tar7operator/Pinaka/10.FEA/Rocket/Thrust Plate/Final Test/fosAngle.png

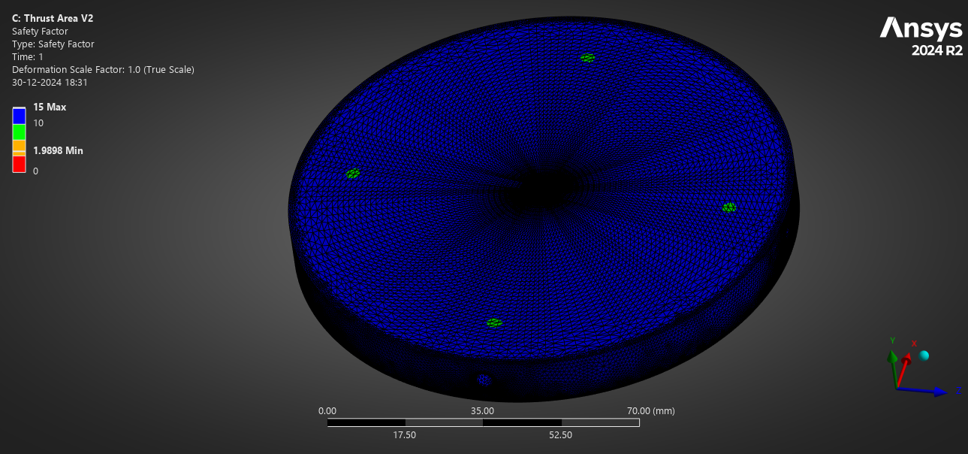
10.FEA/Rocket/Thrust Plate/Final Test/fosAngle.png
