tar7operator/Pinaka/10.FEA/Rocket/Thrust Plate/Final Test/strainHole.png

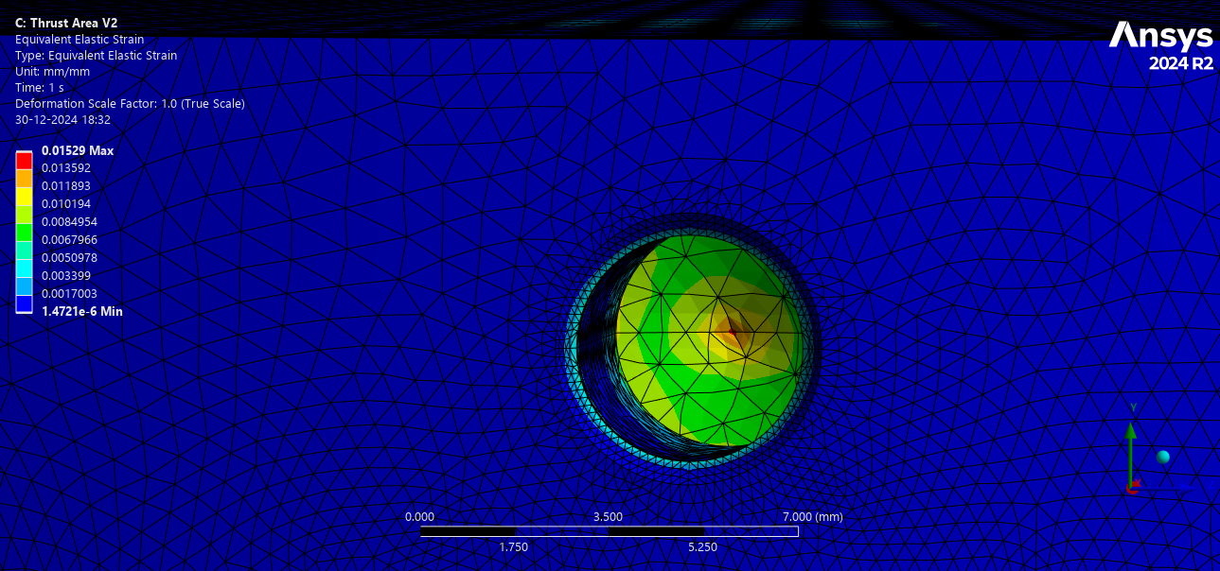
10.FEA/Rocket/Thrust Plate/Final Test/strainHole.png
