tar7operator/Pinaka/9. Records/8. PDR Report/Pinaka PPT.pdf

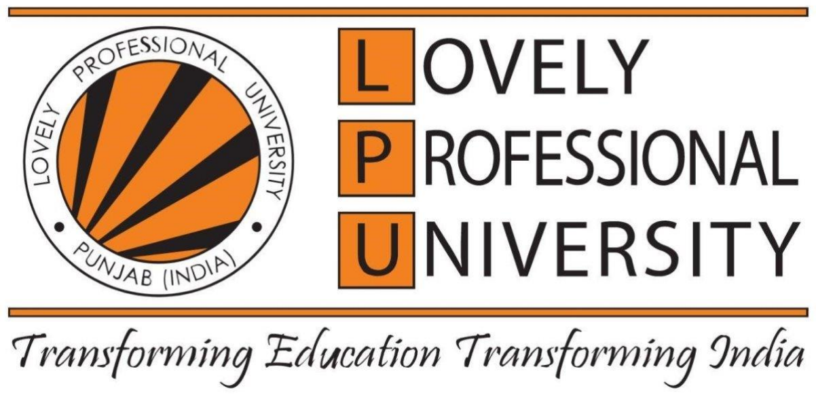
[picture p46: figure]

CANSAT India Students Competition by ASI: {Team Id}

# MODEL ROCKETRY 2024-25

# Team - Pinaka

# 1. Presentation Outline

Sr. No. | Content | Slide Number
1 | Mission summary
2 | Team Structure
3 | Design Overview
5 | Mechanical Subsystems
| Avionics Systems • Sensors Trade Off • Onboard avionics overview • Ground Station Electronics • Power subsystem design
6 | Descent Control
8 | Flight Software Overview
9 | Base Station and GUI

# 1. Mission Summary

# Mission Objectives

- To design a rocket that can deploy the payload at 1000m +/- 100m altitude.
- To design a rocket that is less than 180cm in height.
- To design a rocket with a payload that can carry a CAN-Sized satellite of Diameter 0.15m and length 0.40m, with a weight of 1Kg +/-0.05Kg.
- To design a rocket that can descent and land safely after the payload deployment.

# 2. Team Structure

Name | Discipline | Role | Academic Year
- Mandeep Singh | Assistant Professor and Assistant Dean | Faculty Advisor | -
- Ruhul Amin Choudhury | Innovation Officer | Mentor | -
- Pranav MP | Aerospace Engineering | Aerodynamics | 3 rd Year
- Vijay Mishra | Aerospace Engineering | Design | rd Year 3
- Shalu Yadav | Aerospace Engineering | Aerodynamics | 3 rd Year
- Prajwal Kale | Aerospace Engineering | Motor and Propellant | 3 rd Year
- Ishu Saini | Aerospace Engineering | Motor and Propellant | 3 rd Year
- Bhanu Mahesh | Robotics Engineering | Avionics and Electronics | 4 rd Year
- V Manish | Robotics Engineering | Avionics and Electronics | 4 rd Year
- Nandish Panchal | Mechanical Engineering | Manufacturing | rd Year 3

# 3. Design Overview

# Design specifications :

## - Power Series Nosecone

## - Hinge system payload compartment

## - Transition tube

## - 3 Bulkheads

## - 3 Centering Rings

## - Free form 4 fin design

# 4.(a) Payload Bay

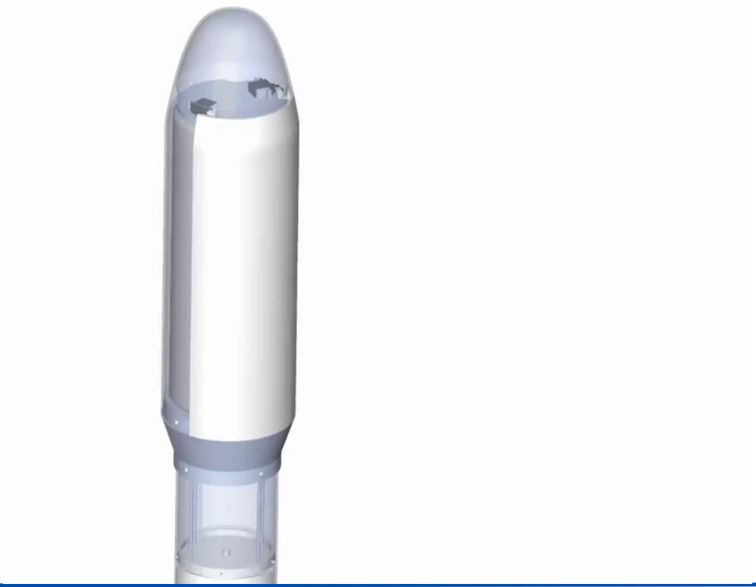
[picture p47: figure]

# Design specifications :

## - Power Series Nosecone

## - Hinge system payload compartment

## - Transition tube

## - 3 Bulkheads

## - 3 Centering Rings

## - Free form 4 fin design

# 4.(a) Parachute Bay

# Design specifications:

## - Power Series Nosecone

## - Hinge system payload compartment

## - Transition tube

## - 3 Bulkheads

## - 3 Centering Rings

## - Free form 4 fin design
