tar7operator/Pinaka/9. Records/8. PDR Report/InSpace Rocketry Equipments List.pdf

Sr No. | Name | Specification | Capacity/ Amount/Services
1 | Test Stand | | 1 nos
2 | Hot Plate | | 1 nos
3 | Propellants Mixer | | 2 nos
4 | Container | Beaker (Glass) | 2 x 1000 ml
5 | | Conical Flask | Max Size available
6 | Safety Equipments | Impervious Gloves | 4 pairs
7 | | Apron | 4 nos
8 | | Safety Goggles | 4 nos
9 | | Masks (filter) | 6 nos
10 | Machining | Lathe Machine
11 | Machining | Milling Machine
12 | 3d Printing

### Equipments List
