tar7operator/Pinaka/7. Standards and Handbooks/Rocketry Standards/ECSS/ECSS-Handbooks_(zip-file_October2023)/Astrium-Example-Joint Design.xls

Sheet: Test Sample
Verification steps in the analysis of bonded joints:
1. Recalculate stress distribution of the test sample (see example below); normally same adhesive tested at RT
2. Determine peak stress at the edge of the sample
3. Calculate stress distribution in the new joint
4. Demonstrate positive margin of safety |  |  | MoS=(Smaxsample/(Smaxjoint*Jult))-1 |  |  |  | Safety factor Jult=1.5 to 2.0
5. Note: test sample needs to be similar or stiffer than the new joint (Kt,mech less-equal than in new joint)
6. Verification of bonded joints under extreme temperatures (outside qualification temperatures of adhesive) needs testing at these temperatures
7. Warning: in case of CFRP the out-of-plane skin strength (similar to 90° strength of UD) can be very and thus failure of the bonding occurs in the first layer due to out-of-plane stresses in the order of the max. shear stresses in the bonding !!!!
Liner-elastic Analysis of Standard Joint under Test Loads; EA9321 acc.to ASTM D 1002
 | E-modulus | thickness | CTE | G-modulus |  | E*T | Ce | R | lambda | Fth | Fth0
Adherend 1 | 70000 | 1.6 | 0 |  |  | 112000 | 56000 | 0.1901785714 | 0.4360946817 | 0 | 8.004301941
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
