tar7operator/Pinaka/9. Records/CDR-Payment-2024-ASI-MODEL-ROCKETRY-047.pdf

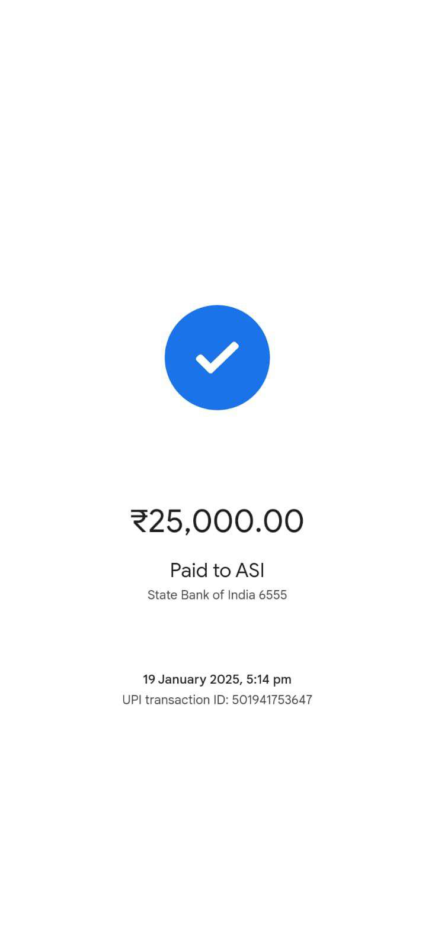
[picture p48: page 1]
