tar7operator/Pinaka/1. CAD PDR -- Do not Edit!/Accesories/mg90s-servo-motor-2.snapshot.6/MG90S Servo Motor.bmp

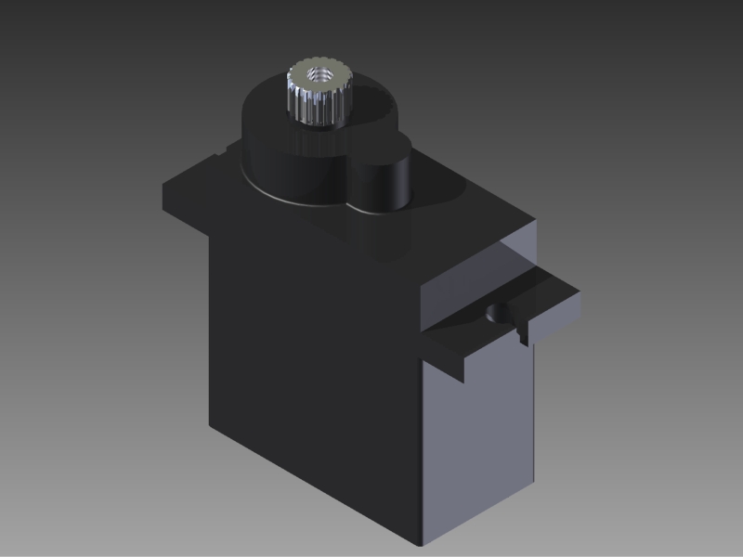
1. CAD PDR -- Do not Edit!/Accesories/mg90s-servo-motor-2.snapshot.6/MG90S Servo Motor.bmp
