tar7operator/Pinaka/1. CAD PDR -- Do not Edit!/Accesories/mg90s-servo-motor-2.snapshot.6/Quadcopter Servo3.jpg

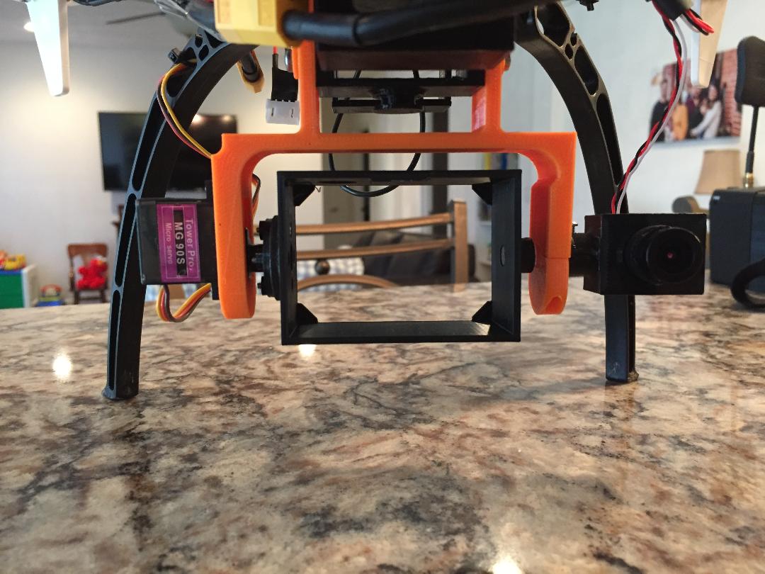
1. CAD PDR -- Do not Edit!/Accesories/mg90s-servo-motor-2.snapshot.6/Quadcopter Servo3.jpg
