tar7operator/Pinaka/1. CAD PDR -- Do not Edit!/Accesories/mg90s-servo-motor-2.snapshot.6/Spline Shaft1.JPG

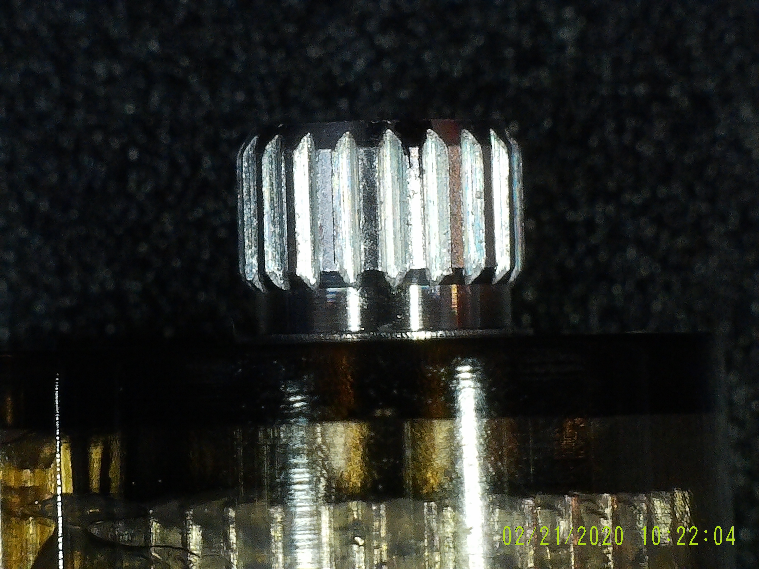
1. CAD PDR -- Do not Edit!/Accesories/mg90s-servo-motor-2.snapshot.6/Spline Shaft1.JPG
