tar7operator/Pinaka/1. CAD PDR -- Do not Edit!/Images/Cansat.png

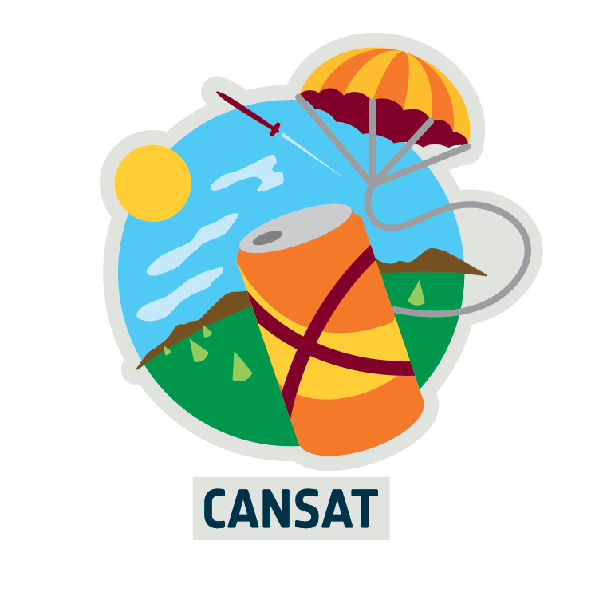
1. CAD PDR -- Do not Edit!/Images/Cansat.png
