tar7operator/Pinaka/3. Motor/Aerotech/Aerotech H148 motor.JPG

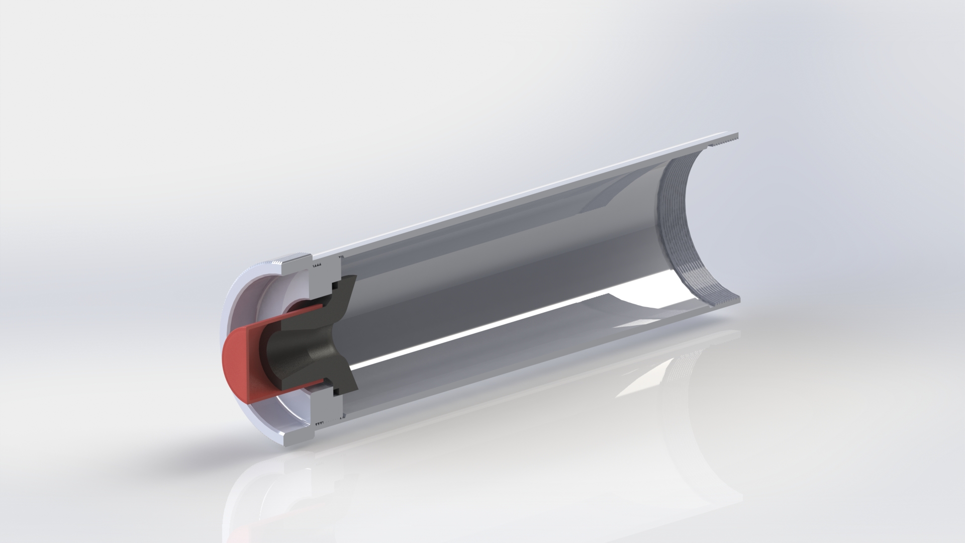
3. Motor/Aerotech/Aerotech H148 motor.JPG
