tar7operator/Pinaka/5. Launch Stand/launch stand.PNG

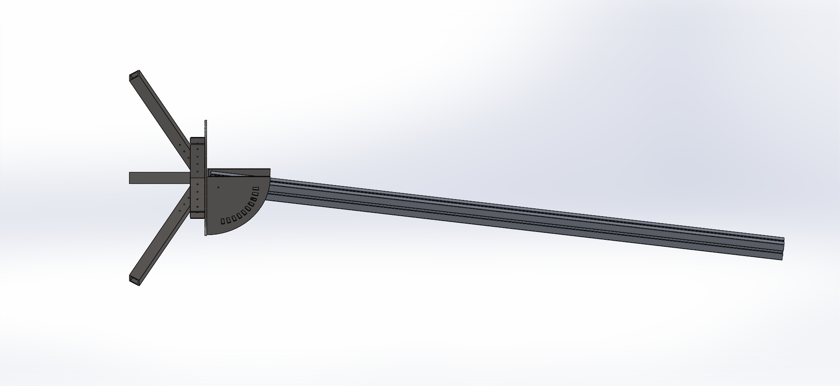
5. Launch Stand/launch stand.PNG
