tar7operator/Pinaka/7. Standards and Handbooks/Rocketry Standards/ECSS/Disciplines of ECSS standards.png

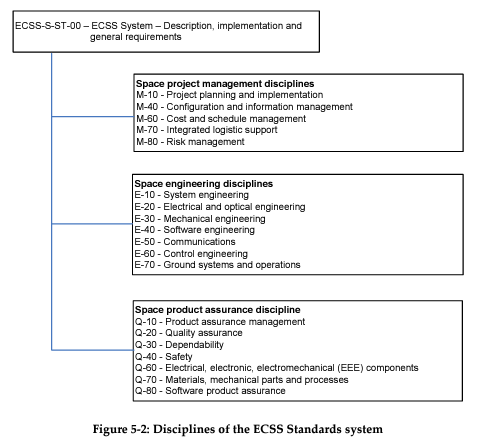
7. Standards and Handbooks/Rocketry Standards/ECSS/Disciplines of ECSS standards.png
