tar7operator/Pinaka/9. Records/8. PDR Report/Pinaka.png

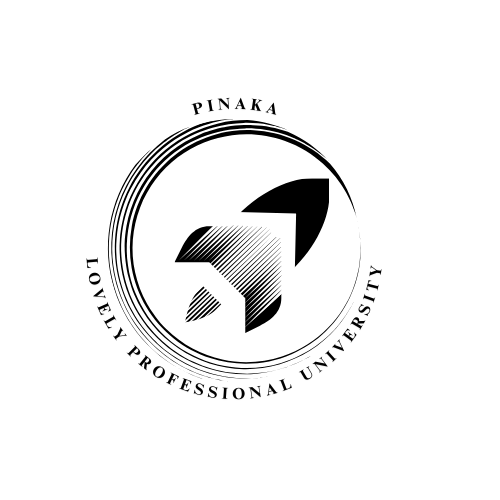
9. Records/8. PDR Report/Pinaka.png
