tar7operator/Pinaka/9. Records/20. CDR/Images/Cross Section.PNG

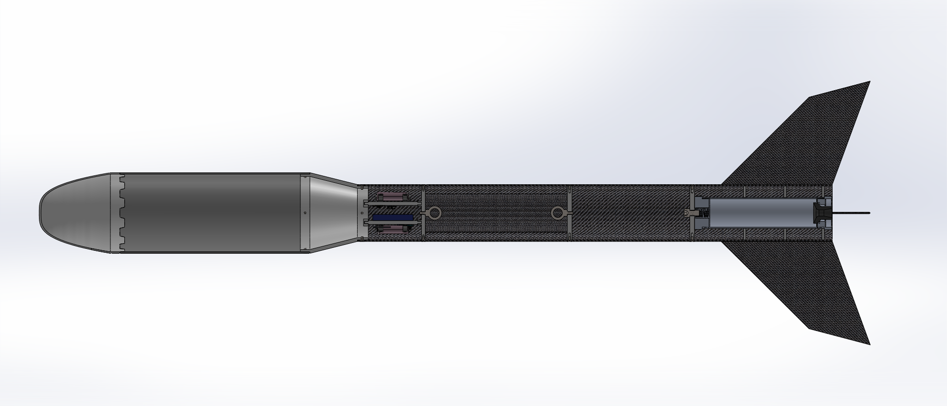
9. Records/20. CDR/Images/Cross Section.PNG
