tar7operator/Pinaka/9. Records/20. CDR/Images/GA_trans.PNG

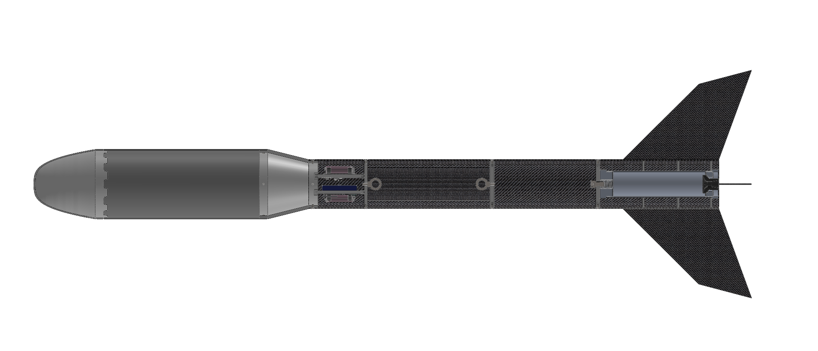
9. Records/20. CDR/Images/GA_trans.PNG
