tar7operator/Pinaka/10.FEA/Cansat/16g acceleration static/CansatMesh.JPG

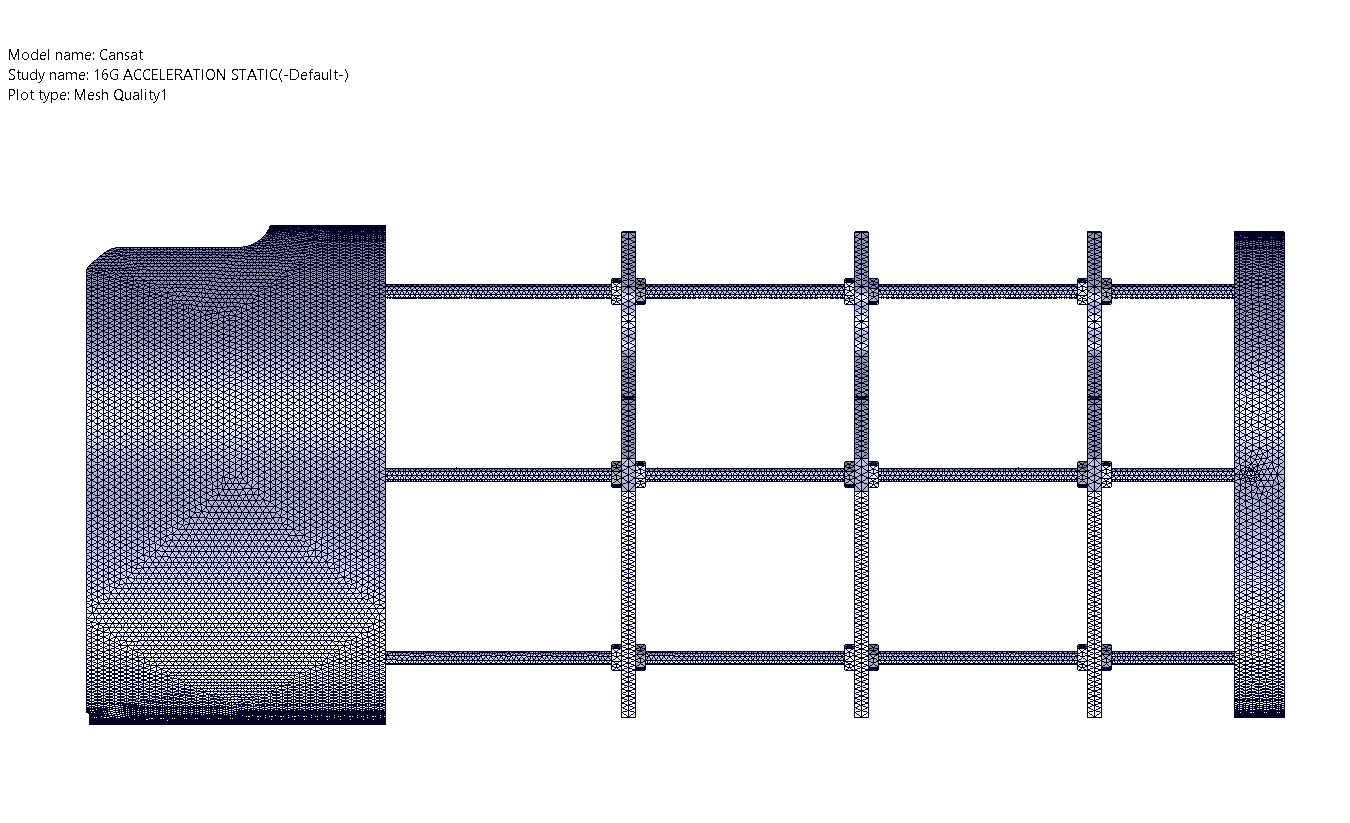
10.FEA/Cansat/16g acceleration static/CansatMesh.JPG
