tar7operator/Pinaka/10.FEA/Cansat/16g acceleration static/front view/Cansat-16G ACCELERATION STATIC-Displacement-Displacement1.jpg

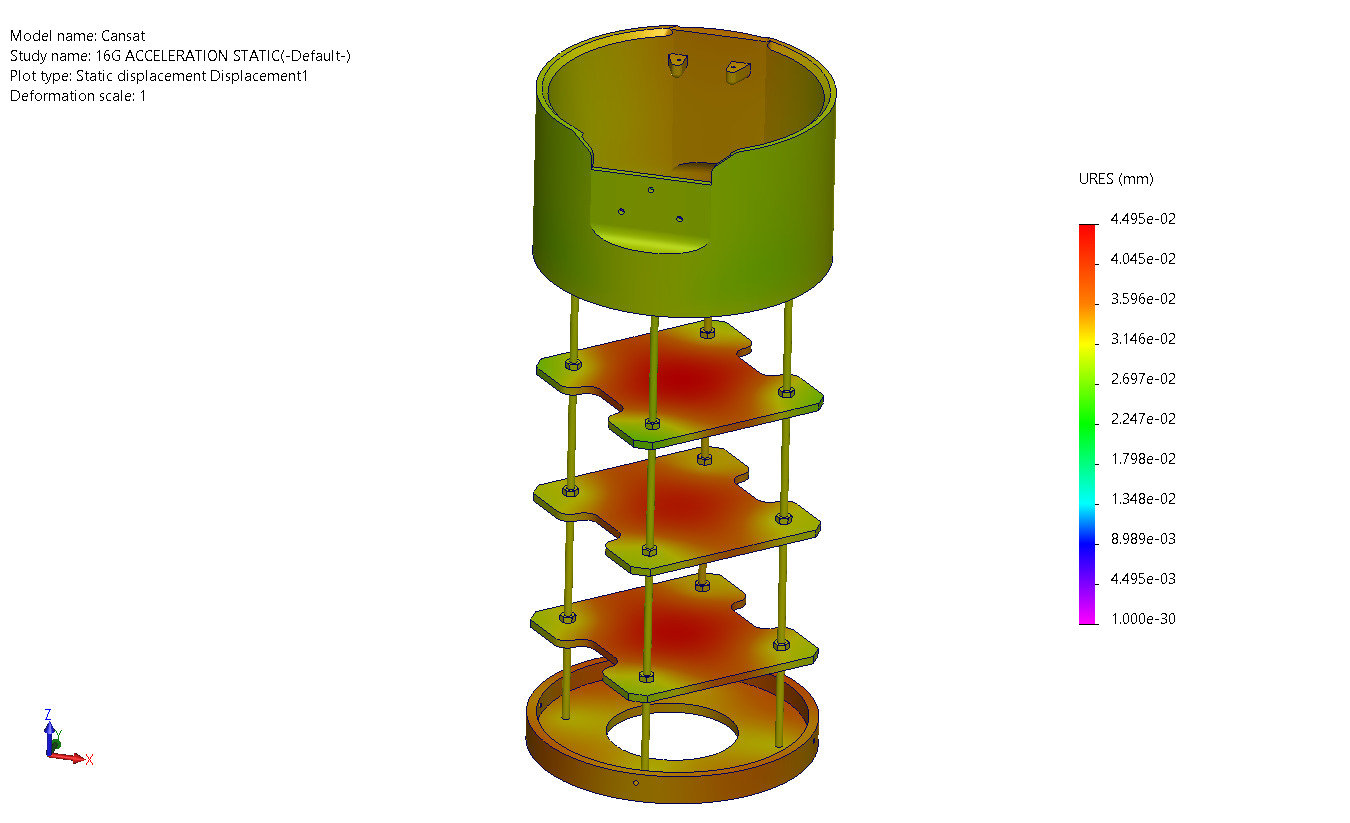
10.FEA/Cansat/16g acceleration static/front view/Cansat-16G ACCELERATION STATIC-Displacement-Displacement1.jpg
