tar7operator/Pinaka/10.FEA/Cansat/16g acceleration static/top/Cansat-16G ACCELERATION STATIC-Stress-Stress1.jpg

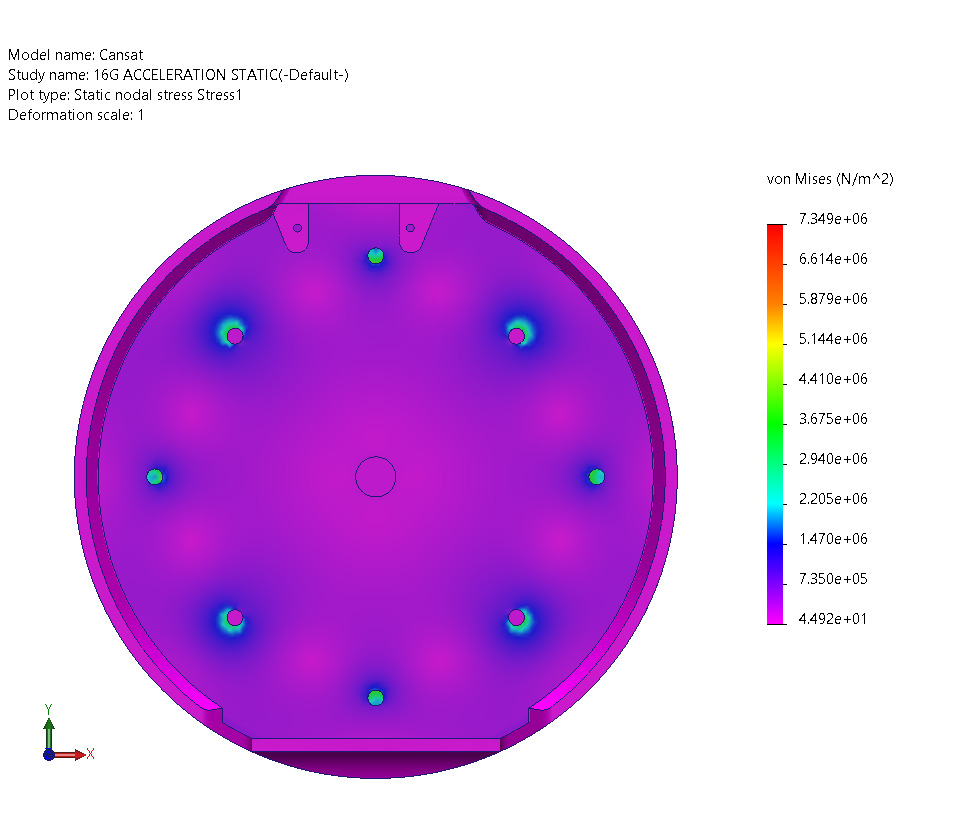
10.FEA/Cansat/16g acceleration static/top/Cansat-16G ACCELERATION STATIC-Stress-Stress1.jpg
