tar7operator/Pinaka/10.FEA/Cansat/Flap 12.5 N force by Drag/ParachuteCap-Flap Stress by Drogue-Displacement-Displacement1.jpg

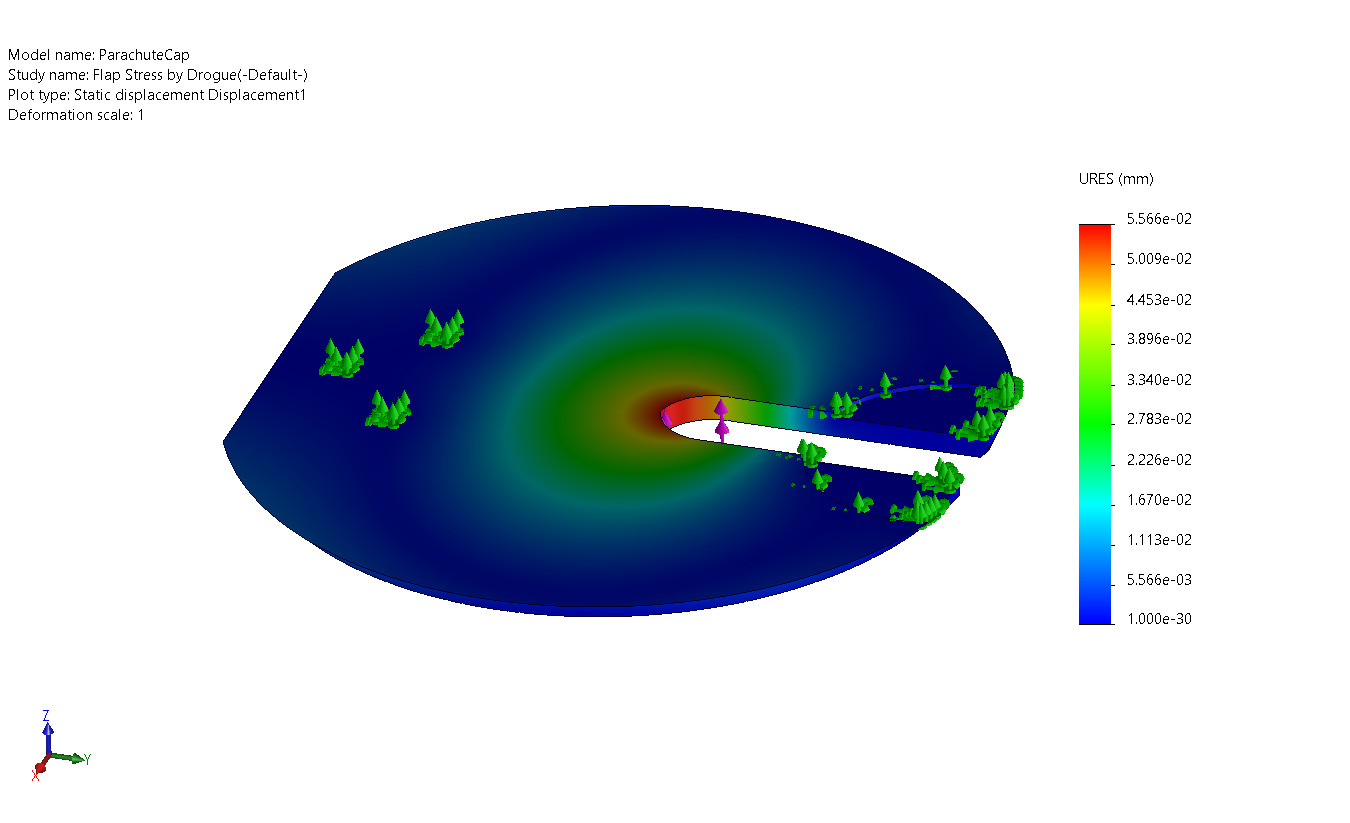
10.FEA/Cansat/Flap 12.5 N force by Drag/ParachuteCap-Flap Stress by Drogue-Displacement-Displacement1.jpg
