tar7operator/Pinaka/10.FEA/Cansat/Flap 12.5 N force by Drag/ParachuteCap-Flap Stress by Drogue-Factor of Safety-Factor of Safety1.jpg

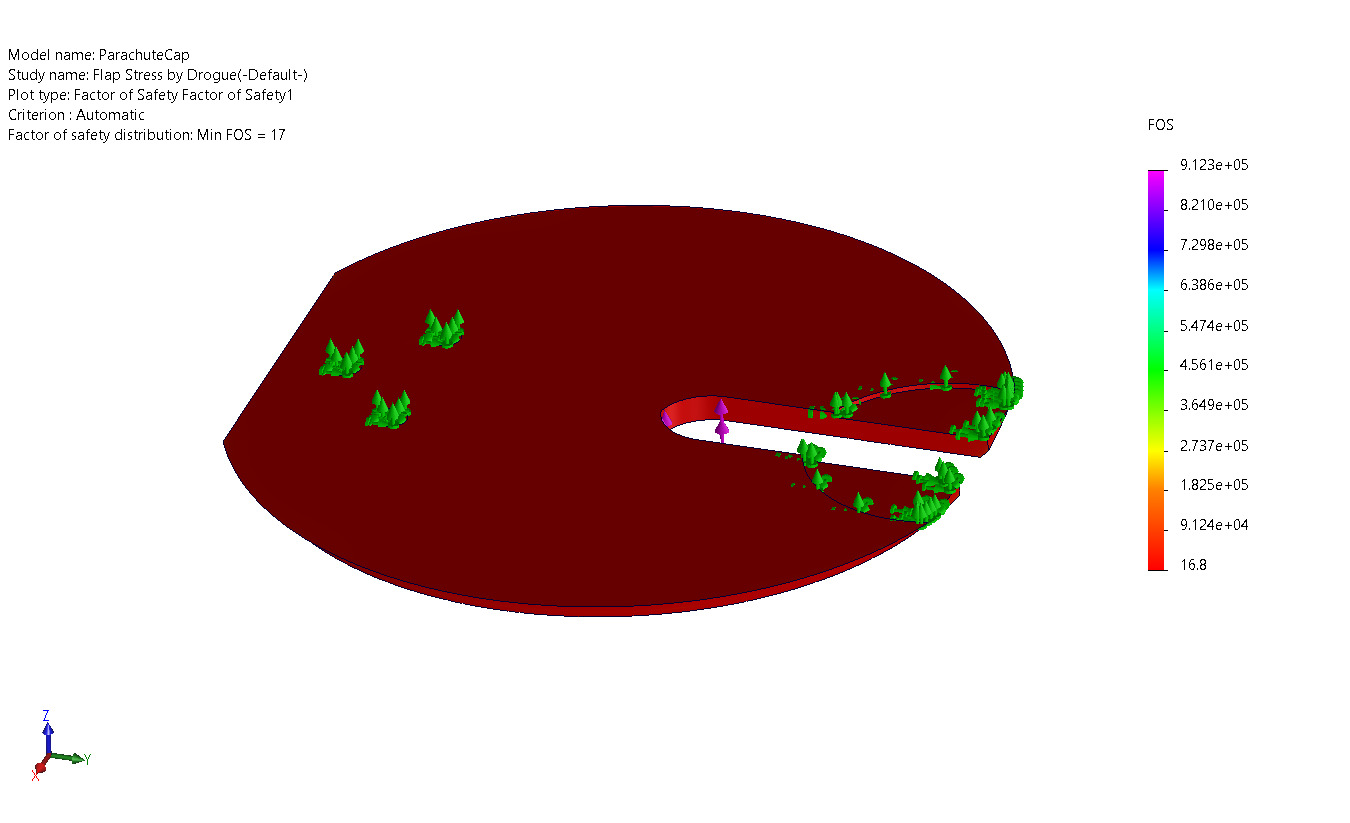
10.FEA/Cansat/Flap 12.5 N force by Drag/ParachuteCap-Flap Stress by Drogue-Factor of Safety-Factor of Safety1.jpg
