tar7operator/Pinaka/10.FEA/Cansat/Flap 12.5 N force by Drag/ParachuteCap-Flap Stress by Drogue-Image-1.png

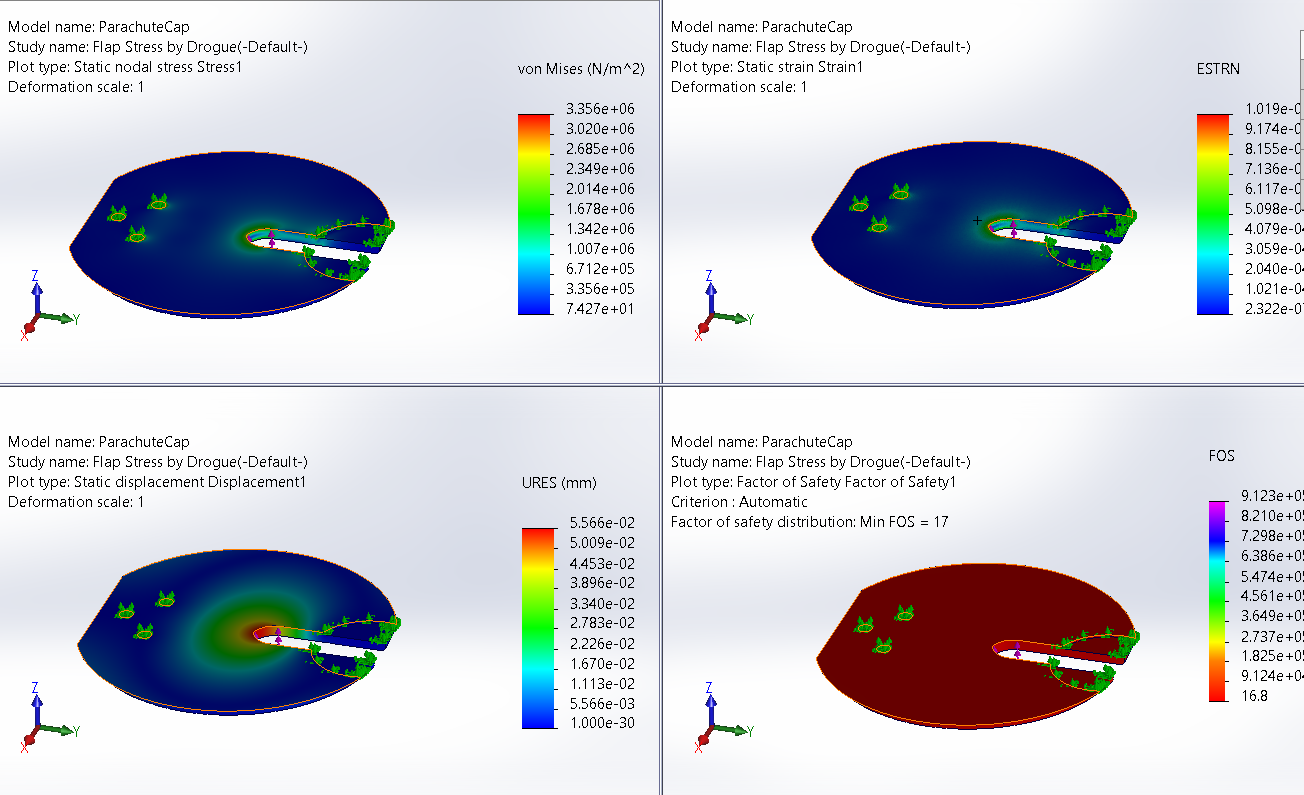
10.FEA/Cansat/Flap 12.5 N force by Drag/ParachuteCap-Flap Stress by Drogue-Image-1.png
