tar7operator/Pinaka/10.FEA/Rocket/BodyCover/Full Force/force.png

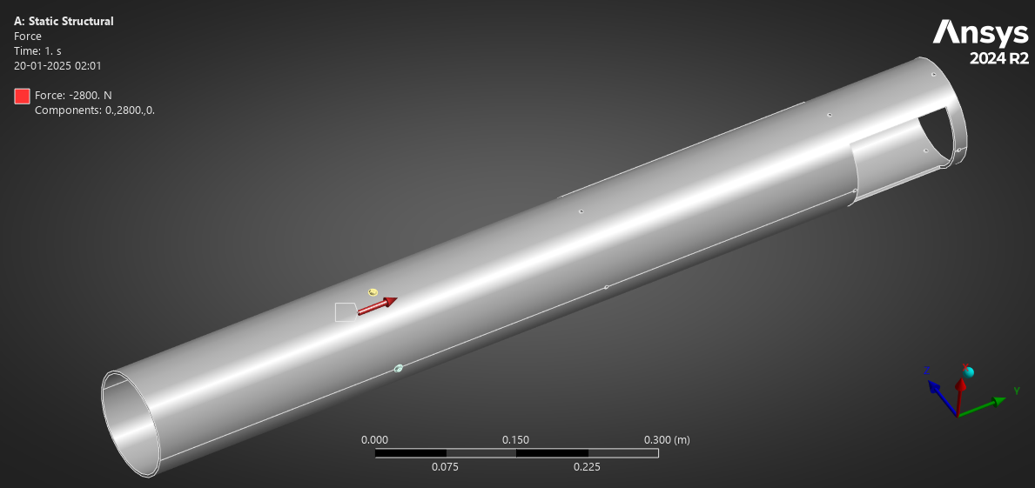
10.FEA/Rocket/BodyCover/Full Force/force.png
