tar7operator/Pinaka/10.FEA/Rocket/BodyCover/Full Force/fs.png

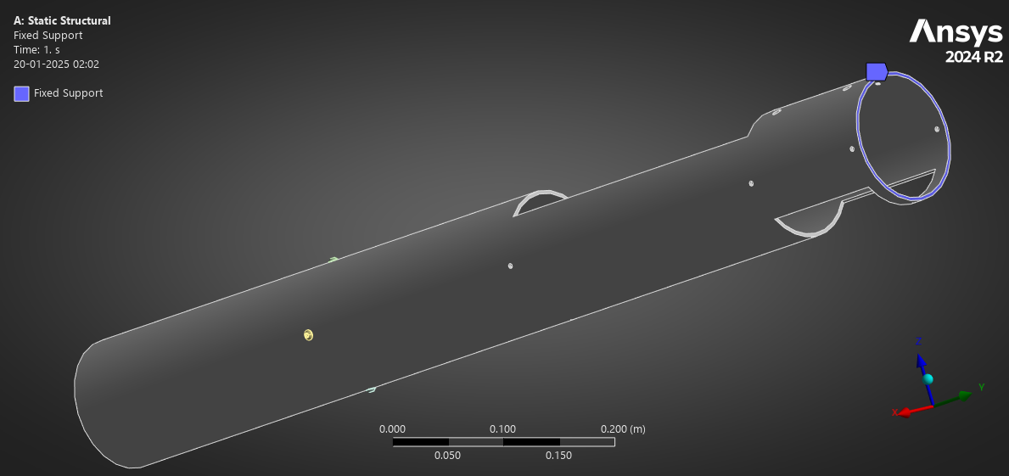
10.FEA/Rocket/BodyCover/Full Force/fs.png
