tar7operator/Pinaka/10.FEA/Rocket/BodyCover/Full Force/mesh.png

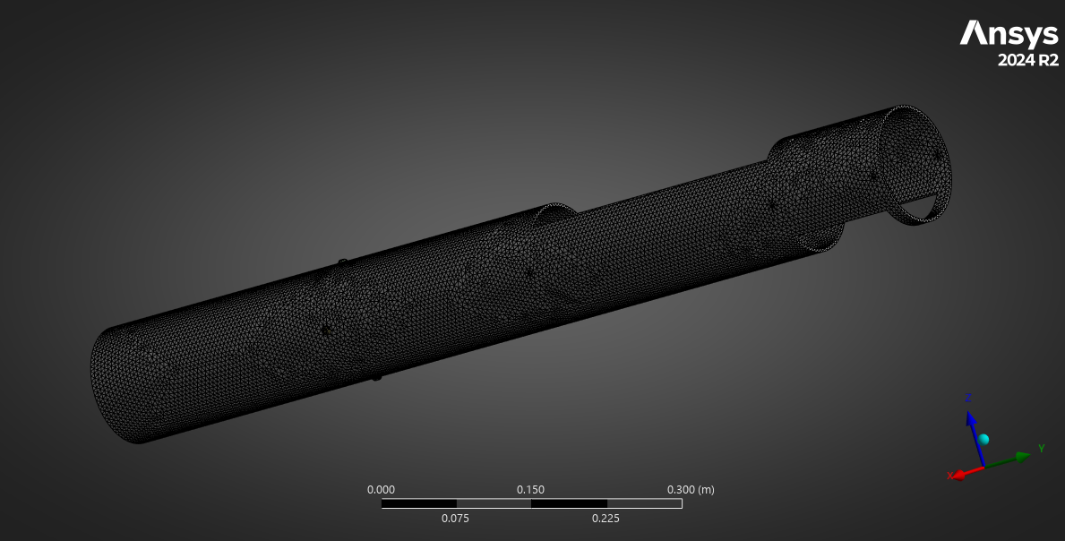
10.FEA/Rocket/BodyCover/Full Force/mesh.png
