tar7operator/Pinaka/10.FEA/Rocket/BodyCover/Full Force/strain.png

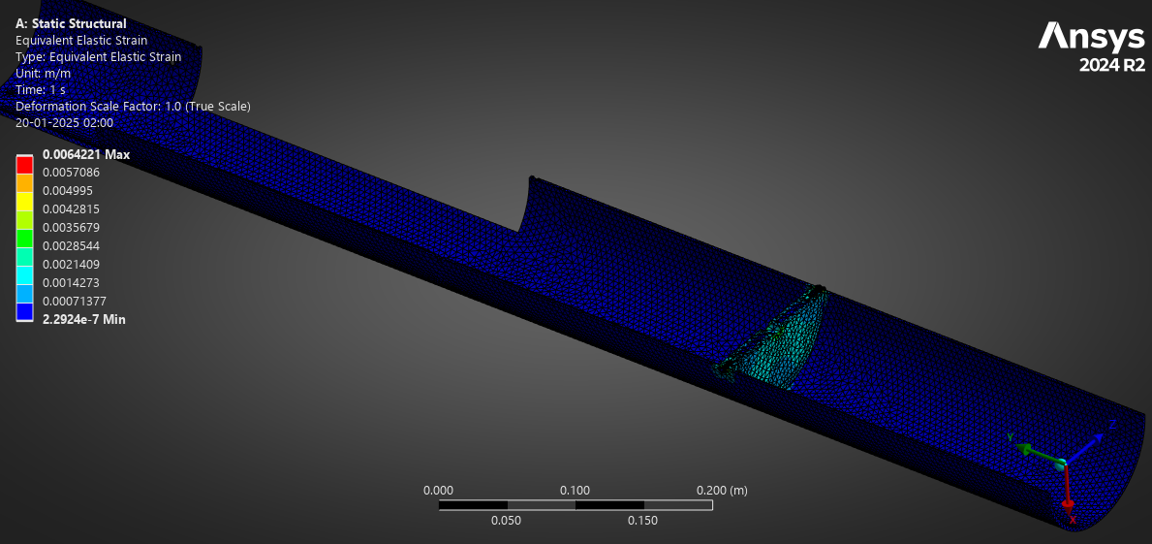
10.FEA/Rocket/BodyCover/Full Force/strain.png
