tar7operator/Pinaka/10.FEA/Rocket/BodyCover/Full Force/stress.png

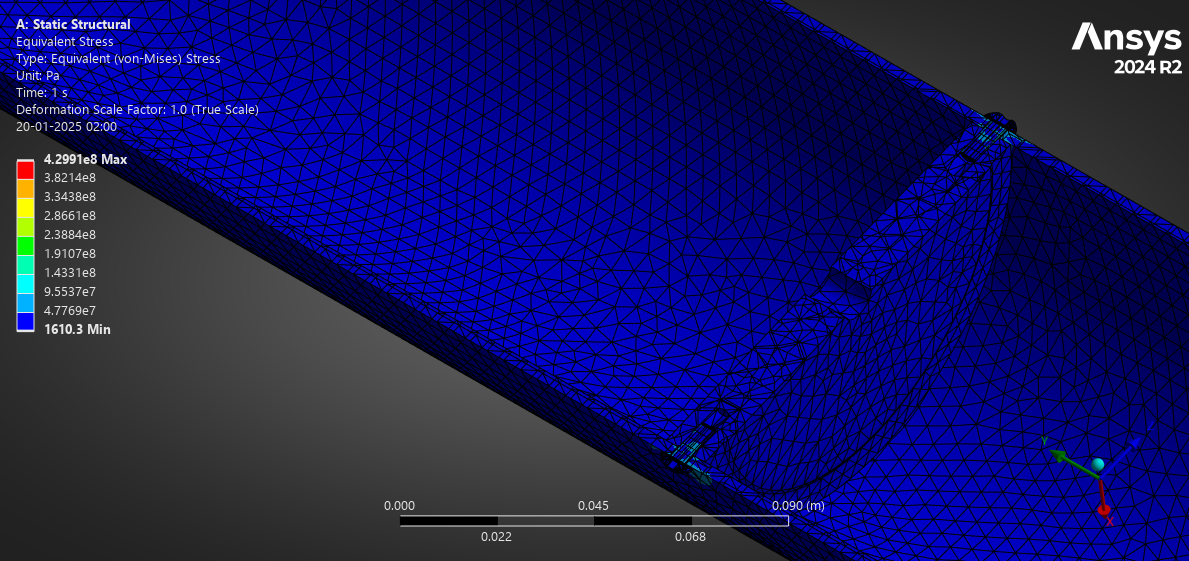
10.FEA/Rocket/BodyCover/Full Force/stress.png
