tar7operator/Pinaka/10.FEA/Rocket/BodyCover/Full Force/td.png

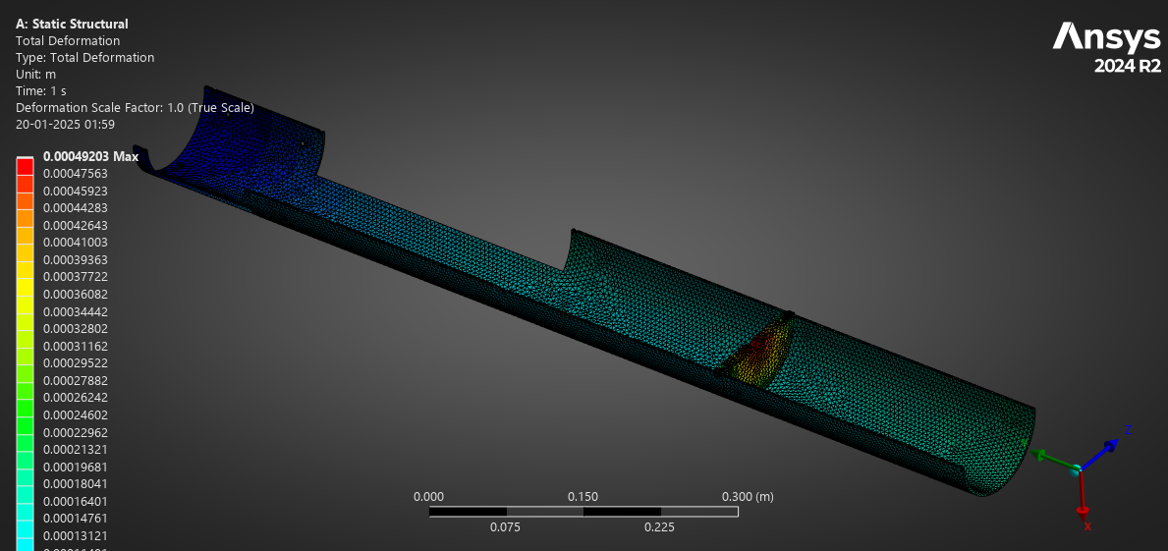
10.FEA/Rocket/BodyCover/Full Force/td.png
