tar7operator/Pinaka/10.FEA/Rocket/Nose Cone/16g/1.png

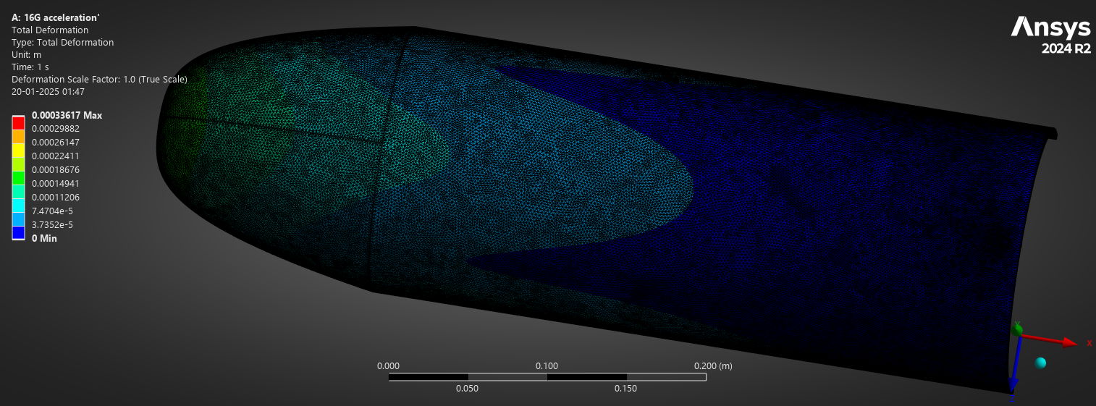
10.FEA/Rocket/Nose Cone/16g/1.png
