tar7operator/Pinaka/10.FEA/Rocket/Nose Cone/Final/1.png

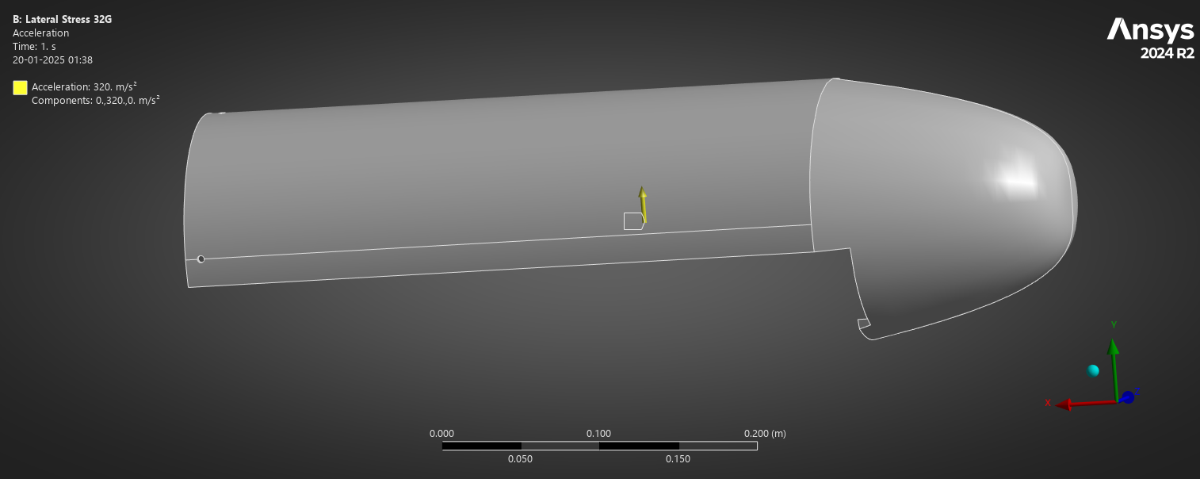
10.FEA/Rocket/Nose Cone/Final/1.png
