tar7operator/Pinaka/10.FEA/Rocket/Nose Cone/Final/5.png

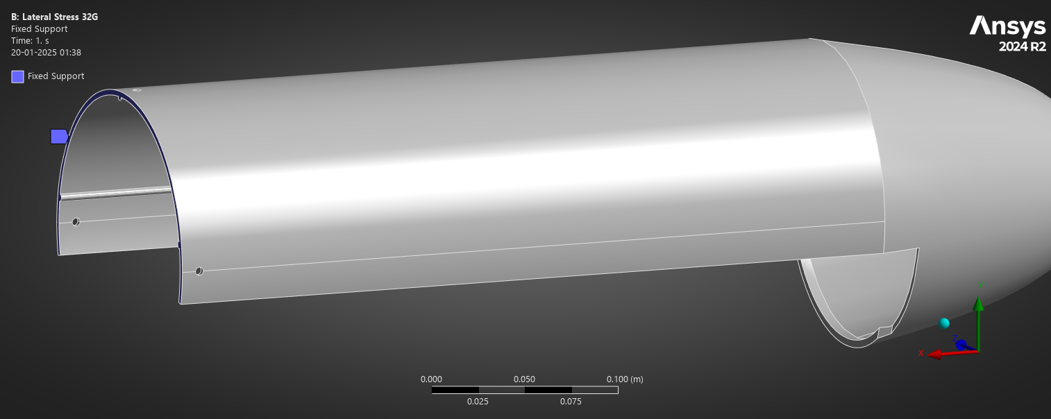
10.FEA/Rocket/Nose Cone/Final/5.png
