tar7operator/Pinaka/10.FEA/Rocket/Nose Cone/Final/6.png

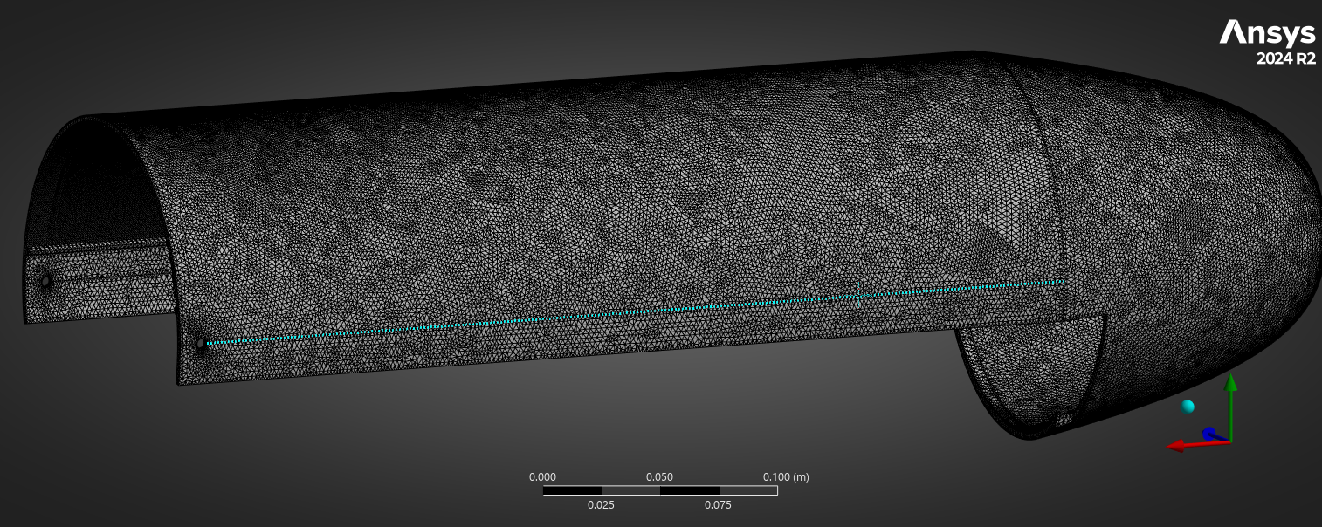
10.FEA/Rocket/Nose Cone/Final/6.png
