tar7operator/Pinaka/10.FEA/Rocket/Nose Cone/Final/tdSide.png

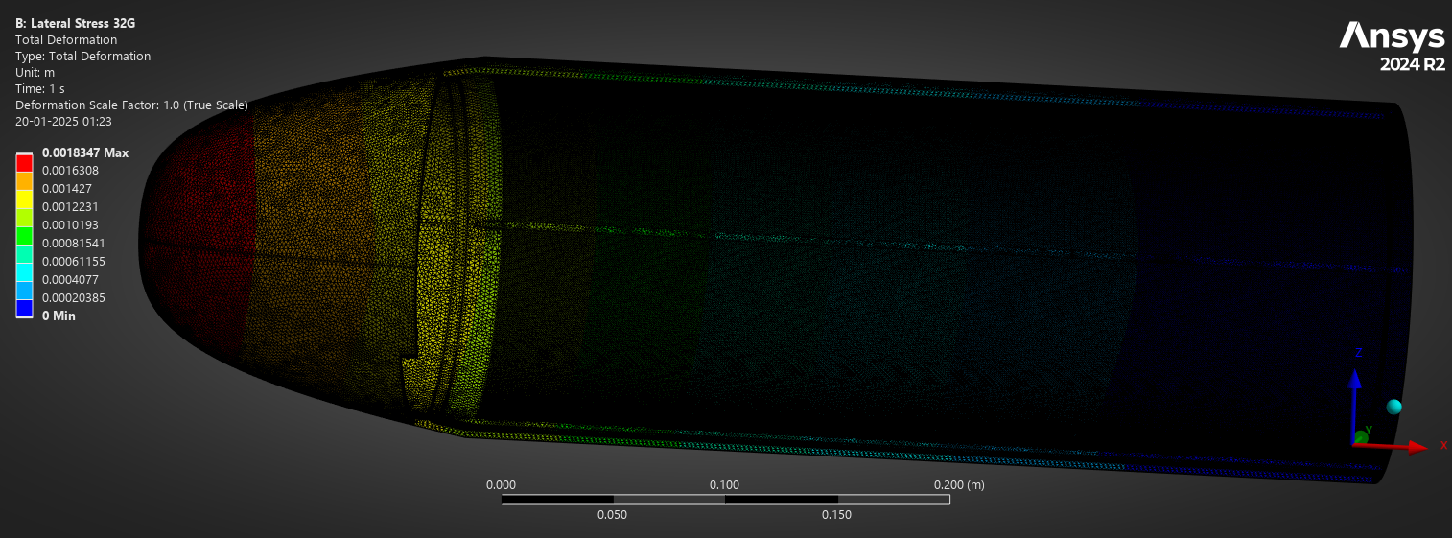
10.FEA/Rocket/Nose Cone/Final/tdSide.png
