tar7operator/Pinaka/10.FEA/Rocket/Parachute Plate/M6 2mm Groove 16G/td.png

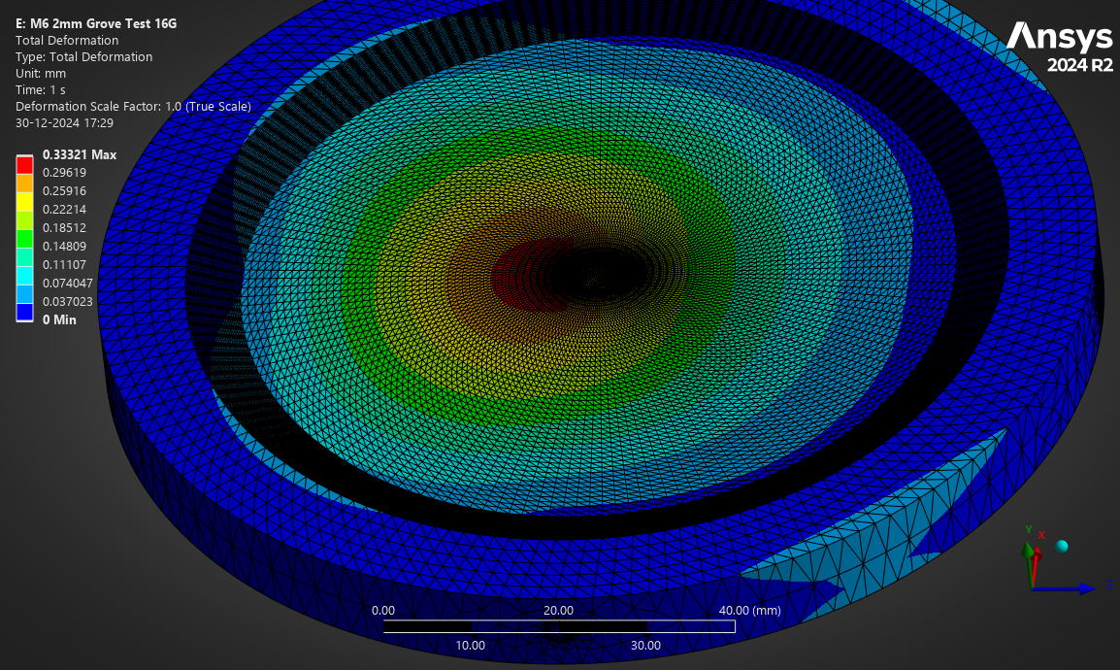
10.FEA/Rocket/Parachute Plate/M6 2mm Groove 16G/td.png
