tar7operator/Pinaka/10.FEA/Rocket/Thrust Plate/Added ThrustPad/fosbottom.png

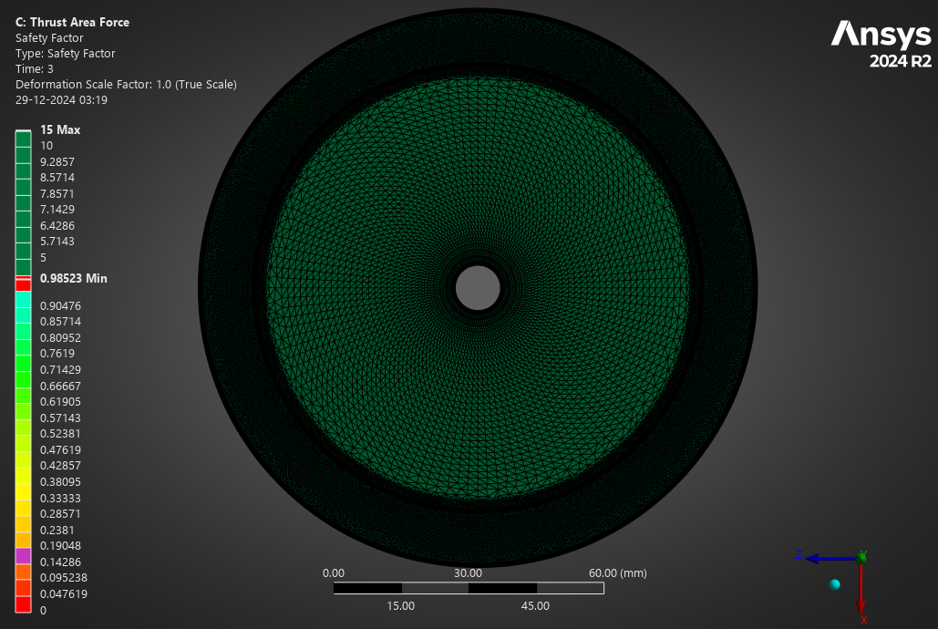
10.FEA/Rocket/Thrust Plate/Added ThrustPad/fosbottom.png
