tar7operator/Pinaka/10.FEA/Rocket/Thrust Plate/Added ThrustPad/fosCrossSectionNut2.png

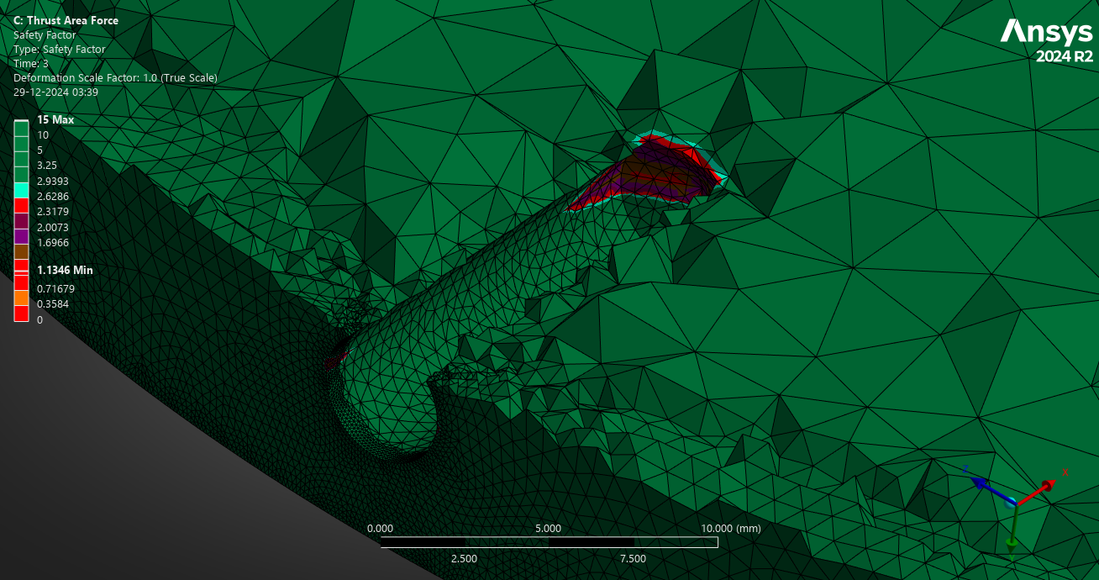
10.FEA/Rocket/Thrust Plate/Added ThrustPad/fosCrossSectionNut2.png
