tar7operator/Pinaka/10.FEA/Rocket/Thrust Plate/Added ThrustPad/fosTop.png

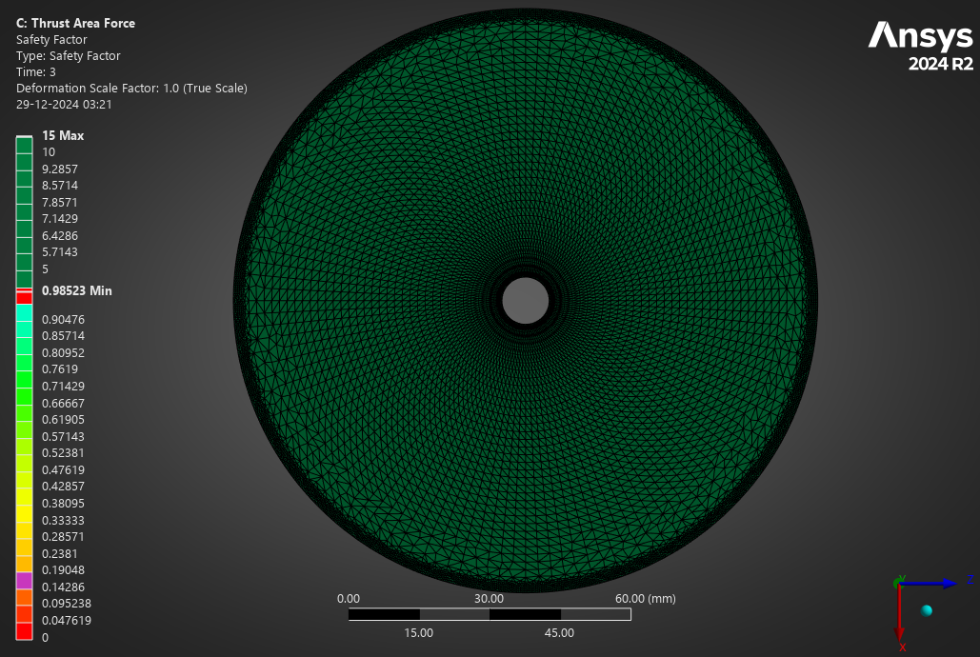
10.FEA/Rocket/Thrust Plate/Added ThrustPad/fosTop.png
