tar7operator/Pinaka/10.FEA/Rocket/Thrust Plate/Added ThrustPad/strainbottom.png

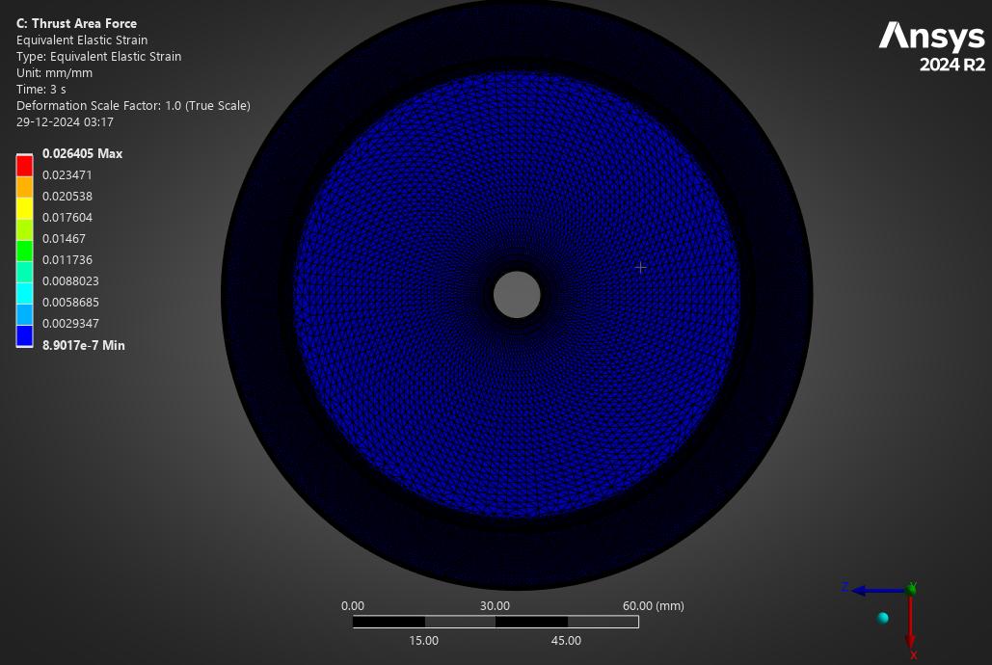
10.FEA/Rocket/Thrust Plate/Added ThrustPad/strainbottom.png
