tar7operator/Pinaka/10.FEA/Rocket/Thrust Plate/Added ThrustPad/strainSide.png

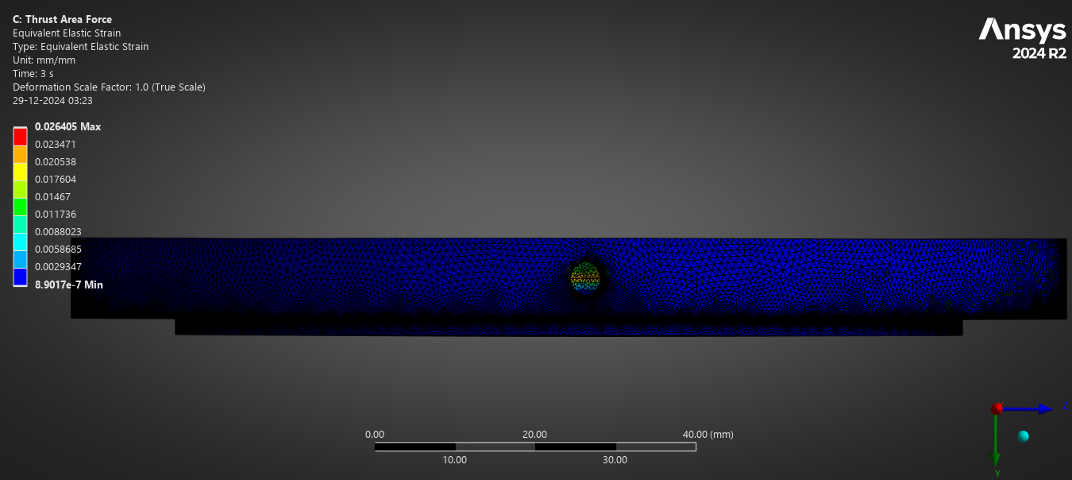
10.FEA/Rocket/Thrust Plate/Added ThrustPad/strainSide.png
