tar7operator/Pinaka/10.FEA/Rocket/Thrust Plate/Added ThrustPad/strainTop.png

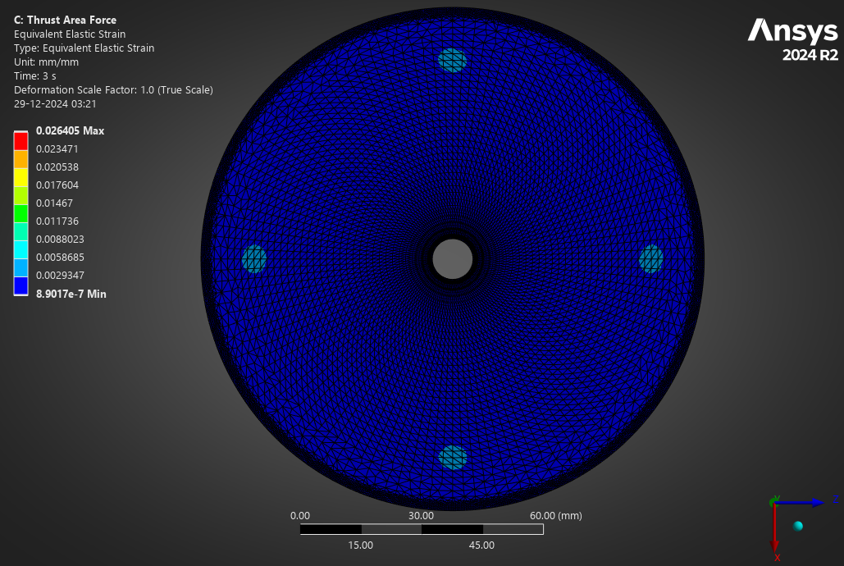
10.FEA/Rocket/Thrust Plate/Added ThrustPad/strainTop.png
