tar7operator/Pinaka/10.FEA/Rocket/Thrust Plate/Added ThrustPad/stressbottom.png

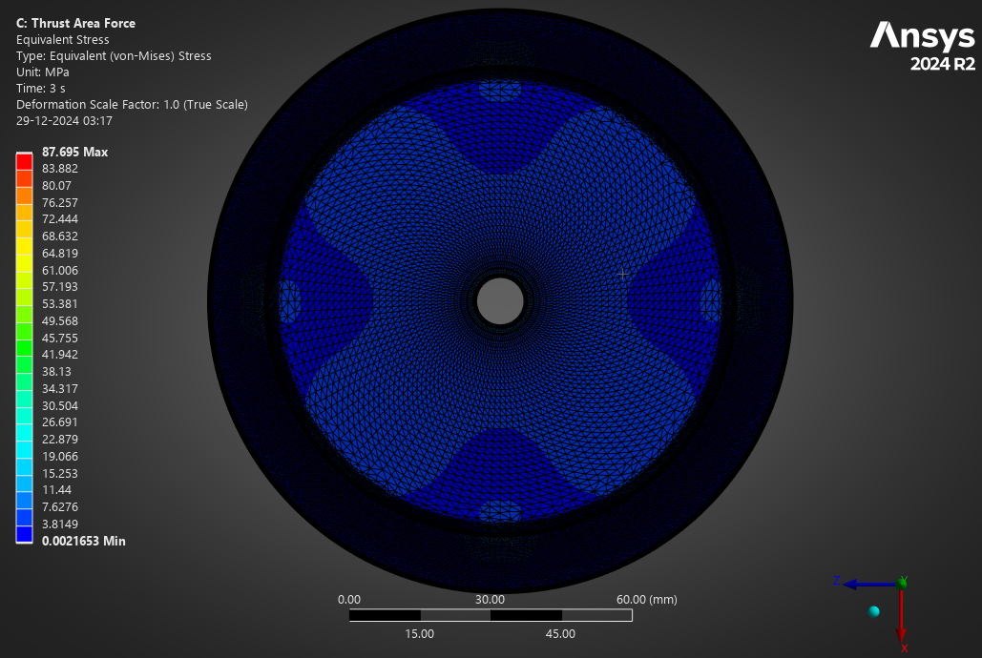
10.FEA/Rocket/Thrust Plate/Added ThrustPad/stressbottom.png
