tar7operator/Pinaka/10.FEA/Rocket/Thrust Plate/Added ThrustPad/stressSide.png

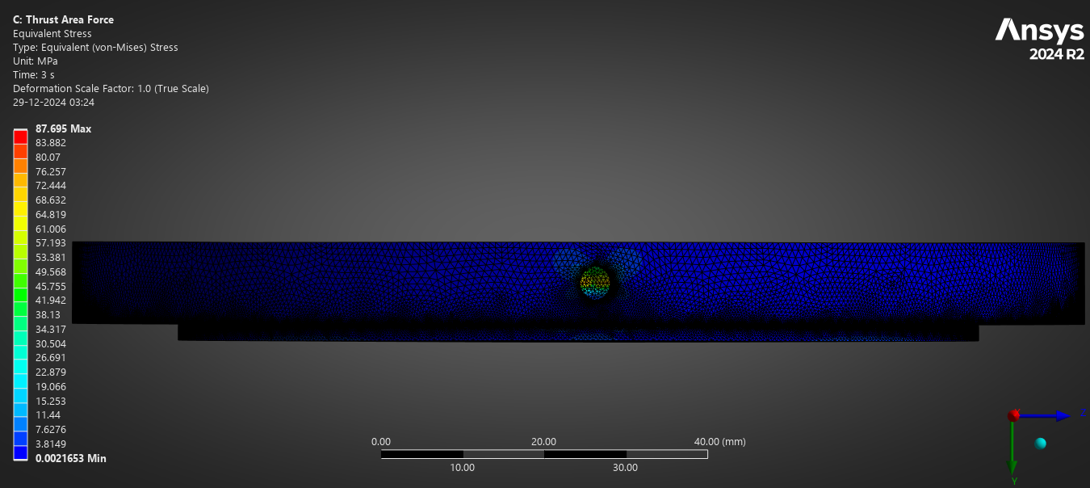
10.FEA/Rocket/Thrust Plate/Added ThrustPad/stressSide.png
