tar7operator/Pinaka/10.FEA/Rocket/Thrust Plate/Added ThrustPad/stressTop.png

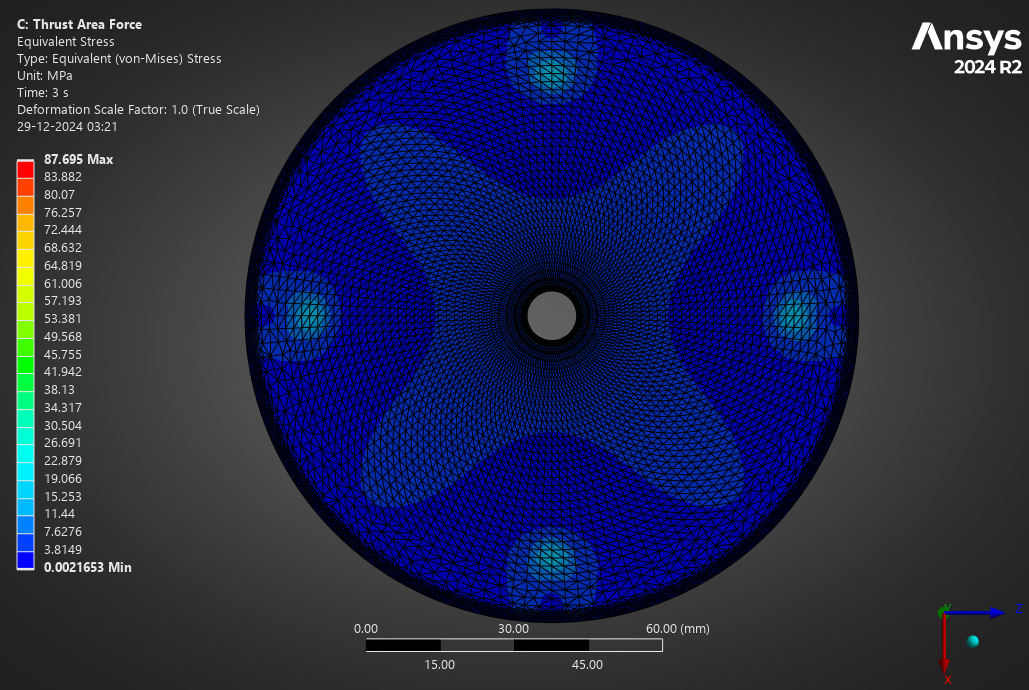
10.FEA/Rocket/Thrust Plate/Added ThrustPad/stressTop.png
