tar7operator/Pinaka/10.FEA/Rocket/Thrust Plate/Added ThrustPad/tdAngle.png

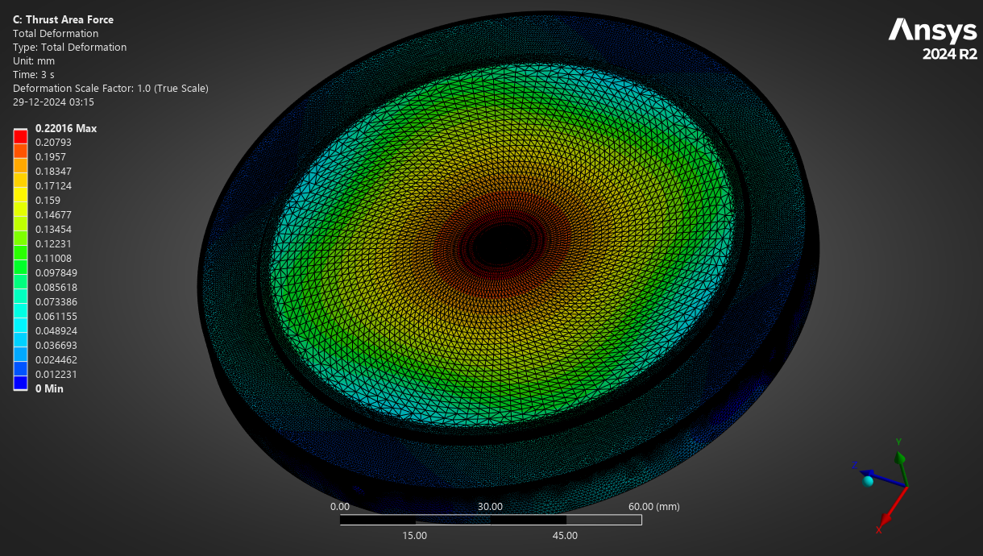
10.FEA/Rocket/Thrust Plate/Added ThrustPad/tdAngle.png
