tar7operator/Pinaka/10.FEA/Rocket/Thrust Plate/Added ThrustPad/tdbottom.png

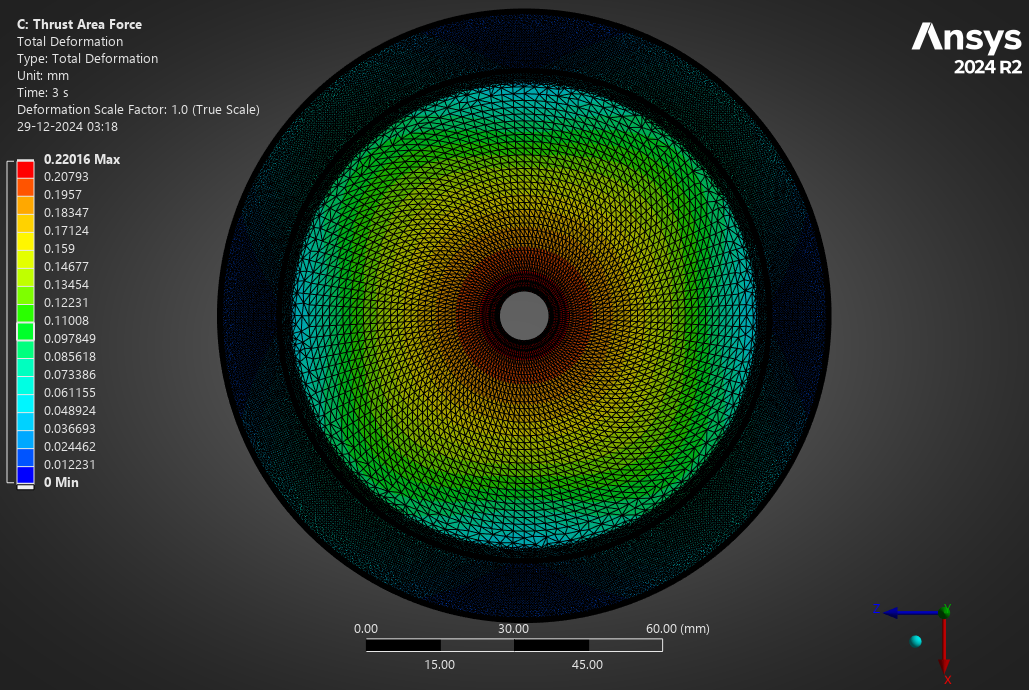
10.FEA/Rocket/Thrust Plate/Added ThrustPad/tdbottom.png
