tar7operator/Pinaka/10.FEA/Rocket/Thrust Plate/Added ThrustPad/tdSide.png

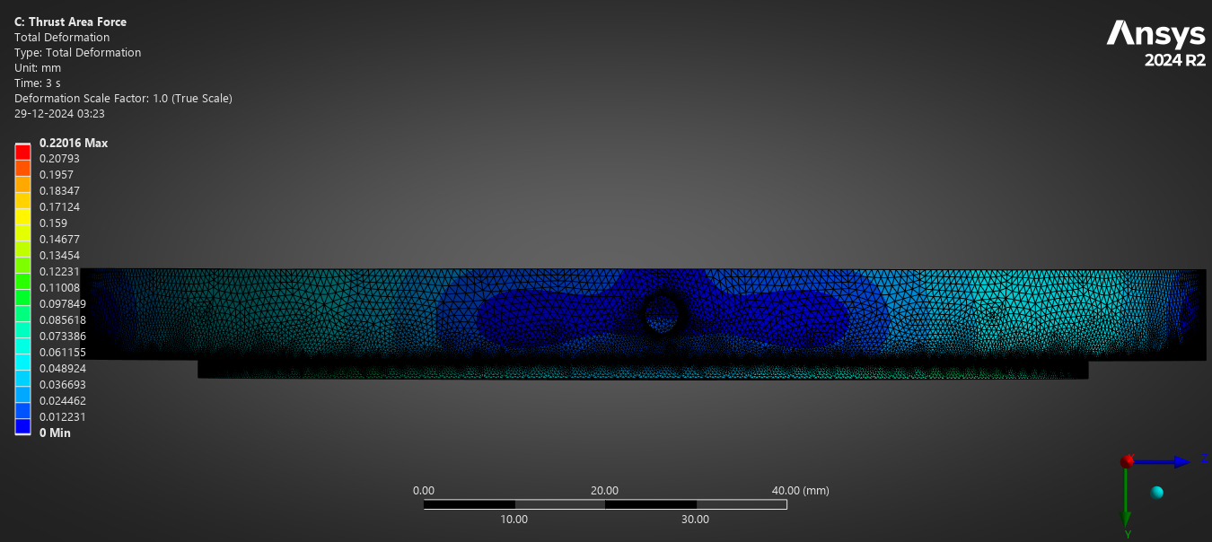
10.FEA/Rocket/Thrust Plate/Added ThrustPad/tdSide.png
