tar7operator/Pinaka/10.FEA/Rocket/Thrust Plate/Added ThrustPad/tdTop.png

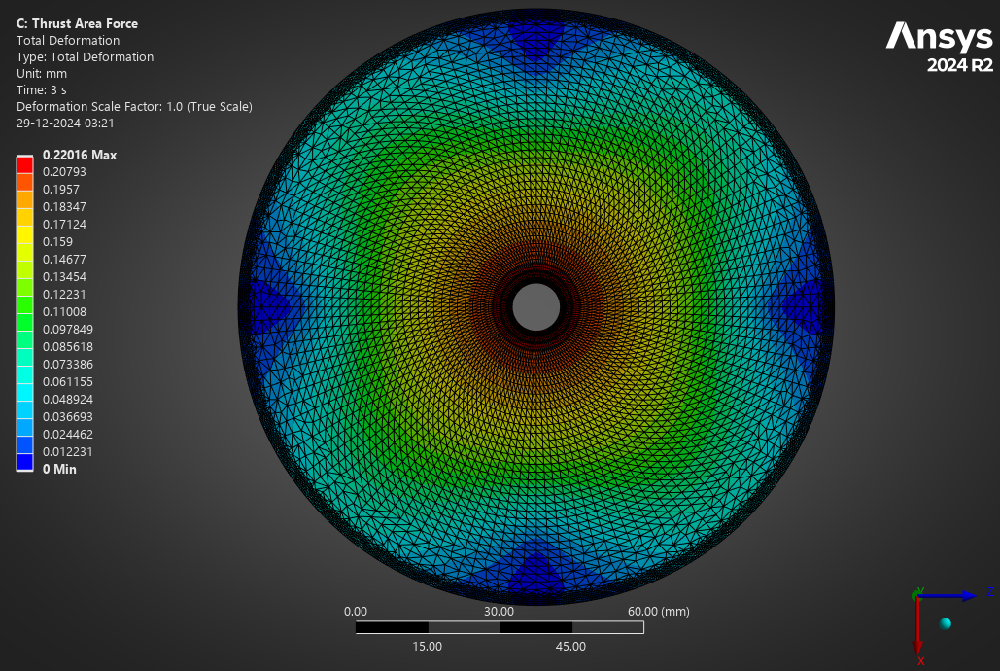
10.FEA/Rocket/Thrust Plate/Added ThrustPad/tdTop.png
