tar7operator/Pinaka/10.FEA/Rocket/Thrust Plate/Center Hole/fos.png

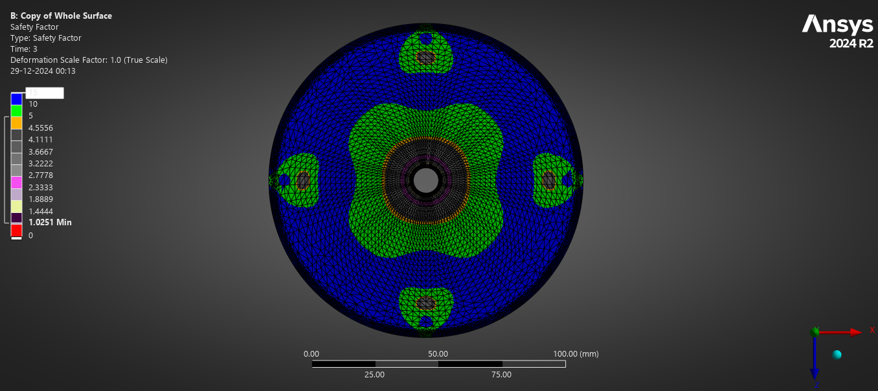
10.FEA/Rocket/Thrust Plate/Center Hole/fos.png
