tar7operator/Pinaka/10.FEA/Rocket/Thrust Plate/Center Hole/fosTop.png

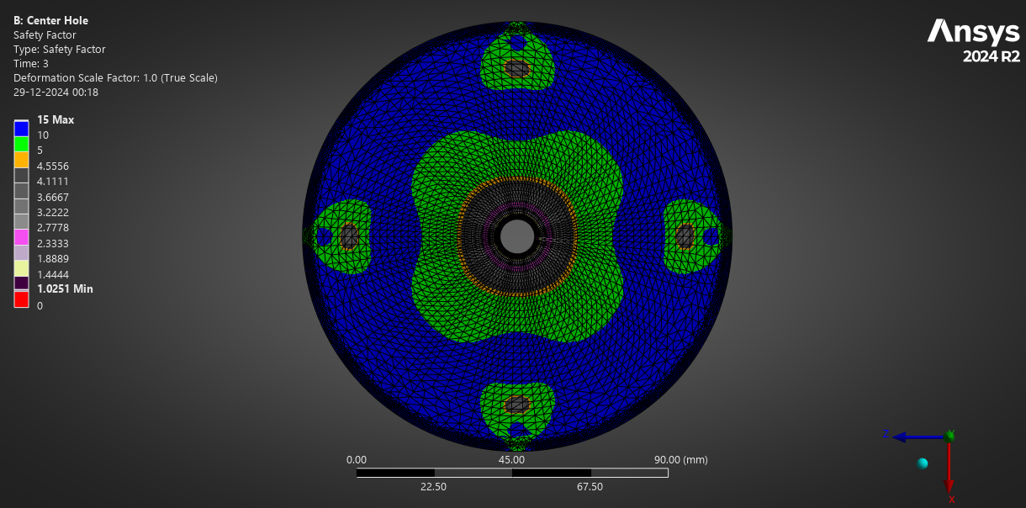
10.FEA/Rocket/Thrust Plate/Center Hole/fosTop.png
