tar7operator/Pinaka/10.FEA/Rocket/Thrust Plate/Center Hole/strainBottom.png

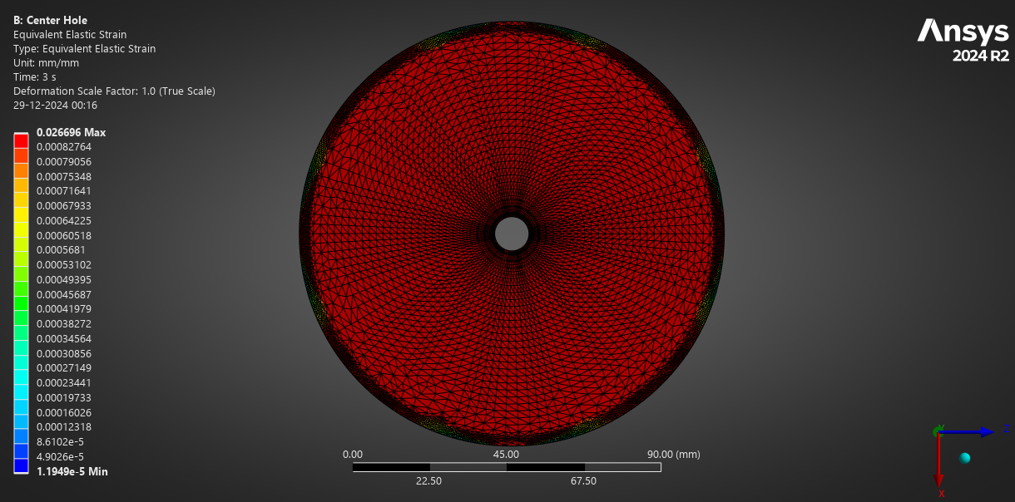
10.FEA/Rocket/Thrust Plate/Center Hole/strainBottom.png
