tar7operator/Pinaka/10.FEA/Rocket/Thrust Plate/Center Hole/strainSIDE.png

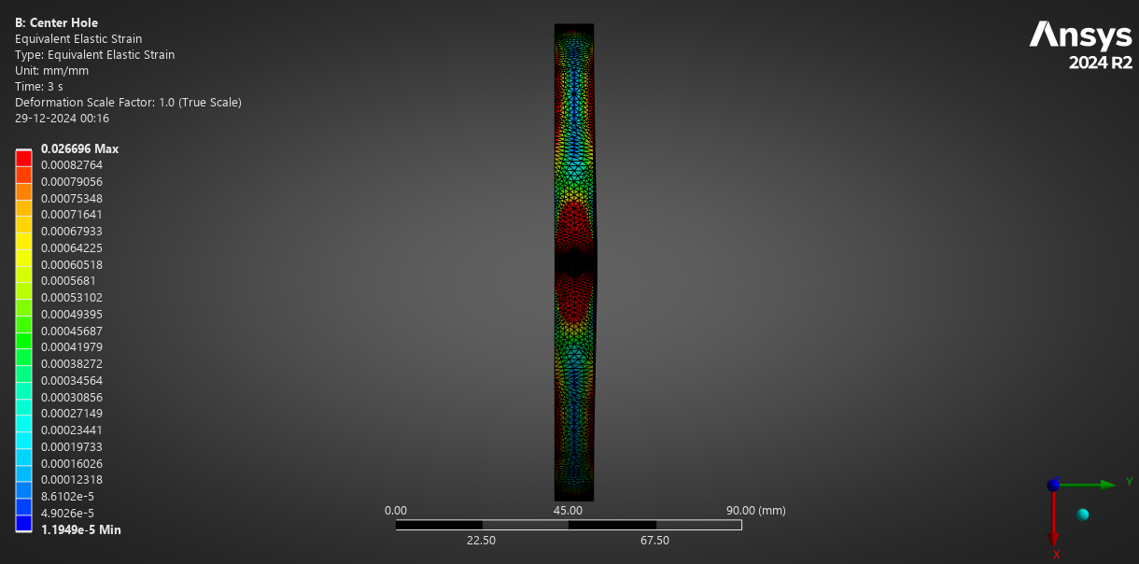
10.FEA/Rocket/Thrust Plate/Center Hole/strainSIDE.png
