tar7operator/Pinaka/10.FEA/Rocket/Thrust Plate/Center Hole/stress.png

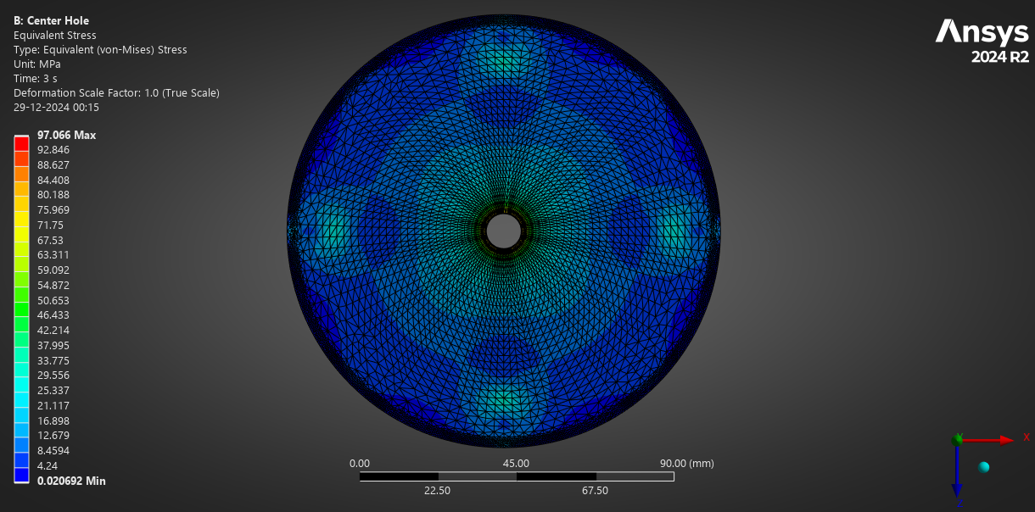
10.FEA/Rocket/Thrust Plate/Center Hole/stress.png
