tar7operator/Pinaka/10.FEA/Rocket/Thrust Plate/Center Hole/tbBottom.png

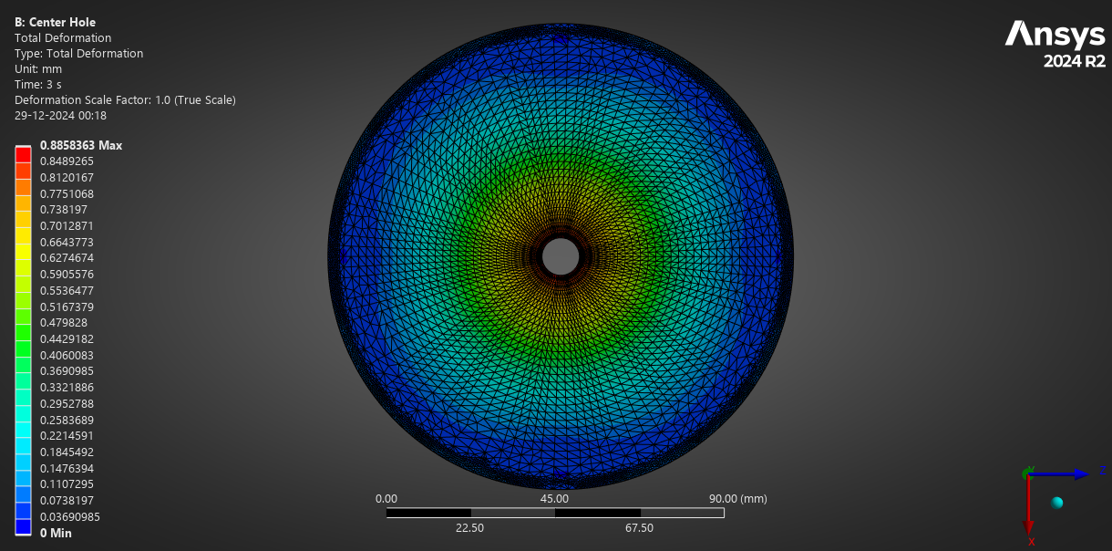
10.FEA/Rocket/Thrust Plate/Center Hole/tbBottom.png
