tar7operator/Pinaka/10.FEA/Rocket/Thrust Plate/Solid works static 1 V3/TD.PNG

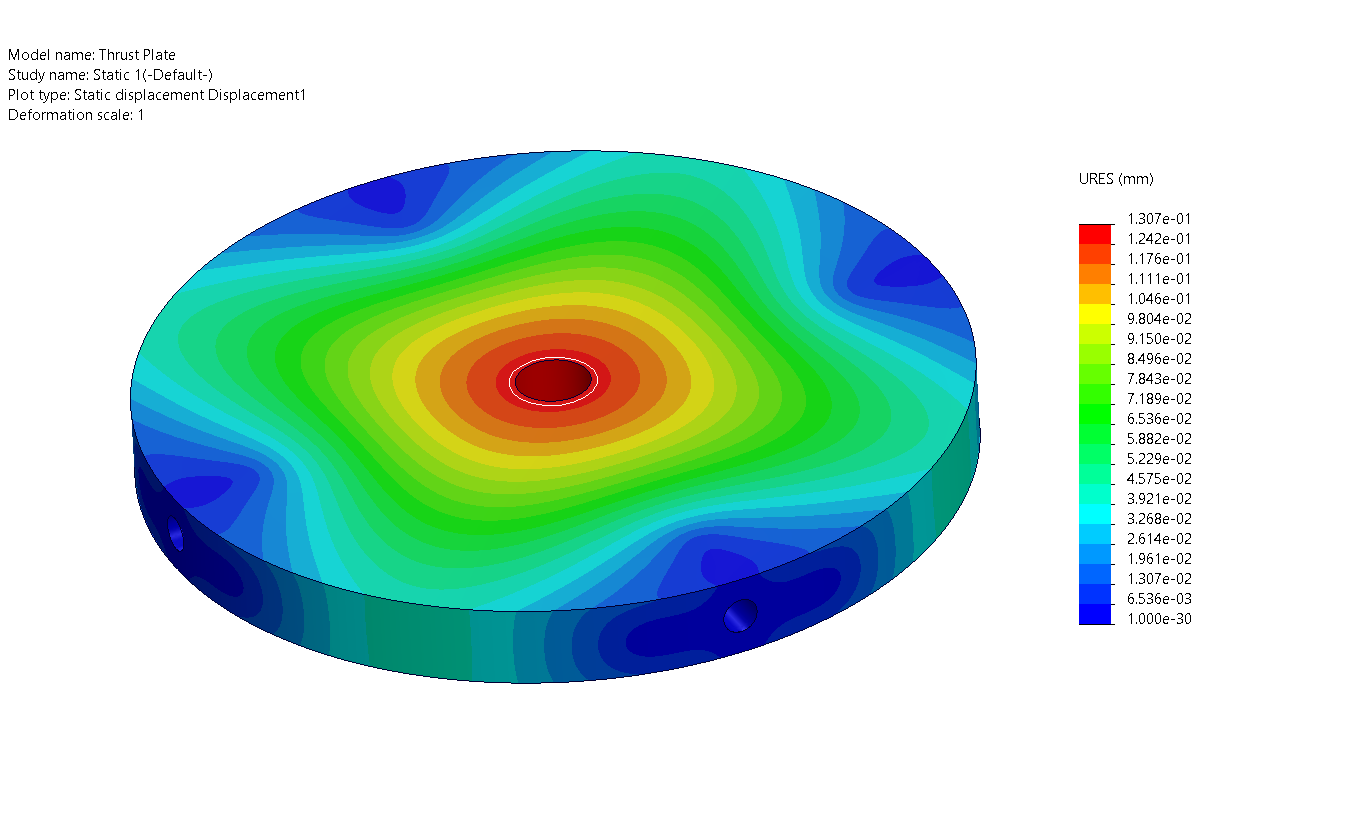
10.FEA/Rocket/Thrust Plate/Solid works static 1 V3/TD.PNG
