tar7operator/Pinaka/10.FEA/Rocket/Thrust Plate/Solid works static 1 V3/Thrust Plate-Static 1-Stress-Stress1.jpg

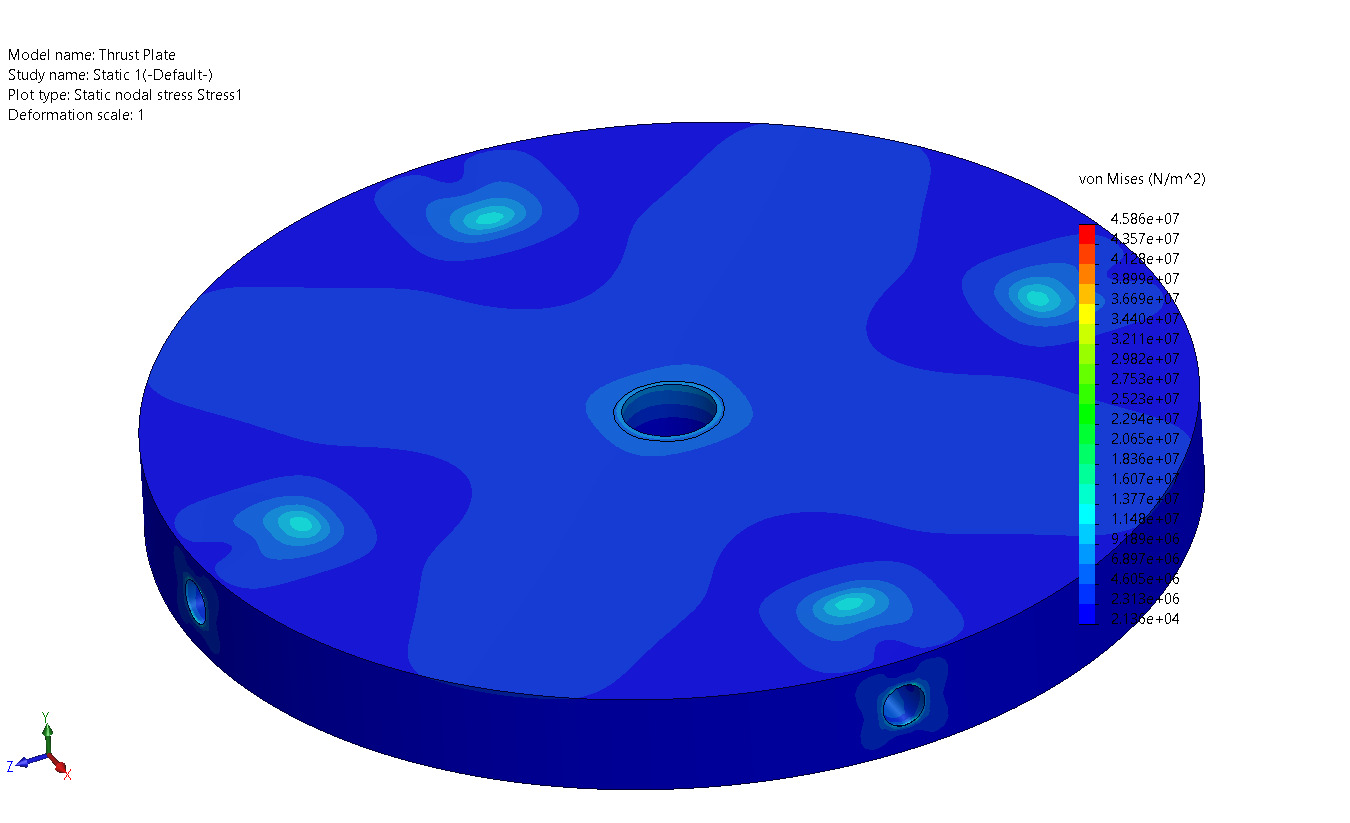
10.FEA/Rocket/Thrust Plate/Solid works static 1 V3/Thrust Plate-Static 1-Stress-Stress1.jpg
