tar7operator/Pinaka/10.FEA/Rocket/Thrust Plate/Whole Body/strainb.png

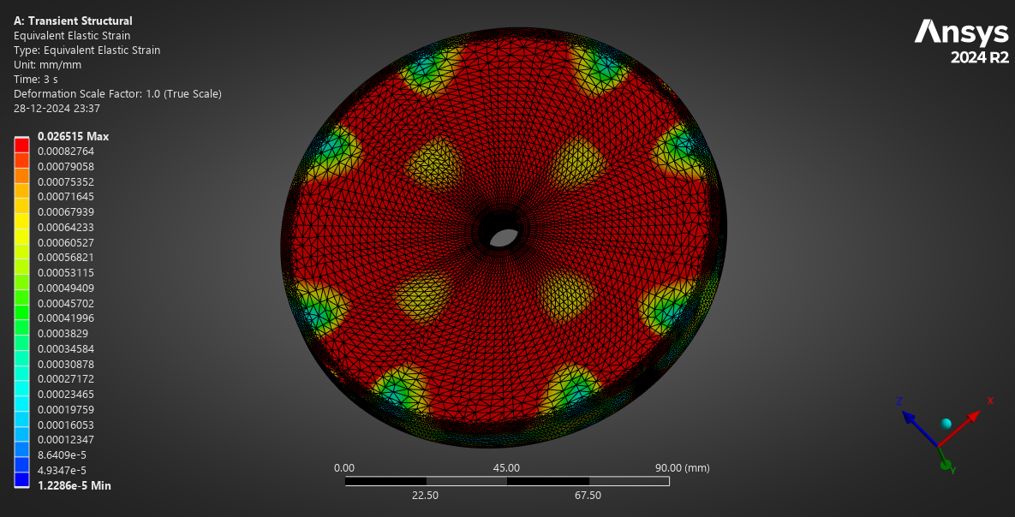
10.FEA/Rocket/Thrust Plate/Whole Body/strainb.png
