tar7operator/Pinaka/10.FEA/Rocket/Transition Zone/16G Acceleration/acc.png

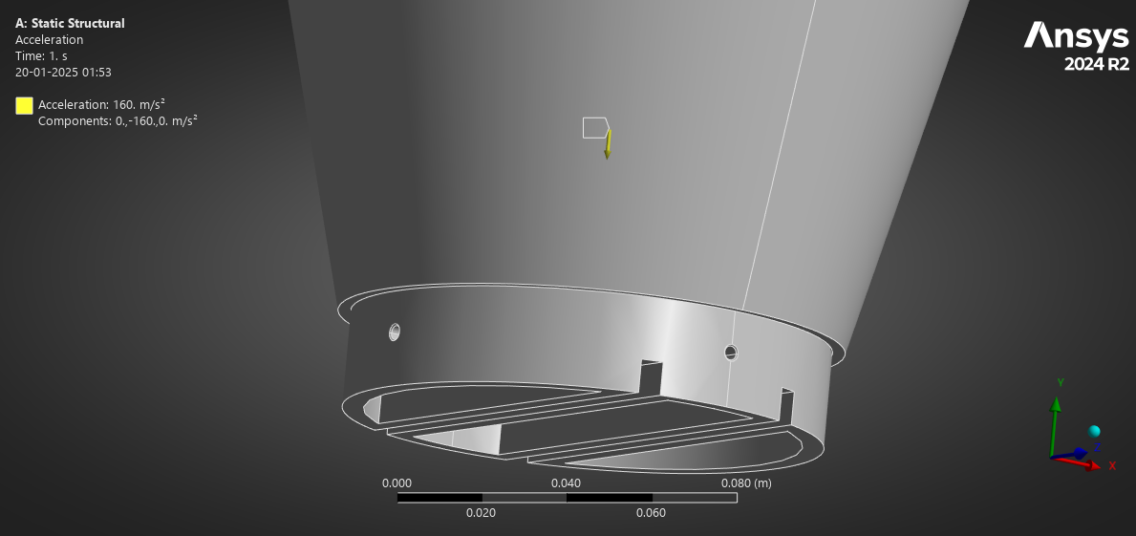
10.FEA/Rocket/Transition Zone/16G Acceleration/acc.png
