tar7operator/Pinaka/10.FEA/Rocket/Transition Zone/16G Acceleration/td Close.png

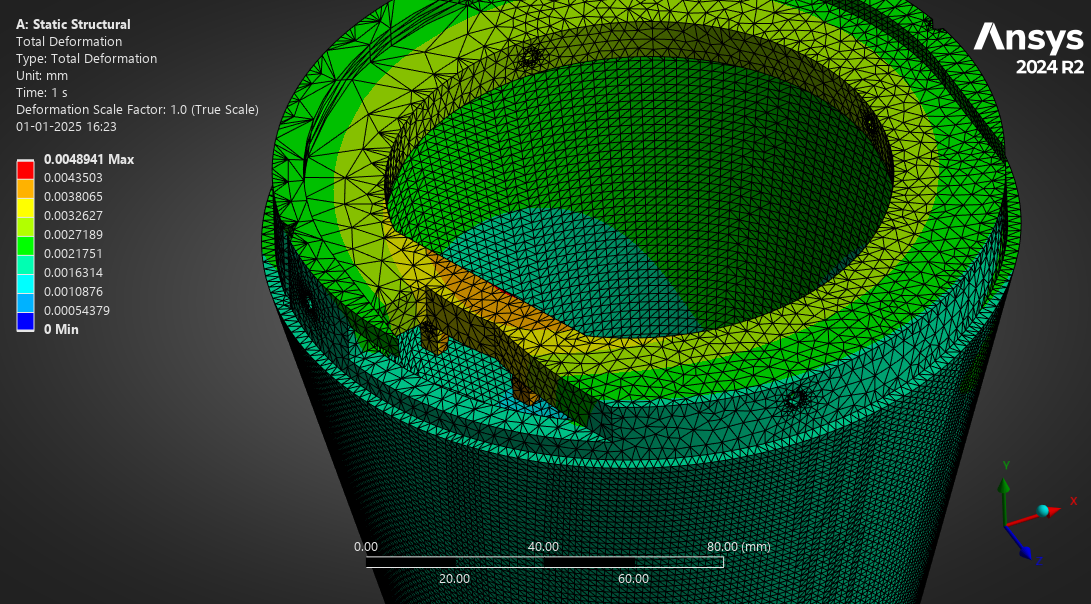
10.FEA/Rocket/Transition Zone/16G Acceleration/td Close.png
