tar7operator/Pinaka/11. CFD/Parachute/Drogue/simscale/force.png

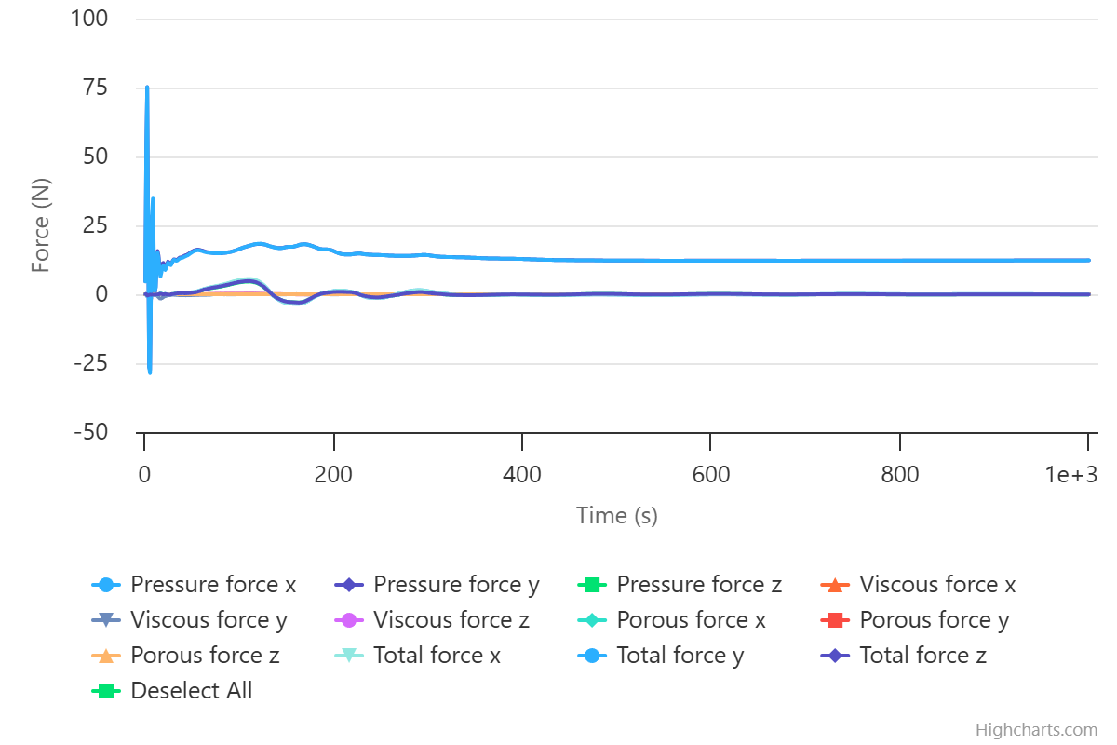
11. CFD/Parachute/Drogue/simscale/force.png
