tar7operator/Pinaka/11. CFD/Parachute/Drogue/simscale/moment.png

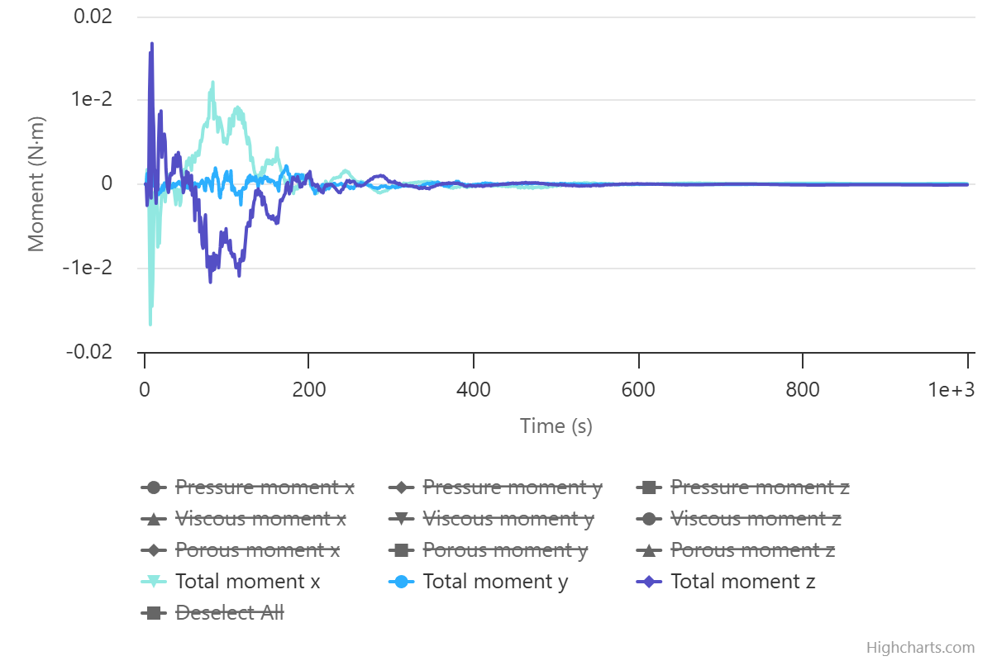
11. CFD/Parachute/Drogue/simscale/moment.png
