tar7operator/Pinaka/11. CFD/Parachute/Drogue/simscale/Pressure.png

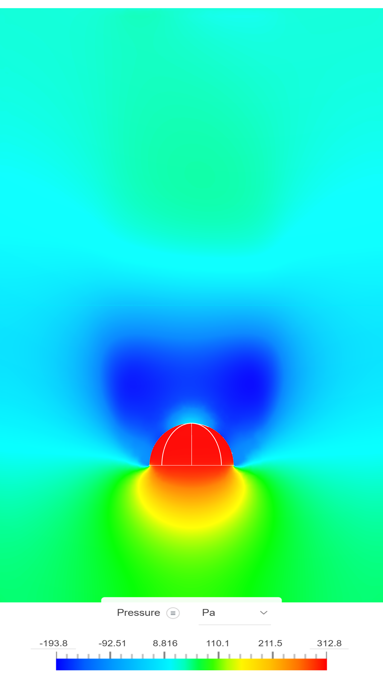
11. CFD/Parachute/Drogue/simscale/Pressure.png
