tar7operator/Pinaka/11. CFD/Parachute/Drogue/simscale/Velocity.png

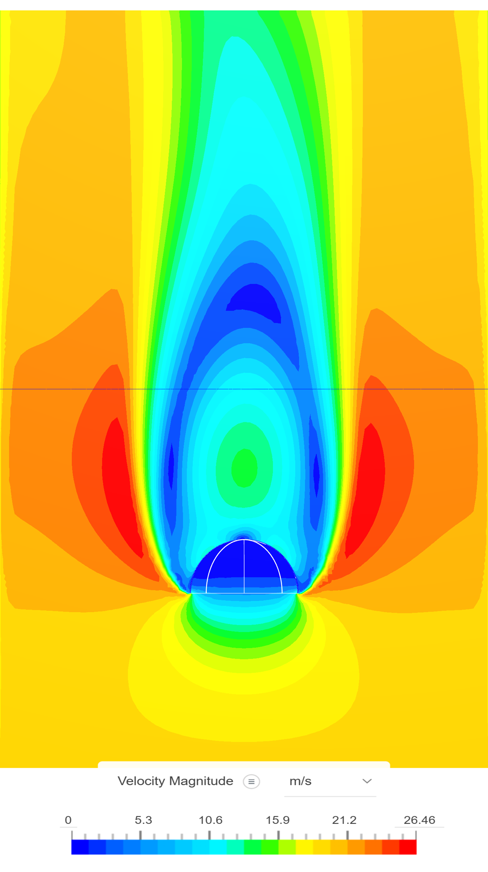
11. CFD/Parachute/Drogue/simscale/Velocity.png
