tar7operator/Pinaka/11. CFD/Parachute/Rocketmain/simscale/force.png

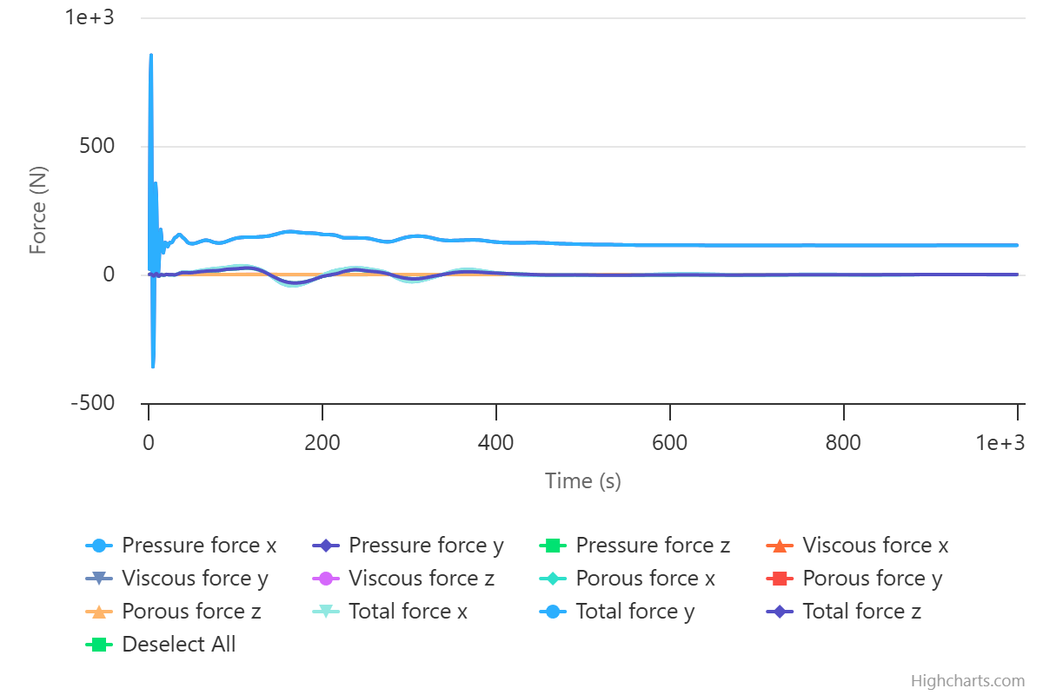
11. CFD/Parachute/Rocketmain/simscale/force.png
