tar7operator/Pinaka/11. CFD/Parachute/Rocketmain/simscale/moment.png

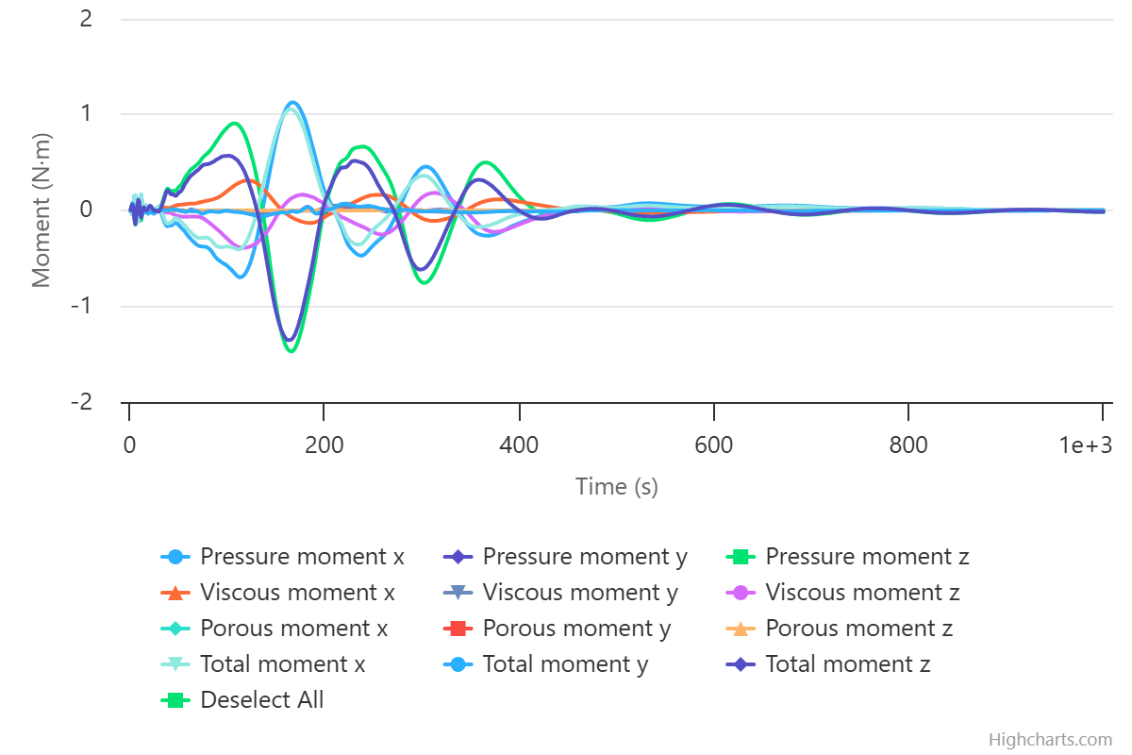
11. CFD/Parachute/Rocketmain/simscale/moment.png
