tar7operator/Pinaka/11. CFD/Parachute/Rocketmain/simscale/Pressure.png

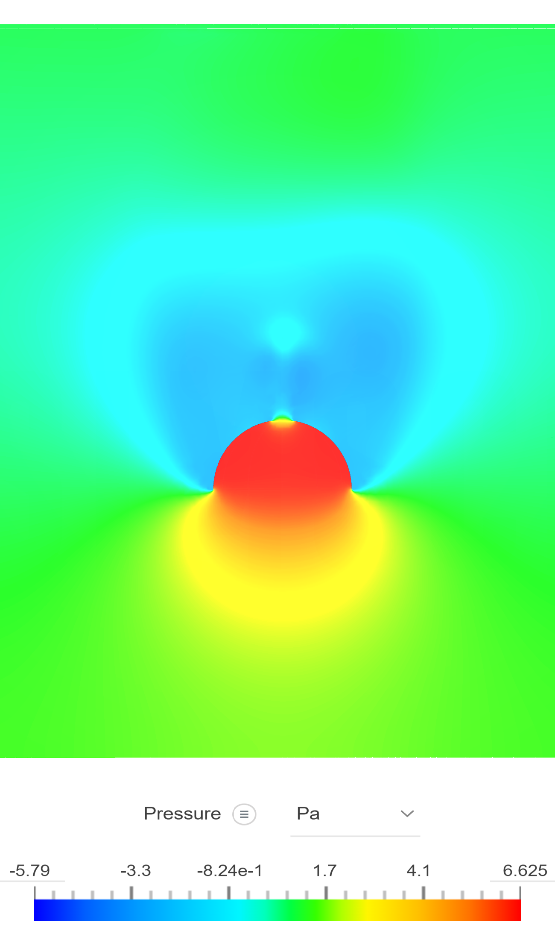
11. CFD/Parachute/Rocketmain/simscale/Pressure.png
