tar7operator/Pinaka/11. CFD/Parachute/Rocketmain/simscale/Velocity.png

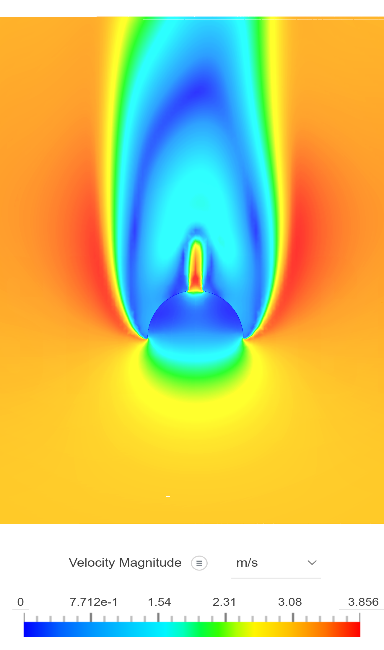
11. CFD/Parachute/Rocketmain/simscale/Velocity.png
