tar7operator/Pinaka/11. CFD/Whole Body/Transition 100mm/force.png

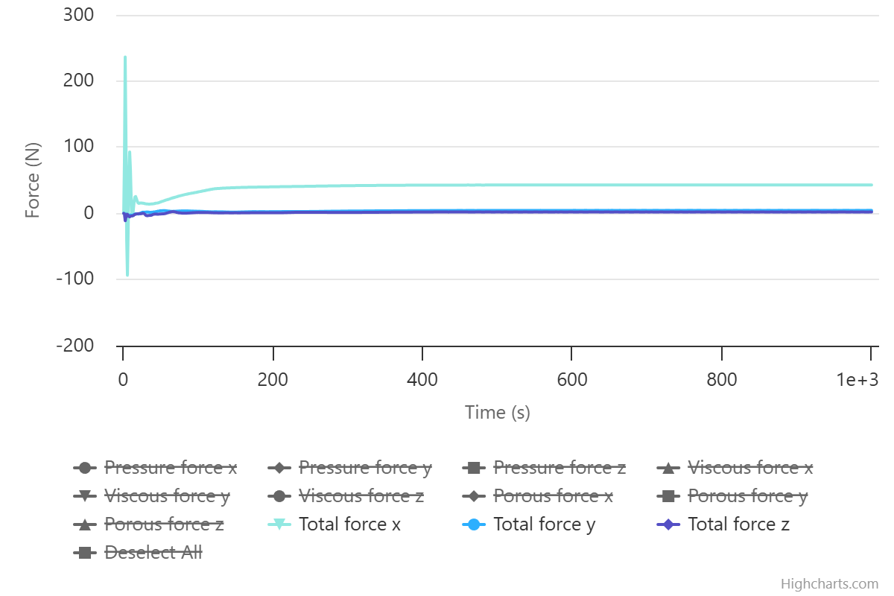
11. CFD/Whole Body/Transition 100mm/force.png
