tar7operator/Pinaka/11. CFD/Whole Body/Transition 100mm/moment.png

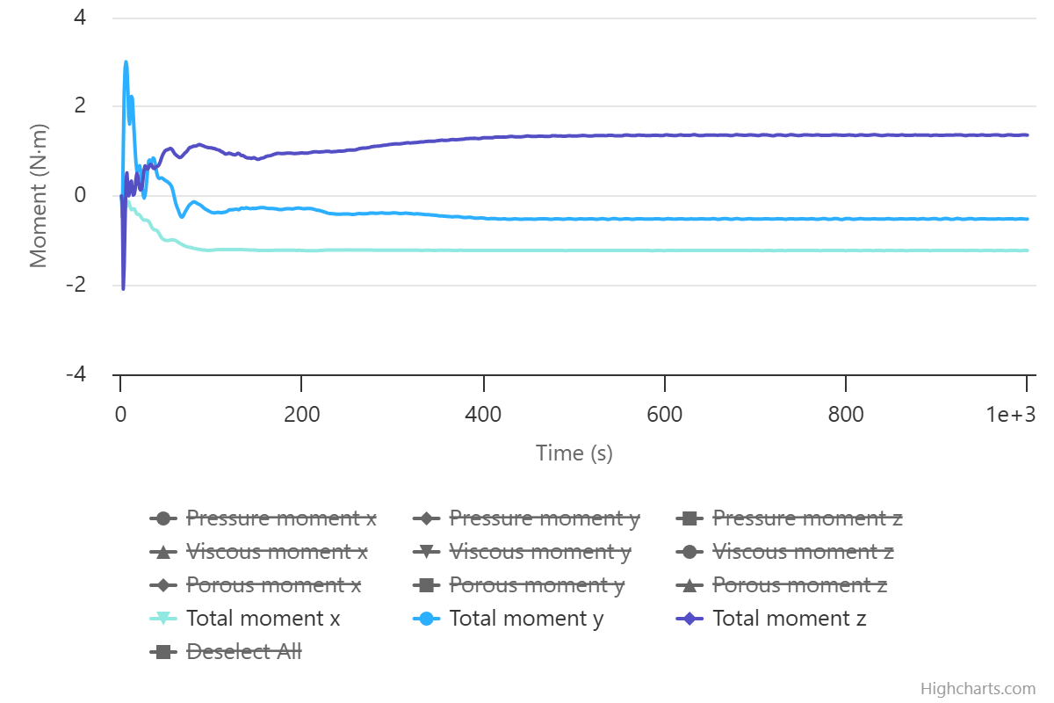
11. CFD/Whole Body/Transition 100mm/moment.png
