tar7operator/Pinaka/11. CFD/Whole Body/Transition 100mm/Screenshot 2.png

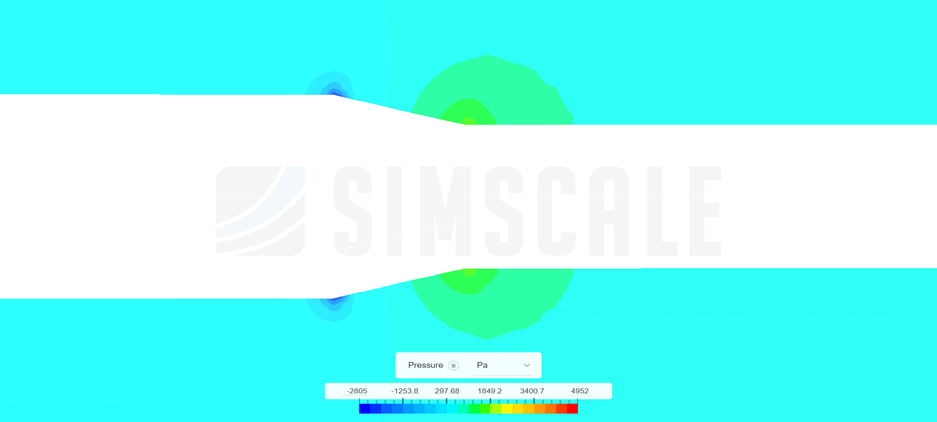
11. CFD/Whole Body/Transition 100mm/Screenshot 2.png
