tar7operator/Pinaka/11. CFD/Whole Body/Transition 100mm/Screenshot 4.png

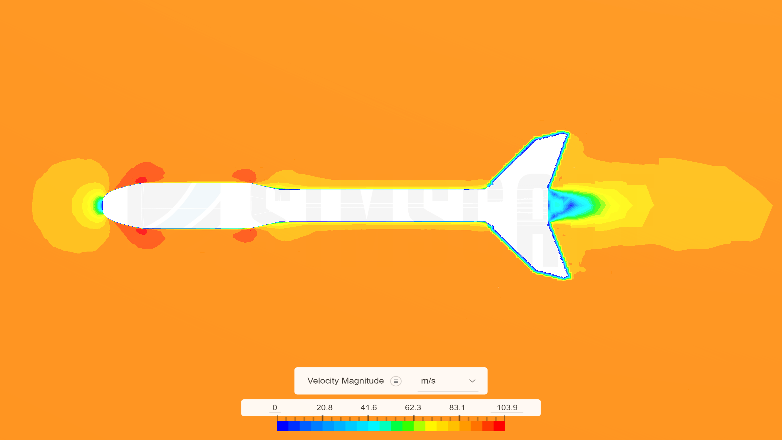
11. CFD/Whole Body/Transition 100mm/Screenshot 4.png
