tar7operator/Pinaka/16. CAD V5/Drawings/CanSat/BasePlaseDrw.PNG

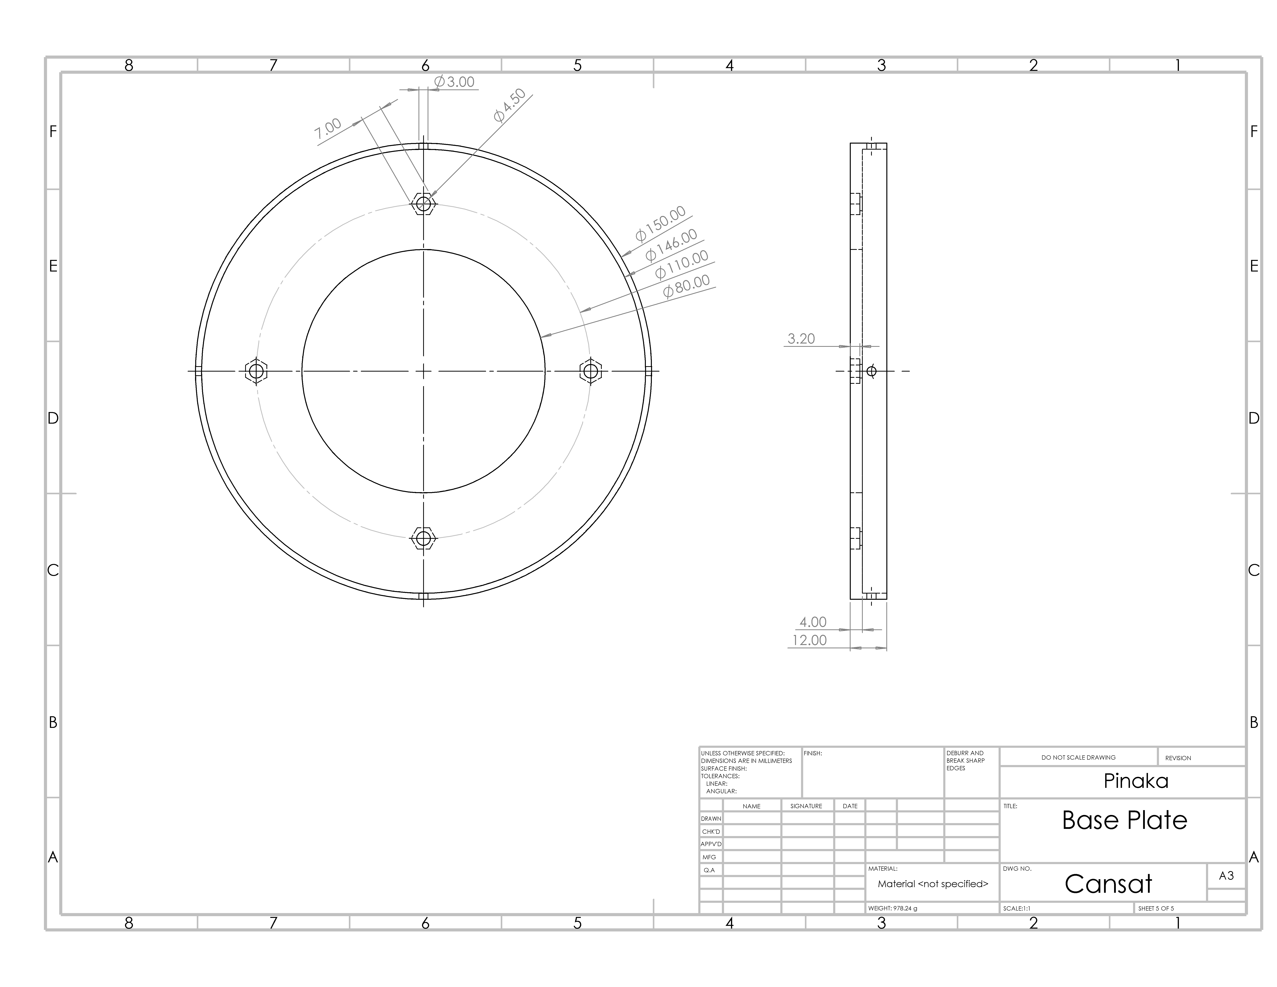
16. CAD V5/Drawings/CanSat/BasePlaseDrw.PNG
