tar7operator/Pinaka/16. CAD V5/Drawings/CanSat/Camera Plate.PNG

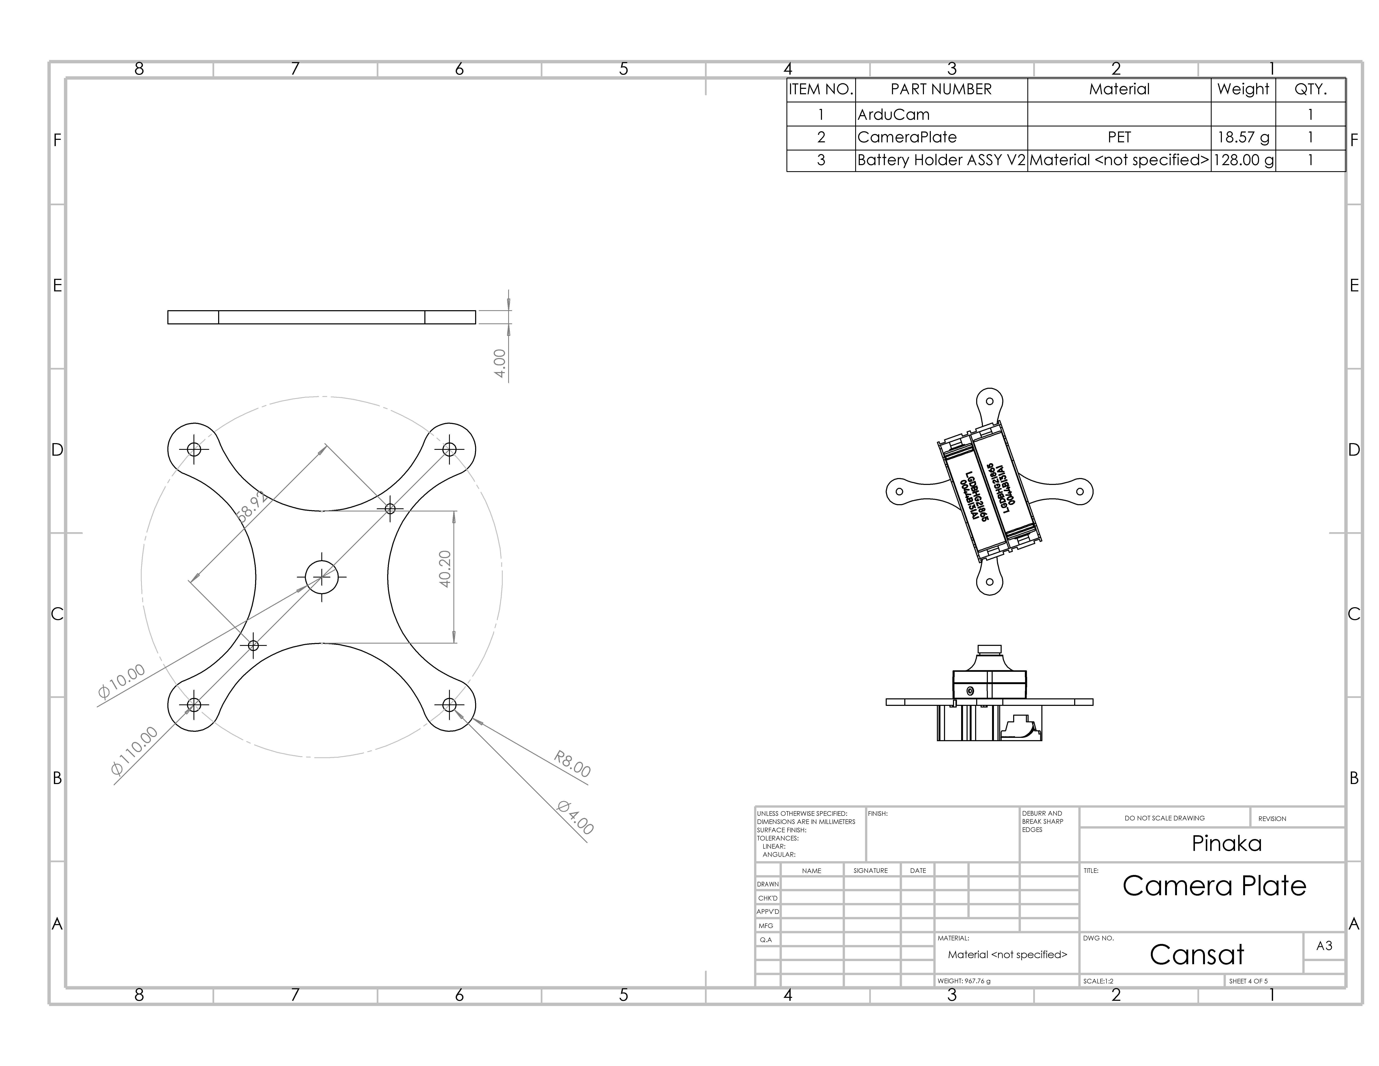
16. CAD V5/Drawings/CanSat/Camera Plate.PNG
