tar7operator/Pinaka/16. CAD V5/Drawings/CanSat/GA.PNG

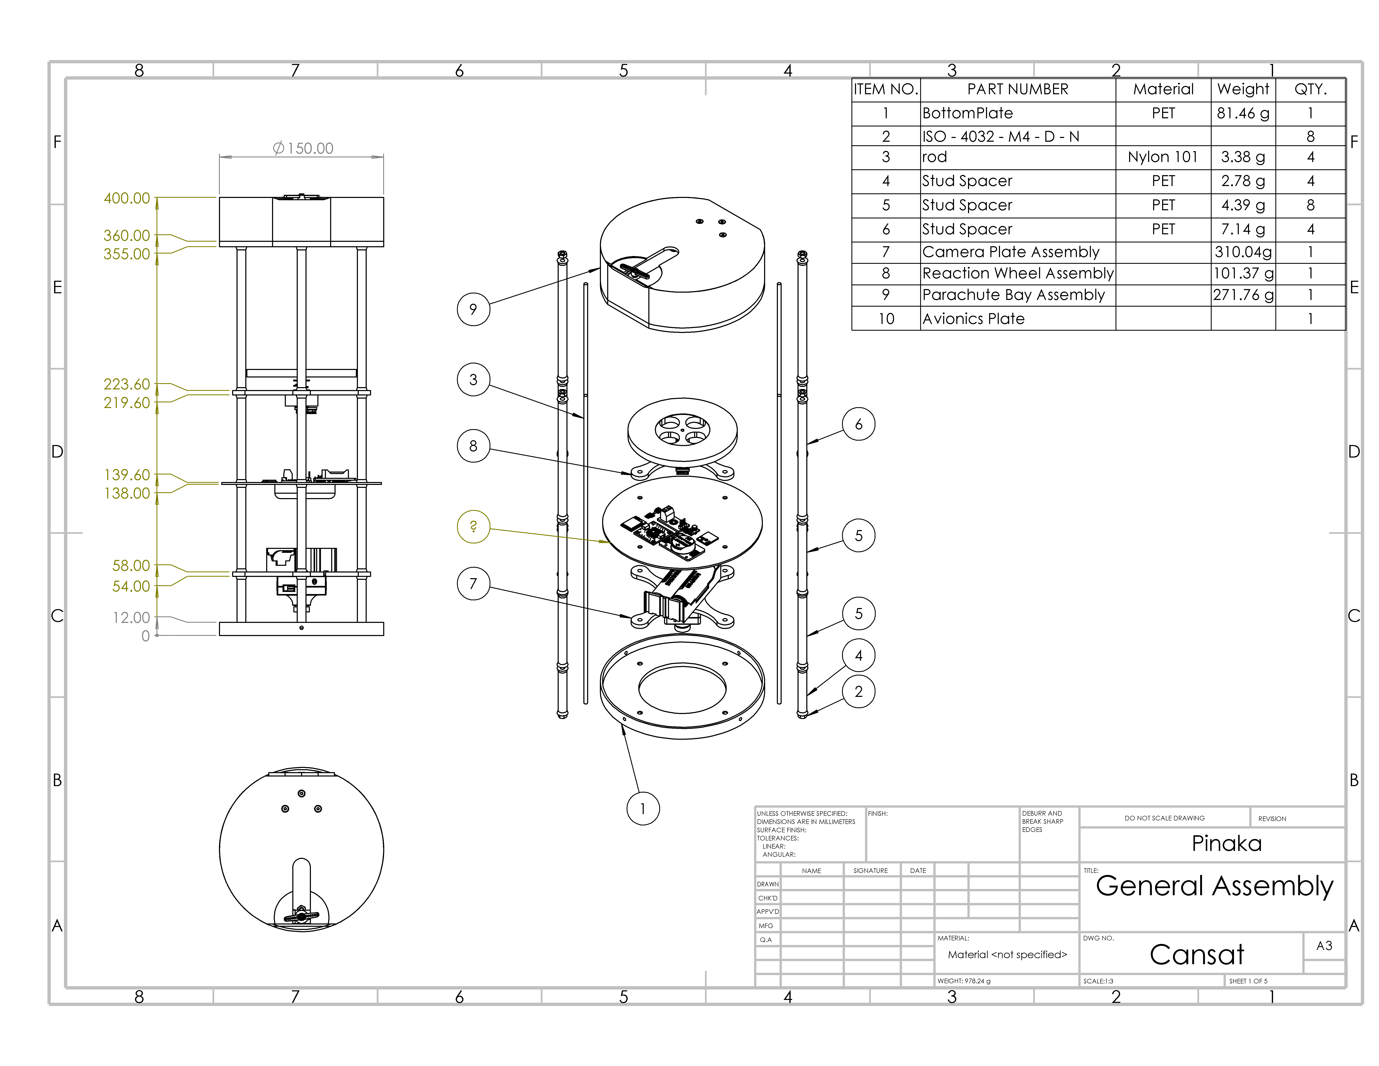
16. CAD V5/Drawings/CanSat/GA.PNG
