tar7operator/Pinaka/16. CAD V5/Drawings/CanSat/Parachute bay.PNG

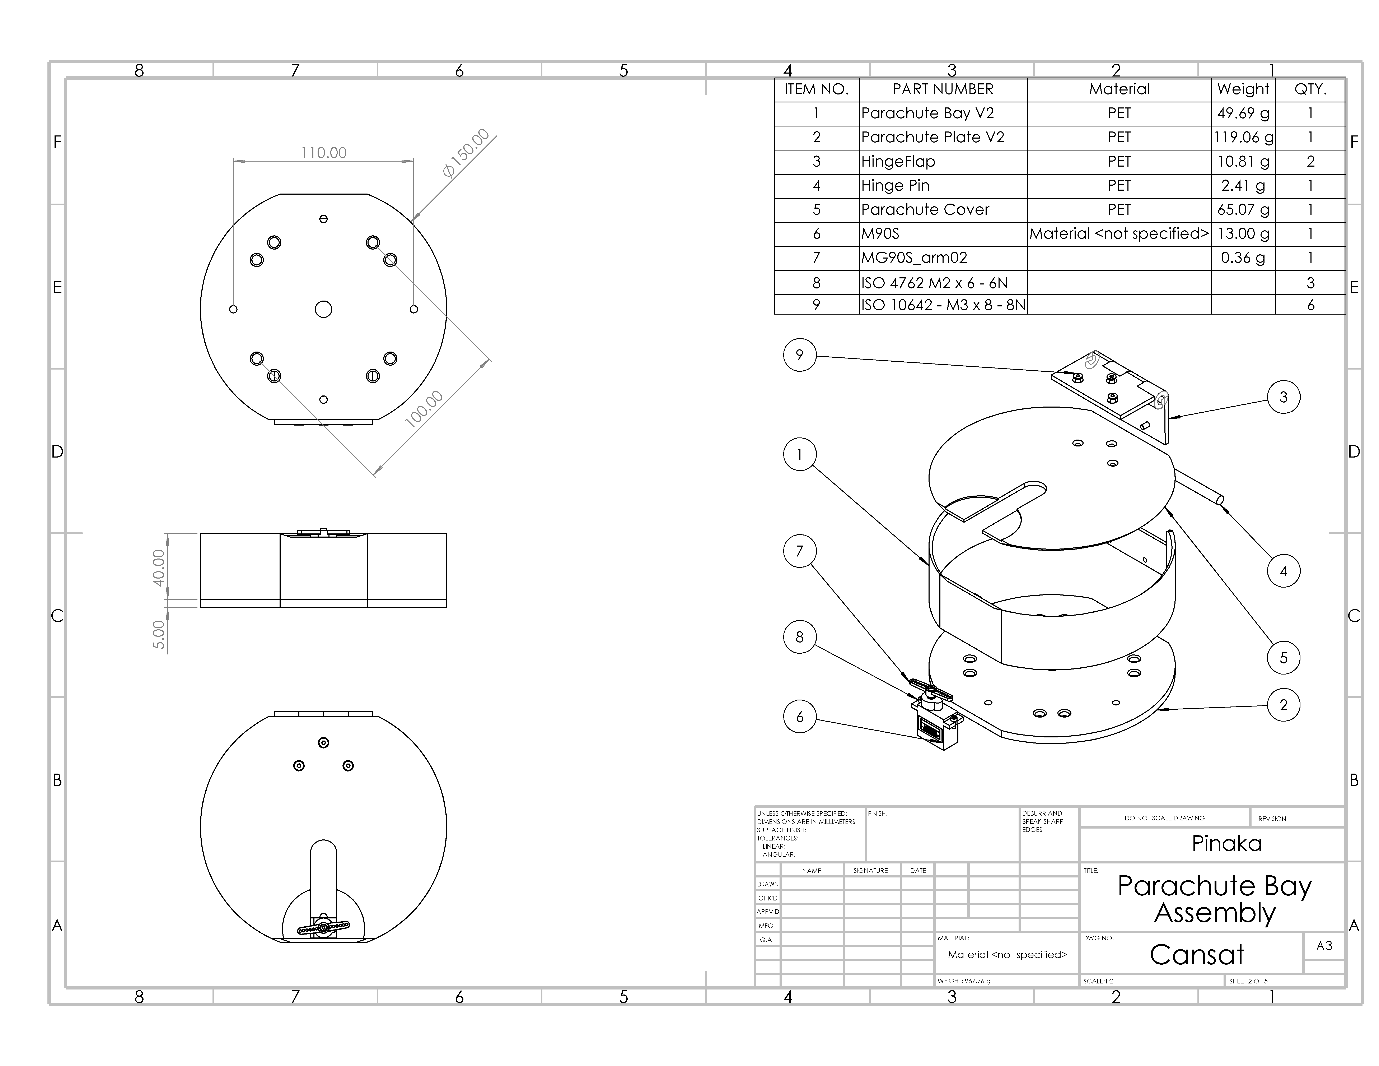
16. CAD V5/Drawings/CanSat/Parachute bay.PNG
