tar7operator/Pinaka/16. CAD V5/Drawings/Doc/Body tube connections.PNG

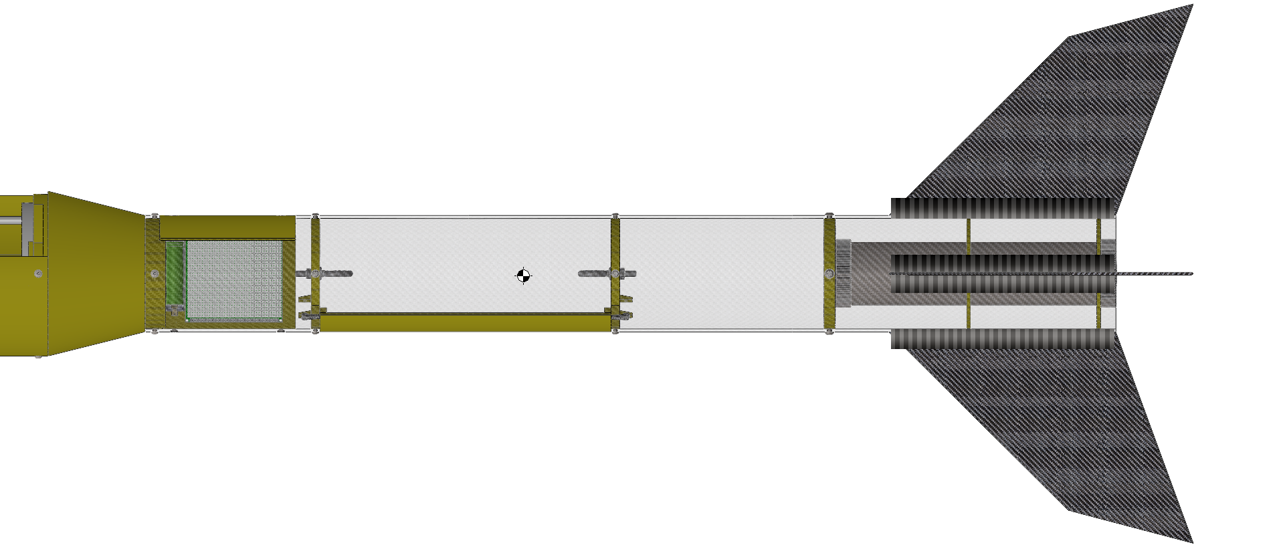
16. CAD V5/Drawings/Doc/Body tube connections.PNG
