tar7operator/Pinaka/16. CAD V5/Drawings/Doc/droguewithCansat.JPG

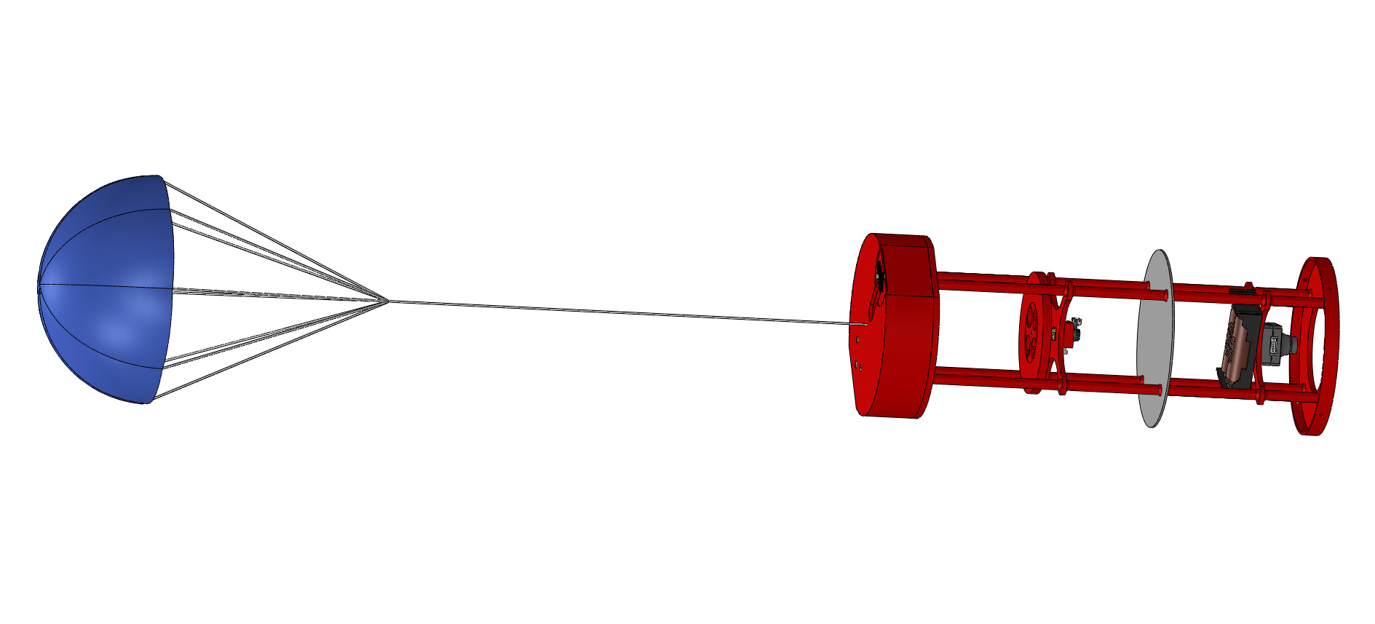
16. CAD V5/Drawings/Doc/droguewithCansat.JPG
