tar7operator/Pinaka/16. CAD V5/Drawings/Doc/exploded 2.PNG

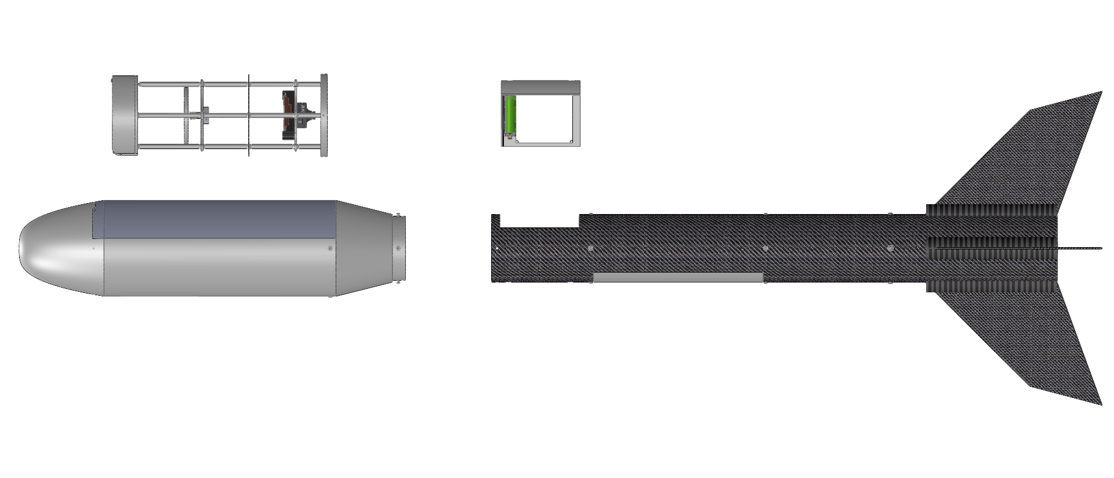
16. CAD V5/Drawings/Doc/exploded 2.PNG
