tar7operator/Pinaka/16. CAD V5/Drawings/Doc/exploded view.PNG

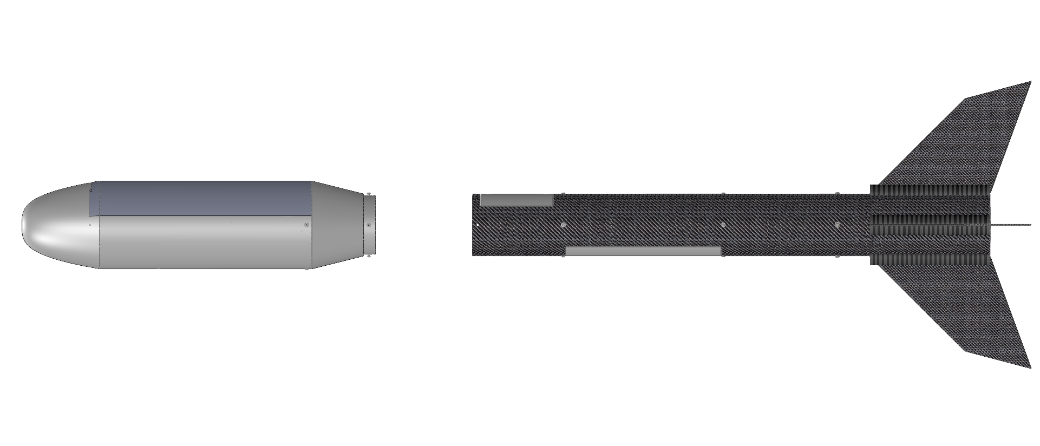
16. CAD V5/Drawings/Doc/exploded view.PNG
