tar7operator/Pinaka/16. CAD V5/Drawings/Doc/mainwithCansat.JPG

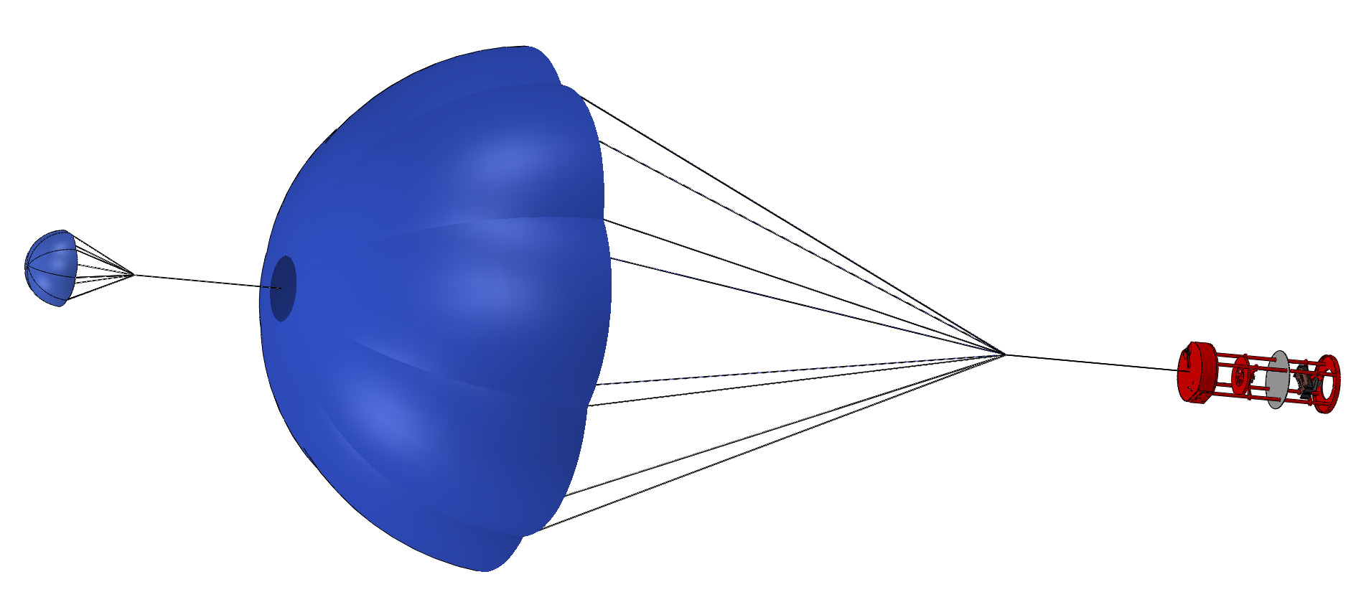
16. CAD V5/Drawings/Doc/mainwithCansat.JPG
