tar7operator/Pinaka/16. CAD V5/Drawings/Doc/mainwithrocket.JPG

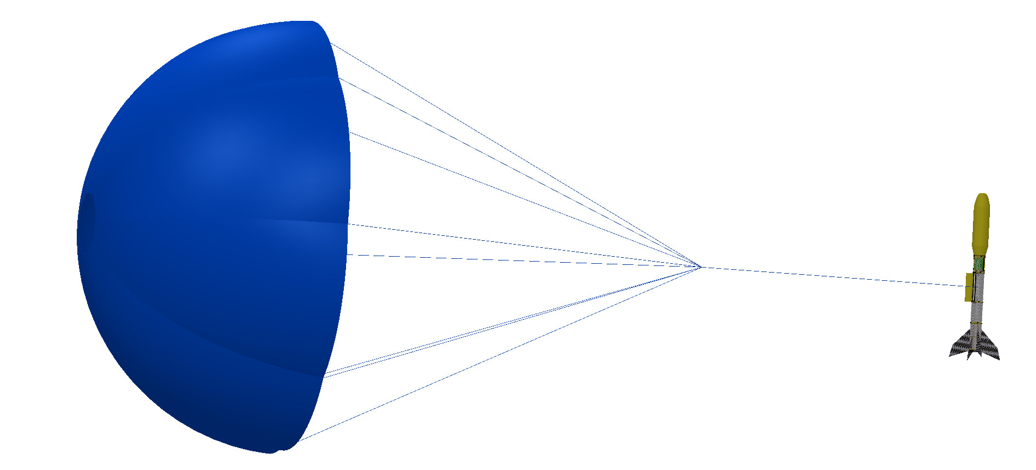
16. CAD V5/Drawings/Doc/mainwithrocket.JPG
