tar7operator/Pinaka/16. CAD V5/Drawings/Doc/motorbay.PNG

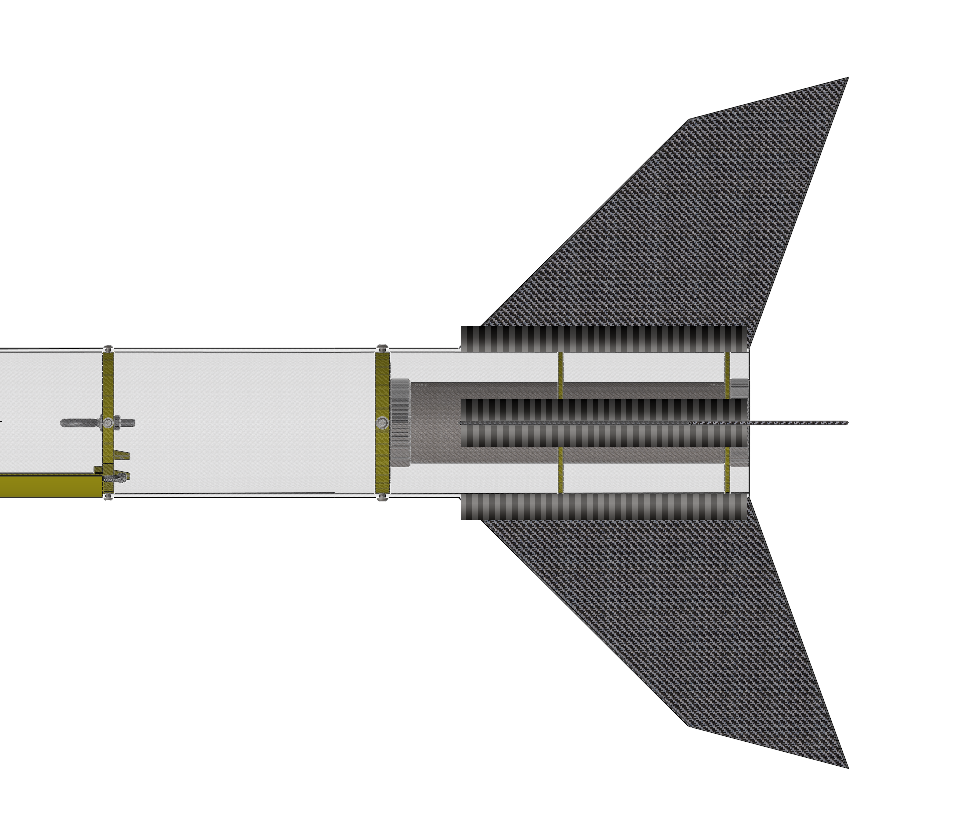
16. CAD V5/Drawings/Doc/motorbay.PNG
