tar7operator/Pinaka/16. CAD V5/Drawings/Doc/motorbayv.PNG

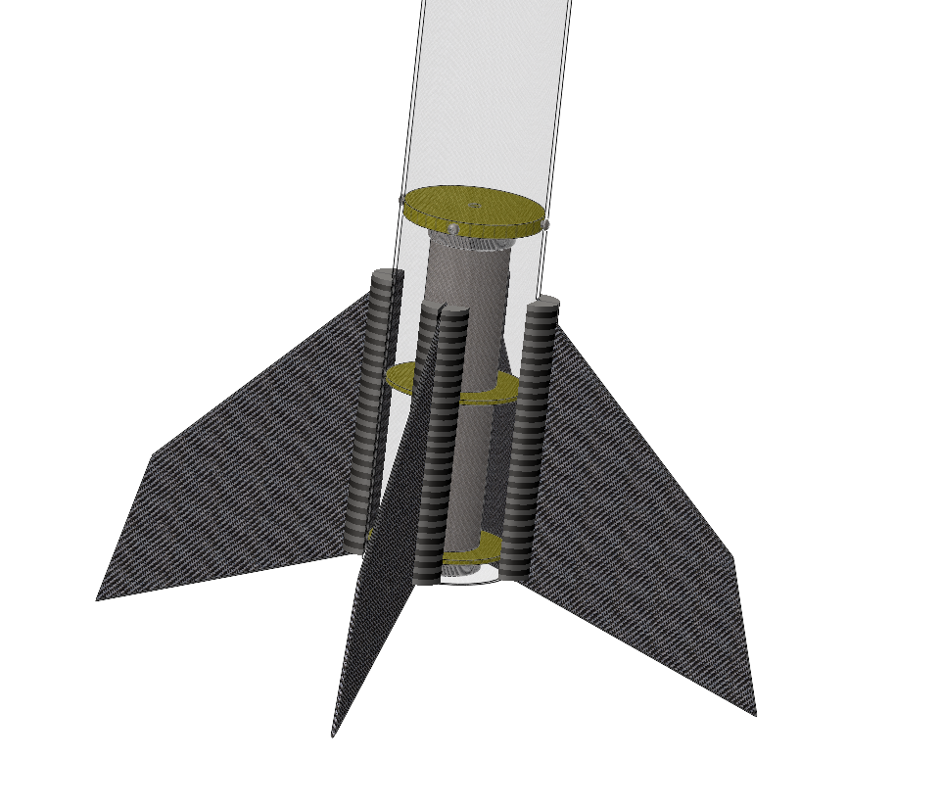
16. CAD V5/Drawings/Doc/motorbayv.PNG
