tar7operator/Pinaka/16. CAD V5/Drawings/Doc/nose cone joint.PNG

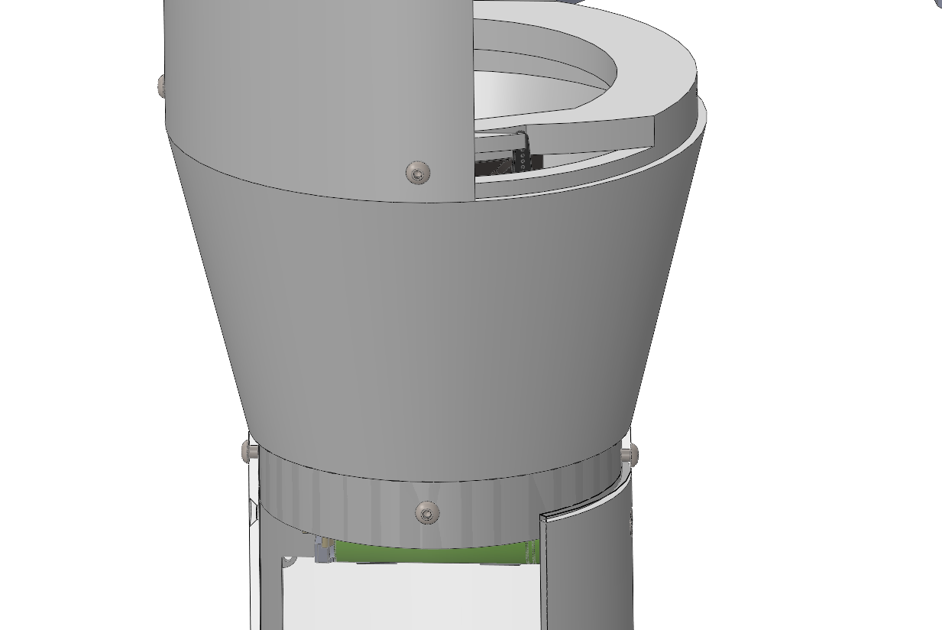
16. CAD V5/Drawings/Doc/nose cone joint.PNG
