tar7operator/Pinaka/16. CAD V5/Drawings/Doc/overall Dimensions.PNG

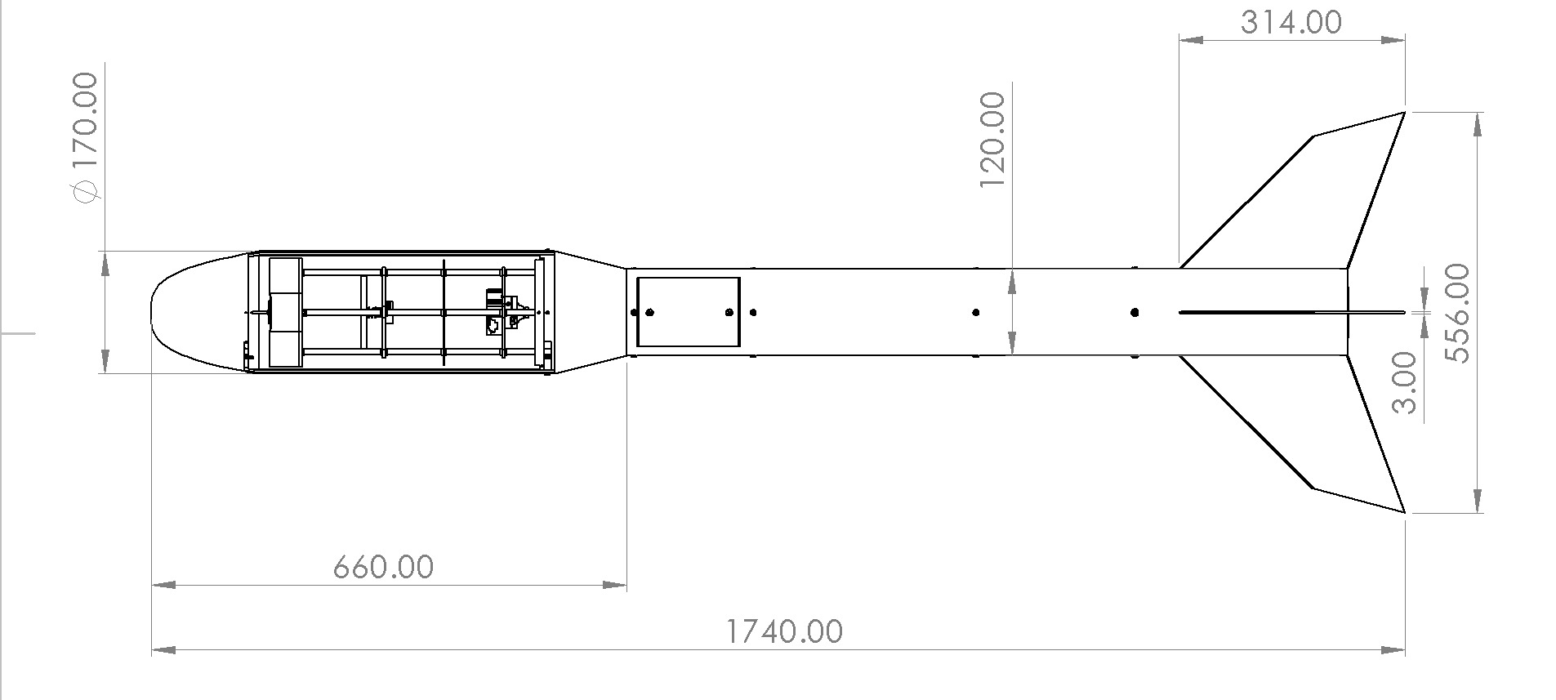
16. CAD V5/Drawings/Doc/overall Dimensions.PNG
