tar7operator/Pinaka/16. CAD V5/Drawings/Doc/TransitionConeBottom.PNG

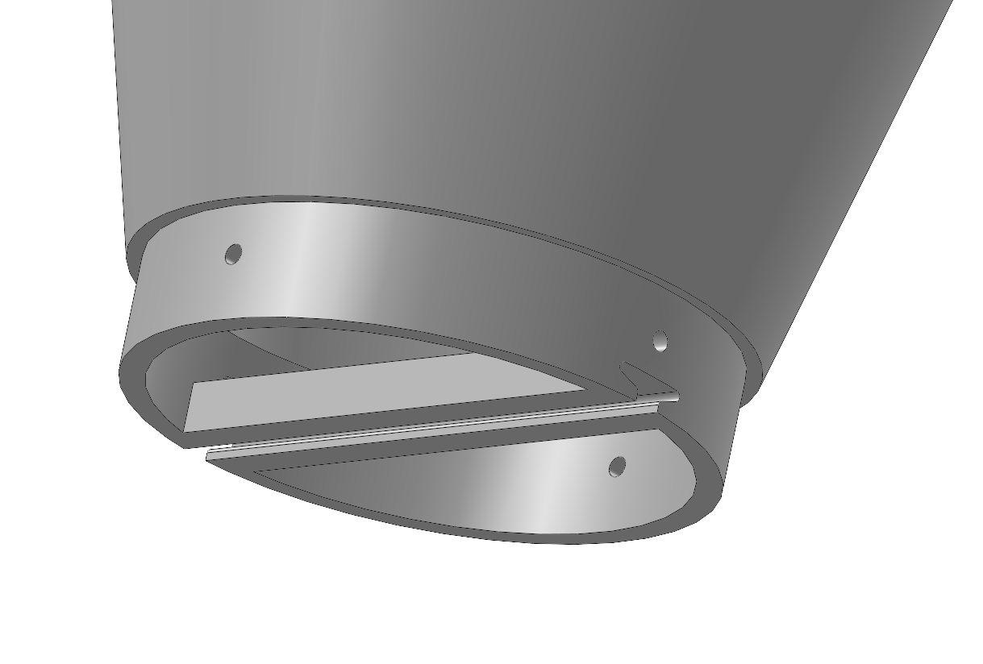
16. CAD V5/Drawings/Doc/TransitionConeBottom.PNG
