tar7operator/Pinaka/16. CAD V5/Drawings/General Arrangement V5.JPG

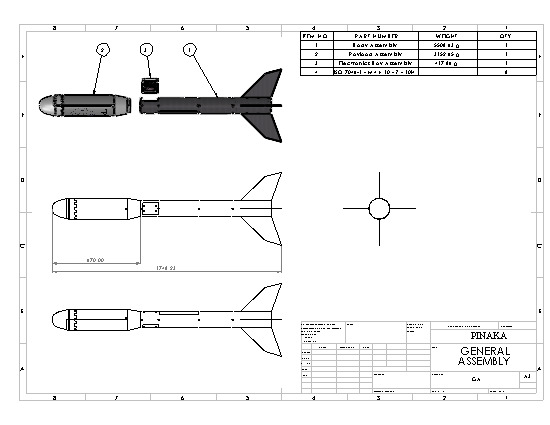
16. CAD V5/Drawings/General Arrangement V5.JPG
