tar7operator/Pinaka/16. CAD V5/Drawings/General Arrangement V5.PNG

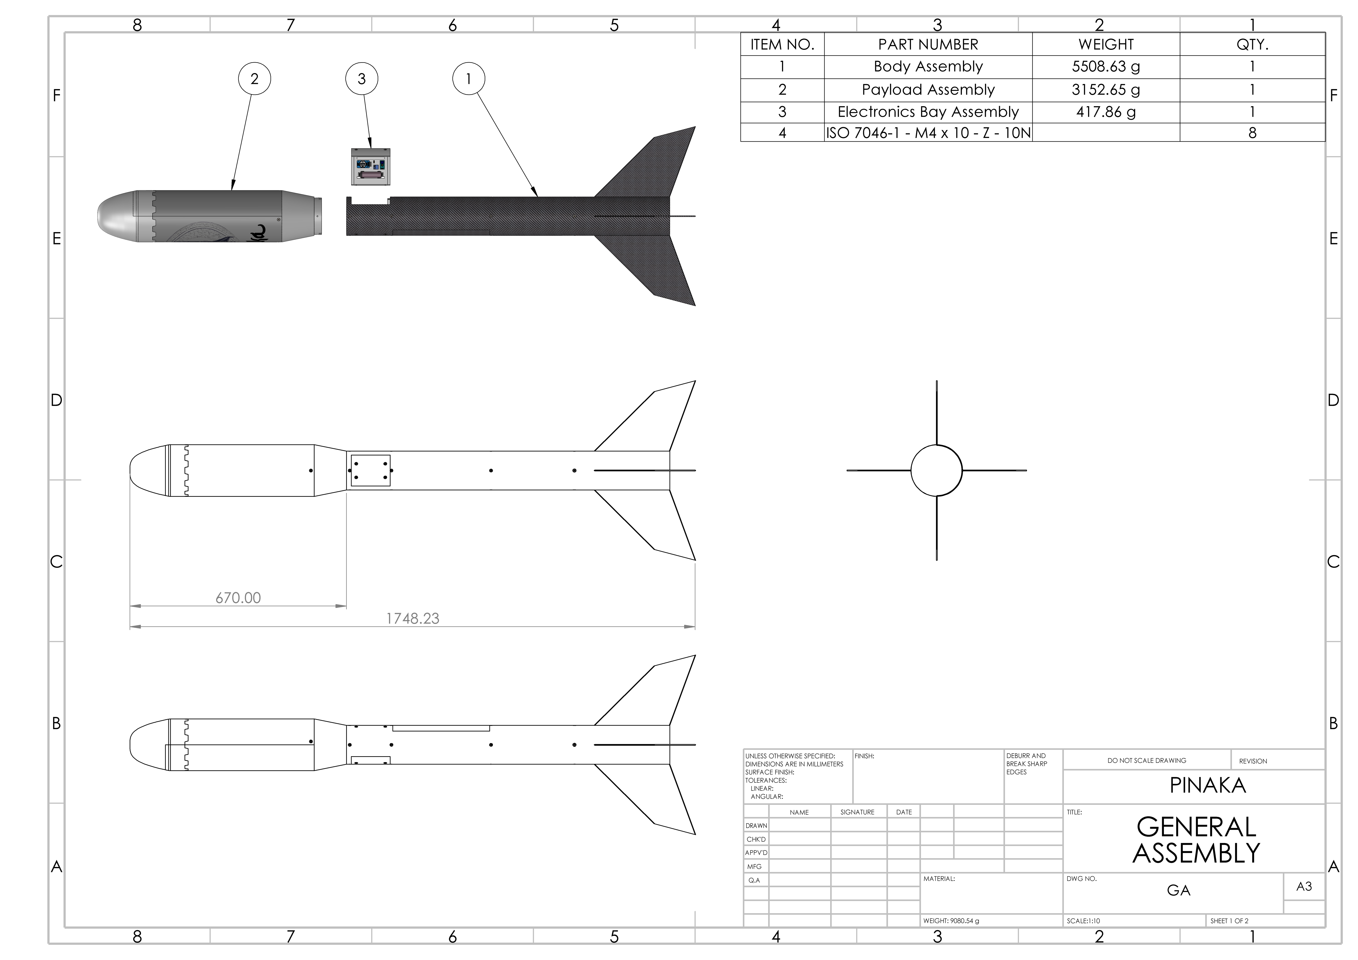
16. CAD V5/Drawings/General Arrangement V5.PNG
