tar7operator/Pinaka/16. CAD V5/Drawings/Schematics/CanSat Avionics.png

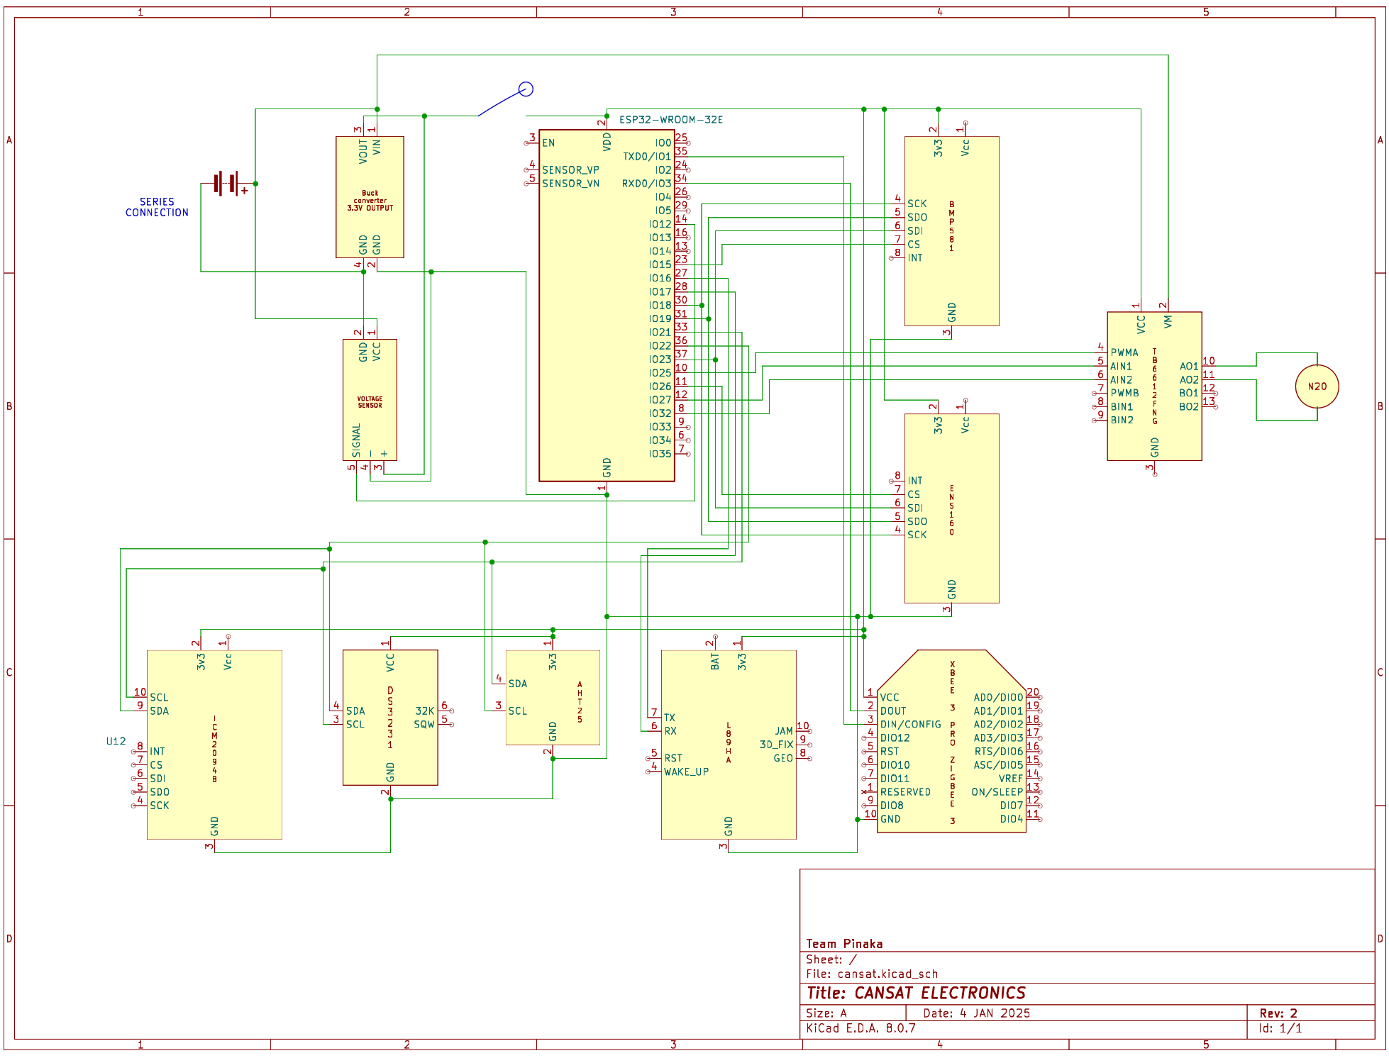
16. CAD V5/Drawings/Schematics/CanSat Avionics.png
