tar7operator/Pinaka/16. CAD V5/Drawings/Schematics/Ground Station.png

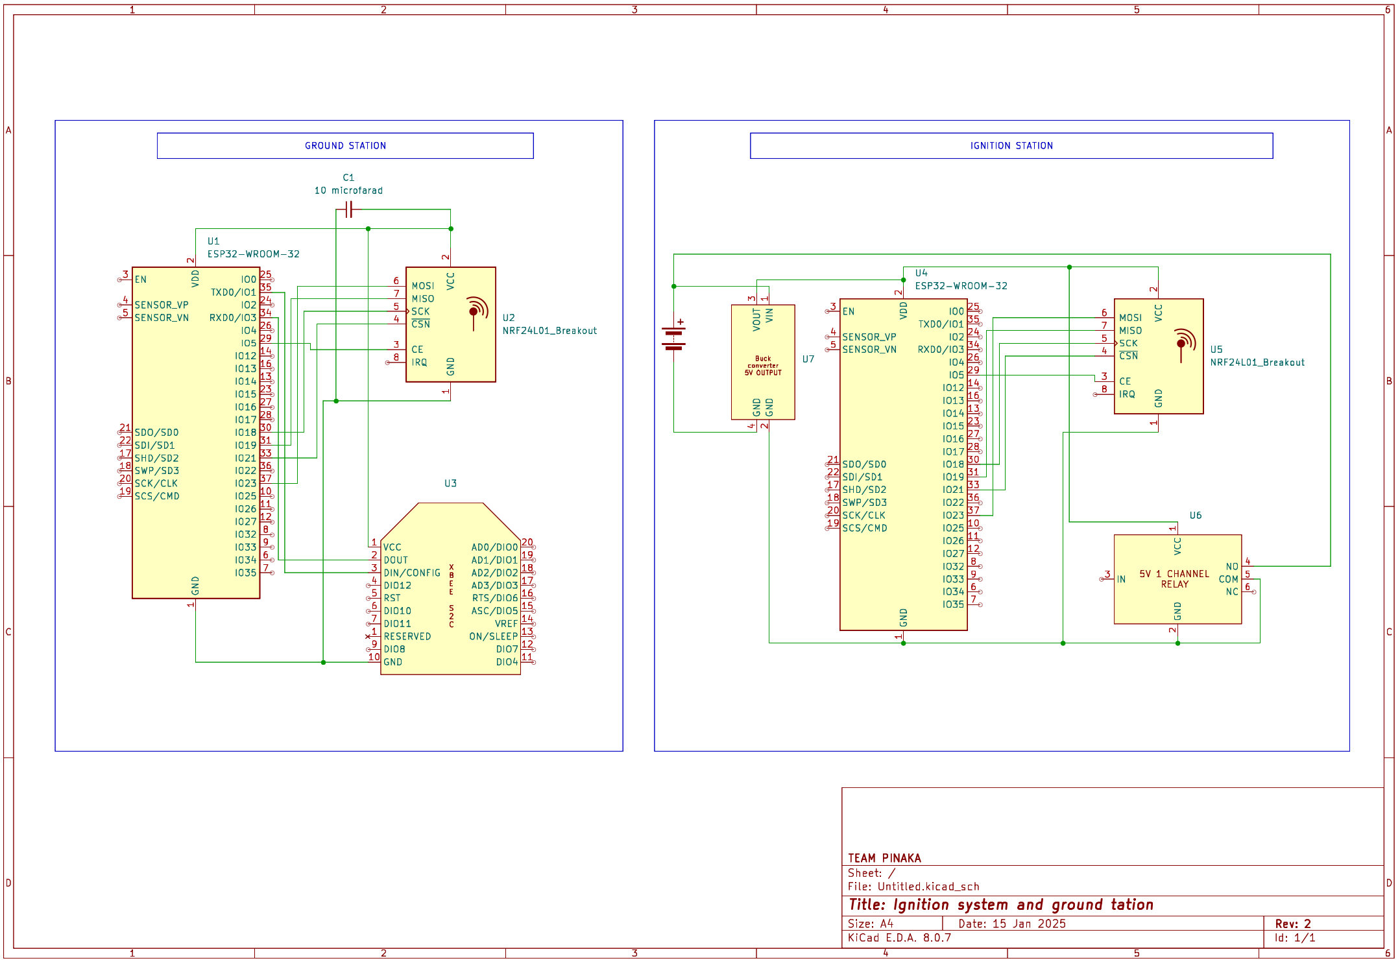
16. CAD V5/Drawings/Schematics/Ground Station.png
