tar7operator/Pinaka/16. CAD V5/Drawings/Schematics/Rocket Avionics.png

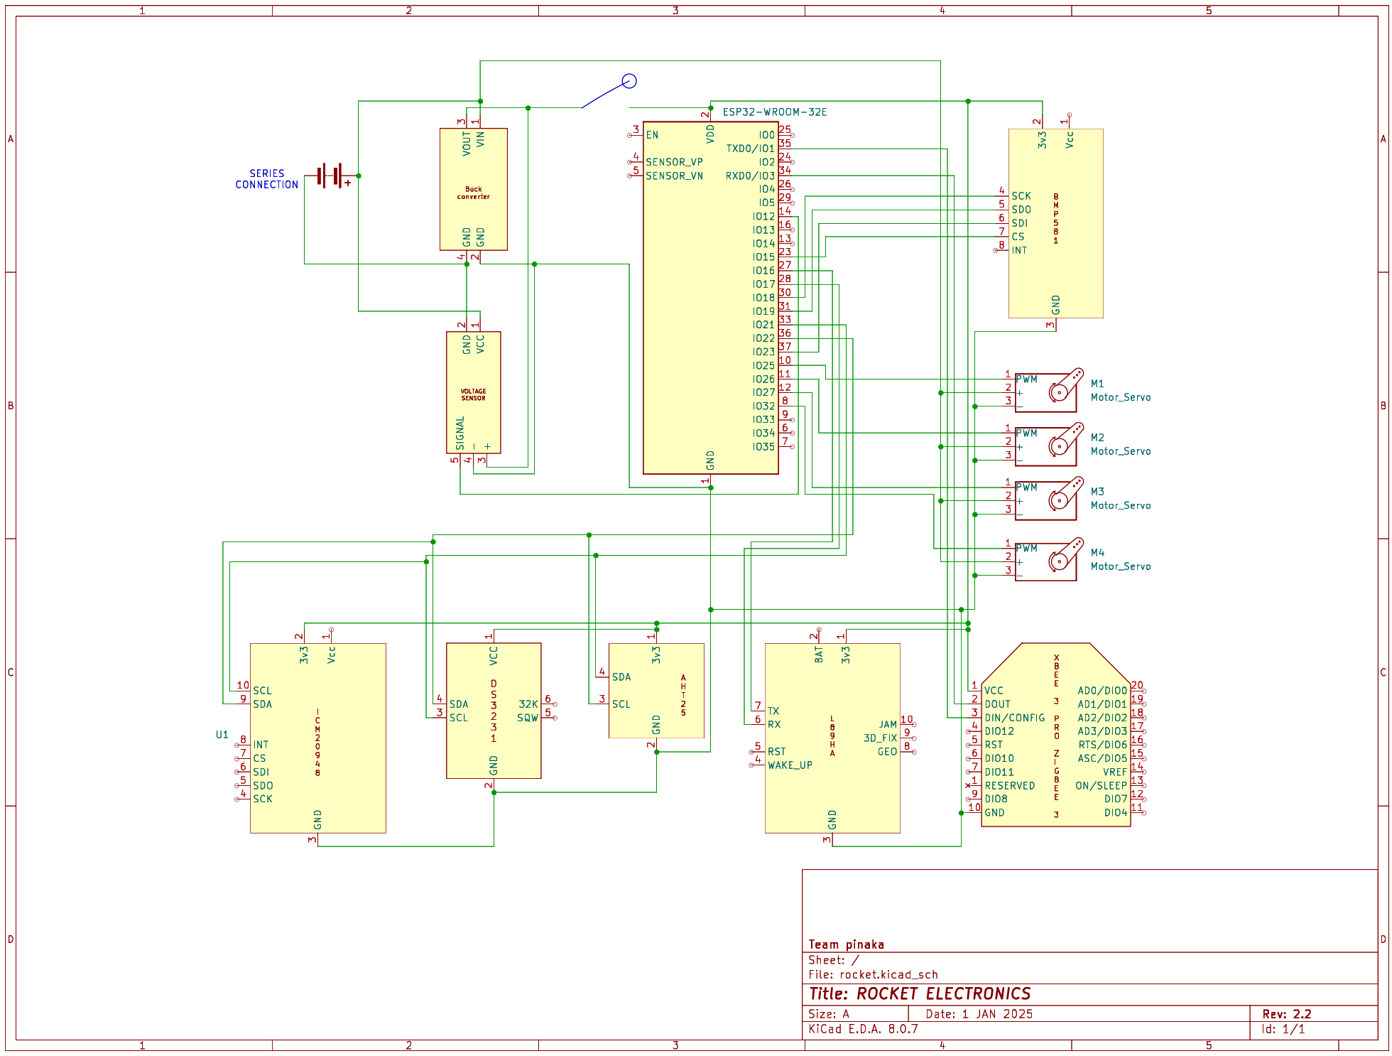
16. CAD V5/Drawings/Schematics/Rocket Avionics.png
