tar7operator/Pinaka/21.Cansat/images/Cansat.JPG

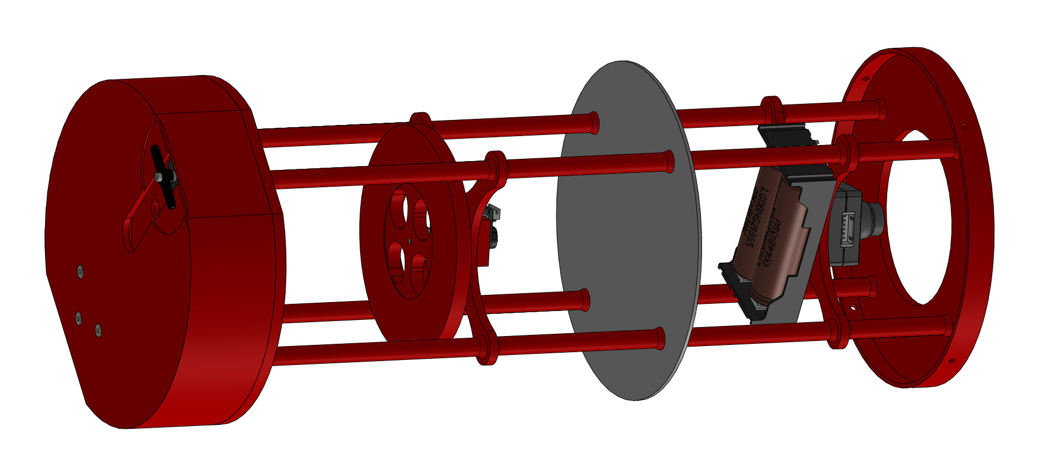
21.Cansat/images/Cansat.JPG
