tar7operator/Pinaka/1. CAD PDR -- Do not Edit!/bom v4.xlsx

ITEM NO. | PART NUMBER | DESCRIPTION | QTY.
1 | DummyCansat |  | 1
2 | TransitionZone |  | 1
3 | servoMotor |  | 4
4 | shoulder |  | 4
5 | CansatCover |  | 1
6 | Flaps |  | 1
7 | NosePlate |  | 1
8 | ISO 4762 M2.5 x 8 - 8N |  | 4
9 | bodyCover |  | 1
10 | ThrustPlate |  | 1
11 | Aerotech H148 Motor Case |  | 1
12 | Aerotech H148 Nozzle |  | 1
13 | Aerotech H148 Nozzle Nut |  | 1
14 | Aerotech H148 Top Nut |  | 1
15 | parachutePlate |  | 2
16 | Eye bolt 6mm |  | 2
17 | Rod |  | 4
18 | CenteringPlate |  | 3
19 | ISO 4762 M12 x 40 - 40N |  | 1
20 | Fin |  | 4
21 | ISO 7380 - M4 x 16 - 16N |  | 4
22 | ISO 7380 - M4 x 8 - 8N |  | 3
23 | socket button head screw_iso |  | 10
24 | ISO 7380 - M5 x 10 - 10N |  | 5
