tar7operator/Pinaka/21.Cansat/CAD V2/bom.xls

ITEM NO. | PART NUMBER | Material | Weight | QTY.
1 | BottomPlate | PET | 71 | 1 | 71
2 | ISO - 4032 - M4 - D - N |  |  | 8 | 0
3 | rod | Nylon 101 | 5 | 4 | 20
4 | Stud Spacer | PET | 3 | 4 | 12
5 | Stud Spacer | PET | 4 | 8 | 32
6 | Stud Spacer | PET | 5 | 4 | 20
7 | CameraPlate | PET | 17 | 1 | 17
8 | PCBPlate | E-Glass Fiber | 90 | 1 | 90
9 | Mechanical Plate | PET | 21 | 1 | 21
10 | HingeFlap | PET | 10 | 2 | 20
11 | Hinge Pin | Cast Carbon Steel | 2.5 | 1 | 2.5
12 | Parachute Cover | PET | 60 | 1 | 60
13 | Battery Holder ASSY V2.stp |  | 0 | 1 | 0
14 | ArduCam |  | 10 | 1 | 10
15 | M90S_ali.step |  | 14 | 1 | 14
16 | bidirectional shoulder.step |  |  | 1 | 0
17 | N20 MOTOR |  | 12 | 1 | 12
18 | Reaction wheel | PET | 60 | 1 | 60
19 | ISO 4762 M2 x 6 - 6N |  |  | 3 | 0
20 | ISO 7046-1 - M3 x 8 - Z - 8N |  |  | 3 | 0
22 | countersunk flat head cross recess screw_iso |  |  | 3 | 0
23 | Parachute Bay V2 | PET | 44 | 1 | 44
24 | Parachute pate v2 | PET | 108 | 1 | 108
 | Body Cover | PET | 115 | 1 | 115
 |  |  |  |  | 728.5
 |  |  |  |  | 160
 |  |  |  |  | 120
 |  |  |  |  | 20
 |  |  |  |  | 90
 |  |  |  |  | 1118.5
