tar7operator/Pinaka/10.FEA/Rocket/Body Assembly/800N/Body Assembly.STEP

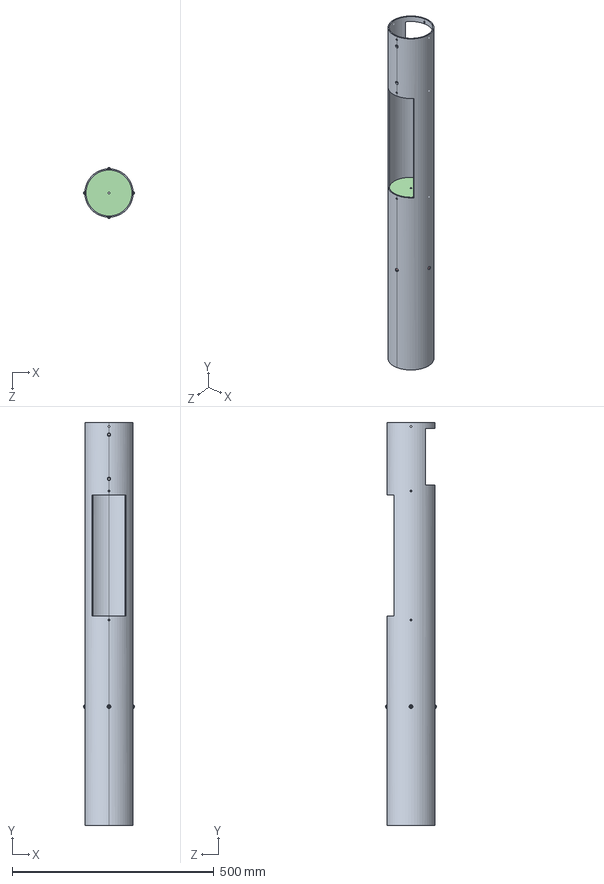
[picture p169: CAD file, 2025-01-08]
10.FEA/Rocket/Body Assembly/800N/Body Assembly.STEP
125.5 x 1000.0 x 125.5 mm
BodyTube
Thrust Plate
Centering Ring x 2
Bottom Parachute Plate x 2
M5 12MM HEX HEAD_97763A821 x 4
