tar7operator/Pinaka/10.FEA/Rocket/BodyCover/Body AssemblyFEA.STEP

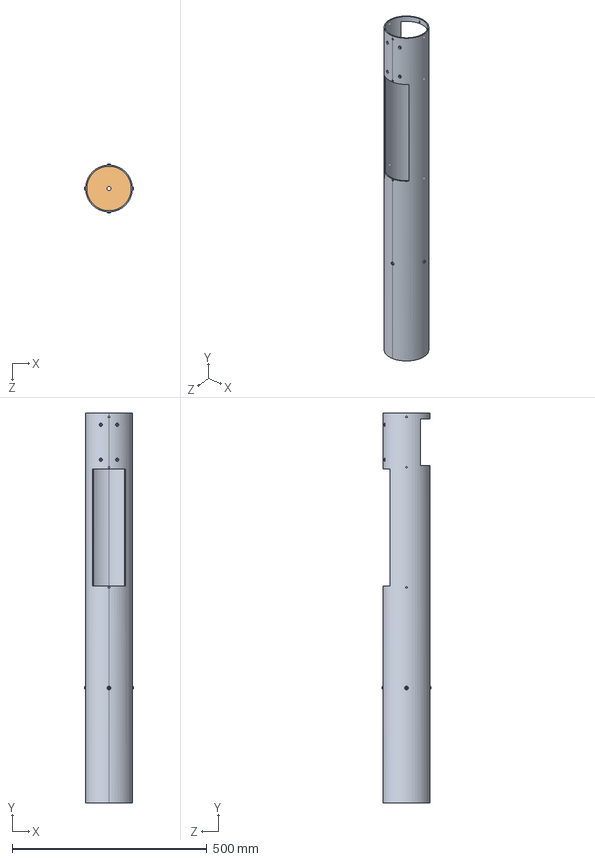
[picture p170: CAD file, 2025-01-04]
10.FEA/Rocket/BodyCover/Body AssemblyFEA.STEP
125.5 x 1000.0 x 125.5 mm
BodyTube
Thrust Plate
M5 12mm_91239A228 x 4
