tar7operator/Pinaka/10.FEA/Rocket/PayloadBay/NoseConeAssemblyV2.STEP

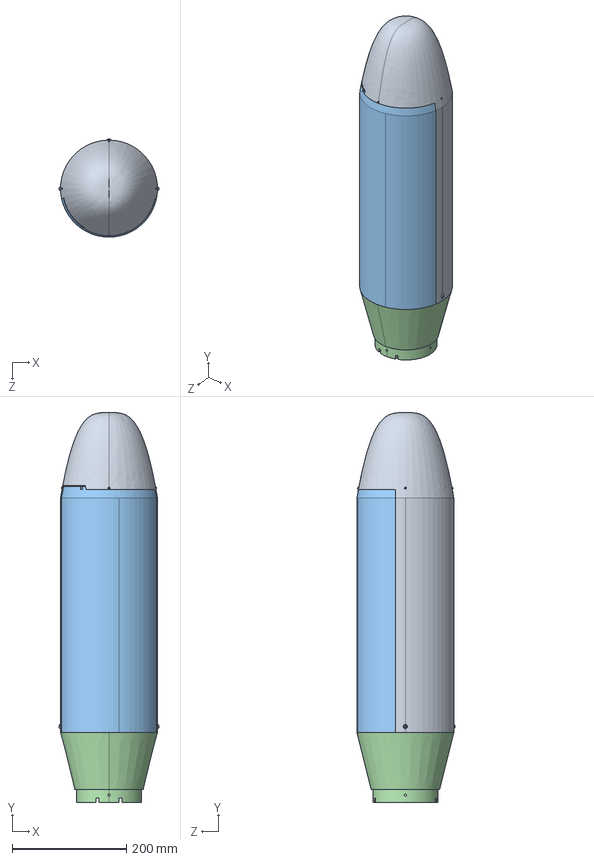
[picture p171: CAD file, 2025-01-02]
10.FEA/Rocket/PayloadBay/NoseConeAssemblyV2.STEP
174.4 x 683.0 x 172.2 mm
NoseCone
NosePlate
NoseConeCover
Transition Cone
M2 Head Hex_91239A706 x 4
M4 10MM_91239A144 x 3
