tar7operator/Pinaka/11. CFD/Parachute/CansatMain/simscale/Test 1/Main2.4m2.IGS

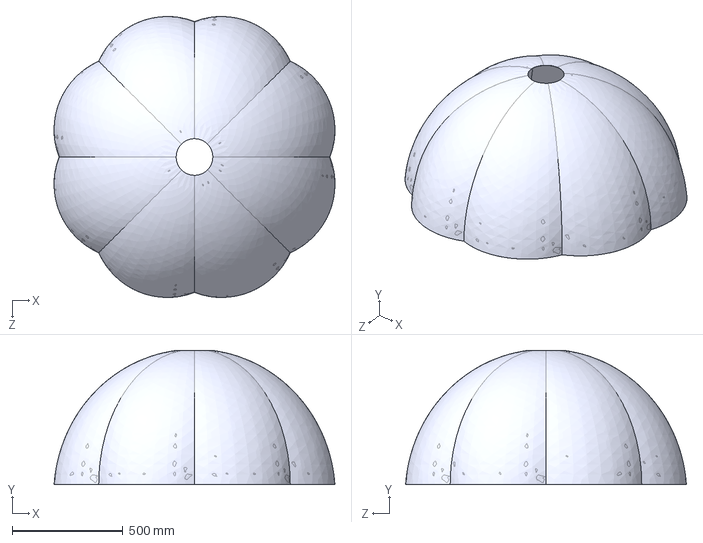
[picture p172: CAD file, 2024-12-22]
11. CFD/Parachute/CansatMain/simscale/Test 1/Main2.4m2.IGS
1270.5 x 607.1 x 1270.5 mm
