tar7operator/Pinaka/11. CFD/Parachute/CansatMain/v1/Main.STEP

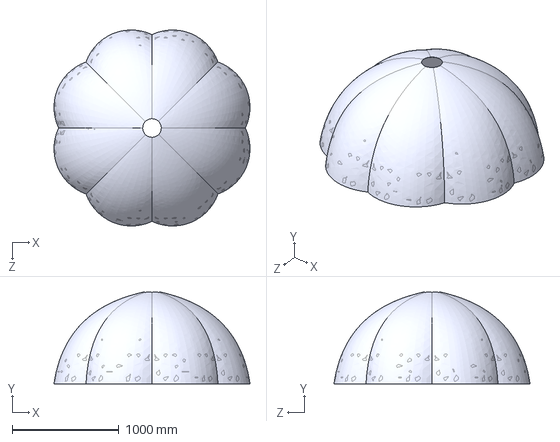
[picture p173: CAD file, 2024-12-22]
11. CFD/Parachute/CansatMain/v1/Main.STEP
1833.3 x 856.3 x 1833.3 mm
