tar7operator/Pinaka/11. CFD/Parachute/Rocketmain/RockMain.SLDPRT

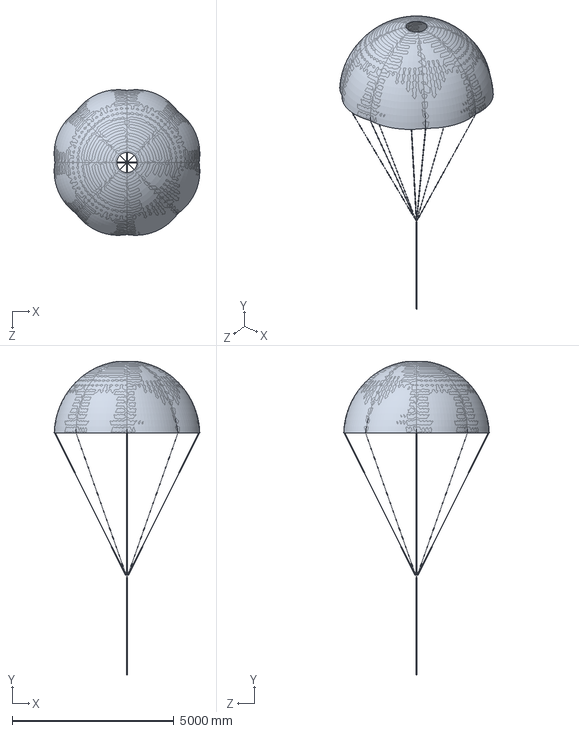
[picture p174: CAD file, 2025-01-15]
11. CFD/Parachute/Rocketmain/RockMain.SLDPRT
4505.8 x 9684.2 x 4505.8 mm
