tar7operator/Pinaka/11. CFD/Whole Body/Transition 100mm/cfdbody_10cm_Transition.SLDASM

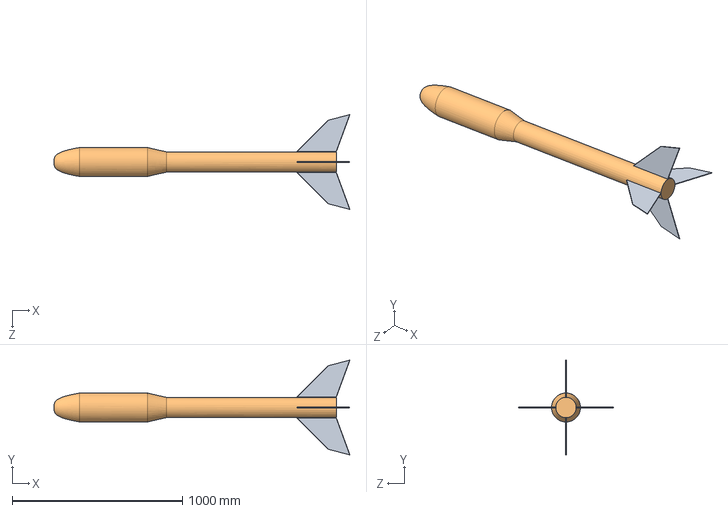
[picture p175: CAD file, 2024-12-22]
11. CFD/Whole Body/Transition 100mm/cfdbody_10cm_Transition.SLDASM
1740.0 x 558.0 x 558.0 mm
Fin x 4
