tar7operator/Pinaka/11. CFD/Whole Body/Transition 120cm/cfdbody_12cm_Transition.SLDASM

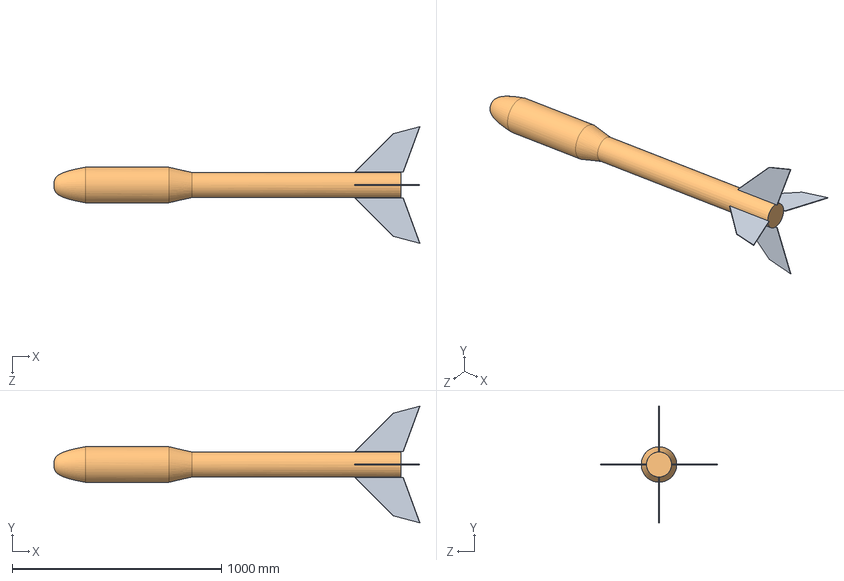
[picture p176: CAD file, 2024-12-22]
11. CFD/Whole Body/Transition 120cm/cfdbody_12cm_Transition.SLDASM
1750.0 x 558.0 x 558.0 mm
Fin x 4
