tar7operator/Pinaka/11. CFD/Parachute/CansatMain/sheetMain.SLDPRT

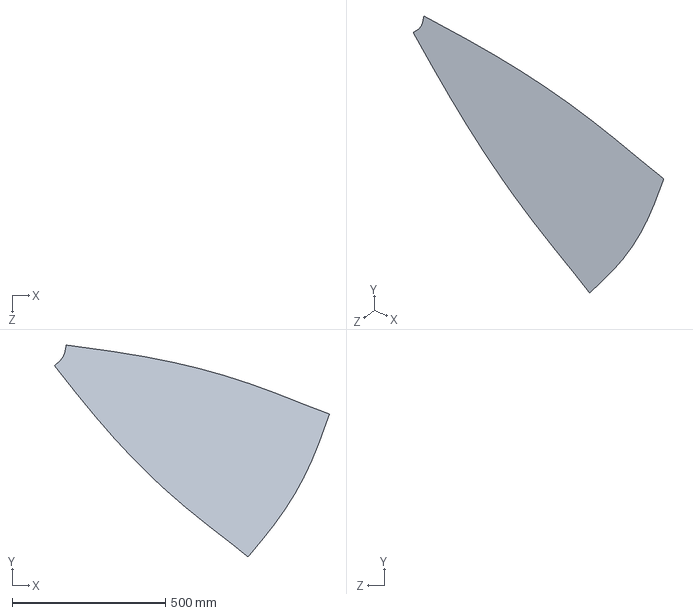
[picture p177: CAD file, 2024-12-22]
11. CFD/Parachute/CansatMain/sheetMain.SLDPRT
896.4 x 690.5 x 0 mm
