tar7operator/Pinaka/10.FEA/Rocket/Parachute Plate/Bottom Parachute Plate Assembly V2.IGS

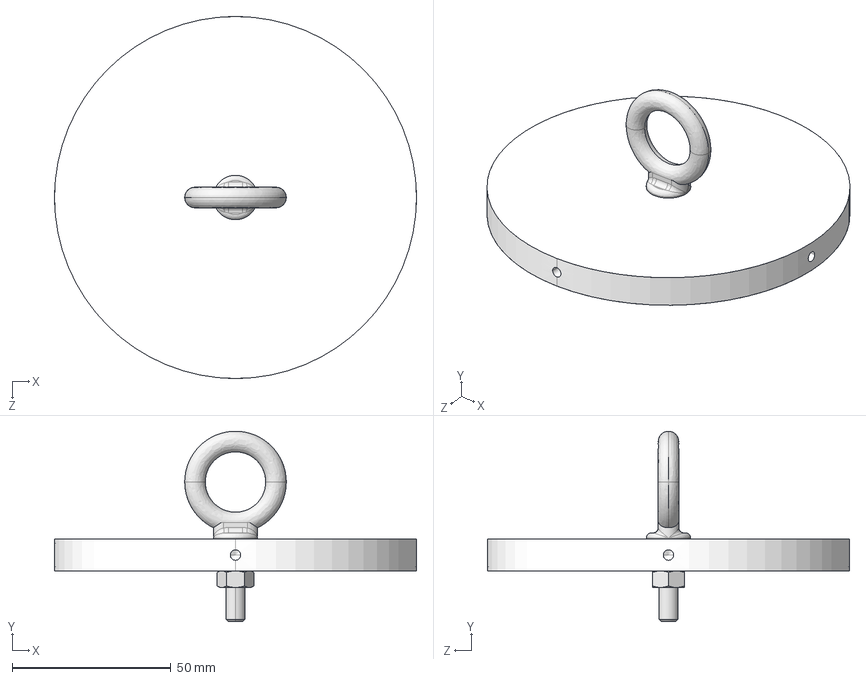
[picture p178: CAD file, 2024-12-30]
10.FEA/Rocket/Parachute Plate/Bottom Parachute Plate Assembly V2.IGS
114.0 x 60.0 x 114.0 mm
