tar7operator/Pinaka/10.FEA/Rocket/Parachute Plate/Bottom Parachute Plate Assembly V2 - M8.IGS

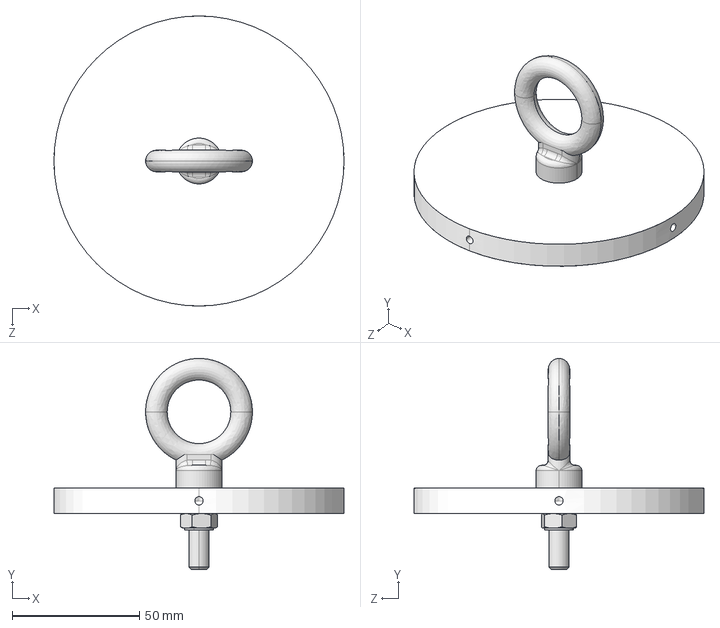
[picture p179: CAD file, 2024-12-30]
10.FEA/Rocket/Parachute Plate/Bottom Parachute Plate Assembly V2 - M8.IGS
114.0 x 83.0 x 114.0 mm
