tar7operator/Pinaka/21.Cansat/CAD V2/Battery Holder ASSY V2.stp

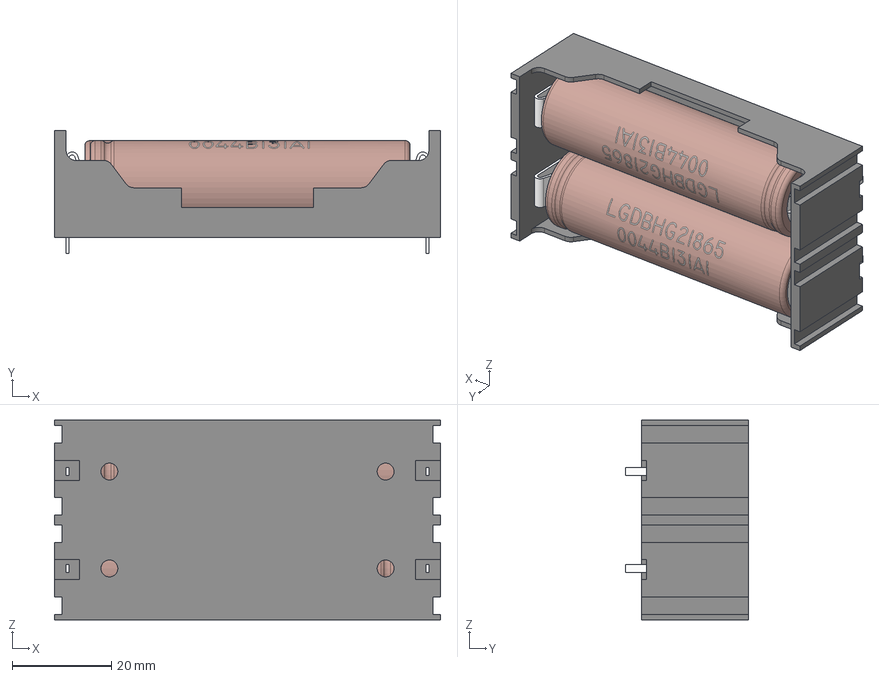
[picture p180: CAD file, 2024-12-27]
21.Cansat/CAD V2/Battery Holder ASSY V2.stp
77.7 x 24.7 x 40.2 mm
Battery Holder
18650 Battery x 2
