tar7operator/Pinaka/0. 3D Printing/Fin.SLDPRT

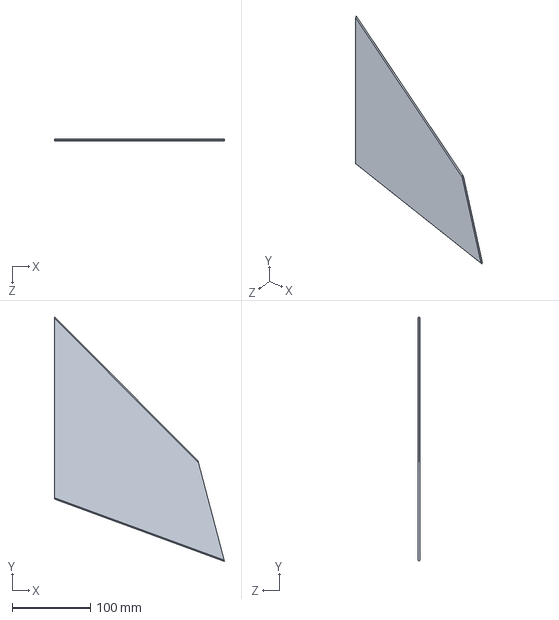
[picture p181: CAD file, 2025-02-16]
0. 3D Printing/Fin.SLDPRT
218.0 x 314.0 x 3.00 mm
