tar7operator/Pinaka/1. CAD PDR -- Do not Edit!/Accesories/m5 x 12 hex button hd.STEP

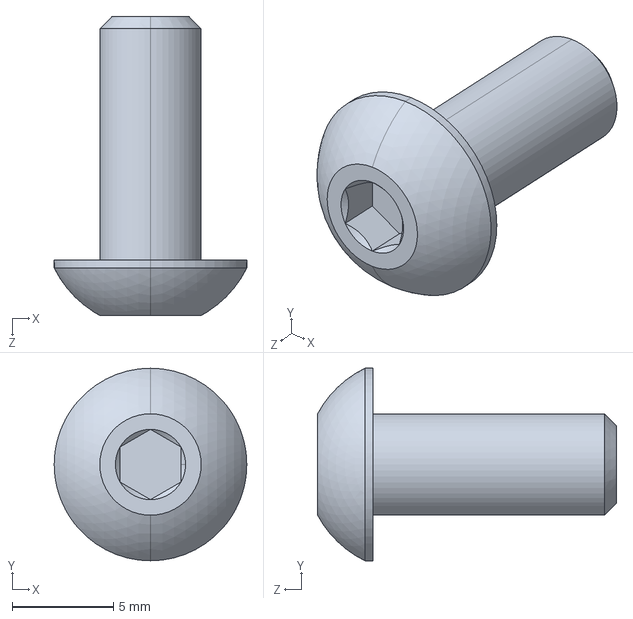
[picture p182: CAD file, 2024-09-30]
1. CAD PDR -- Do not Edit!/Accesories/m5 x 12 hex button hd.STEP
9.50 x 9.50 x 14.8 mm
