tar7operator/Pinaka/1. CAD PDR -- Do not Edit!/CenteringPlate.SLDPRT

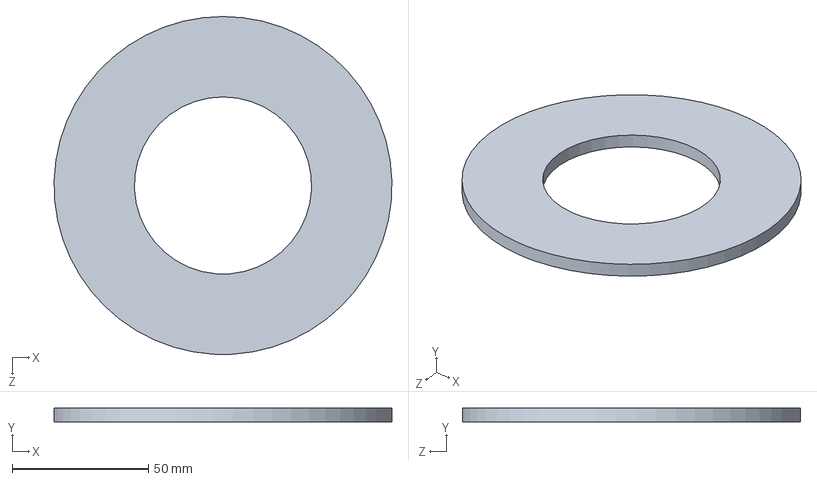
[picture p183: CAD file, 2024-11-28]
1. CAD PDR -- Do not Edit!/CenteringPlate.SLDPRT
123.9 x 5.00 x 124.0 mm
