tar7operator/Pinaka/1. CAD PDR -- Do not Edit!/Electronics/Electronics Tray.SLDPRT

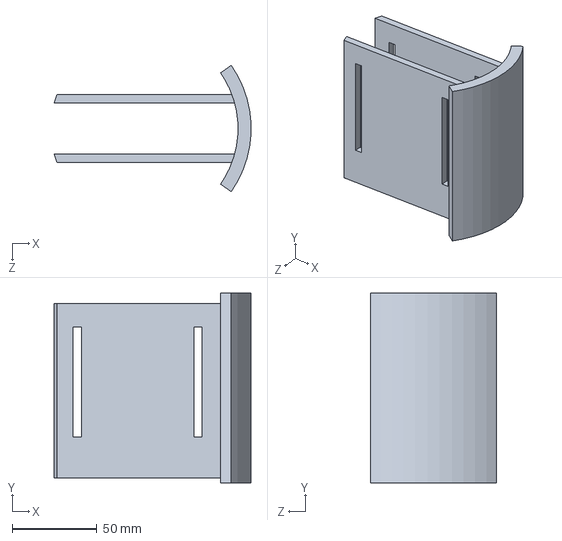
[picture p184: CAD file, 2024-11-02]
1. CAD PDR -- Do not Edit!/Electronics/Electronics Tray.SLDPRT
116.3 x 112.0 x 74.6 mm
