tar7operator/Pinaka/1. CAD PDR -- Do not Edit!/Hinge/HingeRelay.SLDPRT

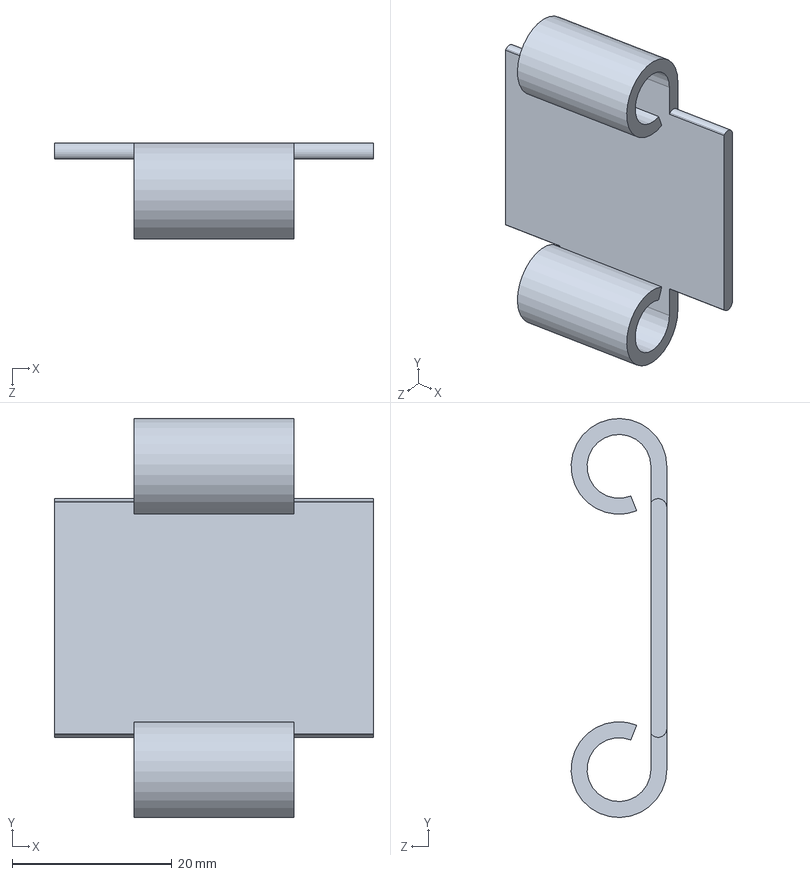
[picture p185: CAD file, 2024-09-27]
1. CAD PDR -- Do not Edit!/Hinge/HingeRelay.SLDPRT
40.0 x 50.0 x 12.0 mm
