tar7operator/Pinaka/1. CAD PDR -- Do not Edit!/NoseCone/NoseCone.SLDPRT

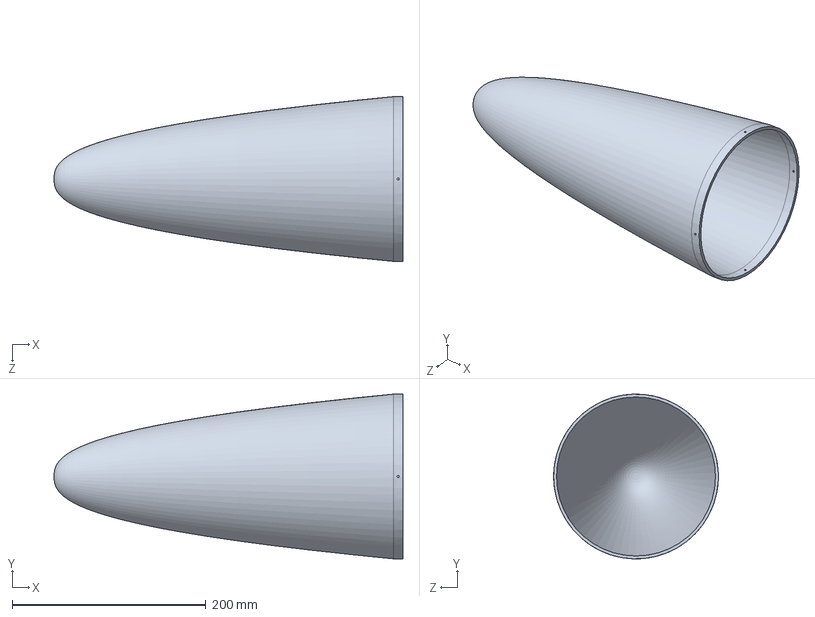
[picture p186: CAD file, 2024-09-27]
1. CAD PDR -- Do not Edit!/NoseCone/NoseCone.SLDPRT
360.0 x 170.0 x 170.0 mm
