tar7operator/Pinaka/1. CAD PDR -- Do not Edit!/STL/Payload Bay bulk head.STL

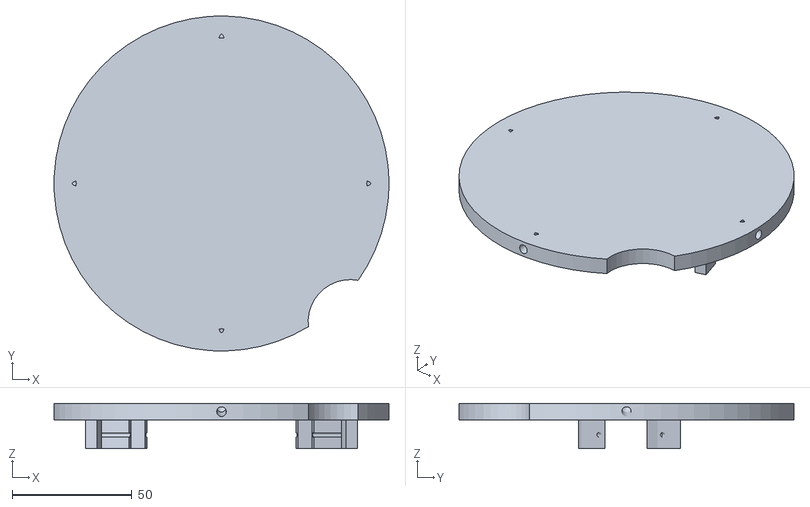
[picture p187: CAD file, 2024-11-05]
1. CAD PDR -- Do not Edit!/STL/Payload Bay bulk head.STL
140.0 x 140.0 x 19.0
