tar7operator/Pinaka/10.FEA/Rocket/Nose Cone/Nose Cone V2.IGS

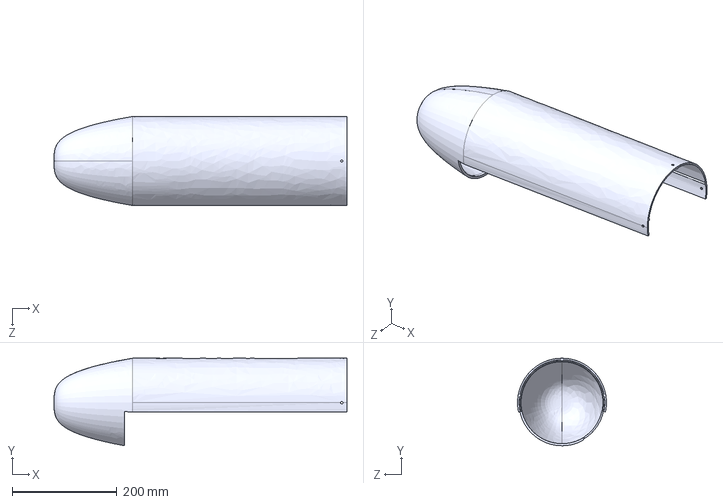
[picture p188: CAD file, 2025-01-01]
10.FEA/Rocket/Nose Cone/Nose Cone V2.IGS
560.0 x 167.4 x 170.0 mm
