tar7operator/Pinaka/10.FEA/Rocket/Thrust Plate/Thrust Plate V2 12mm 1mm extension.IGS

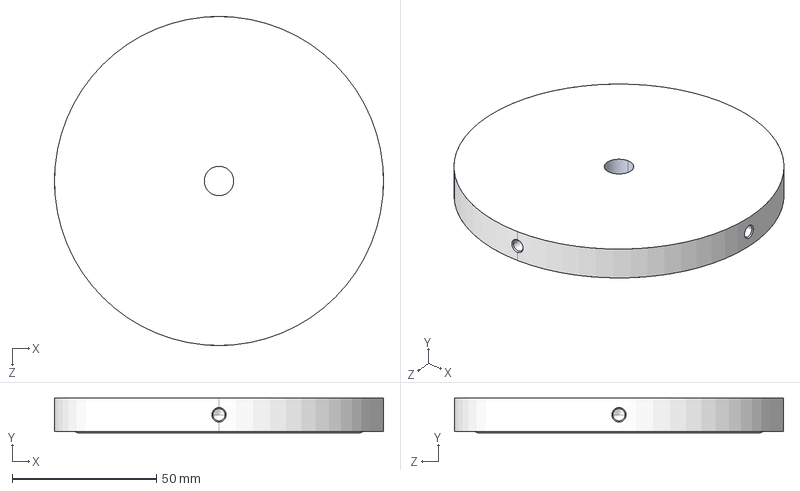
[picture p189: CAD file, 2024-12-30]
10.FEA/Rocket/Thrust Plate/Thrust Plate V2 12mm 1mm extension.IGS
114.0 x 12.0 x 114.0 mm
