tar7operator/Pinaka/10.FEA/Rocket/Transition Zone/Transition Cone.IGS

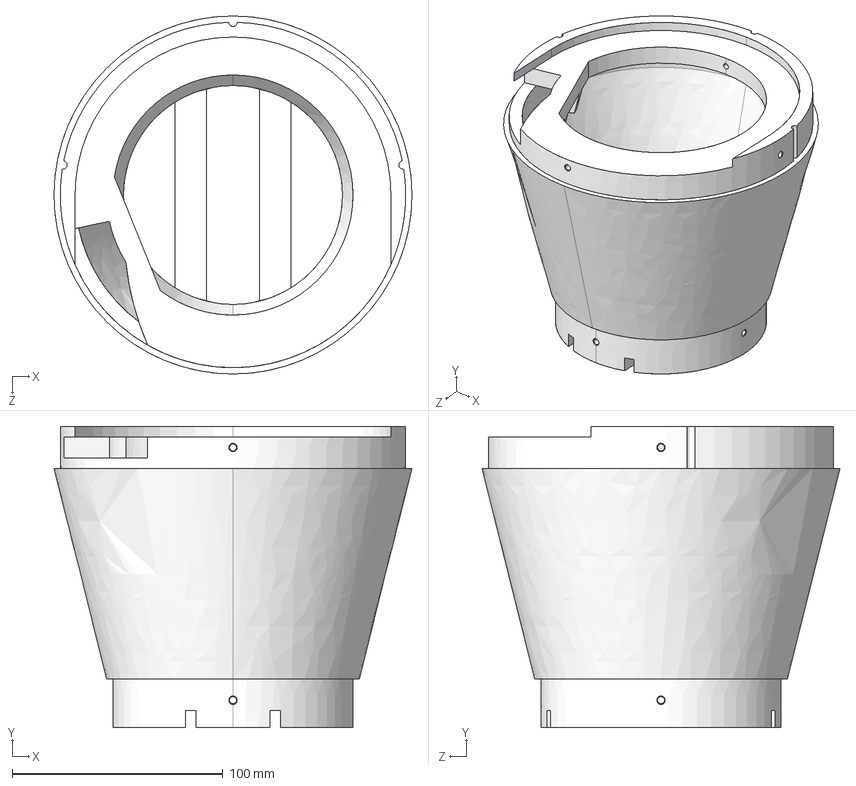
[picture p190: CAD file, 2025-01-01]
10.FEA/Rocket/Transition Zone/Transition Cone.IGS
170.0 x 143.0 x 170.0 mm
