tar7operator/Pinaka/11. CFD/Parachute/CansatMain/shouds.SLDPRT

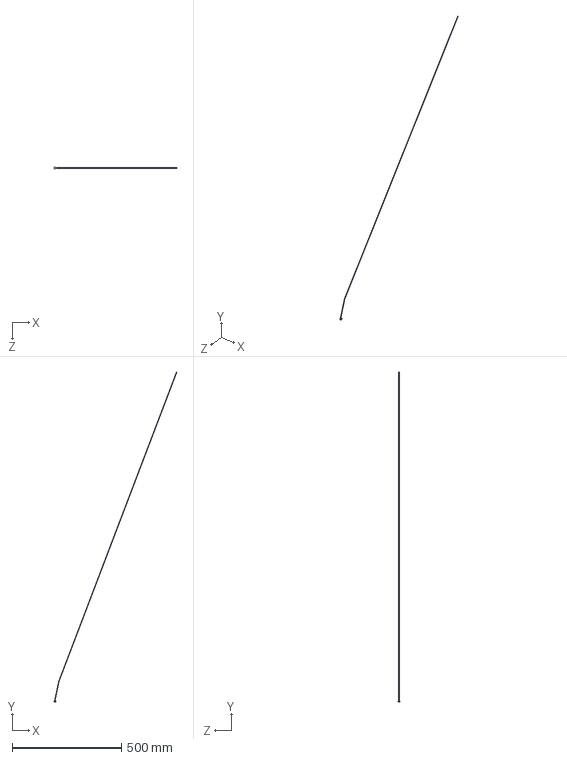
[picture p191: CAD file, 2025-01-08]
11. CFD/Parachute/CansatMain/shouds.SLDPRT
561.9 x 1510.4 x 8.00 mm
