tar7operator/Pinaka/11. CFD/Parachute/Drogue/Flat Drogue.SLDPRT

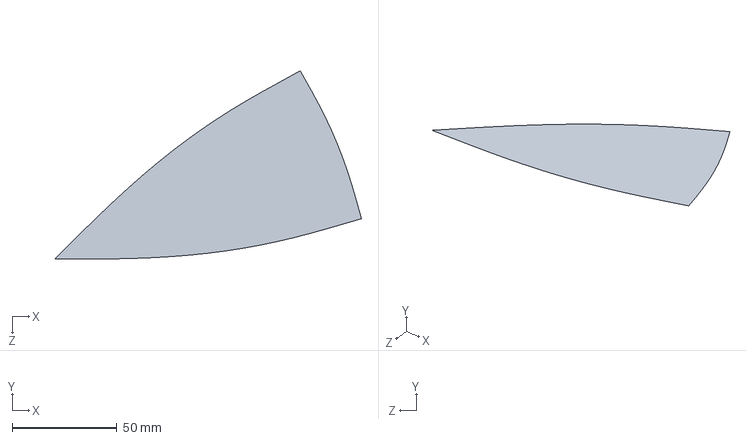
[picture p192: CAD file, 2024-12-22]
11. CFD/Parachute/Drogue/Flat Drogue.SLDPRT
146.2 x 0 x 89.8 mm
