tar7operator/Pinaka/11. CFD/Whole Body/Fin.SLDPRT

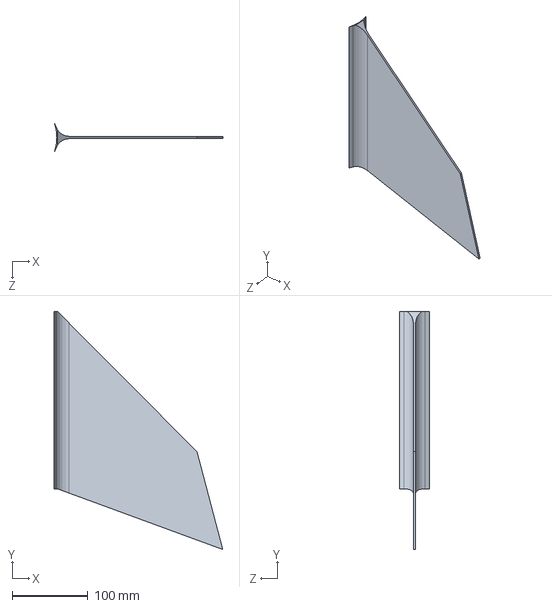
[picture p193: CAD file, 2024-12-22]
11. CFD/Whole Body/Fin.SLDPRT
222.4 x 314.0 x 40.0 mm
