tar7operator/Pinaka/11. CFD/Whole Body/Transition 5 cm 130mm/cfdbody5deg.IGS

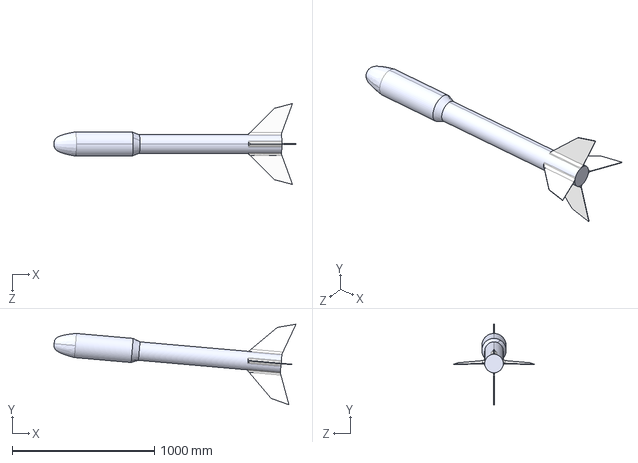
[picture p194: CAD file, 2024-12-22]
11. CFD/Whole Body/Transition 5 cm 130mm/cfdbody5deg.IGS
1699.2 x 565.8 x 568.0 mm
