tar7operator/Pinaka/16. CAD V5/Body Assembly/BodyTube.SLDPRT

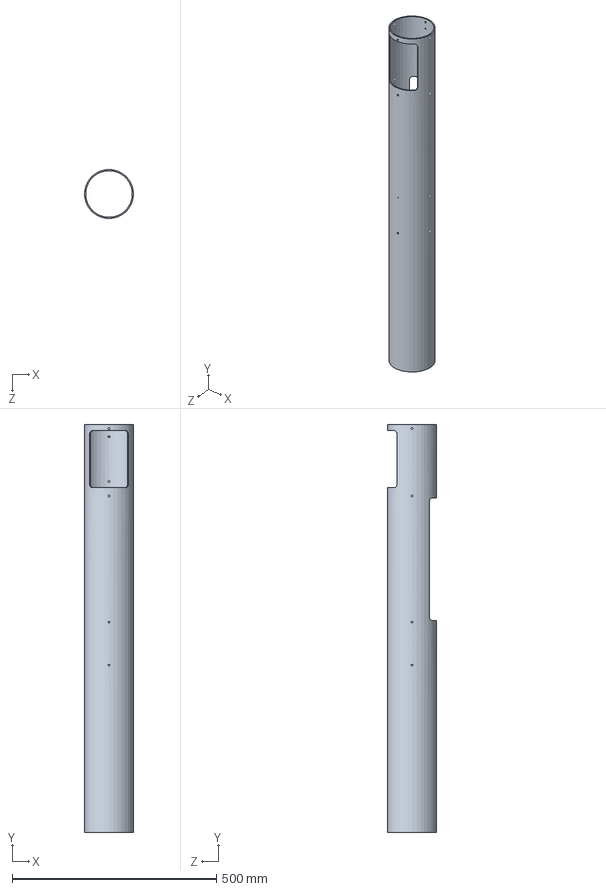
[picture p195: CAD file, 2025-05-20]
16. CAD V5/Body Assembly/BodyTube.SLDPRT
120.0 x 1000.0 x 120.0 mm
