tar7operator/Pinaka/16. CAD V5/CanSat/CanSat.SLDPRT

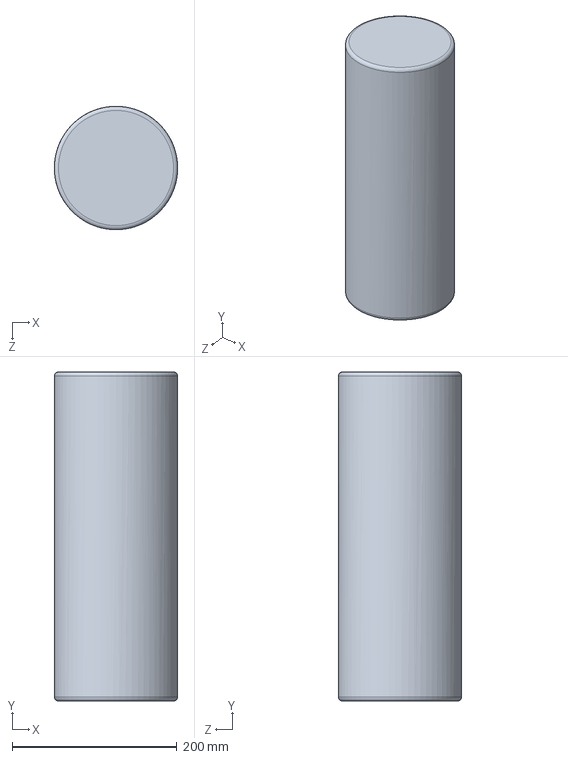
[picture p196: CAD file, 2024-12-22]
16. CAD V5/CanSat/CanSat.SLDPRT
150.0 x 400.0 x 150.0 mm
