tar7operator/Pinaka/16. CAD V5/Common/M90/MG90S_arm01.SLDPRT

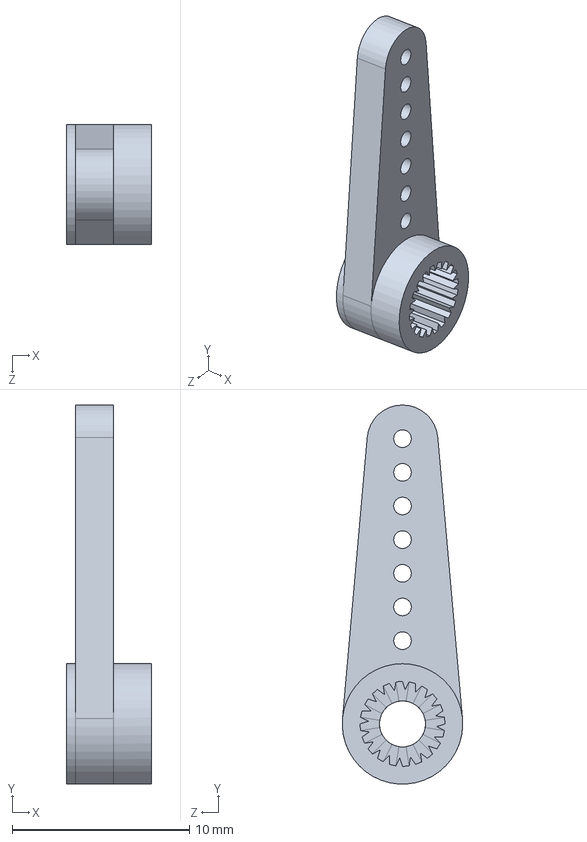
[picture p197: CAD file, 2025-01-15]
16. CAD V5/Common/M90/MG90S_arm01.SLDPRT
4.80 x 21.4 x 6.80 mm
