tar7operator/Pinaka/16. CAD V5/Electronics Bay Assembly/Electronics Mount.SLDPRT

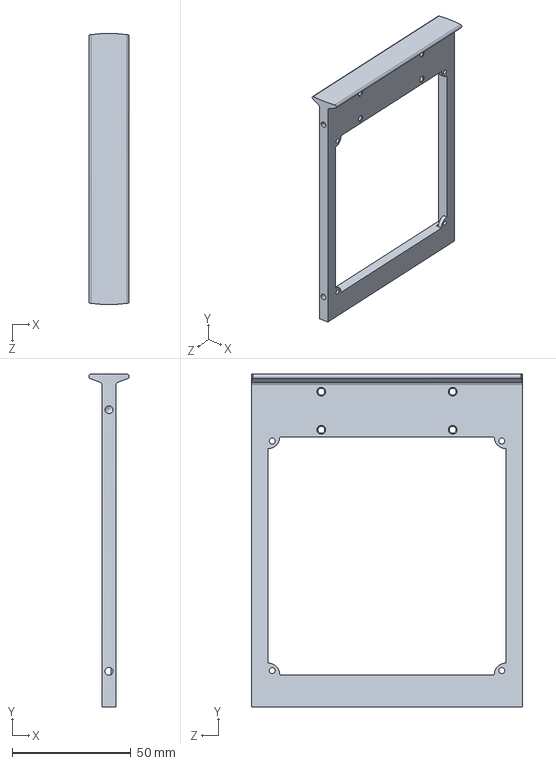
[picture p198: CAD file, 2025-05-20]
16. CAD V5/Electronics Bay Assembly/Electronics Mount.SLDPRT
17.0 x 140.0 x 114.0 mm
