tar7operator/Pinaka/16. CAD V5/Electronics Bay Assembly/Electronics/3.3V mini buck converter/DD0503MA Ultra Mini DC 3.7v 4.5v 5v to 3.3v DC DC Step Down Converter Buck Module.STEP

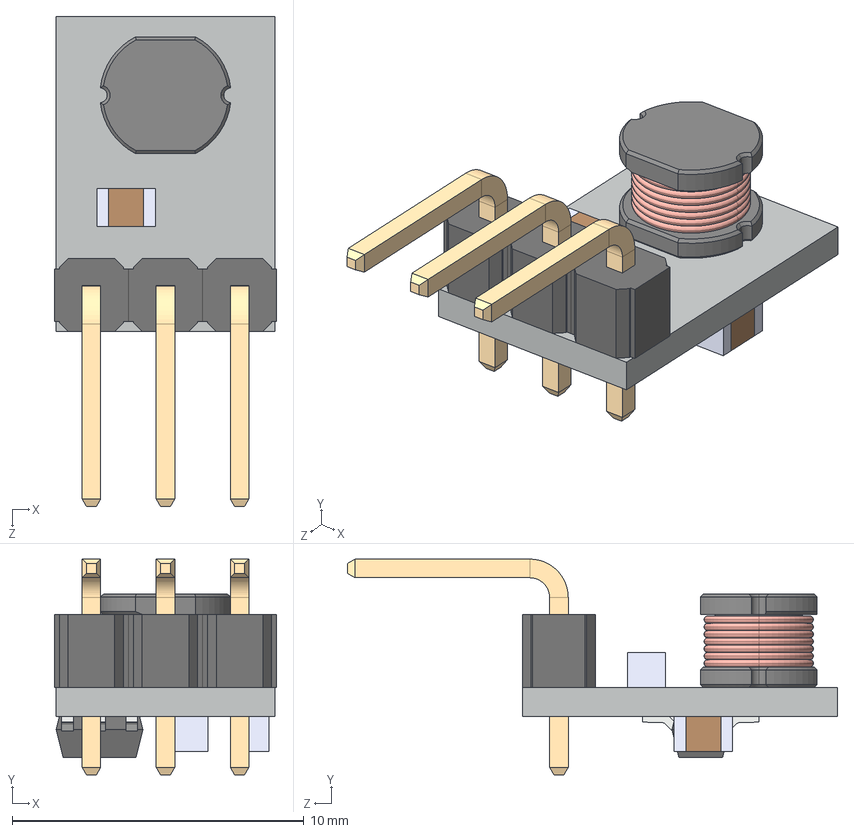
[picture p199: CAD file, 2024-12-22]
16. CAD V5/Electronics Bay Assembly/Electronics/3.3V mini buck converter/DD0503MA Ultra Mini DC 3.7v 4.5v 5v to 3.3v DC DC Step Down Converter Buck Module.STEP
7.62 x 7.40 x 16.8 mm
PCB, DD0503MA ULTRA MINI DC 3.7V 4.5V 5V TO 3.3V DC DC STEP DOWN CONVERTER BUCK MODULE
SMD RESISTOR, DD0503MA ULTRA MINI DC 3.7V 4.5V 5V TO 3.3V DC DC STEP DOWN CONVERTER BUCK MODULE x 3
PIN HEADER, 1X3, 2.54 mm, DD0503MA ULTRA MINI DC 3.7V 4.5V 5V TO 3.3V DC DC STEP DOWN CONVERTER BUCK MODULE
6R8 SMD INDUCTOR, DD0503MA ULTRA MINI DC 3.7V 4.5V 5V TO 3.3V DC DC STEP DOWN CONVERTER BUCK MODULE
MICRO REG, DD0503MA ULTRA MINI DC 3.7V 4.5V 5V TO 3.3V DC DC STEP DOWN CONVERTER BUCK MODULE
