tar7operator/Pinaka/16. CAD V5/Electronics Bay Assembly/Electronics/JST-XH-2-54mm connectors/SMD Horizontal/JST - XH - SMD (R) - 8Pin - 2.54mm.stp

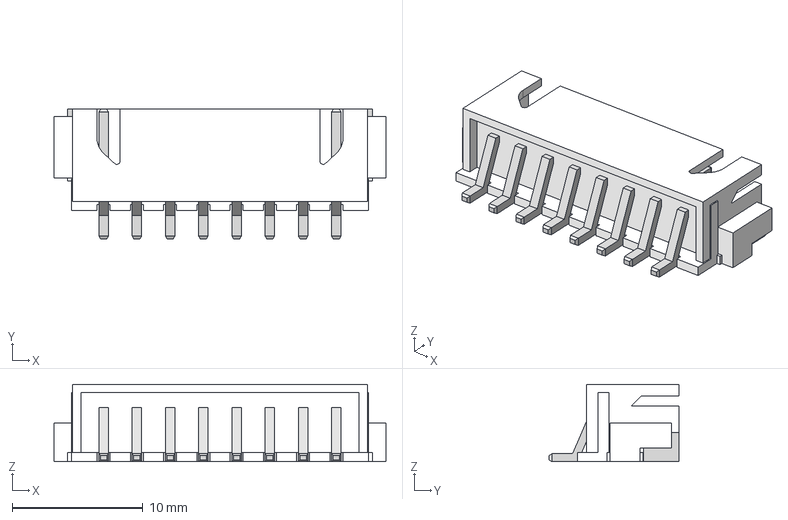
[picture p200: CAD file, 2025-01-05]
16. CAD V5/Electronics Bay Assembly/Electronics/JST-XH-2-54mm connectors/SMD Horizontal/JST - XH - SMD (R) - 8Pin - 2.54mm.stp
25.4 x 9.91 x 5.92 mm
