tar7operator/Pinaka/16. CAD V5/Electronics Bay Assembly/Electronics/JST-XH-2-54mm connectors/Thru Vertical/JST - XH - Thru (V) - 16Pin - 2.54mm.stp

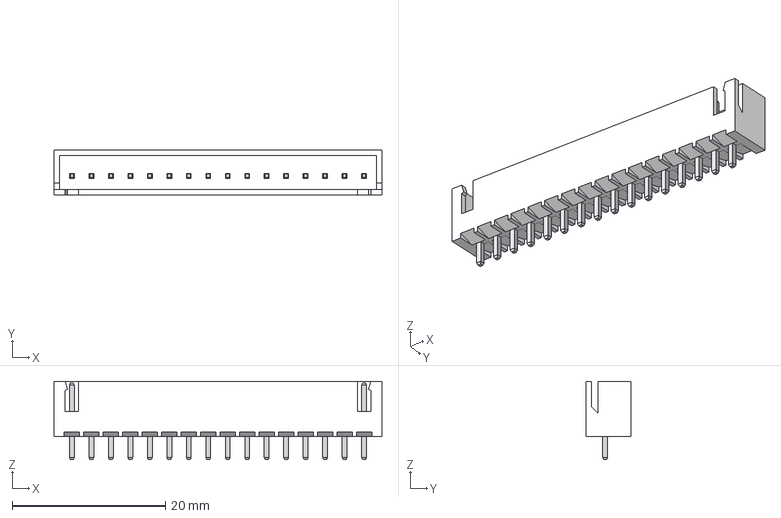
[picture p202: CAD file, 2025-01-05]
16. CAD V5/Electronics Bay Assembly/Electronics/JST-XH-2-54mm connectors/Thru Vertical/JST - XH - Thru (V) - 16Pin - 2.54mm.stp
42.8 x 5.84 x 10.2 mm
