tar7operator/Pinaka/16. CAD V5/Electronics Bay Assembly/Electronics/Pin Header Female 2-54/11-Pin Header - Female - 2.54mm.step

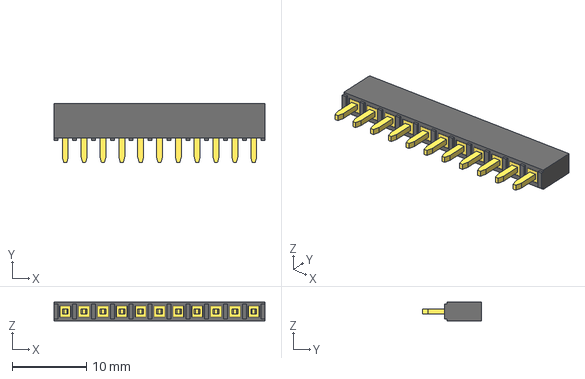
[picture p203: CAD file, 2025-01-05]
16. CAD V5/Electronics Bay Assembly/Electronics/Pin Header Female 2-54/11-Pin Header - Female - 2.54mm.step
28.4 x 8.00 x 2.50 mm
