tar7operator/Pinaka/16. CAD V5/Parachute Assembly/Bottom Parachute Plate.SLDPRT

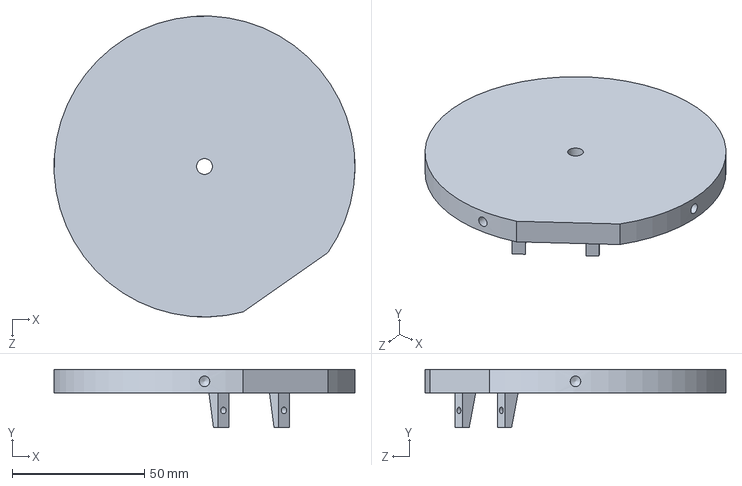
[picture p204: CAD file, 2025-05-20]
16. CAD V5/Parachute Assembly/Bottom Parachute Plate.SLDPRT
114.0 x 22.0 x 114.0 mm
