tar7operator/Pinaka/16. CAD V5/Payload Assembly/Transition Cone.SLDPRT

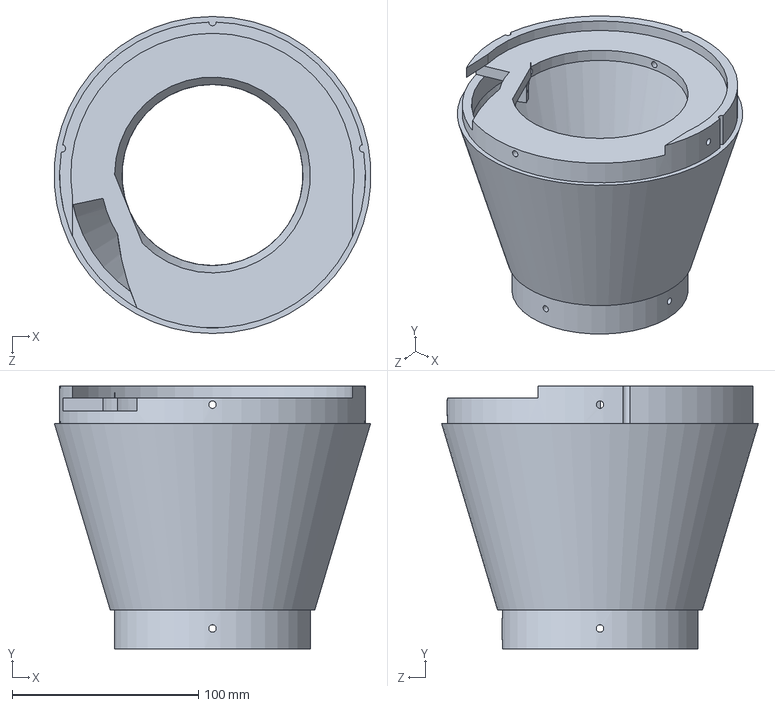
[picture p205: CAD file, 2025-02-16]
16. CAD V5/Payload Assembly/Transition Cone.SLDPRT
169.7 x 141.0 x 170.0 mm
