tar7operator/Pinaka/16. CAD V5/Payload Assembly/V2/NoseCone.SLDPRT

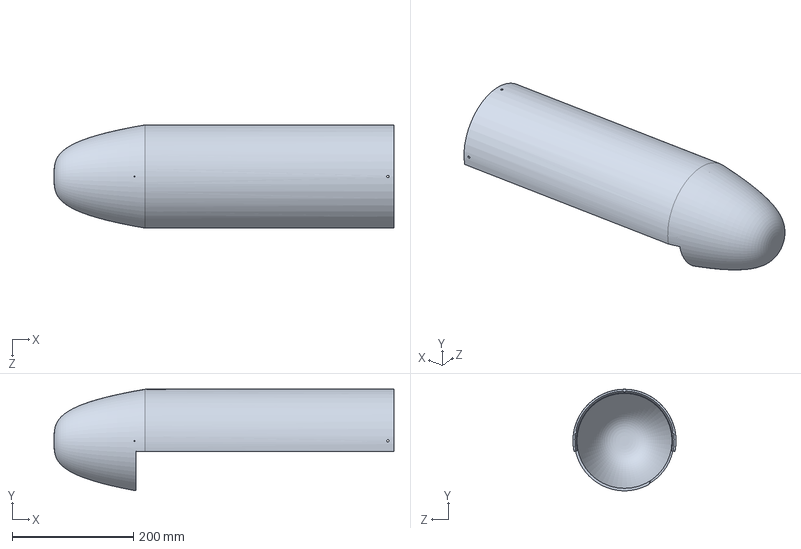
[picture p206: CAD file, 2025-05-20]
16. CAD V5/Payload Assembly/V2/NoseCone.SLDPRT
560.0 x 167.2 x 170.0 mm
