tar7operator/Pinaka/16. CAD V5/Profile.SLDPRT

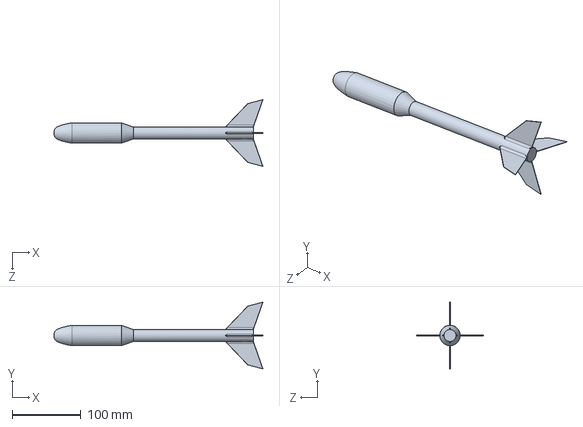
[picture p207: CAD file, 2025-01-30]
16. CAD V5/Profile.SLDPRT
304.8 x 97.4 x 97.4 mm
