tar7operator/Pinaka/16. CAD V5/Rocket Motor Assembly/ThrustTech/Nozzle.SLDPRT

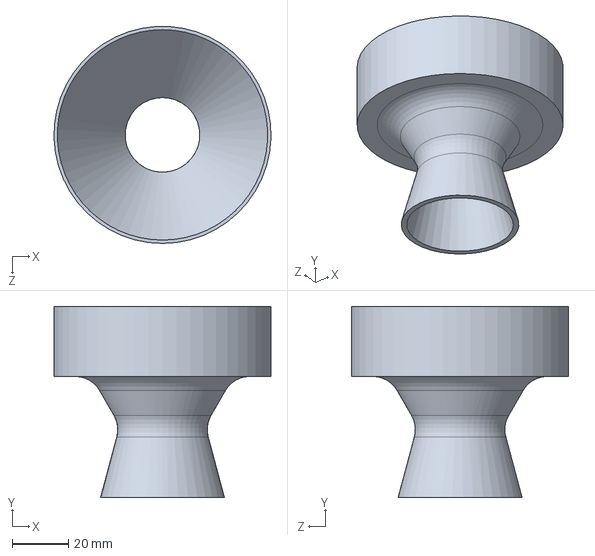
[picture p208: CAD file, 2025-05-20]
16. CAD V5/Rocket Motor Assembly/ThrustTech/Nozzle.SLDPRT
77.4 x 68.2 x 77.3 mm
