tar7operator/Pinaka/16. CAD V5/Simulation/Simulation.STEP

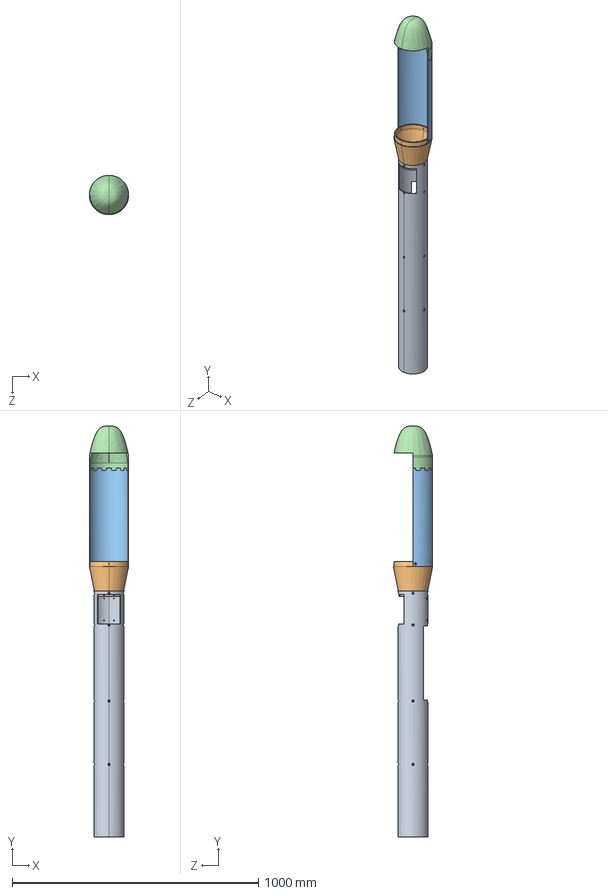
[picture p209: CAD file, 2024-12-27]
16. CAD V5/Simulation/Simulation.STEP
160.0 x 1670.0 x 160.0 mm
BodyTube
Tansition Cone
Payload Body
Nose Cone
Thrust Plate
CSK_ISO 7046-1 - M4 x 10 - Z - 10N x 7
CSK_ISO 7046-1 - M5 x 10 - Z - 10N x 4
