tar7operator/Pinaka/16. CAD V5/STL/Transition Cone.STL

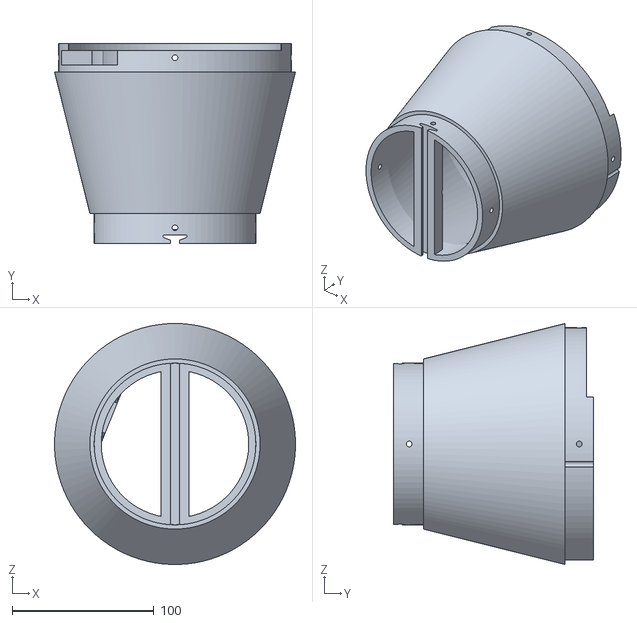
[picture p210: CAD file, 2025-05-20]
16. CAD V5/STL/Transition Cone.STL
170.0 x 141.0 x 170.0
