tar7operator/Pinaka/16. CAD V5/Tools, Jigs, Fixtures, Templates/R-18 Fillet Tool.STL

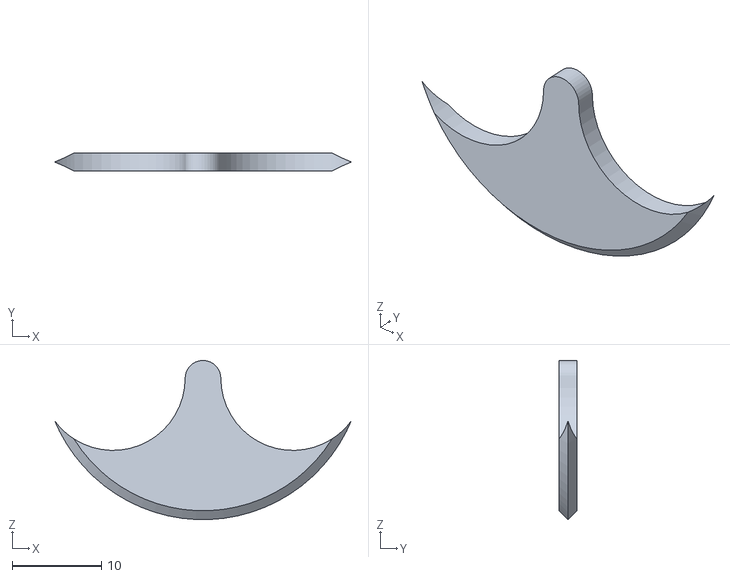
[picture p211: CAD file, 2024-12-24]
16. CAD V5/Tools, Jigs, Fixtures, Templates/R-18 Fillet Tool.STL
33.3 x 2.00 x 17.8
