tar7operator/Pinaka/16. ST-CAD V4/ST-Electronics bay.SLDPRT

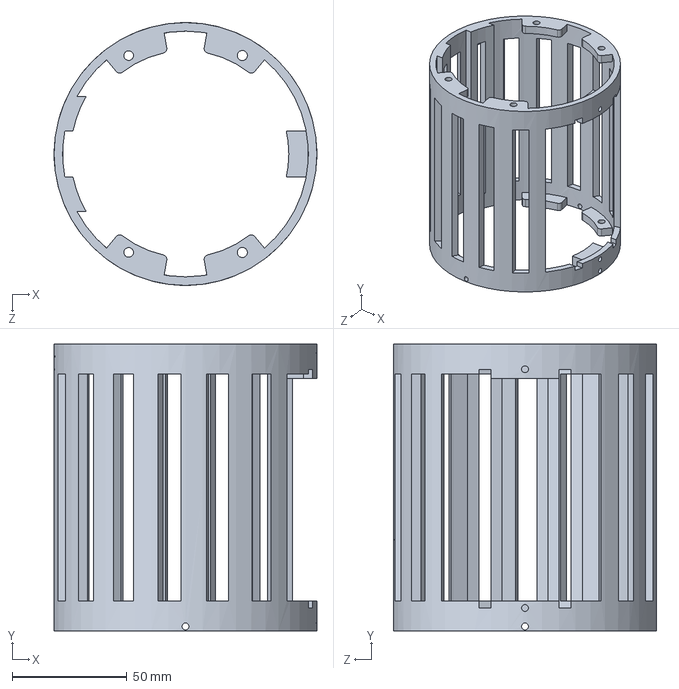
[picture p212: CAD file, 2024-11-29]
16. ST-CAD V4/ST-Electronics bay.SLDPRT
114.5 x 125.0 x 114.5 mm
