tar7operator/Pinaka/21.Cansat/CAD V2/Hinge/Hinge Pin.SLDPRT

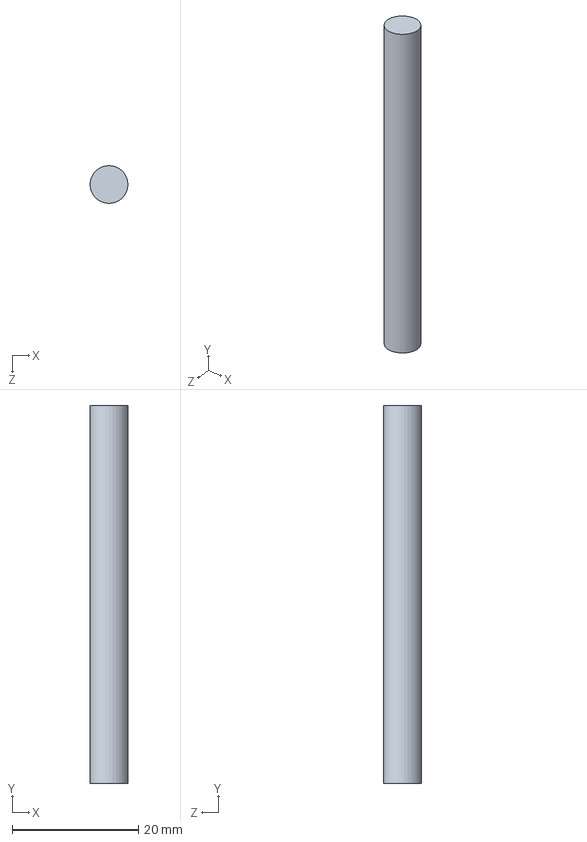
[picture p213: CAD file, 2025-01-11]
21.Cansat/CAD V2/Hinge/Hinge Pin.SLDPRT
5.97 x 60.0 x 6.00 mm
