tar7operator/Pinaka/21.Cansat/CAD V2/React/Reaction wheel.SLDPRT

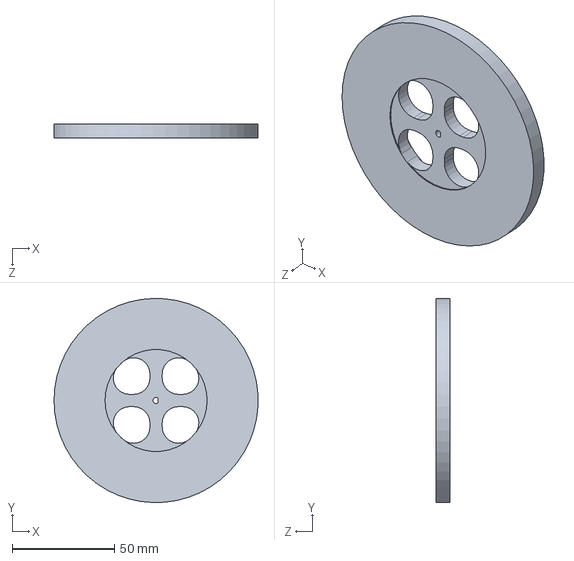
[picture p214: CAD file, 2025-01-30]
21.Cansat/CAD V2/React/Reaction wheel.SLDPRT
99.9 x 100.0 x 7.00 mm
