tar7operator/Pinaka/21.Cansat/CAD V2/STEP/BottomPlate.STEP

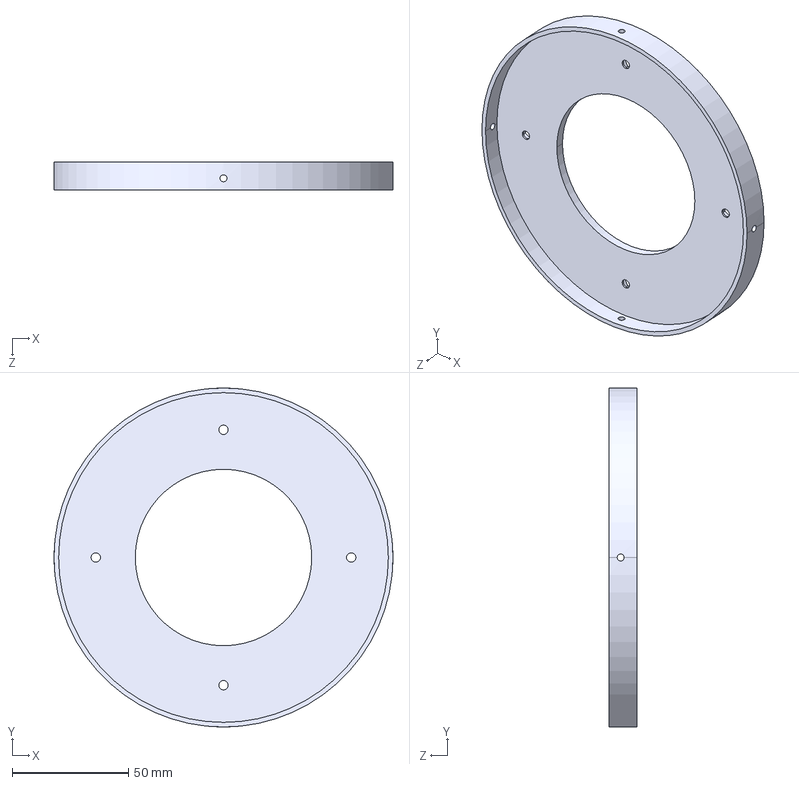
[picture p215: CAD file, 2025-01-10]
21.Cansat/CAD V2/STEP/BottomPlate.STEP
146.0 x 146.0 x 12.0 mm
