tar7operator/Pinaka/21.Cansat/CAD V2/STL/Stud Spacer M4x131_4L.STL

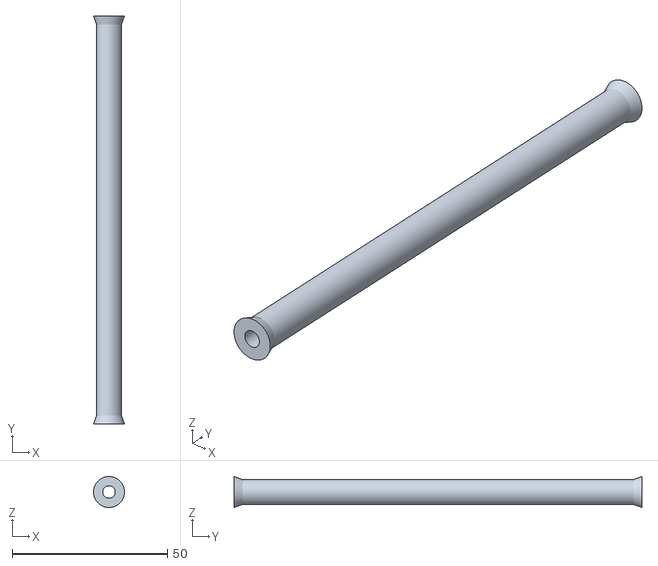
[picture p216: CAD file, 2025-05-20]
21.Cansat/CAD V2/STL/Stud Spacer M4x131_4L.STL
10.0 x 131.4 x 10.0
