tar7operator/Pinaka/6. Test Stand/80frontRod Bottom.SLDPRT

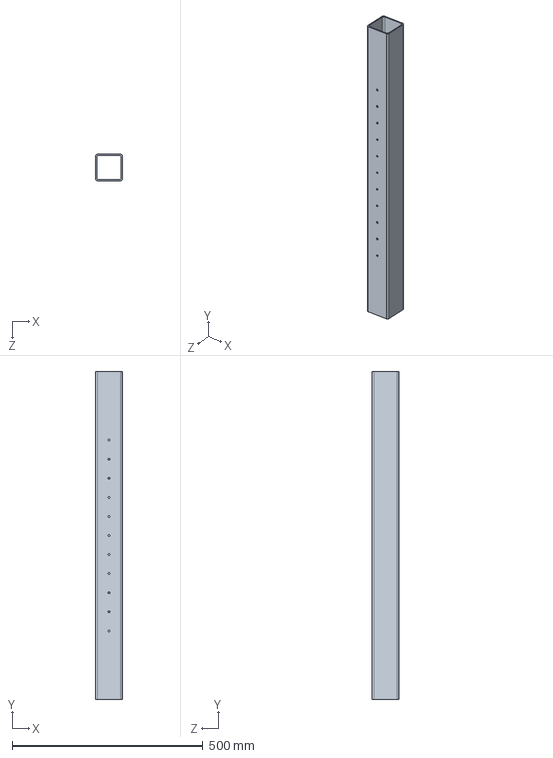
[picture p217: CAD file, 2025-02-16]
6. Test Stand/80frontRod Bottom.SLDPRT
70.0 x 860.0 x 70.0 mm
