tar7operator/Pinaka/laser Cutting/PCBPlate.DXF

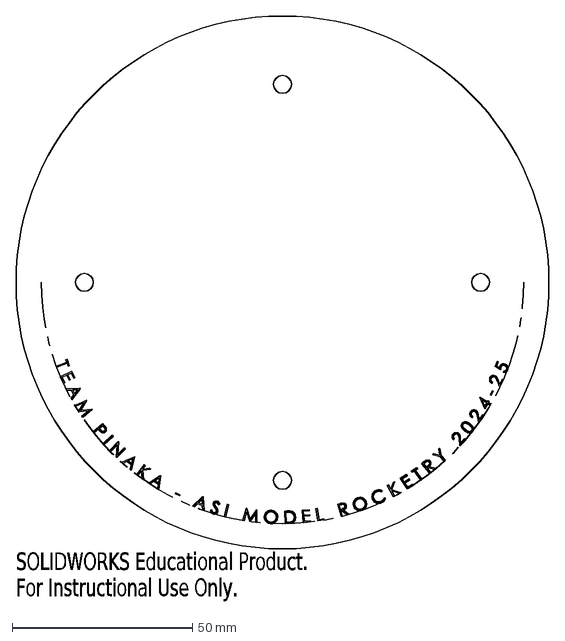
[picture p218: CAD file, 2025-02-16]
laser Cutting/PCBPlate.DXF
SOLIDWORKS Educational Product.
For Instructional Use Only.
