tar7operator/Pinaka/0. 3D Printing/NoseConeCylinder.STL

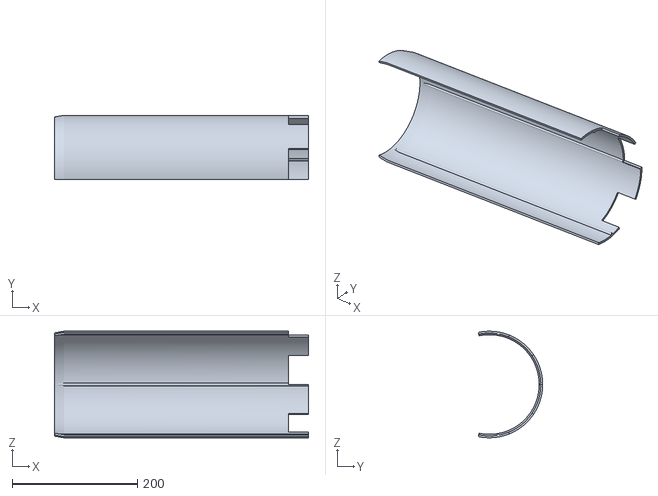
[picture p219: CAD file, 2025-02-16]
0. 3D Printing/NoseConeCylinder.STL
405.0 x 102.7 x 170.0
