tar7operator/Pinaka/1. CAD PDR -- Do not Edit!/Accesories/MG90S Servo Motor.stp

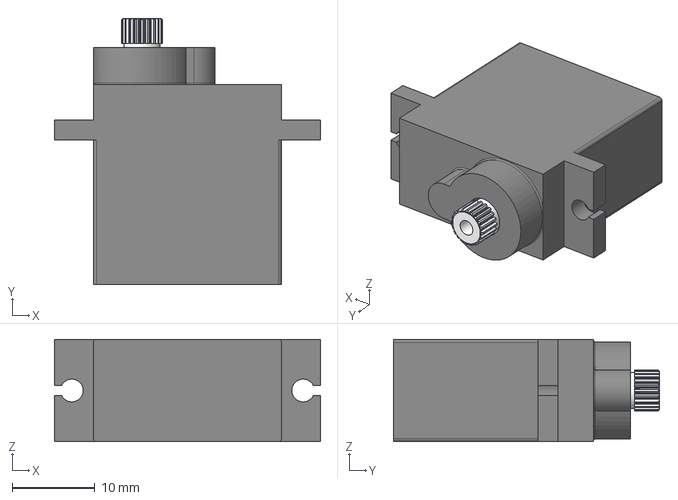
[picture p220: CAD file, 2024-09-28]
1. CAD PDR -- Do not Edit!/Accesories/MG90S Servo Motor.stp
32.2 x 32.2 x 12.4 mm
