tar7operator/Pinaka/1. CAD PDR -- Do not Edit!/Hinge/HingeBody.SLDPRT

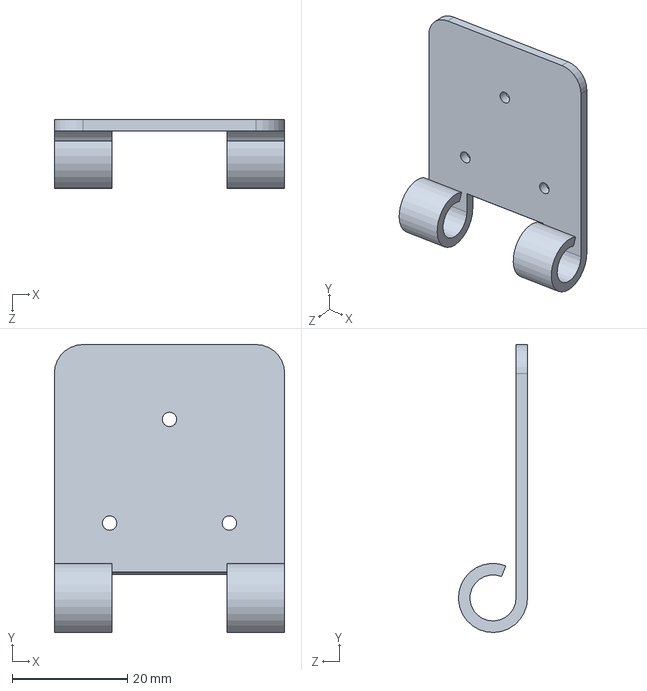
[picture p221: CAD file, 2024-09-27]
1. CAD PDR -- Do not Edit!/Hinge/HingeBody.SLDPRT
40.0 x 50.0 x 12.0 mm
