tar7operator/Pinaka/1. CAD PDR -- Do not Edit!/NoseCone/NoseConePlate.SLDPRT

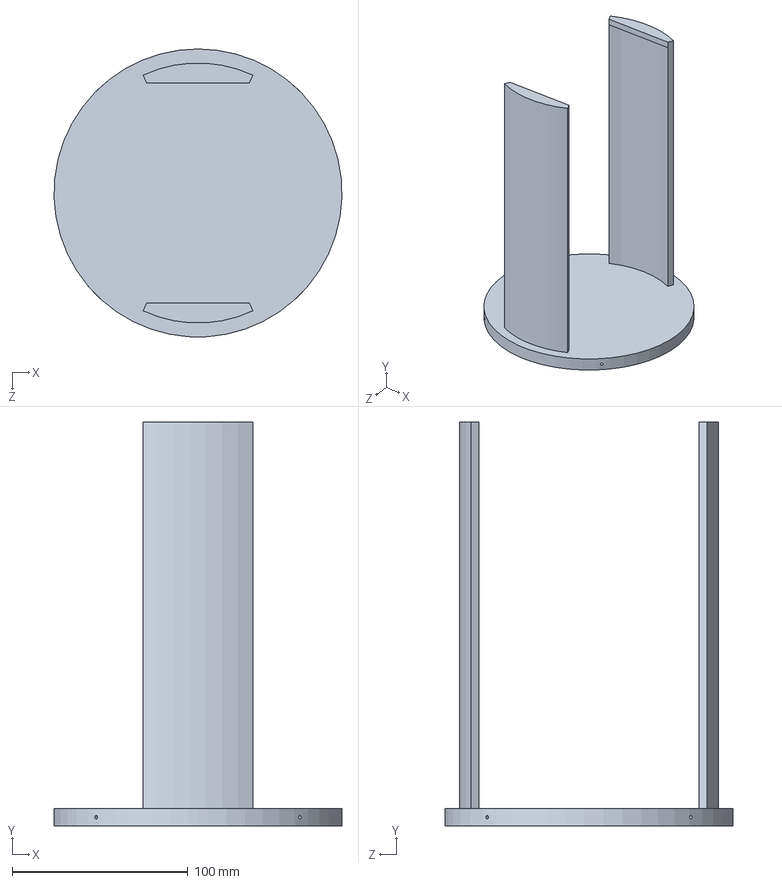
[picture p222: CAD file, 2024-09-27]
1. CAD PDR -- Do not Edit!/NoseCone/NoseConePlate.SLDPRT
163.9 x 230.0 x 164.0 mm
