tar7operator/Pinaka/1. CAD PDR -- Do not Edit!/STL/Paylaod bay door.SLDPRT

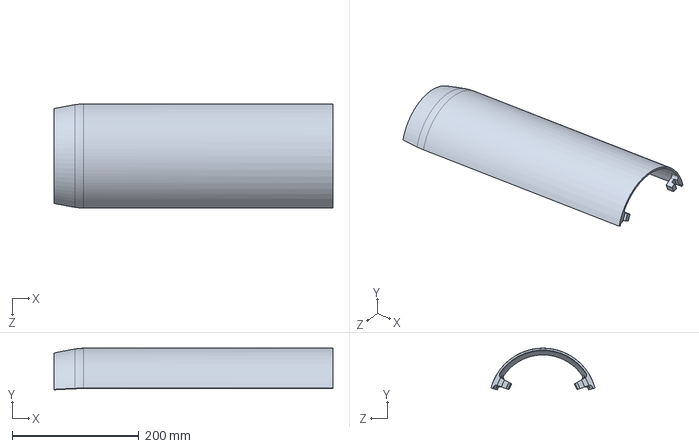
[picture p223: CAD file, 2024-11-05]
1. CAD PDR -- Do not Edit!/STL/Paylaod bay door.SLDPRT
440.0 x 65.7 x 164.2 mm
