tar7operator/Pinaka/1. CAD PDR -- Do not Edit!/TransitionZone.SLDPRT

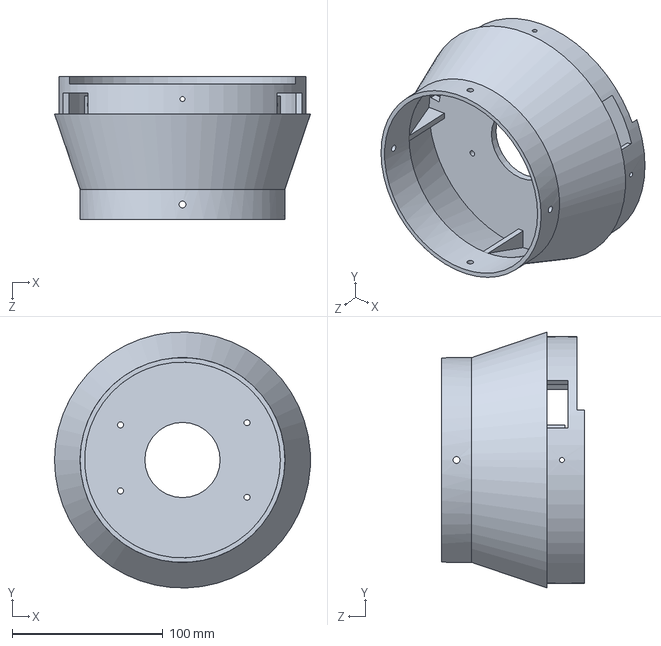
[picture p224: CAD file, 2024-11-28]
1. CAD PDR -- Do not Edit!/TransitionZone.SLDPRT
170.0 x 169.9 x 95.0 mm
