tar7operator/Pinaka/10.FEA/Rocket/Thrust Plate/Thrust Plate.IGS

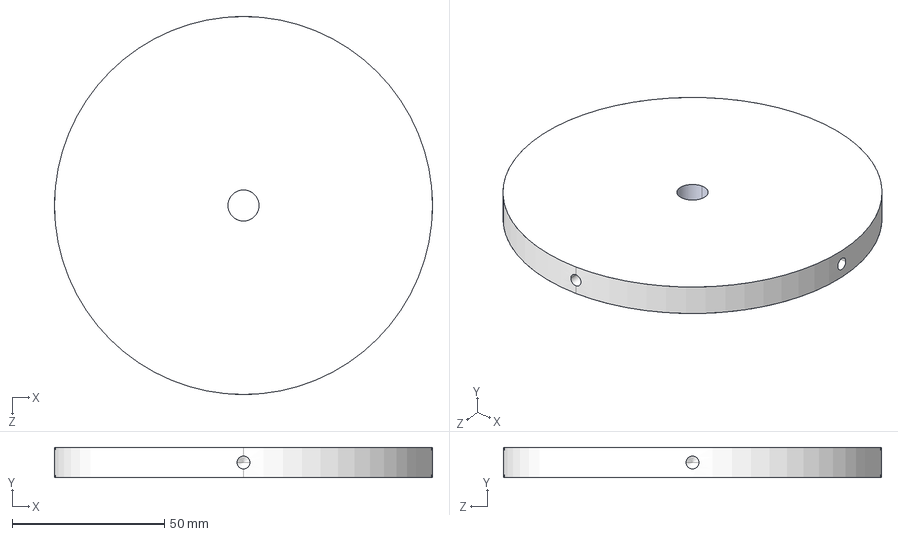
[picture p225: CAD file, 2024-12-29]
10.FEA/Rocket/Thrust Plate/Thrust Plate.IGS
124.0 x 10.0 x 124.0 mm
