tar7operator/Pinaka/11. CFD/Parachute/Drogue/Drogue.SLDPRT

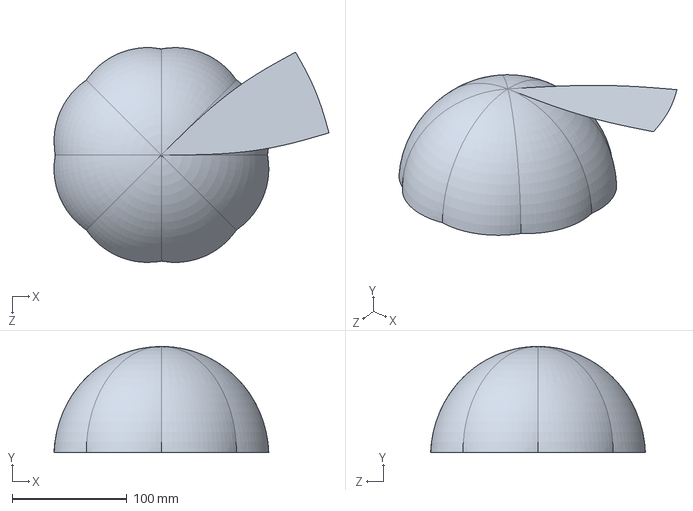
[picture p226: CAD file, 2024-12-22]
11. CFD/Parachute/Drogue/Drogue.SLDPRT
239.9 x 92.6 x 187.4 mm
