tar7operator/Pinaka/11. CFD/Whole Body/body.SLDPRT

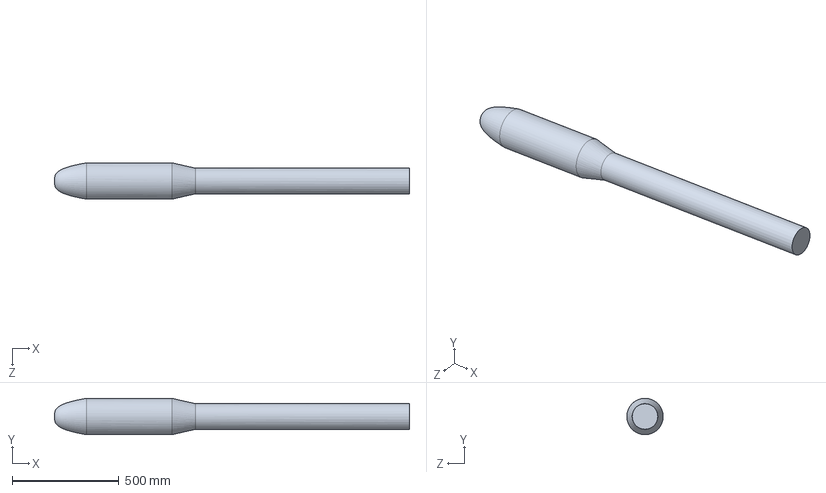
[picture p227: CAD file, 2024-12-22]
11. CFD/Whole Body/body.SLDPRT
1660.0 x 170.0 x 170.0 mm
