tar7operator/Pinaka/16. CAD V5/Body Assembly/Thrust Plate.SLDPRT

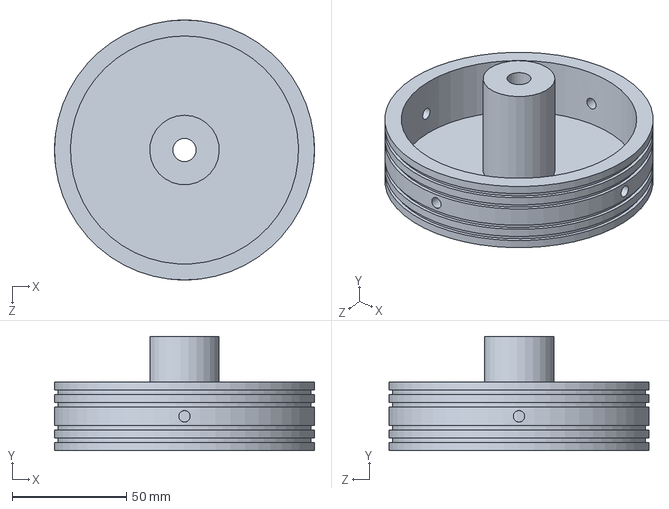
[picture p228: CAD file, 2025-05-20]
16. CAD V5/Body Assembly/Thrust Plate.SLDPRT
114.0 x 50.0 x 114.0 mm
