tar7operator/Pinaka/16. CAD V5/Electronics Bay Assembly/Electronics Bay Cover.SLDPRT

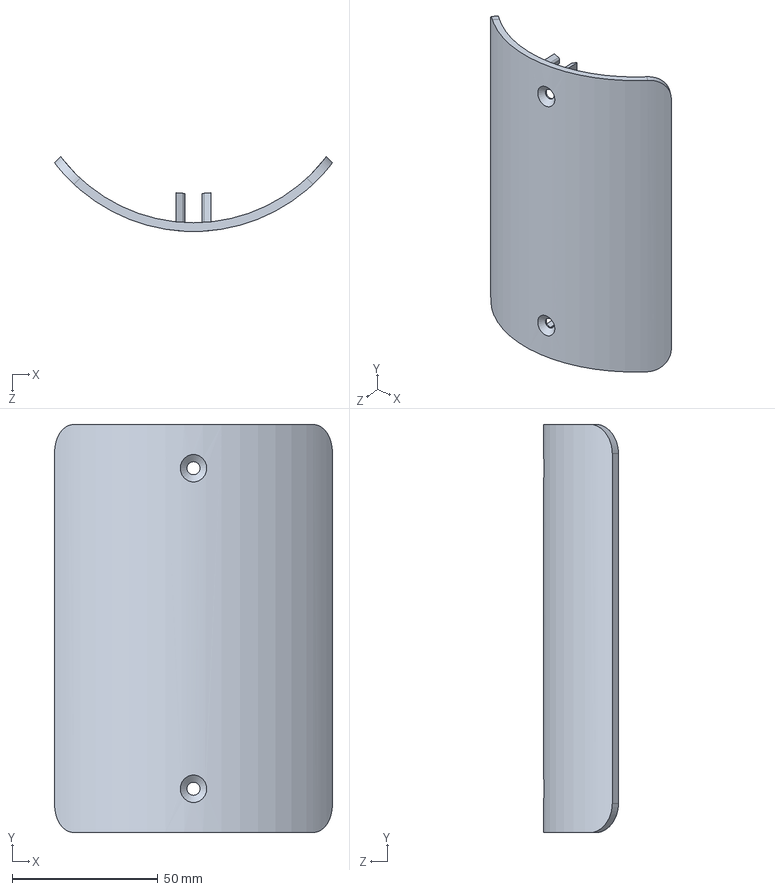
[picture p229: CAD file, 2025-05-20]
16. CAD V5/Electronics Bay Assembly/Electronics Bay Cover.SLDPRT
95.4 x 140.0 x 25.8 mm
