tar7operator/Pinaka/16. CAD V5/Electronics Bay Assembly/Electronics/AHT15.SLDPRT

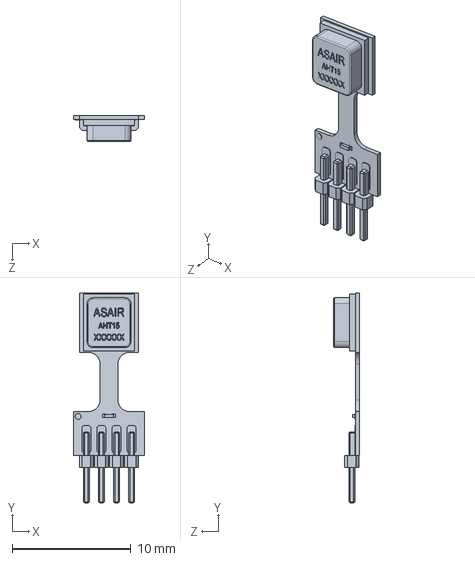
[picture p230: CAD file, 2025-01-15]
16. CAD V5/Electronics Bay Assembly/Electronics/AHT15.SLDPRT
6.00 x 17.7 x 2.20 mm
