tar7operator/Pinaka/16. CAD V5/Electronics Bay Assembly/Electronics/JST-XH-2-54mm connectors/Thru Horizontal/JST - XH - Thru (R) - 14Pin - 2.54mm.stp

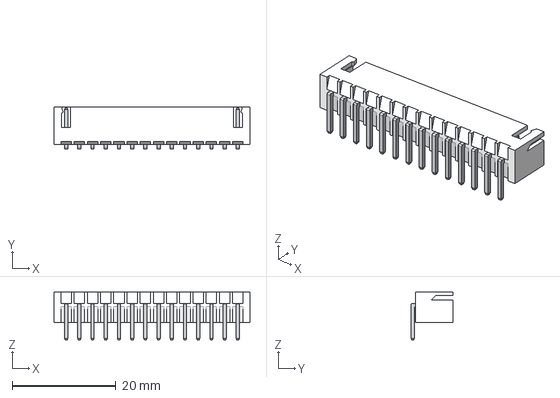
[picture p232: CAD file, 2025-01-05]
16. CAD V5/Electronics Bay Assembly/Electronics/JST-XH-2-54mm connectors/Thru Horizontal/JST - XH - Thru (R) - 14Pin - 2.54mm.stp
37.7 x 8.04 x 9.22 mm
