tar7operator/Pinaka/16. CAD V5/Electronics Bay Assembly/Electronics/Pin Header Female 2-54/4-Pin Header - Female - 2.54mm.step

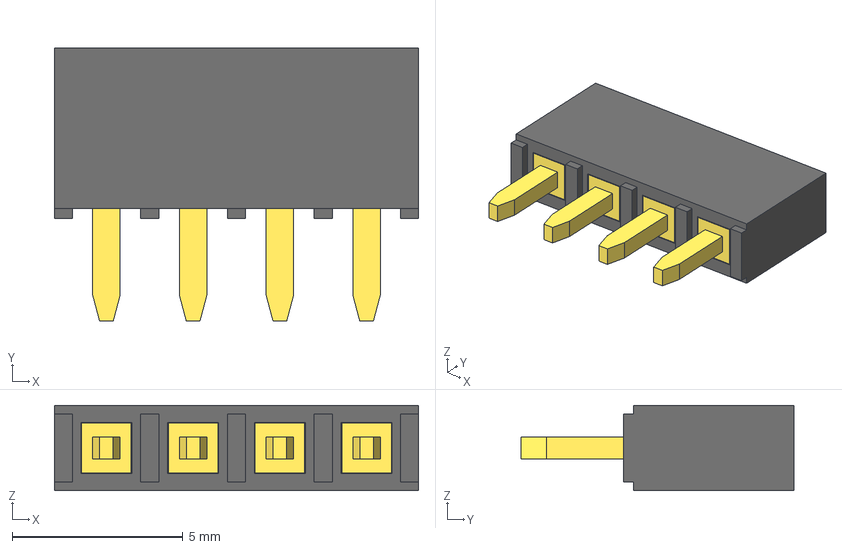
[picture p234: CAD file, 2025-01-05]
16. CAD V5/Electronics Bay Assembly/Electronics/Pin Header Female 2-54/4-Pin Header - Female - 2.54mm.step
10.7 x 8.00 x 2.50 mm
