tar7operator/Pinaka/16. CAD V5/Payload Assembly/NoseCone.SLDPRT

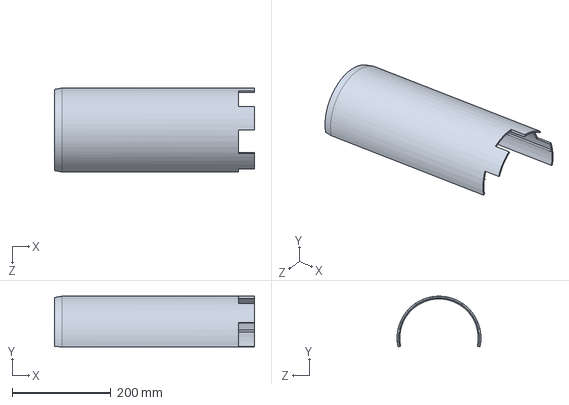
[picture p235: CAD file, 2025-02-16]
16. CAD V5/Payload Assembly/NoseCone.SLDPRT
405.0 x 102.7 x 170.0 mm
