tar7operator/Pinaka/16. CAD V5/Payload Assembly/V2/NosePlate.SLDPRT

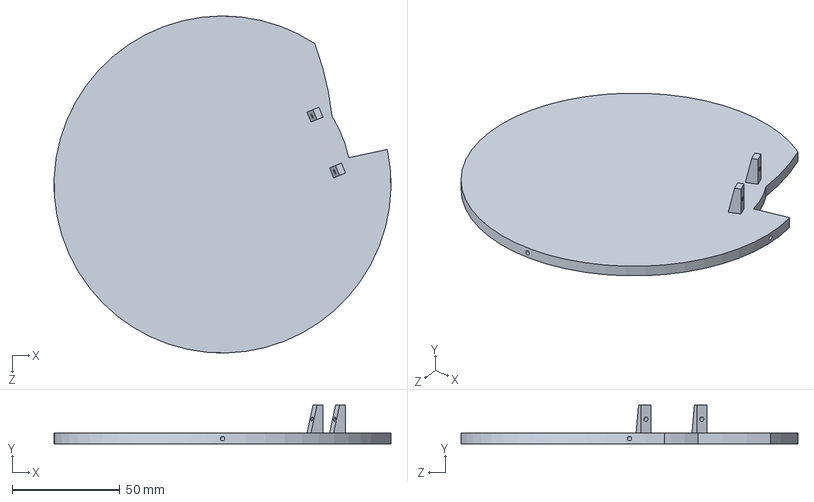
[picture p236: CAD file, 2025-05-20]
16. CAD V5/Payload Assembly/V2/NosePlate.SLDPRT
156.6 x 18.0 x 156.6 mm
