tar7operator/Pinaka/16. CAD V5/Rocket Motor Assembly/Aerotech H148 Motor Case.SLDPRT

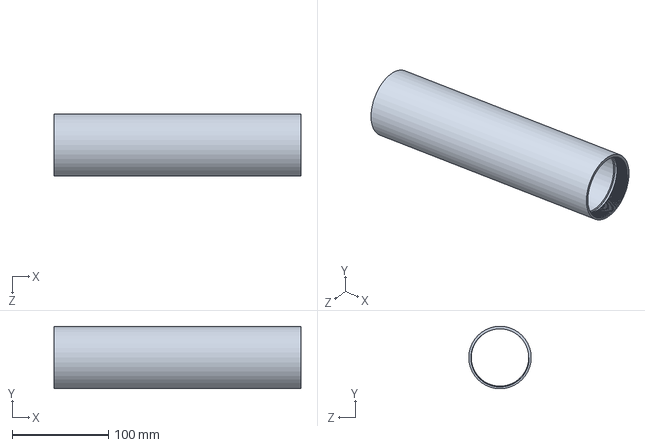
[picture p237: CAD file, 2024-09-28]
16. CAD V5/Rocket Motor Assembly/Aerotech H148 Motor Case.SLDPRT
257.1 x 65.0 x 65.0 mm
