tar7operator/Pinaka/16. CAD V5/Rocket Motor Assembly/ThrustTech/End Cap.SLDPRT

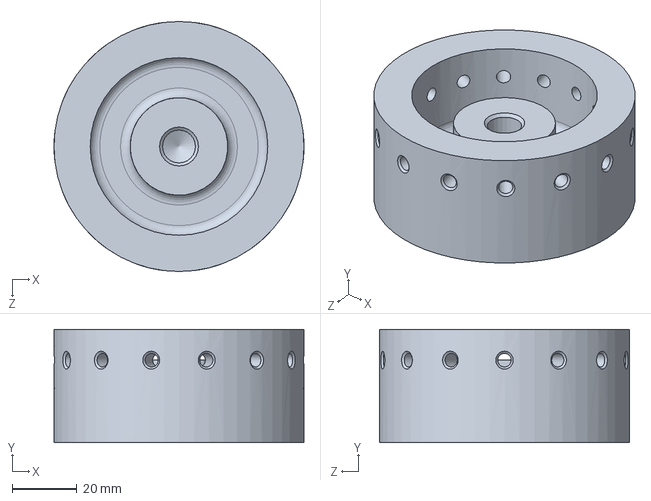
[picture p238: CAD file, 2025-05-20]
16. CAD V5/Rocket Motor Assembly/ThrustTech/End Cap.SLDPRT
77.4 x 35.0 x 77.4 mm
