tar7operator/Pinaka/16. CAD V5/STL/NoseCone truncated body.STL

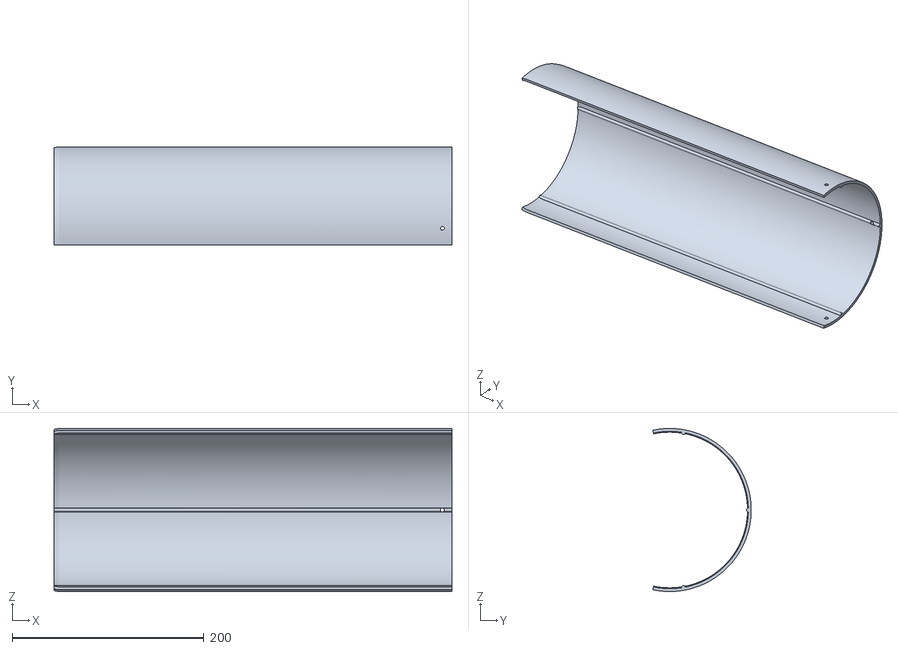
[picture p239: CAD file, 2025-05-20]
16. CAD V5/STL/NoseCone truncated body.STL
415.0 x 102.7 x 170.0
