tar7operator/Pinaka/16. CAD V5/Tools, Jigs, Fixtures, Templates/R-16 Fillet Tool.STL

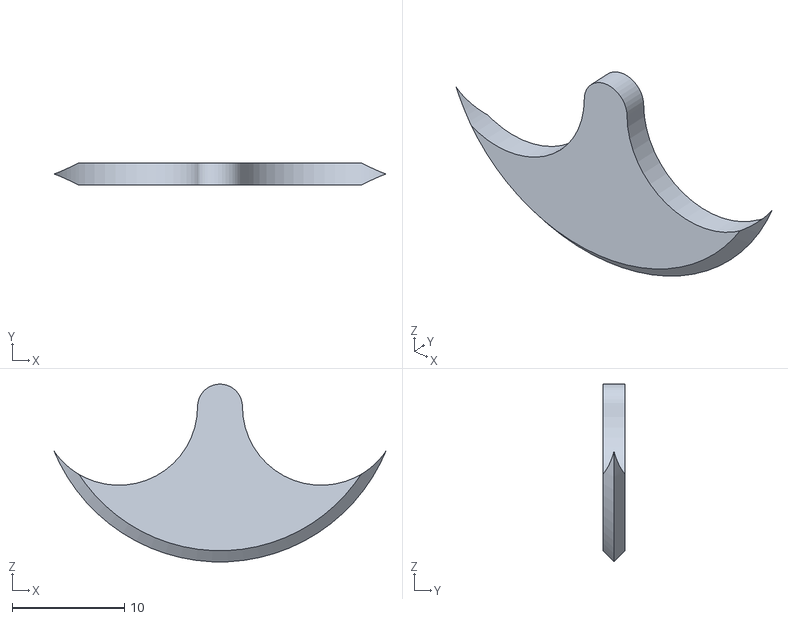
[picture p240: CAD file, 2024-12-24]
16. CAD V5/Tools, Jigs, Fixtures, Templates/R-16 Fillet Tool.STL
29.6 x 2.00 x 15.8
