tar7operator/Pinaka/21.Cansat/CAD V2/Hinge/HingeFlap.SLDPRT

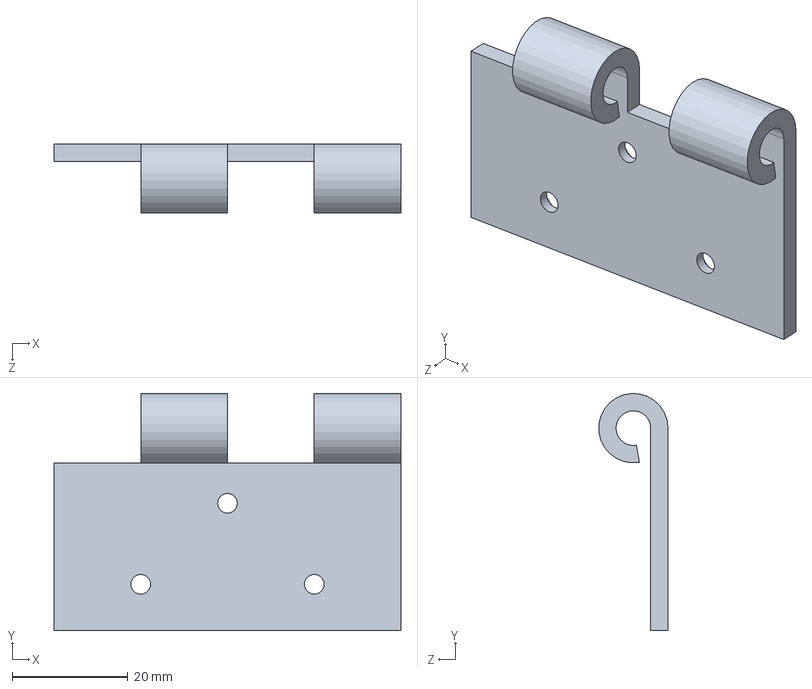
[picture p241: CAD file, 2025-01-11]
21.Cansat/CAD V2/Hinge/HingeFlap.SLDPRT
60.0 x 41.0 x 12.0 mm
