tar7operator/Pinaka/21.Cansat/CAD V2/STEP/CameraPlate.STEP

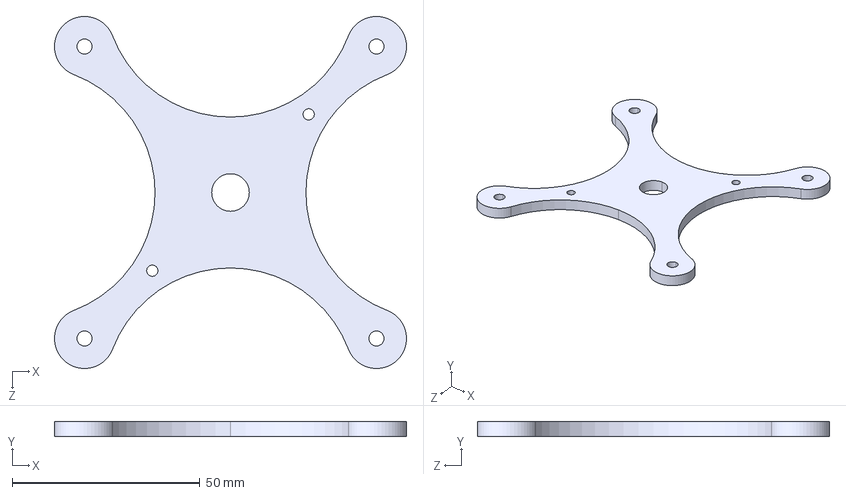
[picture p242: CAD file, 2025-01-10]
21.Cansat/CAD V2/STEP/CameraPlate.STEP
93.8 x 4.00 x 93.8 mm
