tar7operator/Pinaka/21.Cansat/Electronics Plate/ElectronicsPlate.DXF

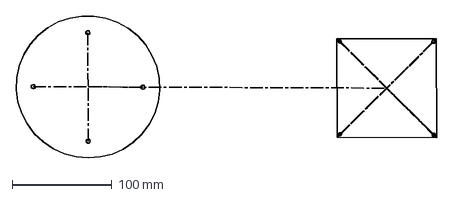
[picture p243: CAD file, 2025-01-09]
21.Cansat/Electronics Plate/ElectronicsPlate.DXF
421.6 x 142.4 mm
