tar7operator/Pinaka/5. Launch Stand/bottomRod.SLDPRT

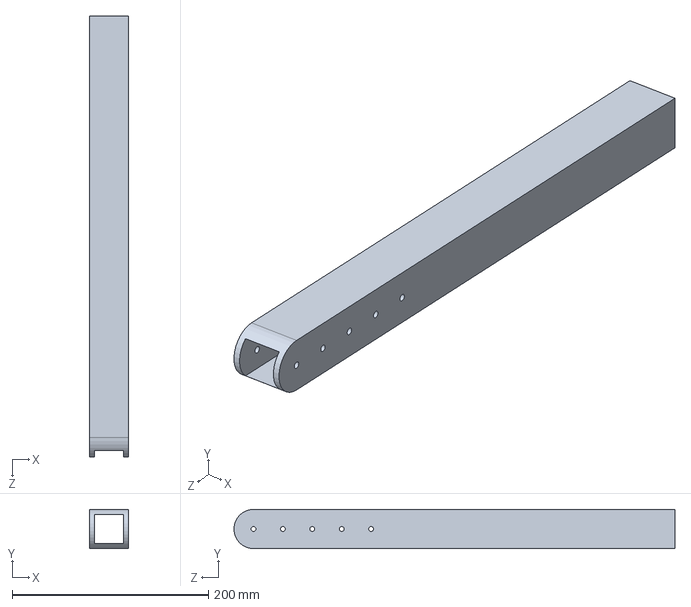
[picture p244: CAD file, 2024-09-30]
5. Launch Stand/bottomRod.SLDPRT
40.0 x 40.0 x 449.9 mm
