tar7operator/Pinaka/6. Test Stand/sideSupport.SLDPRT

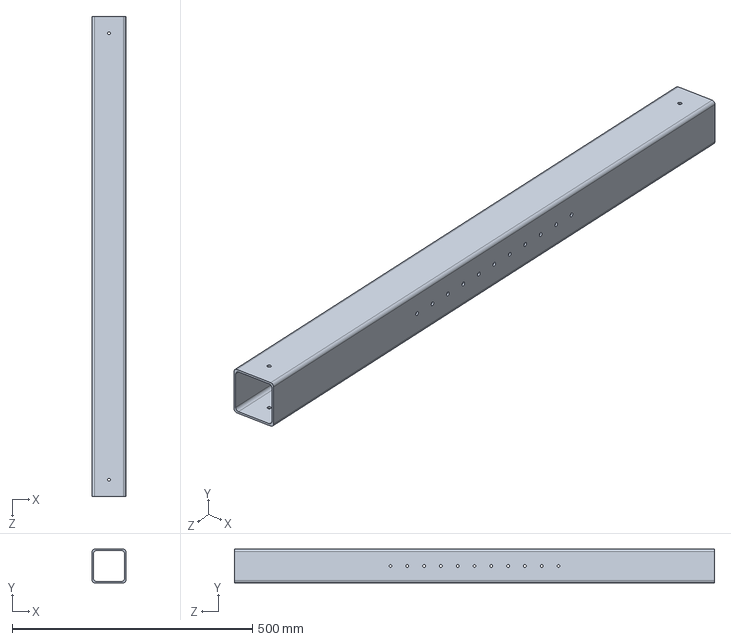
[picture p245: CAD file, 2024-09-27]
6. Test Stand/sideSupport.SLDPRT
70.0 x 70.0 x 1000.0 mm
