tar7operator/Pinaka/0. 3D Printing/MechanicalPlate.STL

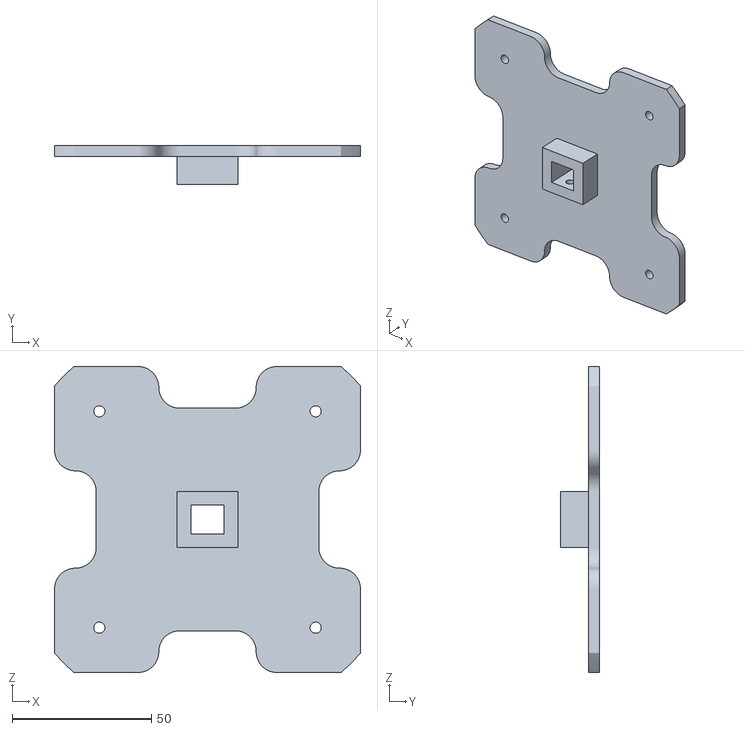
[picture p246: CAD file, 2025-01-09]
0. 3D Printing/MechanicalPlate.STL
110.0 x 14.0 x 110.0
