tar7operator/Pinaka/1. CAD PDR -- Do not Edit!/Accesories/m12 x 40 hex button hd.STEP

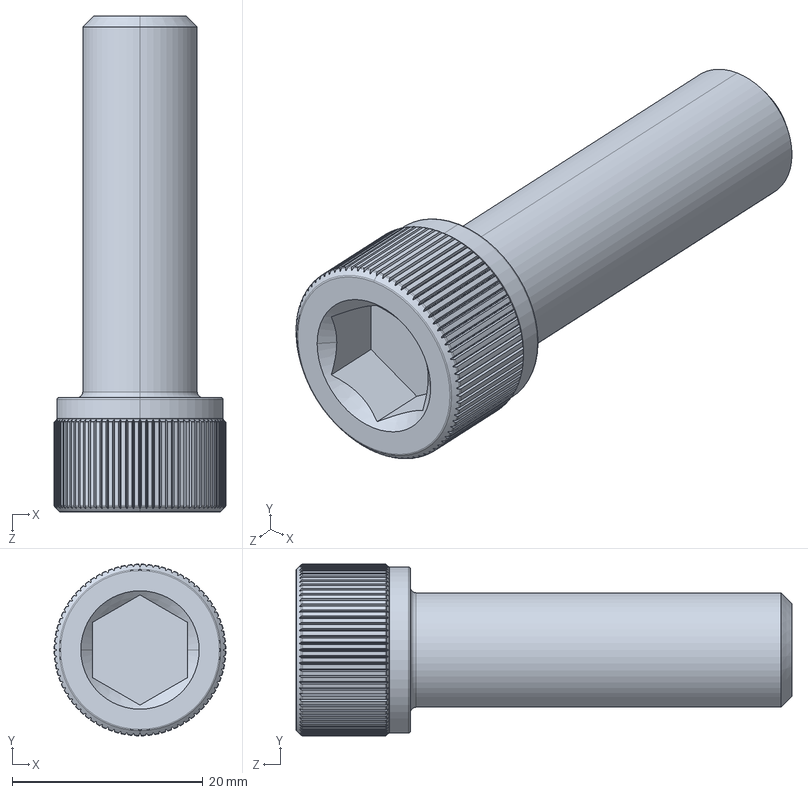
[picture p247: CAD file, 2024-09-28]
1. CAD PDR -- Do not Edit!/Accesories/m12 x 40 hex button hd.STEP
18.0 x 18.0 x 52.0 mm
