tar7operator/Pinaka/1. CAD PDR -- Do not Edit!/NoseCone/NoseCone_1_Nose Cone.obj

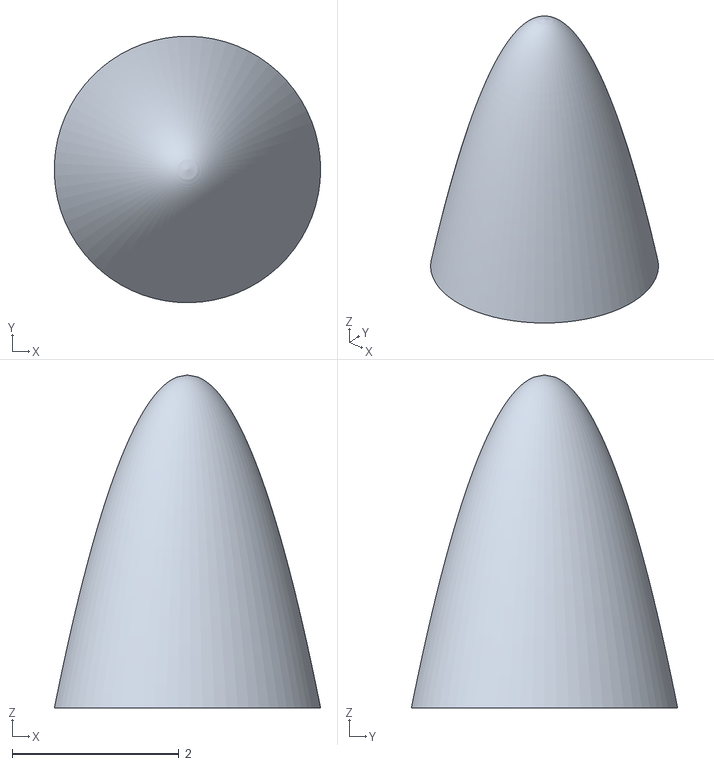
[picture p248: CAD file, 2024-09-27]
1. CAD PDR -- Do not Edit!/NoseCone/NoseCone_1_Nose Cone.obj
3.20 x 3.20 x 4.00
