tar7operator/Pinaka/1. CAD PDR -- Do not Edit!/parachutePlate.SLDPRT

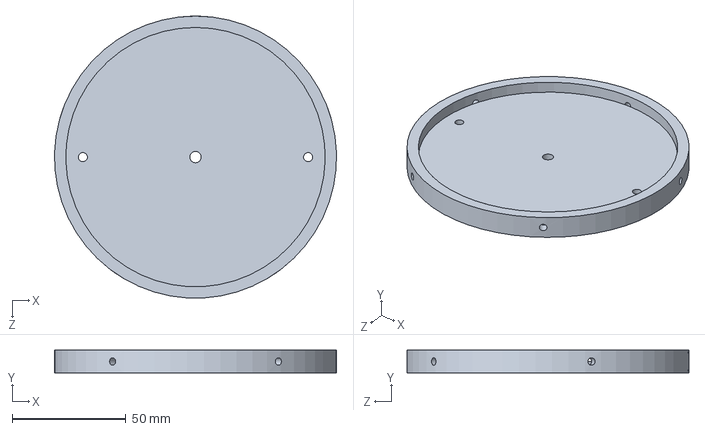
[picture p249: CAD file, 2024-11-28]
1. CAD PDR -- Do not Edit!/parachutePlate.SLDPRT
123.9 x 10.0 x 123.9 mm
