tar7operator/Pinaka/16. CAD V5/Electronics Bay Assembly/Electronics/DD0503MA Ultra Mini Buck Converter.SLDASM

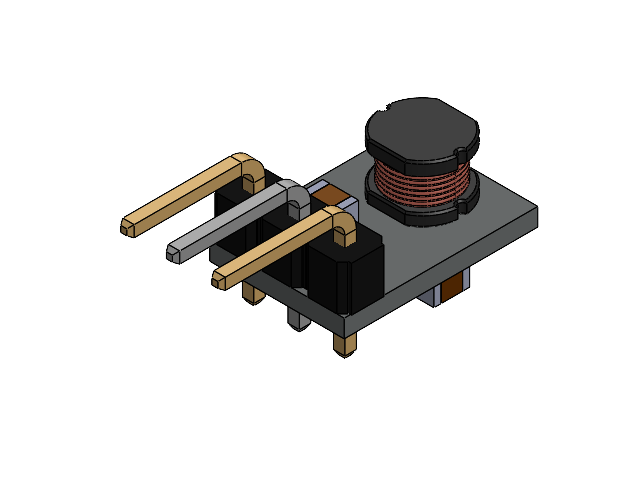
[picture p250: CAD file, 2025-01-15]
16. CAD V5/Electronics Bay Assembly/Electronics/DD0503MA Ultra Mini Buck Converter.SLDASM
PCB, DD0503MA ULTRA MINI DC 3.7V 4.5V 5V TO 3.3V DC DC STEP DOWN CONVERTER BUCK MODULE.STEP
SMD RESISTOR, DD0503MA ULTRA MINI DC 3.7V 4.5V 5V TO 3.3V DC DC STEP DOWN CONVERTER BUCK MODULE.STEP x 3
PIN HEADER, 1X3, 2.54 mm, DD0503MA ULTRA MINI DC 3.7V 4.5V 5V TO 3.3V DC DC STEP DOWN CONVERTER BUCK MODULE.STEP
6R8 SMD INDUCTOR, DD0503MA ULTRA MINI DC 3.7V 4.5V 5V TO 3.3V DC DC STEP DOWN CONVERTER BUCK MODULE.STEP
MICRO REG, DD0503MA ULTRA MINI DC 3.7V 4.5V 5V TO 3.3V DC DC STEP DOWN CONVERTER BUCK MODULE.STEP
