tar7operator/Pinaka/16. CAD V5/Electronics Bay Assembly/Electronics/NRF24L01L + Antenna 2.4 GHz/NRF24L01L+Antenna.SLDASM

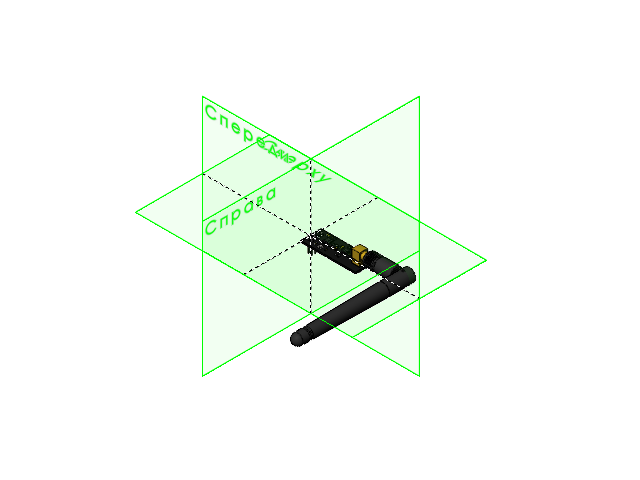
[picture p251: CAD file, 2024-12-04]
16. CAD V5/Electronics Bay Assembly/Electronics/NRF24L01L + Antenna 2.4 GHz/NRF24L01L+Antenna.SLDASM
NRF24L01L
Antenna base
Antenna top
