tar7operator/Pinaka/16. CAD V5/Electronics Bay Assembly/Electronics/XBPro-whip/XBPro-whip.SLDASM

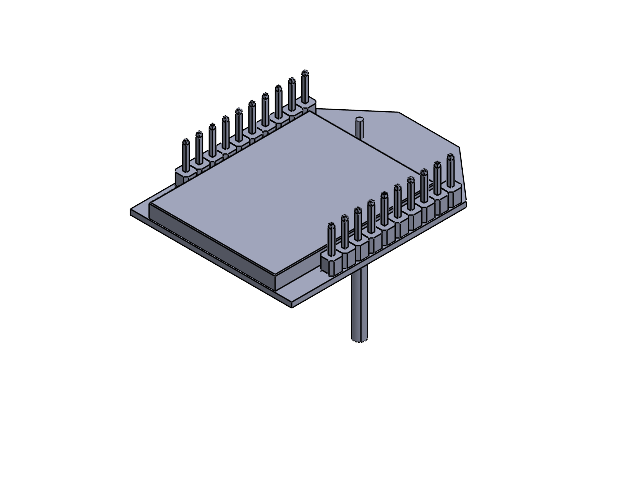
[picture p252: CAD file, 2024-09-30]
16. CAD V5/Electronics Bay Assembly/Electronics/XBPro-whip/XBPro-whip.SLDASM
2mmHeaderPin_straight.STEP x 20
XBP24_with_Pads.STEP
1001557A.STEP
XBPro_shield.STEP
