tar7operator/Pinaka/16. CAD V5/Rocket Motor Assembly/Assemblage Aerotech H148.SLDASM

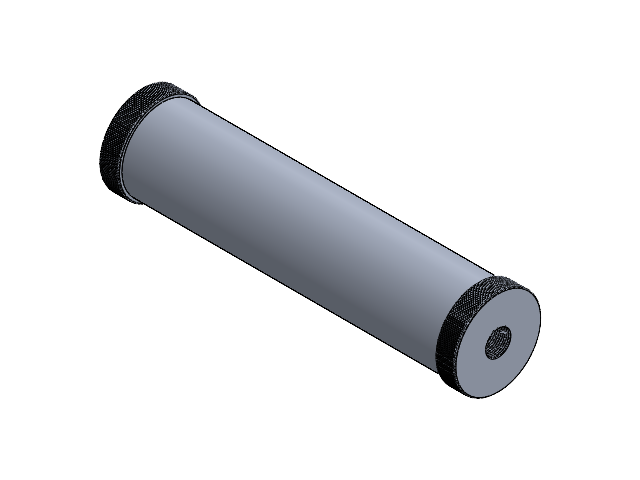
[picture p253: CAD file, 2025-01-11]
16. CAD V5/Rocket Motor Assembly/Assemblage Aerotech H148.SLDASM
Aerotech H148 Motor Case
Aerotech H148 Nozzle
Aerotech H148 Nozzle Nut
Aerotech H148 Top Nut
