tar7operator/Pinaka/21.Cansat/CAD V2/Parachute Bay Assembly.SLDASM

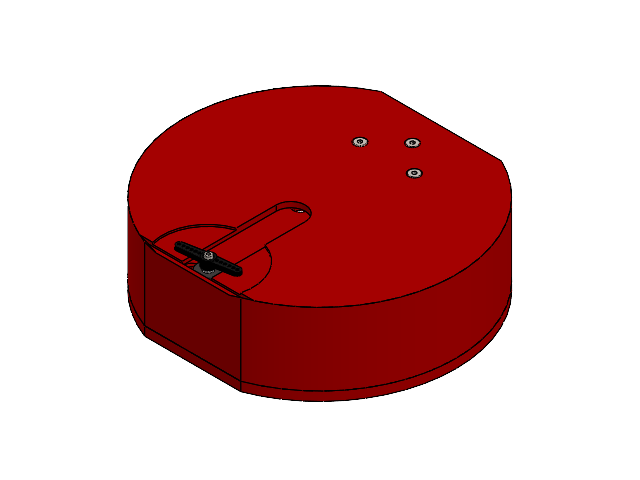
[picture p254: CAD file, 2025-05-20]
21.Cansat/CAD V2/Parachute Bay Assembly.SLDASM
Parachute Bay V2
Parachute Plate V2
HingeFlap x 2
Hinge Pin
Parachute Cover
axe
base001
etiquette
Tube
Cylindre
Tube001
Tube002
etiquette001
Cylindre001
Cylindre002
MG90S_arm02
socket head cap screw_iso x 3
socket countersunk head screw_iso x 6
