tar7operator/Pinaka/3. Motor/Aerotech/Assemblage Aerotech H148.SLDASM

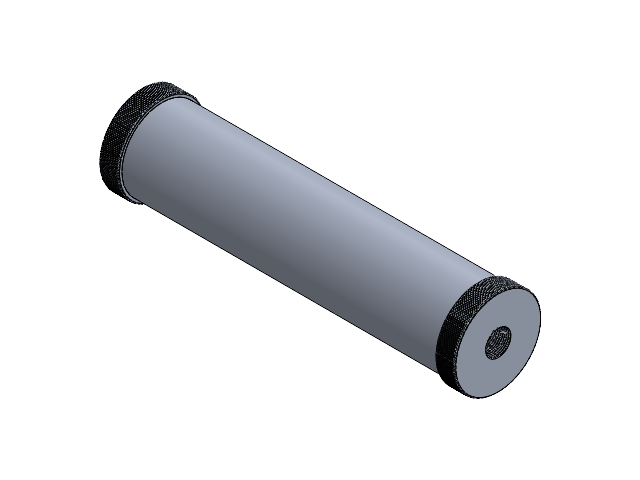
[picture p255: CAD file, 2024-09-28]
3. Motor/Aerotech/Assemblage Aerotech H148.SLDASM
Aerotech H148 Motor Case
Aerotech H148 Nozzle
Aerotech H148 Nozzle Nut
Aerotech H148 Top Nut
