tar7operator/Pinaka/4. Parachute/Parachute.SLDASM

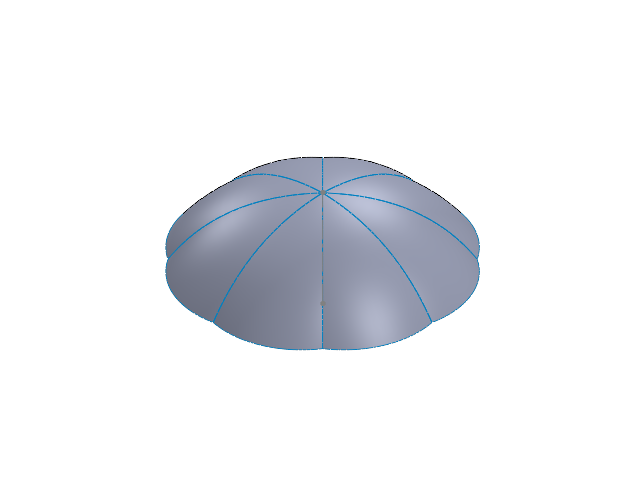
[picture p256: CAD file, 2024-09-27]
4. Parachute/Parachute.SLDASM
ParachuteCut x 8
