tar7operator/Pinaka/5. Launch Stand/launch stand.SLDASM

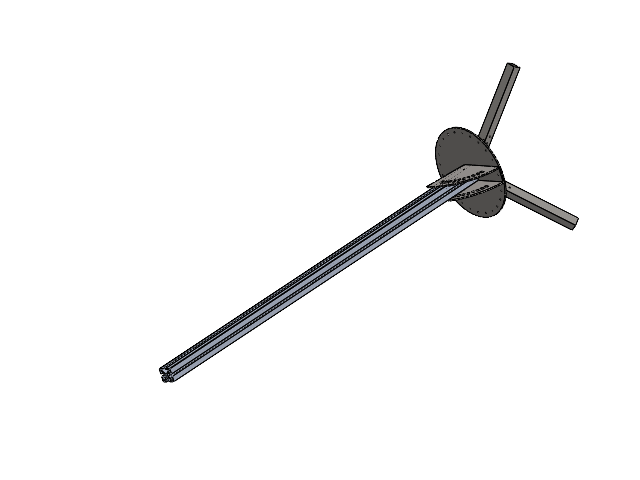
[picture p257: CAD file, 2025-01-30]
5. Launch Stand/launch stand.SLDASM
BottomPlate
bottomRod x 3
rotatingPlate
railnew1
