tar7operator/Pinaka/V3/PinakaV2.SLDASM

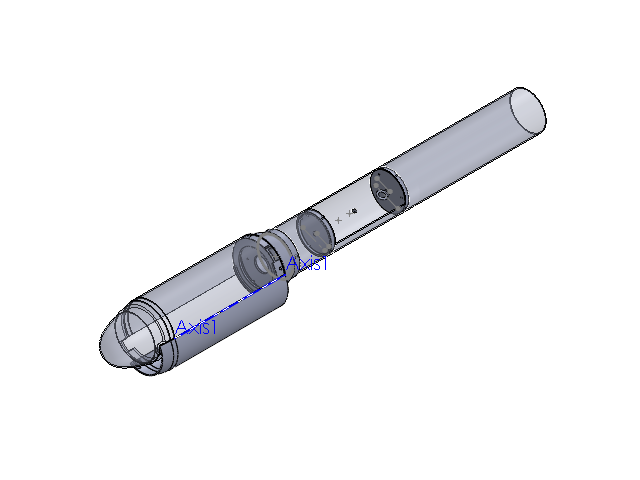
[picture p258: CAD file, 2024-09-28]
V3/PinakaV2.SLDASM
bodyCover
CansatCover
Flaps
parachutePlate x 2
Eye bolt 6mm x 2
TransitionZone
m4 x 12 hex button hd.step x 7
m3 x 12 hex button hd.step x 8
m6 hex nut.step x 2
