tar7operator/Pinaka/10.FEA/Rocket/Nose Cone/Nose Cone.SLDASM

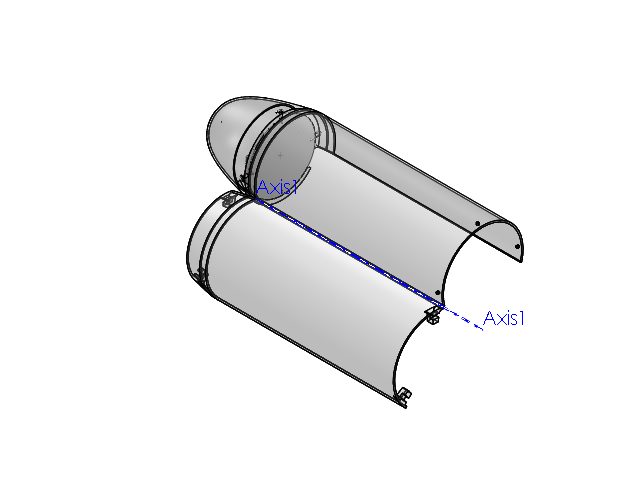
[picture p259: CAD file, 2024-11-22]
10.FEA/Rocket/Nose Cone/Nose Cone.SLDASM
CansatCover
Flaps
NosePlate
servoMotor x 2
shoulder x 2
socket head cap screw_iso x 4
countersunk flat head cross recess screw_iso x 3
