tar7operator/Pinaka/16. CAD V5/Common/M90/M90S.SLDASM

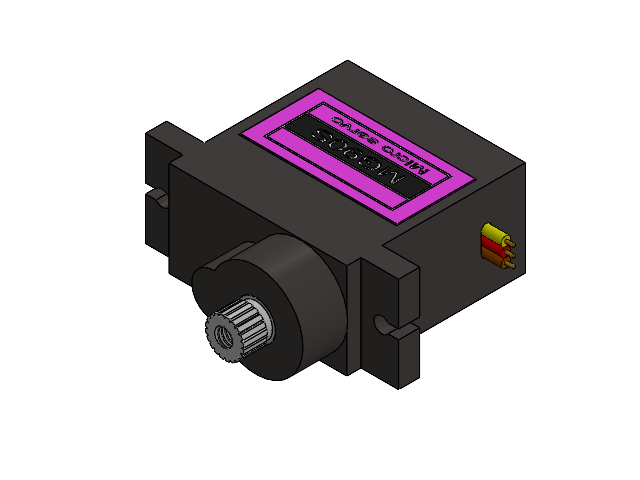
[picture p260: CAD file, 2025-01-15]
16. CAD V5/Common/M90/M90S.SLDASM
axe
base001
etiquette
Tube
Cylindre
Tube001
Tube002
etiquette001
Cylindre001
Cylindre002
