tar7operator/Pinaka/16. CAD V5/Electronics Bay Assembly/Electronics/NRF24L01L + Antenna 2.4 GHz/Antenna assy.SLDASM

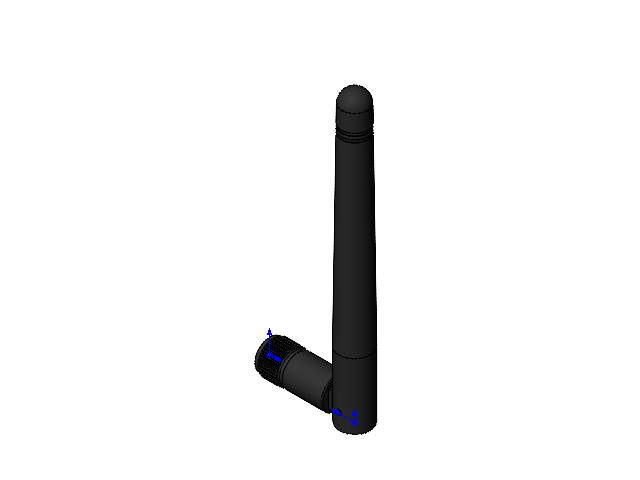
[picture p261: CAD file, 2024-11-01]
16. CAD V5/Electronics Bay Assembly/Electronics/NRF24L01L + Antenna 2.4 GHz/Antenna assy.SLDASM
Antenna base
Antenna top
