tar7operator/Pinaka/16. CAD V5/Parachute Assembly/Bottom Parachute Plate Assembly.SLDASM

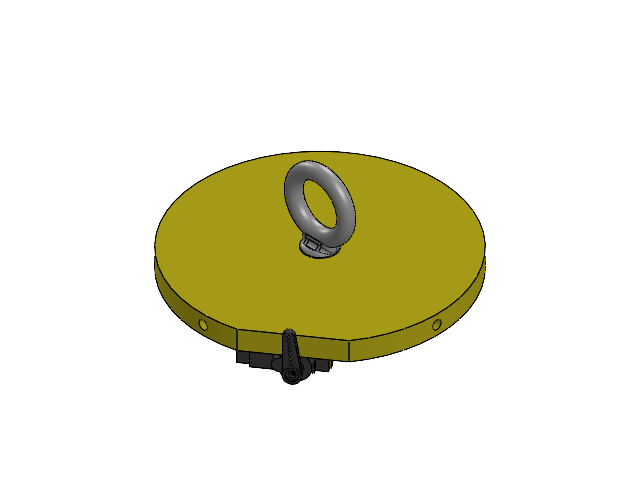
[picture p262: CAD file, 2025-05-20]
16. CAD V5/Parachute Assembly/Bottom Parachute Plate Assembly.SLDASM
Bottom Parachute Plate
M6 15mm Shank
Hex nut M6 H5.2
axe
base001
etiquette
Tube
Cylindre
Tube001
Tube002
etiquette001
Cylindre001
Cylindre002
MG90S_arm01
