tar7operator/Pinaka/16. ST-CAD V4/ST-Transition Tube.SLDASM

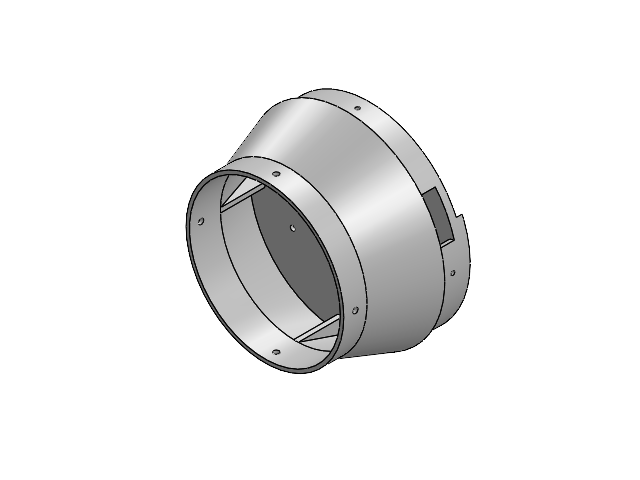
[picture p264: CAD file, 2024-11-29]
16. ST-CAD V4/ST-Transition Tube.SLDASM
ST-TransitionZone
ST-servoMotor x 2
ST-shoulder x 2
socket head cap screw_iso x 4
