tar7operator/Pinaka/16. CAD V5/Common/Battery and Holder/Battery Holder ASSY V2.SLDASM

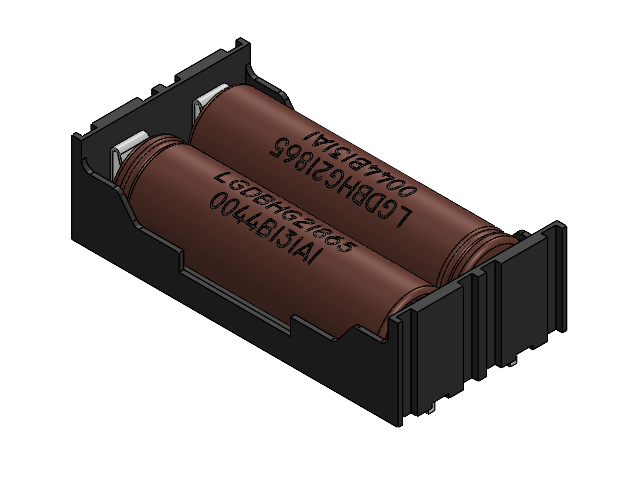
[picture p265: CAD file, 2025-01-11]
16. CAD V5/Common/Battery and Holder/Battery Holder ASSY V2.SLDASM
Battery Holder
18650 Battery_1 x 2
