tar7operator/Pinaka/16. CAD V5/Electronics Bay Assembly/Real Time Clock.SLDASM

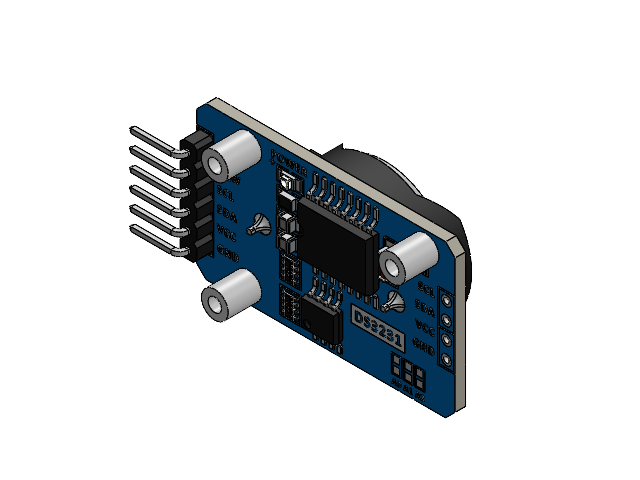
[picture p266: CAD file, 2025-01-15]
16. CAD V5/Electronics Bay Assembly/Real Time Clock.SLDASM
DS3231 RTC
M2x5 Spacer x 3
