tar7operator/Pinaka/16. ST-CAD V4/ST-MG90 Servo.SLDASM

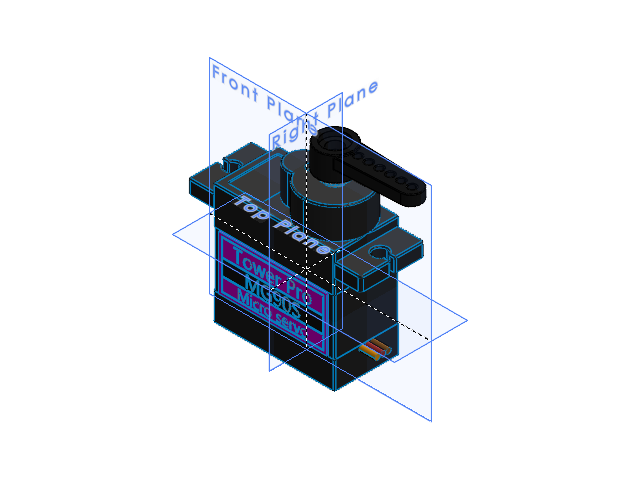
[picture p267: CAD file, 2024-11-29]
16. ST-CAD V4/ST-MG90 Servo.SLDASM
ST-servoMotor
ST-shoulder
