tar7operator/Pinaka/1. CAD PDR -- Do not Edit!/TransitionMechanism.SLDASM

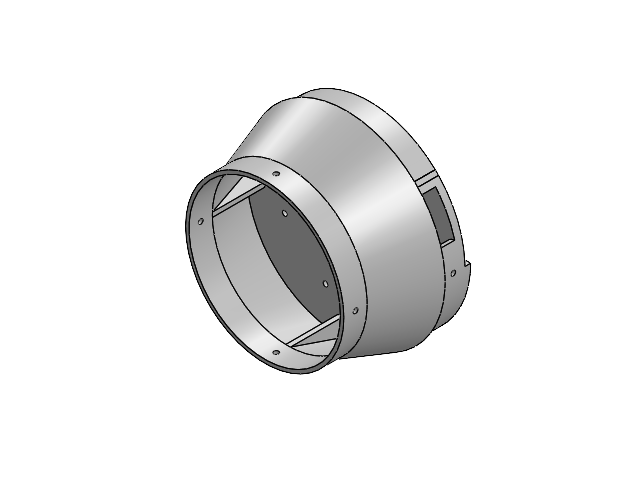
[picture p268: CAD file, 2024-11-28]
1. CAD PDR -- Do not Edit!/TransitionMechanism.SLDASM
TransitionZone
mg90s servo motor.stp x 2
shoulder x 2
