tar7operator/Pinaka/16. CAD V5/Electronics Bay Assembly/Electronics Bay Assembly.SLDASM

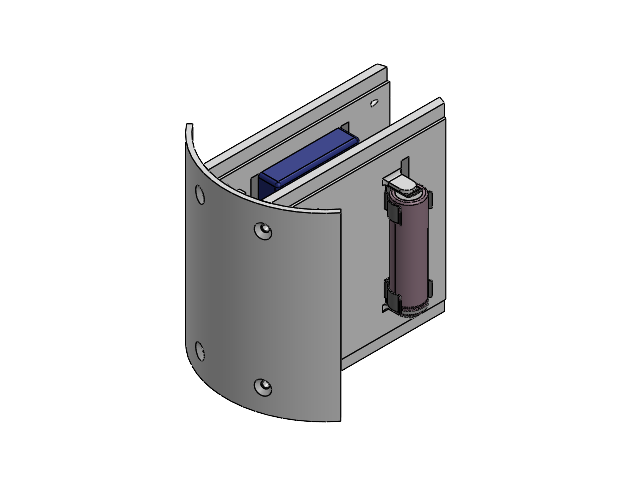
[picture p269: CAD file, 2024-12-19]
16. CAD V5/Electronics Bay Assembly/Electronics Bay Assembly.SLDASM
Electronics Bay Cover
Electronics Mount x 2
battery.stp x 2
Battery connector 18650.stp x 4
VoltageSensor
BharatPi
DS3231 RTC
M2x5 Spacer x 3
eBom-FreeParts.step
NavIC
AHT15- Temperature and humidity sensor
NRF24L01L
Antenna base
Antenna top
