tar7operator/Pinaka/16. CAD V5/Payload Assembly/V2/Payload Assembly.SLDASM

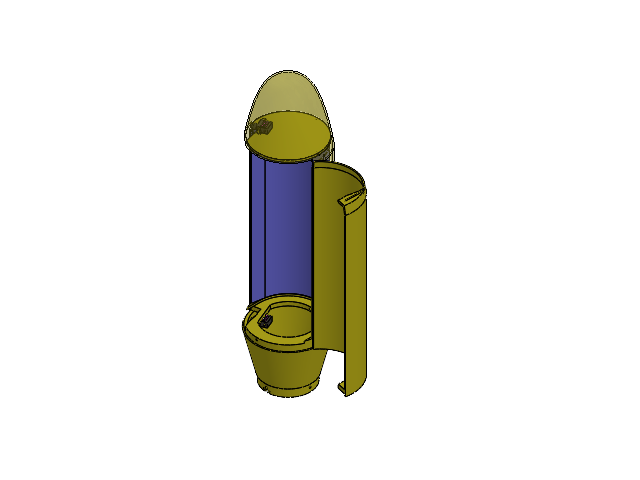
[picture p270: CAD file, 2025-05-20]
16. CAD V5/Payload Assembly/V2/Payload Assembly.SLDASM
Transition Cone
NoseCone
NoseConeCover
NosePlate
axe x 2
base001 x 2
etiquette x 2
Tube x 2
Cylindre x 2
Tube001 x 2
Tube002 x 2
etiquette001 x 2
Cylindre001 x 2
Cylindre002 x 2
MG90S_arm01 x 2
socket button head screw_iso x 3
Payload Ejection Elastic
