tar7operator/Pinaka/21.Cansat/CAD V2/Camera Plate Assembly.SLDASM

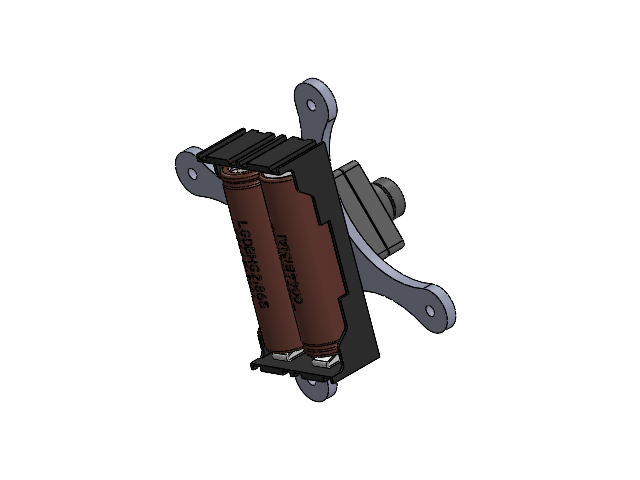
[picture p271: CAD file, 2025-01-12]
21.Cansat/CAD V2/Camera Plate Assembly.SLDASM
ArduCam
CameraPlate
Battery Holder
18650 Battery_1 x 2
