tar7operator/Pinaka/18. Test Models/TestModel-Body Tube.SLDASM

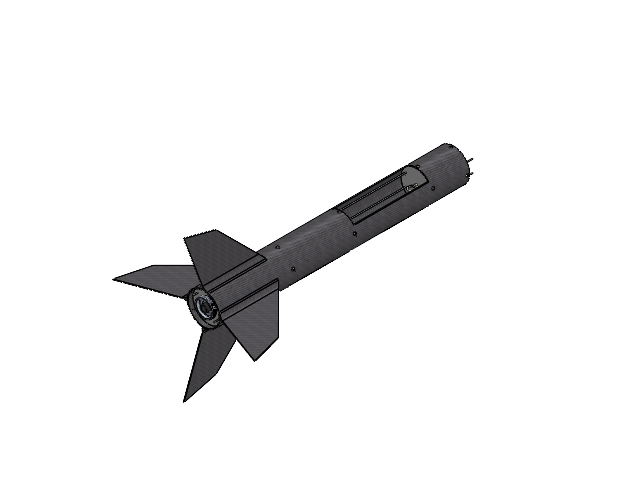
[picture p272: CAD file, 2024-11-22]
18. Test Models/TestModel-Body Tube.SLDASM
TestModel-bodyCover
TestModel-ThrustPlate
TestModel-Aerotech H148 Motor Case
TestModel-Aerotech H148 Nozzle
TestModel-Aerotech H148 Nozzle Nut
TestModel-Aerotech H148 Top Nut
TestModel-parachutePlate x 2
TestModel-Eye bolt 6mm x 2
TestModel-Rod x 4
TestModel-CenteringPlate x 3
TestModel-Fin x 4
socket head cap screw_iso
socket button head screw_iso x 15
