tar7operator/Pinaka/1. CAD PDR -- Do not Edit!/Transition Tube.SLDASM

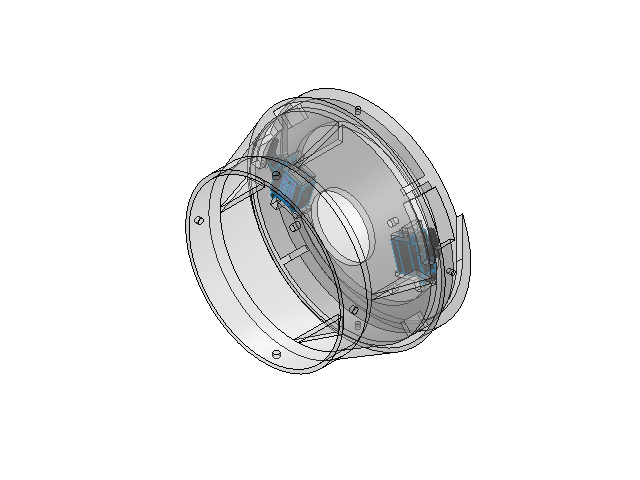
[picture p273: CAD file, 2024-11-05]
1. CAD PDR -- Do not Edit!/Transition Tube.SLDASM
TransitionZone
servoMotor x 2
shoulder x 2
socket head cap screw_iso x 4
