tar7operator/Pinaka/16. CAD V5/Rocket Motor Assembly/ThrustTech/Motor-ThrustTech.SLDASM

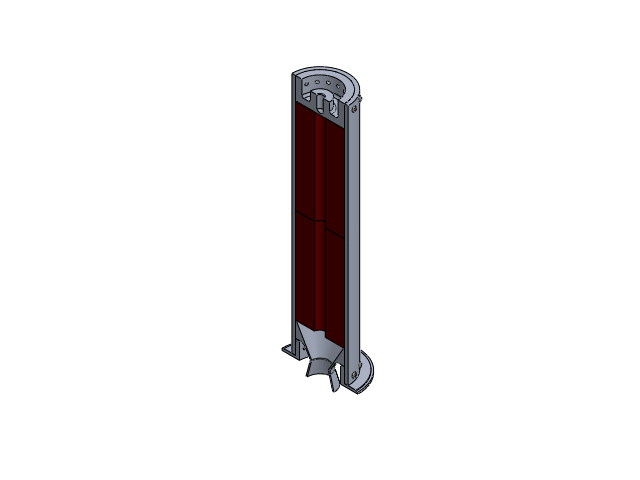
[picture p274: CAD file, 2025-05-20]
16. CAD V5/Rocket Motor Assembly/ThrustTech/Motor-ThrustTech.SLDASM
Casing
End Cap
Nozzle
Fuel Core x 2
Thrust Cap
socket button head screw_iso x 28
