tar7operator/Pinaka/16. CAD V5/Electronics Bay Assembly/Electronics/Battery 18650 +holder.SLDASM

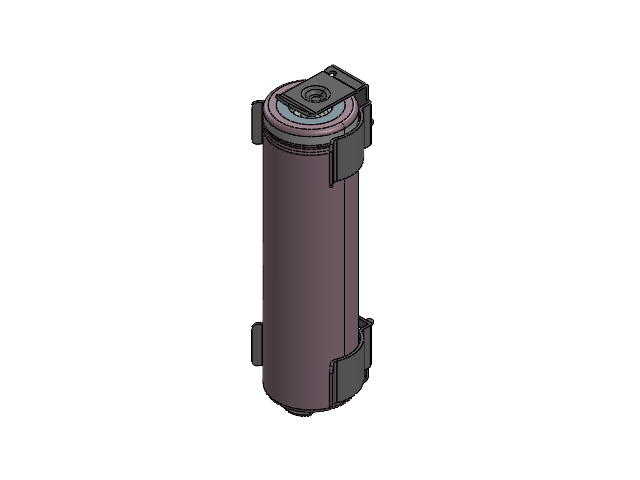
[picture p275: CAD file, 2024-12-22]
16. CAD V5/Electronics Bay Assembly/Electronics/Battery 18650 +holder.SLDASM
battery.stp
Battery connector 18650.stp x 2
