tar7operator/Pinaka/1. CAD PDR -- Do not Edit!/Nose Cone.SLDASM

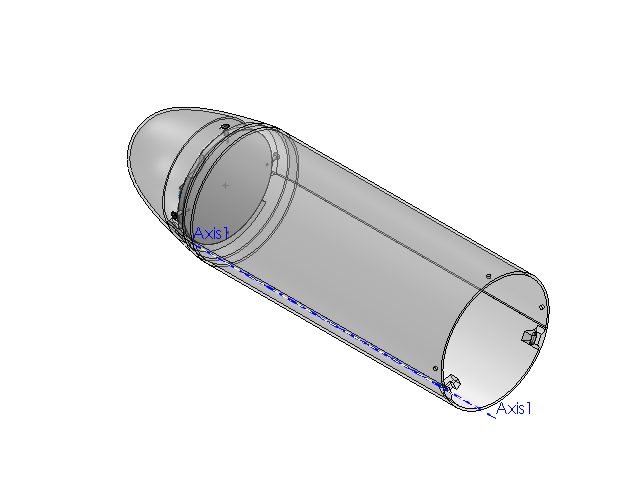
[picture p276: CAD file, 2024-11-05]
1. CAD PDR -- Do not Edit!/Nose Cone.SLDASM
CansatCover
Flaps
NosePlate
servoMotor x 2
shoulder x 2
socket head cap screw_iso x 4
countersunk flat head cross recess screw_iso x 3
