tar7operator/Pinaka/16. CAD V5/Body Assembly/Body Assembly.SLDASM

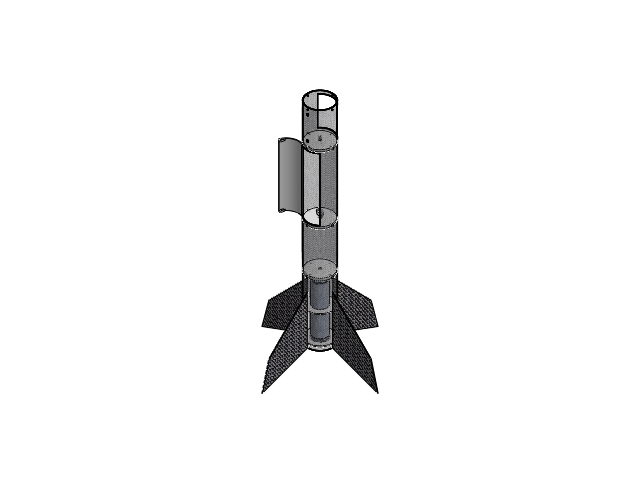
[picture p277: CAD file, 2025-01-08]
16. CAD V5/Body Assembly/Body Assembly.SLDASM
BodyTube
Thrust Plate
Aerotech H148 Motor Case
Aerotech H148 Nozzle
Aerotech H148 Nozzle Nut
Aerotech H148 Top Nut
Centering Ring x 2
Fin x 4
Bottom Parachute Plate x 2
M6 26mm Shank x 2
Hex nut M6 H5.2 x 2
M5 12MM HEX HEAD x 4
M4 10MM x 8
Parachute Bay Cover
