tar7operator/Pinaka/16. CAD V5/Electronics Bay Assembly/Electronics/XB3-UFL-MMT.SLDASM

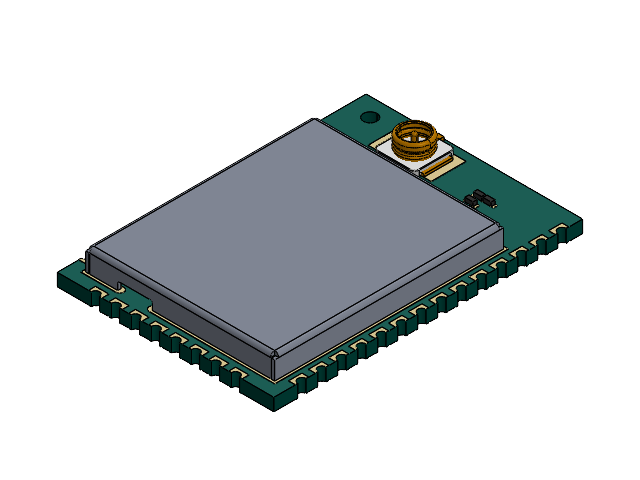
[picture p278: CAD file, 2024-12-22]
16. CAD V5/Electronics Bay Assembly/Electronics/XB3-UFL-MMT.SLDASM
30008432-03_A_A.STEP
60001461-01_A_2.STEP
18000258.STEP
0201-resistor_A_1.STEP x 5
