tar7operator/Pinaka/16. CAD V5/Electronics Bay Assembly/Electronics/nrf24l01.SLDASM

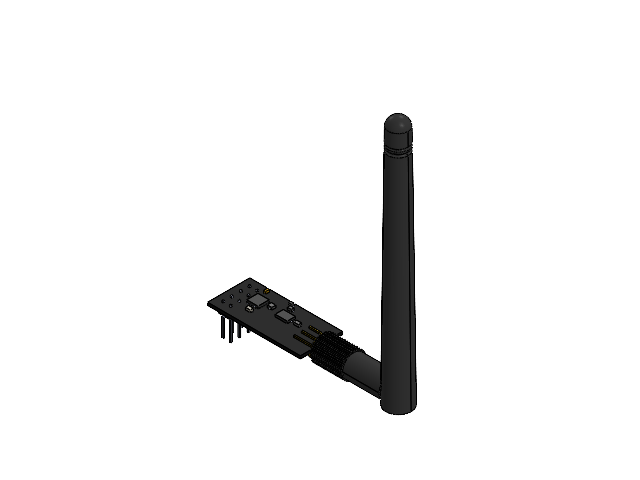
[picture p279: CAD file, 2024-09-30]
16. CAD V5/Electronics Bay Assembly/Electronics/nrf24l01.SLDASM
RFID.STEP
antena bawah.STEP
antena atas.STEP
