tar7operator/Pinaka/16. CAD V5/Payload Assembly/V2/NoseConeAssembly.SLDASM

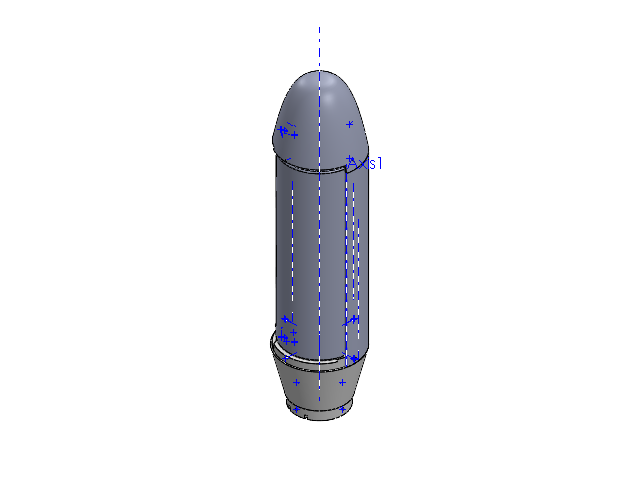
[picture p280: CAD file, 2025-01-05]
16. CAD V5/Payload Assembly/V2/NoseConeAssembly.SLDASM
NoseCone
NosePlate
Transition Cone
mg90s_arm01.step x 2
axe_1.step x 2
base001_1.step x 2
etiquette_1.step x 2
Tube_1.step x 2
Cylindre_1.step x 2
Tube001_1.step x 2
Tube002_1.step x 2
etiquette001_1.step x 2
Cylindre001_1.step x 2
Cylindre002_1.step x 2
socket button head screw_iso x 3
Dummy_CanSat
