tar7operator/Pinaka/21.Cansat/CAD V2/Cansat.SLDASM

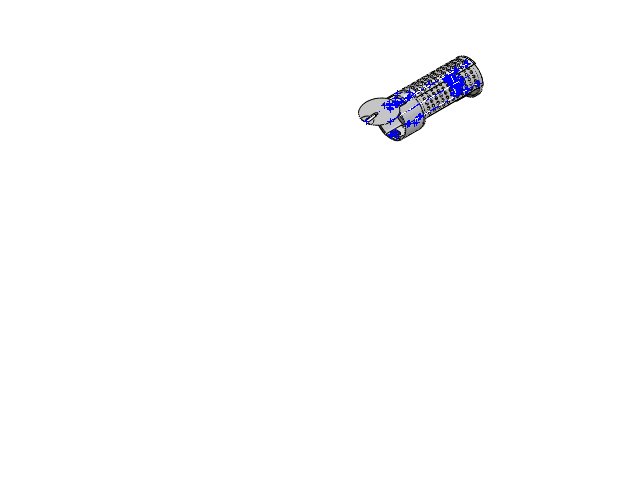
[picture p281: CAD file, 2025-01-09]
21.Cansat/CAD V2/Cansat.SLDASM
BottomPlate
CameraPlate
Battery Holder.stp
18650 Battery_1.stp x 2
ArduCam
ParachuteBay
HingeFlap x 2
axe_2.step
base001_2.step
etiquette_2.step
Tube_2.step
Cylindre_2.step
Tube001_2.step
Tube002_2.step
etiquette001_2.step
Cylindre001_2.step
Cylindre002_2.step
ParachuteCap
mg90s_arm01.step
M4 3.2 Hex nut x 18
rod x 4
bodyCover x 2
