tar7operator/Pinaka/16. CAD V5/Parachute Assembly/Top Parachute Plate Assembly.SLDASM

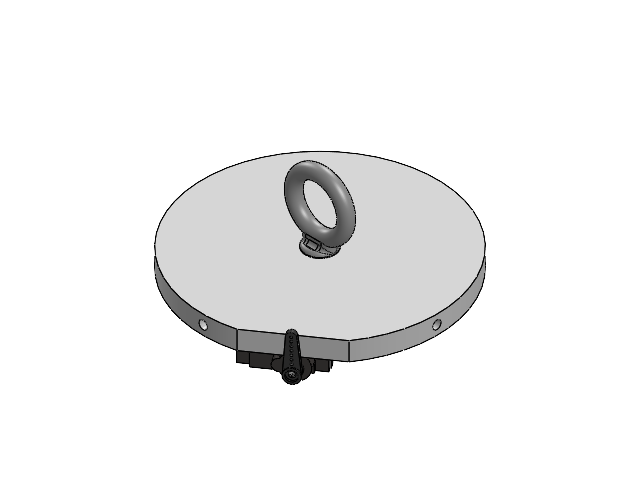
[picture p282: CAD file, 2025-01-08]
16. CAD V5/Parachute Assembly/Top Parachute Plate Assembly.SLDASM
Bottom Parachute Plate
M6 26mm Shank
Hex nut M6 H5.2
axe.step
base001.step
etiquette.step
Tube.step
Cylindre.step
Tube001.step
Tube002.step
etiquette001.step
Cylindre001.step
Cylindre002.step
mg90s_arm01.step
