tar7operator/Pinaka/18. Test Models/TestModel-Nose Cone.SLDASM

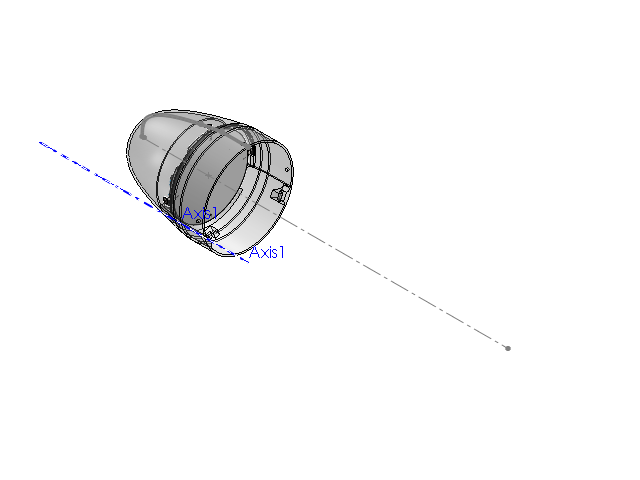
[picture p283: CAD file, 2024-11-22]
18. Test Models/TestModel-Nose Cone.SLDASM
TestModel-CansatCover
TestModel-Flaps
TestModel-NosePlate
TestModel-servoMotor x 2
TestModel-shoulder x 2
socket head cap screw_iso x 4
countersunk flat head cross recess screw_iso x 3
