tar7operator/Pinaka/1. CAD PDR -- Do not Edit!/Top Mechanism.SLDASM

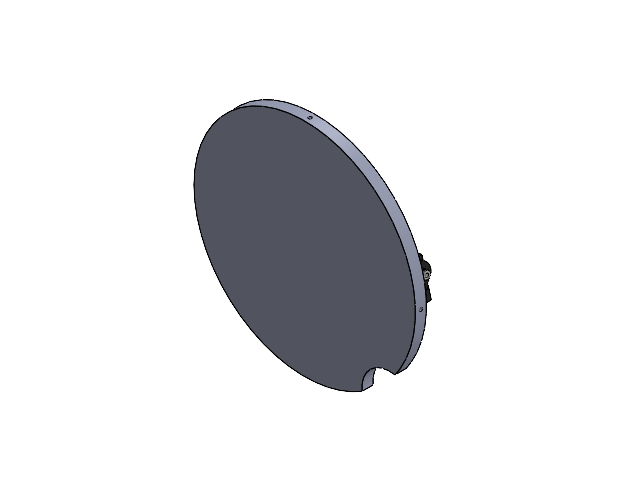
[picture p284: CAD file, 2024-11-01]
1. CAD PDR -- Do not Edit!/Top Mechanism.SLDASM
NosePlate
mg90s servo motor.stp x 2
