tar7operator/Pinaka/(list of files, cad)

Other CAD files:
11. CFD/Whole Body/cfdbody.SLDASM
16. CAD V5/Common/M90/M90S_ali(2).SLDASM
18. Test Models/TestModel-Antenna assy.SLDASM
11. CFD/Parachute/CansatMain/Main.SLDPRT
16. ST-CAD V4/ST-Assemblage Aerotech H148.SLDASM
16. CAD V5/Electronics Bay Assembly/Electronics/bmp-581.SLDASM
16. ST-CAD V4/ST-NRF24L01L+Antenna.SLDASM
18. Test Models/TestModel-Transition Tube.SLDASM
16. CAD V5/Parachute Assembly/M90S_ali(2).SLDASM
16. ST-CAD V4/ST-Body Tube.SLDASM
18. Test Models/TestModel-NRF24L01L+Antenna.SLDASM
1. CAD PDR -- Do not Edit!/Body Tube.SLDASM
18. Test Models/TestModel-MG90 Servo.SLDASM
1. CAD PDR -- Do not Edit!/MG90 Servo.SLDASM
16. ST-CAD V4/ST-Nose Cone.SLDASM
16. ST-CAD V4/ST-Antenna assy.SLDASM
18. Test Models/TestModel-Assemblage Aerotech H148.SLDASM
1. CAD PDR -- Do not Edit!/Assemblage Aerotech H148.SLDASM
10.FEA/Rocket/Parachute Plate/Parachute Plate v3.IGS
16. CAD V5/Top Parachute Plate/Top Parachute Plate.SLDPRT
18. Test Models/TestModel-NosePlate.SLDPRT
21.Cansat/Electronics Plate/Electronics.SLDPRT
1. CAD PDR -- Do not Edit!/Electronics/Electronics bay.SLDPRT
10.FEA/Rocket/Parachute Plate/Parachute Plate M6 2mm Grove.IGS
11. CFD/Whole Body/Transition 5 cm 130mm/cfdbody.IGS
16. CAD V5/Common/Battery and Holder/Battery Holder.SLDPRT
18. Test Models/TestModel-Electronics Tray.SLDPRT
21.Cansat/CAD V2/STL/HingeFlap.STL
21.Cansat/CAD V2/Stud Spacer.SLDPRT
laser Cutting/10cmPCB.SLDPRT
1. CAD PDR -- Do not Edit!/Electronics/Electronics casing v2.SLDPRT
1. CAD PDR -- Do not Edit!/STL/Payload bay door.STL
11. CFD/Parachute/CansatMain/sheet.SLDPRT
0. 3D Printing/Cansat Flap.STL
0. 3D Printing/Fin.STL
0. 3D Printing/ParachuteBay.SLDPRT
1. CAD PDR -- Do not Edit!/Accesories/M6 hex nut.STEP
1. CAD PDR -- Do not Edit!/Accesories/countersunk-screw-flat-head-m2-1.snapshot.1/M2 x 10mm.step
1. CAD PDR -- Do not Edit!/Accesories/countersunk-screw-flat-head-m2-1.snapshot.1/M2 x 12mm.step
1. CAD PDR -- Do not Edit!/Accesories/countersunk-screw-flat-head-m2-1.snapshot.1/M2 x 4mm.step
1. CAD PDR -- Do not Edit!/Accesories/countersunk-screw-flat-head-m2-1.snapshot.1/M2 x 5mm.step
1. CAD PDR -- Do not Edit!/Accesories/countersunk-screw-flat-head-m2-1.snapshot.1/M2 x 6mm.step
1. CAD PDR -- Do not Edit!/Accesories/countersunk-screw-flat-head-m2-1.snapshot.1/M2 x 8mm.step
1. CAD PDR -- Do not Edit!/Accesories/m3 hex nut 2.4.STEP
1. CAD PDR -- Do not Edit!/Accesories/m3 x 12 hex button hd.STEP
1. CAD PDR -- Do not Edit!/Accesories/m4 x 12 hex button hd.STEP
1. CAD PDR -- Do not Edit!/Accesories/mg90s-servo-motor-2.snapshot.6/MG90S Servo Motor.ipt
1. CAD PDR -- Do not Edit!/Accesories/mg90s-servo-motor-2.snapshot.6/Tower Pro Servo Adapter Horn Plate - Subtract Shaft.ipt
1. CAD PDR -- Do not Edit!/Accesories/mg90s-servo-motor-2.snapshot.6/Tower Pro Servo Spline Shaft End.ipt
1. CAD PDR -- Do not Edit!/CansatCover.SLDPRT
1. CAD PDR -- Do not Edit!/Electronics/BMP581.step
1. CAD PDR -- Do not Edit!/Electronics/Battery 18650.stp
1. CAD PDR -- Do not Edit!/Electronics/Electronics Tray V2.SLDPRT
1. CAD PDR -- Do not Edit!/Electronics/SparkFun_IMU_Breakout_ICM 20948 v4.f3d
1. CAD PDR -- Do not Edit!/M4 socket button head screw_iso.SLDPRT
1. CAD PDR -- Do not Edit!/M6 hex nut.STEP
1. CAD PDR -- Do not Edit!/STL/CenteringPlate.STL
1. CAD PDR -- Do not Edit!/STL/Payload Bay.STL
1. CAD PDR -- Do not Edit!/STL/Recovery Bay Door.STL
1. CAD PDR -- Do not Edit!/STL/Recovery bay bulkheads.SLDPRT
1. CAD PDR -- Do not Edit!/STL/Recovery bay bulkheads.STL
1. CAD PDR -- Do not Edit!/STL/Transition tube.STL
1. CAD PDR -- Do not Edit!/ThrustPlate.SLDPRT
1. CAD PDR -- Do not Edit!/bodyCover.SLDPRT
1. CAD PDR -- Do not Edit!/countersunk flat head cross recess screw_iso.SLDPRT
1. CAD PDR -- Do not Edit!/m4 x 12 hex button hd.STEP
1. CAD PDR -- Do not Edit!/socket button head screw_iso.SLDPRT
1. CAD PDR -- Do not Edit!/socket head cap screw_iso.SLDPRT
10.FEA/Rocket/Nose Cone/Nose Cone.IGS
10.FEA/Rocket/Parachute Plate/Bottom Parachute Plate Assembly.IGS
10.FEA/Rocket/PayloadBay/NoseConeAssemblyV2.IGS
11. CFD/Parachute/CansatMain/v1/Main.IGS
11. CFD/Parachute/Drogue/Drogue.IGS
11. CFD/Parachute/Drogue/DrogueFlat.SLDPRT
11. CFD/Parachute/Drogue/Flat Drogue.SLDDRW
11. CFD/Parachute/Rocketmain/RockMain.IGS
11. CFD/Whole Body/Transition 100mm/cfdbody_10cm_Transition.IGS
11. CFD/Whole Body/Transition 120cm/cfdbody_12cm_Transition.IGS
16. CAD V5/Body Assembly/BodyTube-Surface-Flatten2.SLDPRT
16. CAD V5/Body Assembly/Centering Ring.SLDPRT
16. CAD V5/Body Assembly/Fin Cutting Layout.SLDPRT
16. CAD V5/Body Assembly/Fin.SLDPRT
16. CAD V5/Body Assembly/Folded parachute.SLDPRT
16. CAD V5/Body Assembly/Parachute Bay Cover.SLDPRT
16. CAD V5/Body Assembly/Parachute Bay Cover.STEP
16. CAD V5/Body Assembly/Parachute Ejection Elastic.SLDPRT
16. CAD V5/Body Assembly/Parchute Bay Locking Lugs.SLDPRT
16. CAD V5/Body Assembly/body flatten.SLDDRW
16. CAD V5/Common/Battery and Holder/18650 Battery_1.SLDPRT
16. CAD V5/Common/Bidirectional shoulder.STEP
16. CAD V5/Common/Cylindre001_1.step.SLDPRT
16. CAD V5/Common/Cylindre002_1.step.SLDPRT
16. CAD V5/Common/Cylindre_1.step.SLDPRT
16. CAD V5/Common/Eye bolt 6mm.SLDPRT
16. CAD V5/Common/Hex M8 H6.4.SLDPRT
16. CAD V5/Common/Hex nut M6 H5.2.SLDPRT
16. CAD V5/Common/M2 Head Hex.SLDPRT
16. CAD V5/Common/M2x5 Spacer.SLDPRT
16. CAD V5/Common/M4 10MM HEX SOCKET BUTTON HEAD.SLDPRT
16. CAD V5/Common/M4 3.2 Hex nut.SLDPRT
16. CAD V5/Common/M5 12MM HEX SOCKET BUTTON HEAD.SLDPRT
16. CAD V5/Common/M6 15mm Shank.SLDPRT
16. CAD V5/Common/M8 Bolt.SLDPRT
16. CAD V5/Common/M8 UBolt.SLDPRT
16. CAD V5/Common/M90/Cylindre.SLDPRT
16. CAD V5/Common/M90/Cylindre001.SLDPRT
16. CAD V5/Common/M90/Cylindre002.SLDPRT
16. CAD V5/Common/M90/MG90S_arm02.SLDPRT
16. CAD V5/Common/M90/Tube.SLDPRT
16. CAD V5/Common/M90/Tube001.SLDPRT
16. CAD V5/Common/M90/Tube002.SLDPRT
16. CAD V5/Common/M90/axe.SLDPRT
16. CAD V5/Common/M90/base001.SLDPRT
16. CAD V5/Common/M90/bidirectional shoulder.SLDPRT
16. CAD V5/Common/M90/etiquette.SLDPRT
16. CAD V5/Common/M90/etiquette001.SLDPRT
16. CAD V5/Common/Tube001_1.step.SLDPRT
16. CAD V5/Common/Tube002_1.step.SLDPRT
16. CAD V5/Common/Tube_1.step.SLDPRT
16. CAD V5/Common/axe_1.step.SLDPRT
16. CAD V5/Common/base001_1.step.SLDPRT
16. CAD V5/Common/countersunk flat head cross recess screw_iso.SLDPRT
16. CAD V5/Common/etiquette001_1.step.SLDPRT
16. CAD V5/Common/etiquette_1.step.SLDPRT
16. CAD V5/Common/socket button head screw_iso.SLDPRT
16. CAD V5/Drawings/Body Assembly/BodyTube-Surface-Flatten2.SLDDRW
16. CAD V5/Drawings/Body Assembly/Fin.SLDDRW
16. CAD V5/Drawings/CanSat/Parachute Bay Assembly.SLDDRW
16. CAD V5/Drawings/Parachute Plate Assembly/Top Parachute Plate Assembly.SLDDRW
16. CAD V5/Drawings/Payload Assembly/Payload Assembly.SLDDRW
16. CAD V5/Drawings/Payload Assembly/Payload Body-Surface-Flatten2.SLDDRW
16. CAD V5/Electronics Bay Assembly/Electronics Bay Assembly.SLDDRW
16. CAD V5/Electronics Bay Assembly/Electronics Tray Guide Rail.SLDPRT
16. CAD V5/Electronics Bay Assembly/Electronics/BMP581.SLDASM
16. CAD V5/Electronics Bay Assembly/Electronics/Battery Holder/18650 Li Ion Battery.SLDPRT
16. CAD V5/Electronics Bay Assembly/Electronics/Battery Holder/18650_LI-ON_Battery_Holder_1042P.SLDASM
16. CAD V5/Electronics Bay Assembly/Electronics/Battery Holder/18650_LI-ON_Battery_Holder_1042P_Base.SLDPRT
16. CAD V5/Electronics Bay Assembly/Electronics/Battery Holder/18650_LI-ON_Battery_Holder_1042P_Leaf_Spring_Contact.SLDPRT
16. CAD V5/Electronics Bay Assembly/Electronics/Battery Holder/18650_LI-ON_Battery_Holder_1042P_Polarized_Contact.SLDPRT
16. CAD V5/Electronics Bay Assembly/Electronics/Bharat Pi.SLDPRT
16. CAD V5/Electronics Bay Assembly/Electronics/BharatPi.SLDPRT
16. CAD V5/Electronics Bay Assembly/Electronics/JST-XH-2-54mm connectors/SMD Horizontal/JST - XH - SMD (R) - 10Pin - 2.54mm.stp
16. CAD V5/Electronics Bay Assembly/Electronics/JST-XH-2-54mm connectors/SMD Horizontal/JST - XH - SMD (R) - 11Pin - 2.54mm.stp
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
