tar7operator/Pinaka/16. CAD V5/Drawings/Avionics Bay/Avionics Bay Assembly_page-0001.jpg

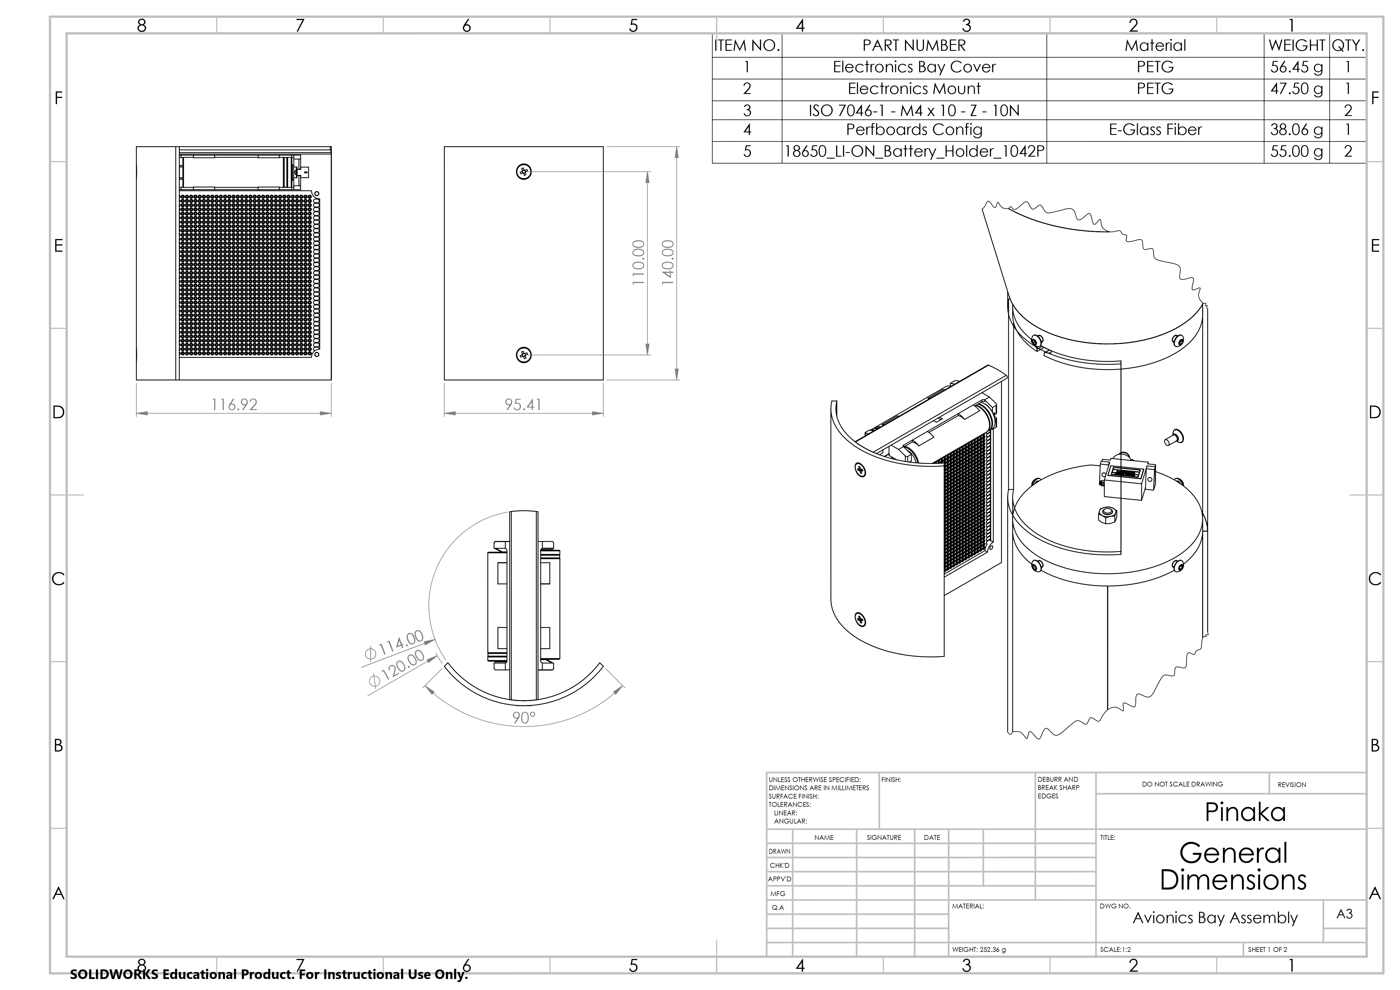
16. CAD V5/Drawings/Avionics Bay/Avionics Bay Assembly_page-0001.jpg
