tar7operator/Pinaka/16. CAD V5/Drawings/Avionics Bay/Avionics Bay Assembly_page-0002.jpg

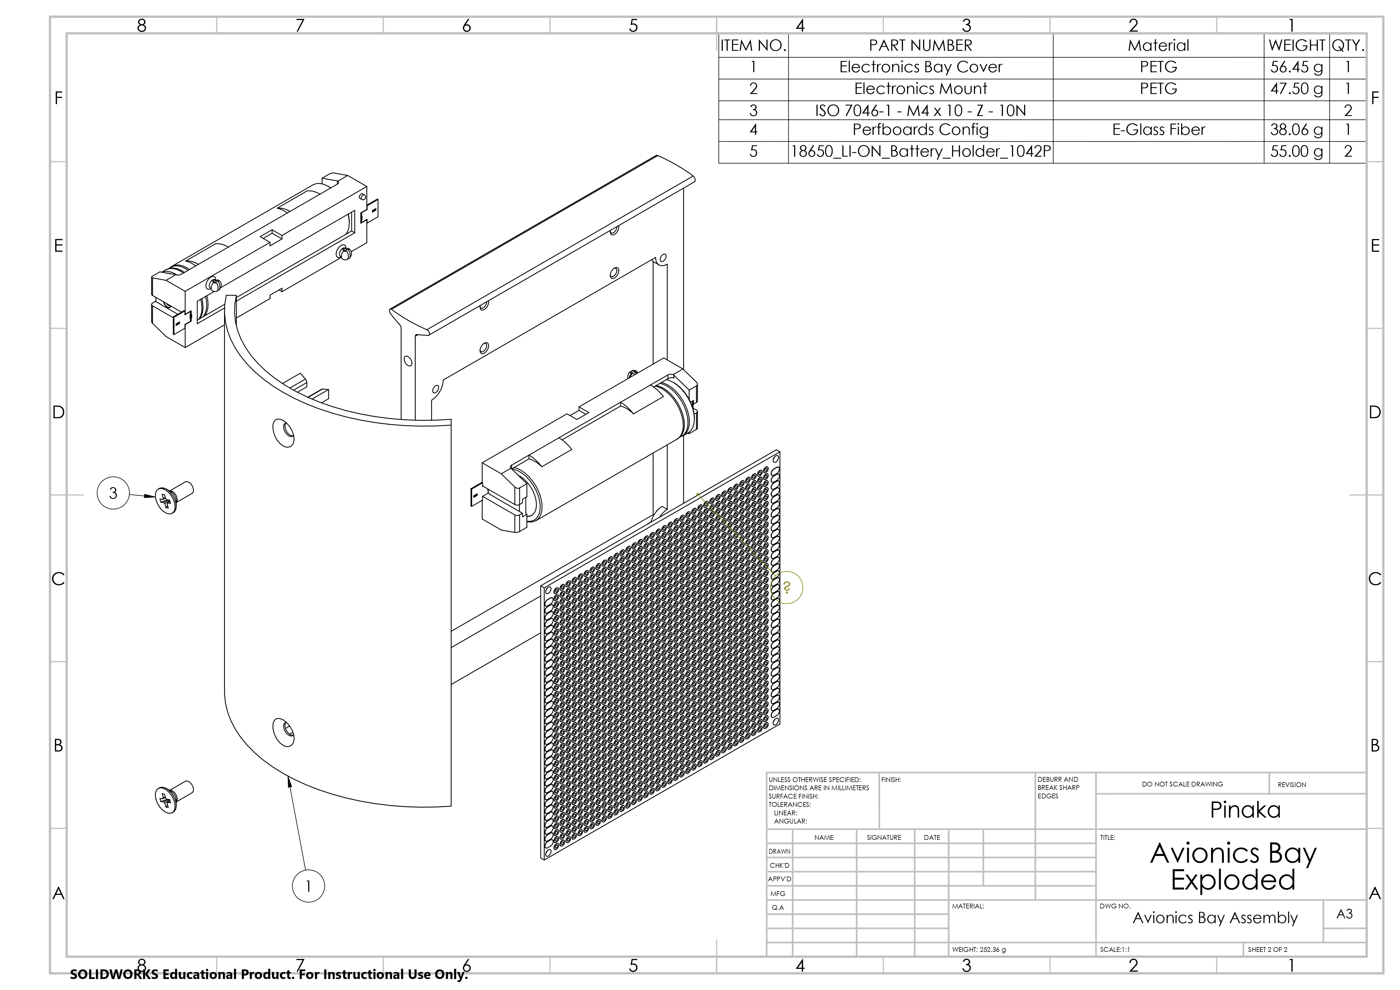
16. CAD V5/Drawings/Avionics Bay/Avionics Bay Assembly_page-0002.jpg
