tar7operator/Pinaka/16. CAD V5/Drawings/Body Assembly/Fin_page-0001.jpg

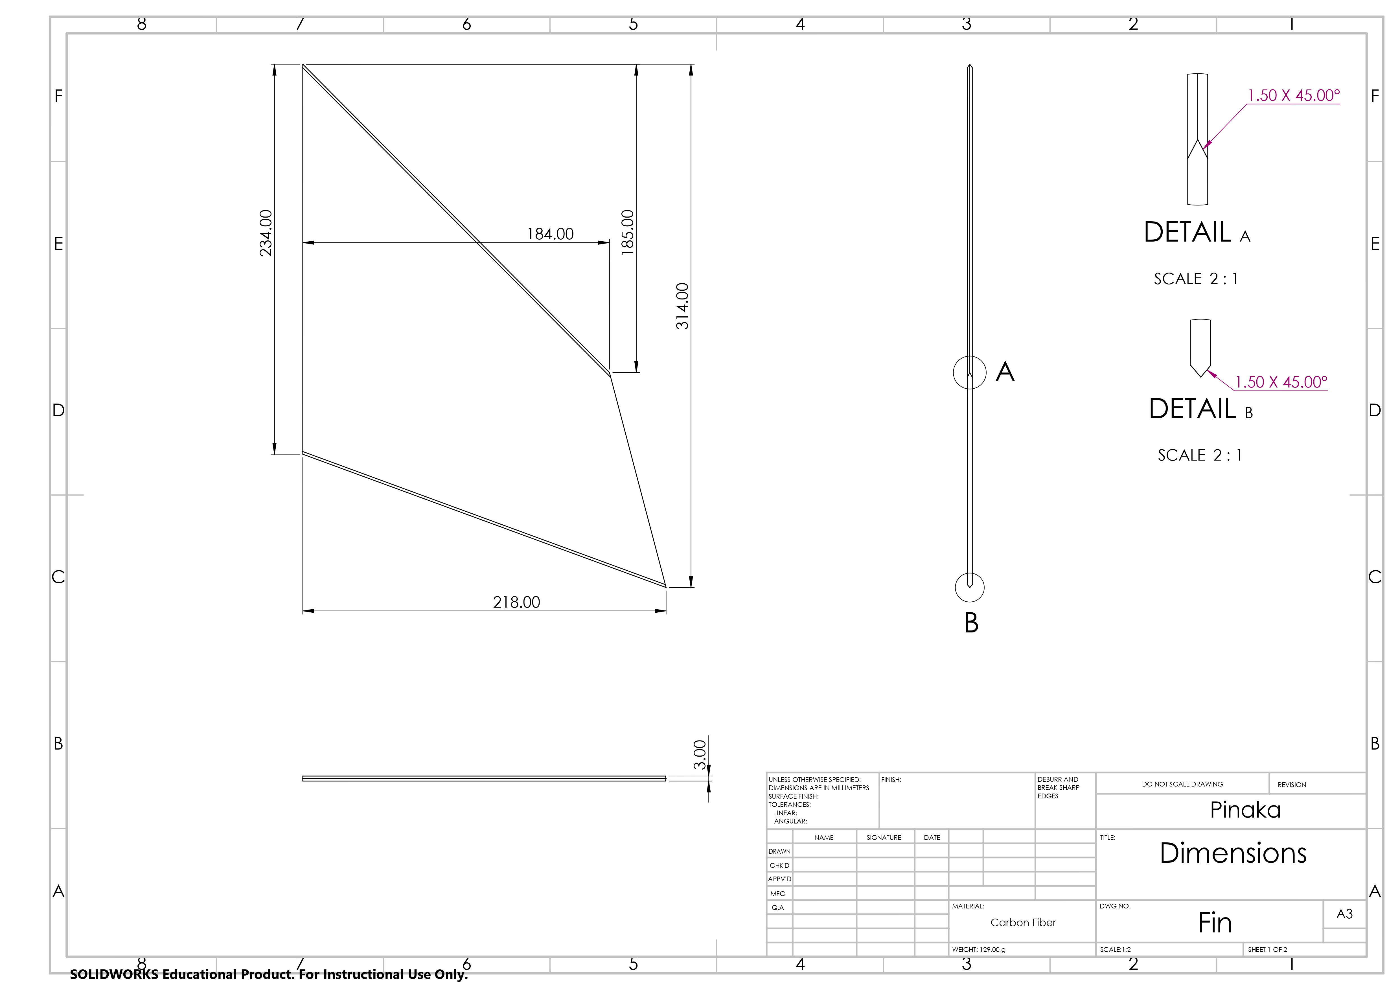
16. CAD V5/Drawings/Body Assembly/Fin_page-0001.jpg
