tar7operator/Pinaka/16. CAD V5/Drawings/Body Assembly/Fin_page-0002.jpg

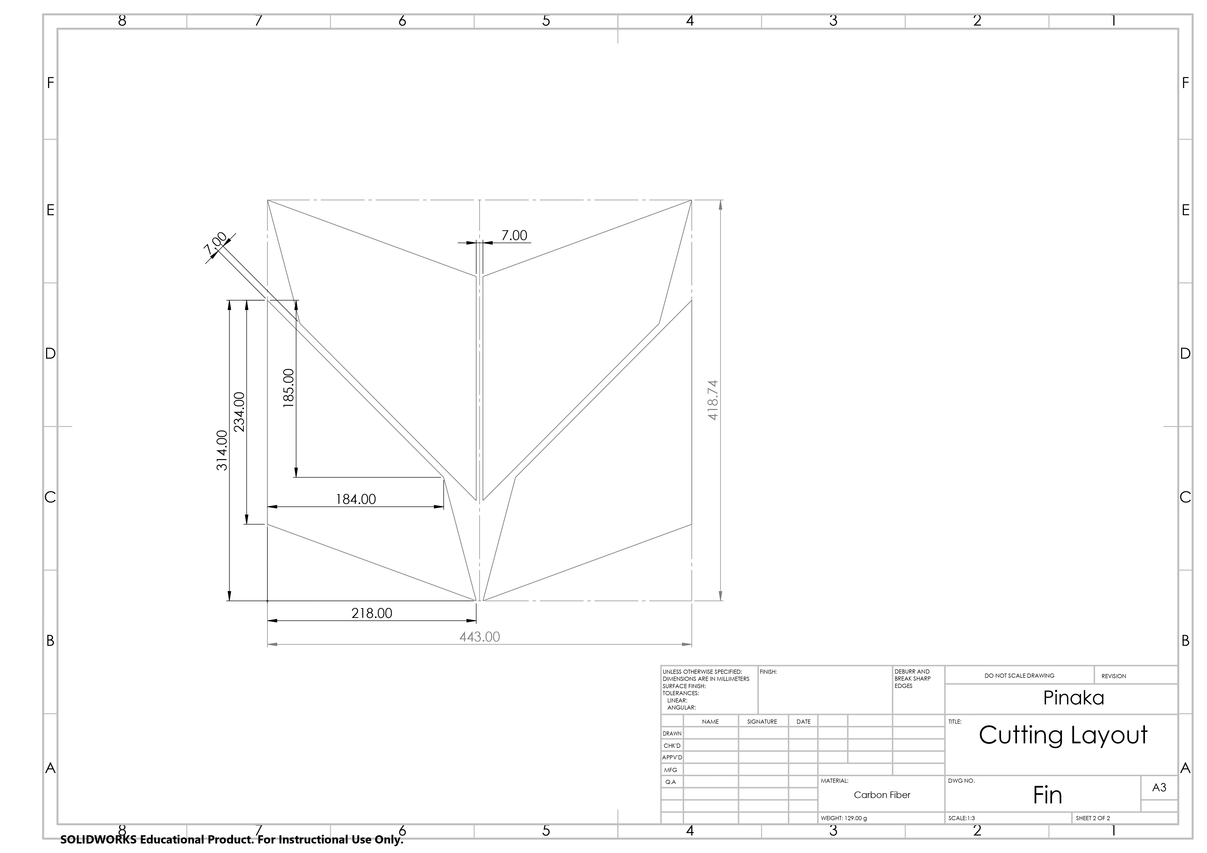
16. CAD V5/Drawings/Body Assembly/Fin_page-0002.jpg
