tar7operator/Pinaka/16. CAD V5/Drawings/Body Assembly/Motor Bay_page-0001.jpg

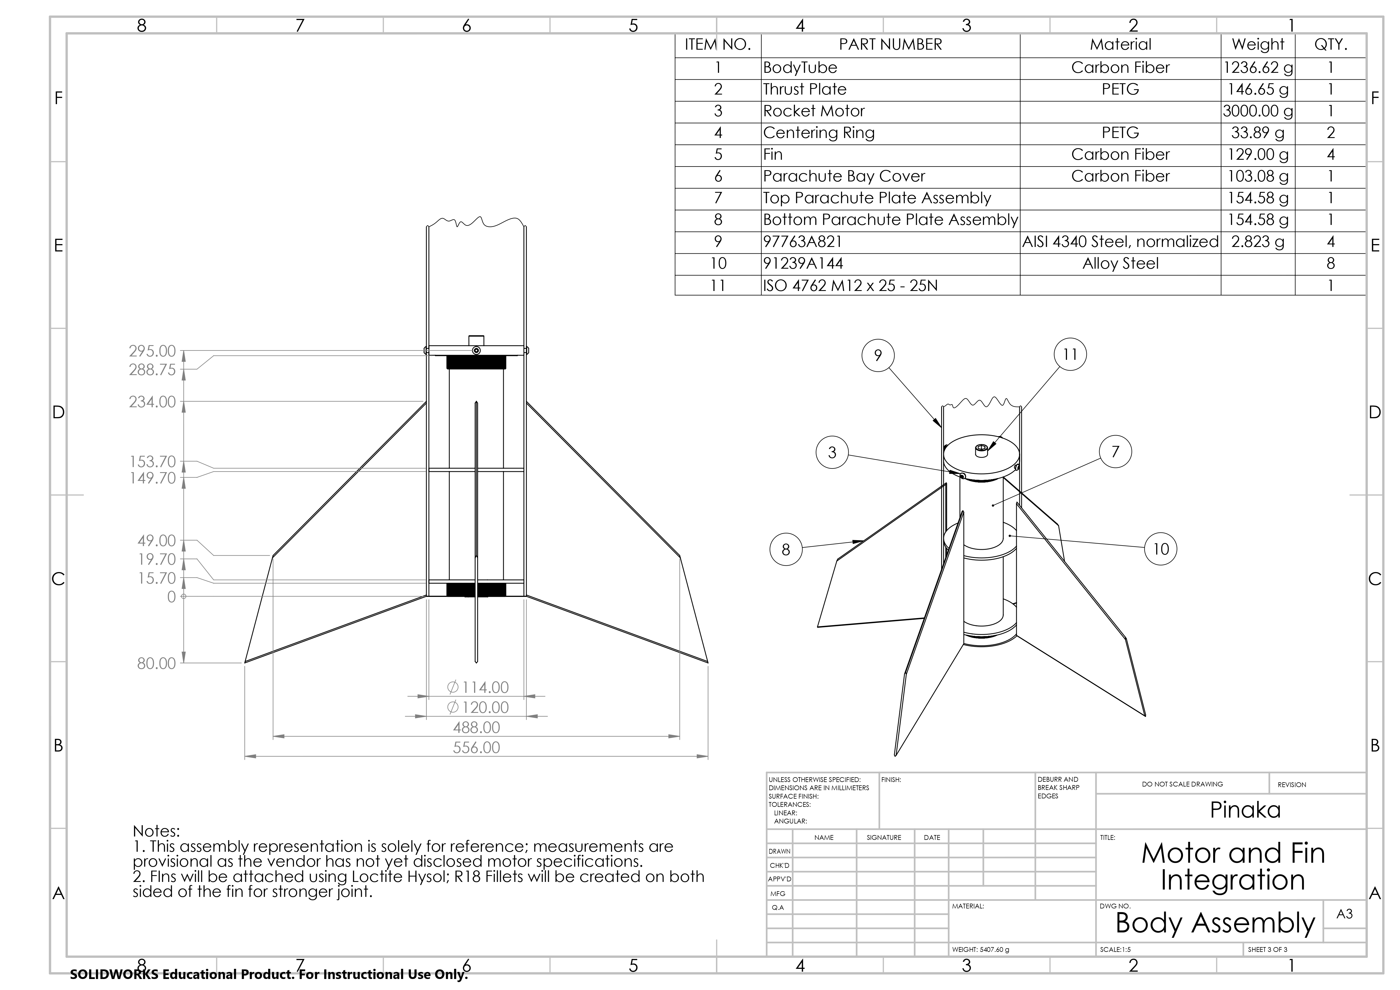
16. CAD V5/Drawings/Body Assembly/Motor Bay_page-0001.jpg
