tar7operator/Pinaka/16. CAD V5/Drawings/CanSat/Reaction wheel assembly.PNG

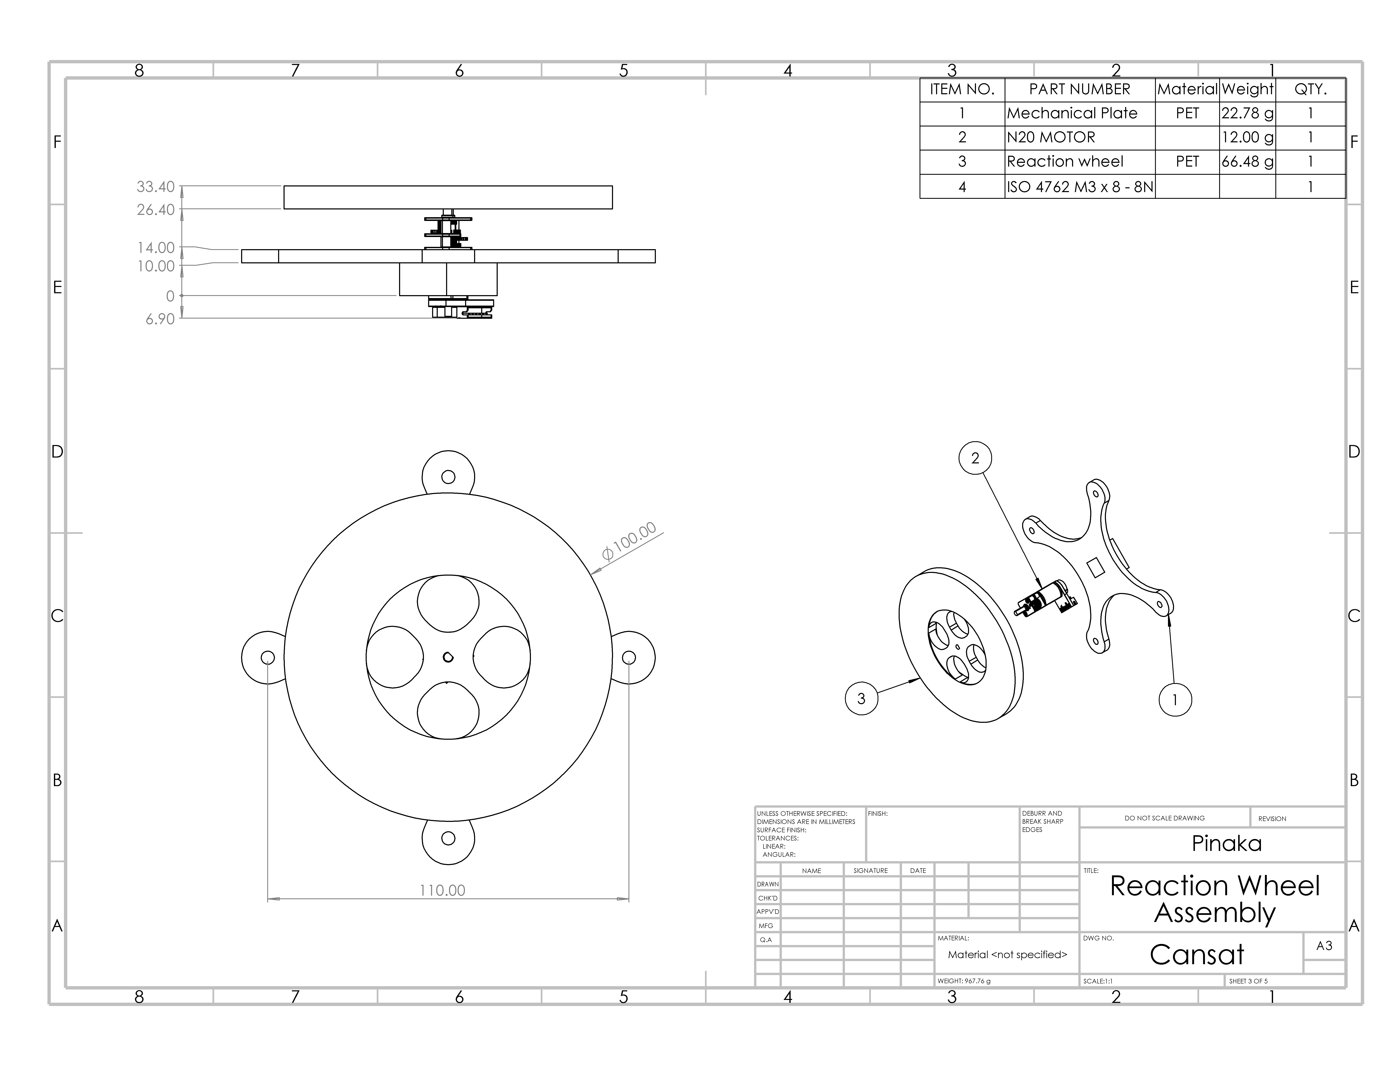
16. CAD V5/Drawings/CanSat/Reaction wheel assembly.PNG
