tar7operator/Pinaka/16. CAD V5/Drawings/Doc/Body Assembly.PNG

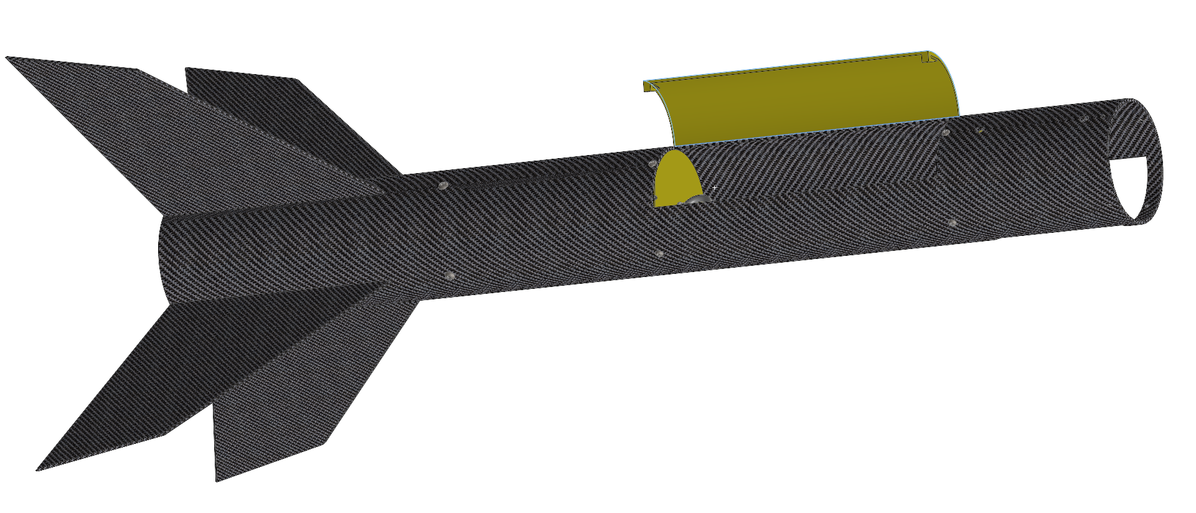
16. CAD V5/Drawings/Doc/Body Assembly.PNG
