tar7operator/Pinaka/16. CAD V5/Drawings/Doc/NoseConeAssembly.PNG

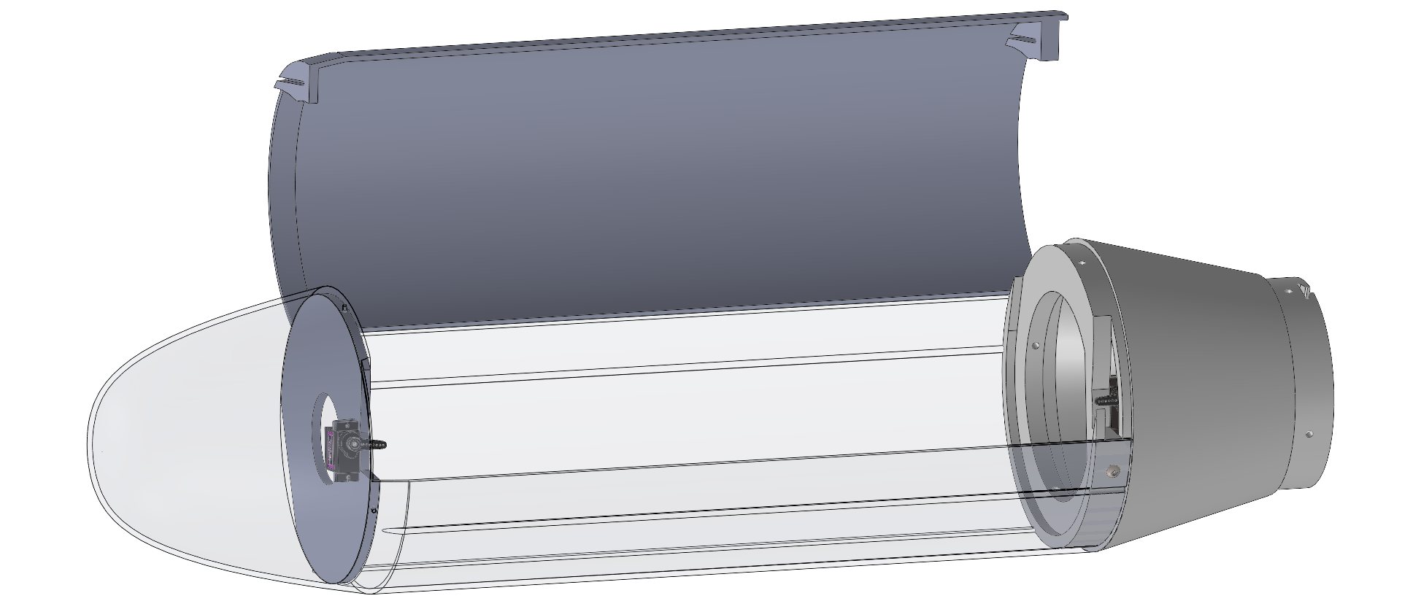
16. CAD V5/Drawings/Doc/NoseConeAssembly.PNG
