tar7operator/Pinaka/16. CAD V5/Drawings/Parachute Plate Assembly/Top Parachute Plate_page-0001.jpg

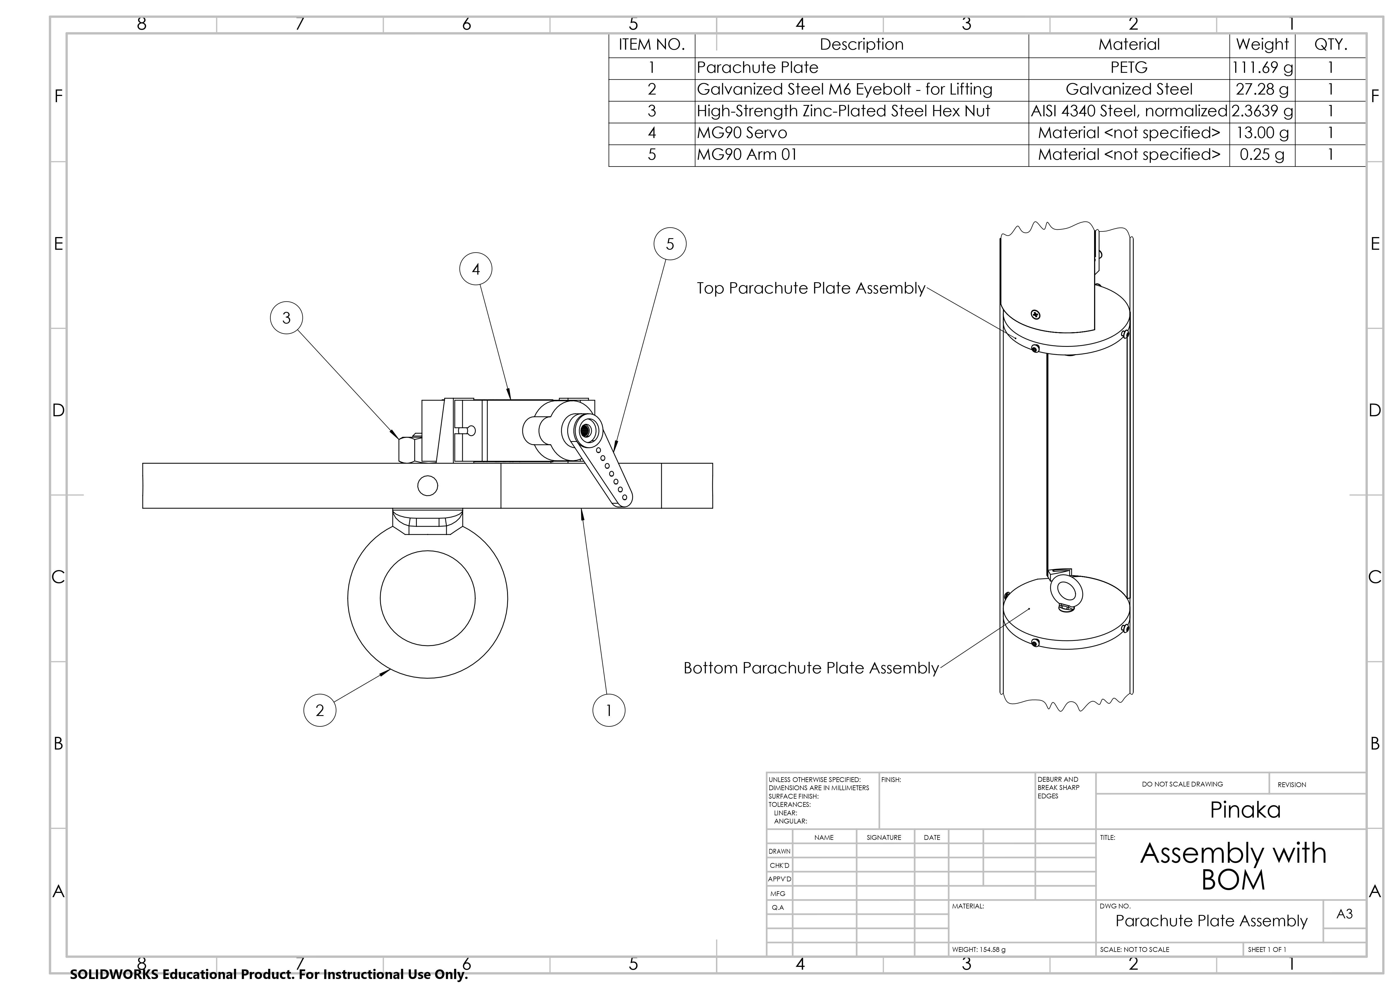
16. CAD V5/Drawings/Parachute Plate Assembly/Top Parachute Plate_page-0001.jpg
