tar7operator/Pinaka/16. CAD V5/Drawings/Payload Assembly/Payload Assembly_page-0001.jpg

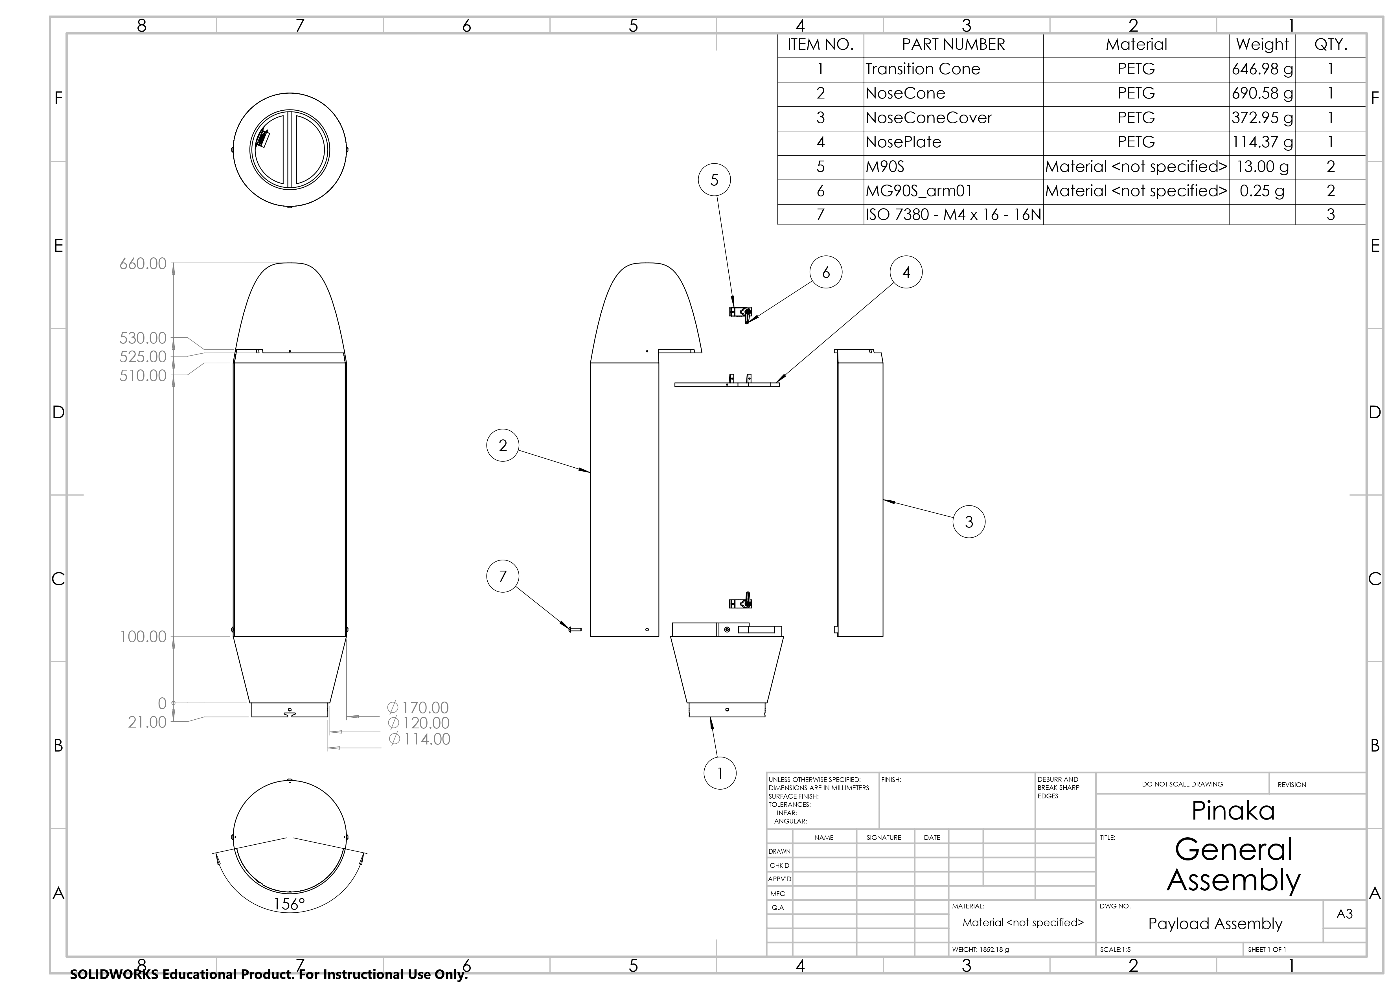
16. CAD V5/Drawings/Payload Assembly/Payload Assembly_page-0001.jpg
