tar7operator/Pinaka/16. CAD V5/Parachute Assembly/PerformanceLog.txt

Number of Contacts: 10
Number of contact data: 13349
