tar7operator/Pinaka/16. CAD V5/Top Parachute Plate/PerformanceLog.txt

Number of Contacts: 10
Number of contact data: 1312
