tar7operator/Pinaka/16. CAD V5/Simulation/PerformanceLog.txt

Number of Contacts: 29
Number of contact data: 4742
