tar7operator/Pinaka/11. CFD/Parachute/CansatMain/simscale/Test 3 - 2.75 ms/Forces_and_moments_1.csv

Time (s) | POROUS_FORCE_X | POROUS_FORCE_Y | POROUS_FORCE_Z | PRESSURE_FORCE_X | PRESSURE_FORCE_Y | PRESSURE_FORCE_Z | TOTAL_FORCE_X | TOTAL_FORCE_Y | TOTAL_FORCE_Z | VISCOUS_FORCE_X | VISCOUS_FORCE_Y | VISCOUS_FORCE_Z
1 | 0.00E+00 | 0.00E+00 | 0.00E+00 | 4.65E-03 | 2.73E+00 | 6.06E-03 | 4.65E-03 | 2.73E+00 | 6.05E-03 | -8.03E-07 | 1.04E-04 | -9.98E-07
2 | 0.00E+00 | 0.00E+00 | 0.00E+00 | 6.25E-02 | 4.66E+01 | 9.16E-02 | 6.21E-02 | 4.66E+01 | 9.11E-02 | -3.86E-04 | 4.37E-02 | -4.66E-04
3 | 0.00E+00 | 0.00E+00 | 0.00E+00 | -1.10E-01 | 5.48E+01 | -2.05E-01 | -1.11E-01 | 5.48E+01 | -2.05E-01 | -5.75E-04 | 4.54E-02 | -6.76E-04
4 | 0.00E+00 | 0.00E+00 | 0.00E+00 | -2.37E-01 | 1.47E+01 | -3.13E-01 | -2.37E-01 | 1.47E+01 | -3.14E-01 | -5.07E-04 | 4.52E-02 | -3.30E-04 | 1.07E+01
5 | 0.00E+00 | 0.00E+00 | 0.00E+00 | -2.25E-01 | -1.74E+01 | -2.50E-01 | -2.26E-01 | -1.74E+01 | -2.50E-01 | -5.26E-04 | 2.06E-02 | -2.06E-04 | -1.01E-02
6 | 0.00E+00 | 0.00E+00 | 0.00E+00 | -4.10E-02 | -1.64E+01 | -3.79E-02 | -4.27E-02 | -1.64E+01 | -3.93E-02 | -1.66E-03 | -8.74E-03 | -1.44E-03 | -5.75E-03
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
