tar7operator/Pinaka/11. CFD/Parachute/CansatMain/simscale/Test 1/Forces_and_moments_1.csv

Time (s) | POROUS_FORCE_X | POROUS_FORCE_Y | POROUS_FORCE_Z | PRESSURE_FORCE_X | PRESSURE_FORCE_Y | PRESSURE_FORCE_Z | TOTAL_FORCE_X | TOTAL_FORCE_Y | TOTAL_FORCE_Z | VISCOUS_FORCE_X | VISCOUS_FORCE_Y | VISCOUS_FORCE_Z
1 | 0.000000000000e+00 | 0.000000000000e+00 | 0.000000000000e+00 | 2.521113895407e-04 | 2.865835985217e+00 | -1.064720676854e-02 | 2.502963376186e-04 | 2.866140155160e+00 | -1.065280373986e-02 | -1.815051922154e-06 | 3.041699430429e-04 | -5.596971312159e-06
2 | 0.000000000000e+00 | 0.000000000000e+00 | 0.000000000000e+00 | 1.398744255394e-02 | 4.916698235439e+01 | -3.263032635972e-02 | 1.328984975460e-02 | 4.921549417997e+01 | -3.468445016529e-02 | -6.975927993366e-04 | 4.851182557895e-02 | -2.054123805572e-03
3 | 0.000000000000e+00 | 0.000000000000e+00 | 0.000000000000e+00 | -2.661176608297e-01 | 6.506773961143e+01 | -1.942610627362e-01 | -2.673757323025e-01 | 6.511683702770e+01 | -1.965809857260e-01 | -1.258071472797e-03 | 4.909741627107e-02 | -2.319922989771e-03
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
