tar7operator/Pinaka/11. CFD/Parachute/CansatMain/simscale/Test 2 - Refined/forces.csv

Time (s) | POROUS_FORCE_X | POROUS_FORCE_Y | POROUS_FORCE_Z | PRESSURE_FORCE_X | PRESSURE_FORCE_Y | PRESSURE_FORCE_Z | TOTAL_FORCE_X | TOTAL_FORCE_Y | TOTAL_FORCE_Z | VISCOUS_FORCE_X | VISCOUS_FORCE_Y | VISCOUS_FORCE_Z
1 | 0.000000000000e+00 | 0.000000000000e+00 | 0.000000000000e+00 | 5.076832340925e-03 | 2.977298903031e+00 | 6.605788757832e-03 | 5.075956823574e-03 | 2.977412420337e+00 | 6.604700127311e-03 | -8.755173515812e-07 | 1.135173056911e-04 | -1.088630520883e-06
2 | 0.000000000000e+00 | 0.000000000000e+00 | 0.000000000000e+00 | 7.036028305739e-02 | 5.396071237736e+01 | 1.054714067930e-01 | 6.993021686963e-02 | 5.401123812116e+01 | 1.049481158653e-01 | -4.300661877624e-04 | 5.052574379905e-02 | -5.232909277351e-04
3 | 0.000000000000e+00 | 0.000000000000e+00 | 0.000000000000e+00 | -1.439222971978e-01 | 6.538339815173e+01 | -2.582777663226e-01 | -1.445563467600e-01 | 6.543548564442e+01 | -2.590288968967e-01 | -6.340495622167e-04 | 5.208749269909e-02 | -7.511305741609e-04
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
