tar7operator/Pinaka/11. CFD/Parachute/CansatMain/simscale/Test 2 - Refined/moments.csv

Time (s) | POROUS_MOMENT_X | POROUS_MOMENT_Y | POROUS_MOMENT_Z | PRESSURE_MOMENT_X | PRESSURE_MOMENT_Y | PRESSURE_MOMENT_Z | TOTAL_MOMENT_X | TOTAL_MOMENT_Y | TOTAL_MOMENT_Z | VISCOUS_MOMENT_X | VISCOUS_MOMENT_Y | VISCOUS_MOMENT_Z
1 | 0.000000000000e+00 | 0.000000000000e+00 | 0.000000000000e+00 | -2.172603775478e-04 | -3.419120193429e-05 | 1.964764509260e-04 | -2.171381455358e-04 | -3.414502615692e-05 | 1.968477766440e-04 | 1.222320120105e-07 | 4.617577736891e-08 | 3.713257180252e-07
2 | 0.000000000000e+00 | 0.000000000000e+00 | 0.000000000000e+00 | -3.701221469883e-03 | -7.689322135666e-04 | 3.058703317502e-03 | -4.102663283614e-03 | -7.685130227748e-04 | 3.637480743264e-03 | -4.014418137306e-04 | 4.191907917383e-07 | 5.787774257625e-04
3 | 0.000000000000e+00 | 0.000000000000e+00 | 0.000000000000e+00 | 1.064679736811e-02 | -9.094266518903e-04 | -5.567528400954e-03 | 1.017443190942e-02 | -8.939582692678e-04 | -4.984532562107e-03 | -4.723654586887e-04 | 1.546838262253e-05 | 5.829958388468e-04
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
