tar7operator/Pinaka/11. CFD/Parachute/CansatMain/simscale/Test 3 - 2.75 ms/forces.csv

Time (s) | POROUS_FORCE_X | POROUS_FORCE_Y | POROUS_FORCE_Z | PRESSURE_FORCE_X | PRESSURE_FORCE_Y | PRESSURE_FORCE_Z | TOTAL_FORCE_X | TOTAL_FORCE_Y | TOTAL_FORCE_Z | VISCOUS_FORCE_X | VISCOUS_FORCE_Y | VISCOUS_FORCE_Z
1 | 0.000000000000e+00 | 0.000000000000e+00 | 0.000000000000e+00 | 4.653690248179e-03 | 2.729191049922e+00 | 6.055274346469e-03 | 4.652887680082e-03 | 2.729295107460e+00 | 6.054276430522e-03 | -8.025680971802e-07 | 1.040575386128e-04 | -9.979159472821e-07
2 | 0.000000000000e+00 | 0.000000000000e+00 | 0.000000000000e+00 | 6.250686696558e-02 | 4.659773914011e+01 | 9.158035407410e-02 | 6.212055851546e-02 | 4.664140135426e+01 | 9.111412146364e-02 | -3.863084501243e-04 | 4.366221415497e-02 | -4.662326104537e-04
3 | 0.000000000000e+00 | 0.000000000000e+00 | 0.000000000000e+00 | -1.104193996740e-01 | 5.478303390978e+01 | -2.045014234455e-01 | -1.109940330623e-01 | 5.482843427402e+01 | -2.051776906312e-01 | -5.746333883017e-04 | 4.540036423986e-02 | -6.762671856827e-04
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
