tar7operator/Pinaka/11. CFD/Parachute/CansatMain/simscale/Test 3 - 2.75 ms/moments.csv

Time (s) | POROUS_MOMENT_X | POROUS_MOMENT_Y | POROUS_MOMENT_Z | PRESSURE_MOMENT_X | PRESSURE_MOMENT_Y | PRESSURE_MOMENT_Z | TOTAL_MOMENT_X | TOTAL_MOMENT_Y | TOTAL_MOMENT_Z | VISCOUS_MOMENT_X | VISCOUS_MOMENT_Y | VISCOUS_MOMENT_Z
1 | 0.000000000000e+00 | 0.000000000000e+00 | 0.000000000000e+00 | -1.991542960077e-04 | -3.134192985850e-05 | 1.801010524708e-04 | -1.990422524121e-04 | -3.129960206407e-05 | 1.804414401271e-04 | 1.120435956319e-07 | 4.232779442815e-08 | 3.403876563115e-07
2 | 0.000000000000e+00 | 0.000000000000e+00 | 0.000000000000e+00 | -3.239168491501e-03 | -6.501642910840e-04 | 2.756590109541e-03 | -3.597207782404e-03 | -6.494018477575e-04 | 3.273339236708e-03 | -3.580392909023e-04 | 7.624433264845e-07 | 5.167491271668e-04
3 | 0.000000000000e+00 | 0.000000000000e+00 | 0.000000000000e+00 | 8.418309339262e-03 | -8.170613528278e-04 | -4.277050922553e-03 | 7.993441158701e-03 | -8.030960572965e-04 | -3.750530058480e-03 | -4.248681805611e-04 | 1.396529553130e-05 | 5.265208640729e-04
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
