tar7operator/Pinaka/10.FEA/Rocket/Thrust Plate/Final Test/fosHole.png

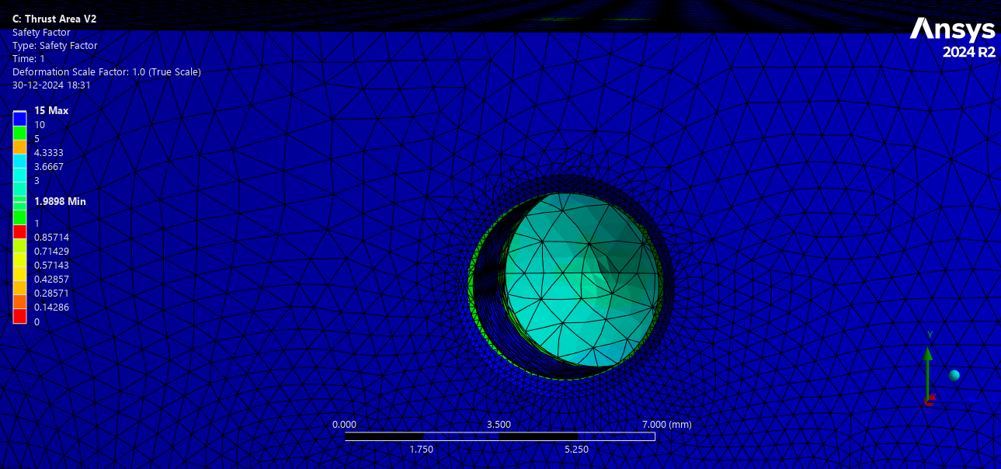
10.FEA/Rocket/Thrust Plate/Final Test/fosHole.png
