tar7operator/Pinaka/10.FEA/Rocket/Thrust Plate/Final Test/stressAngle.png

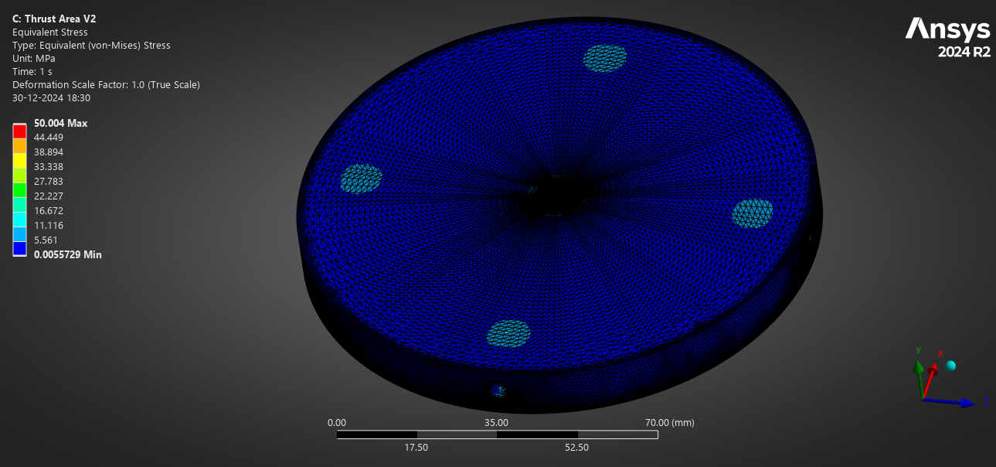
10.FEA/Rocket/Thrust Plate/Final Test/stressAngle.png
