tar7operator/Pinaka/10.FEA/Rocket/Thrust Plate/Final Test/tdAngle.png

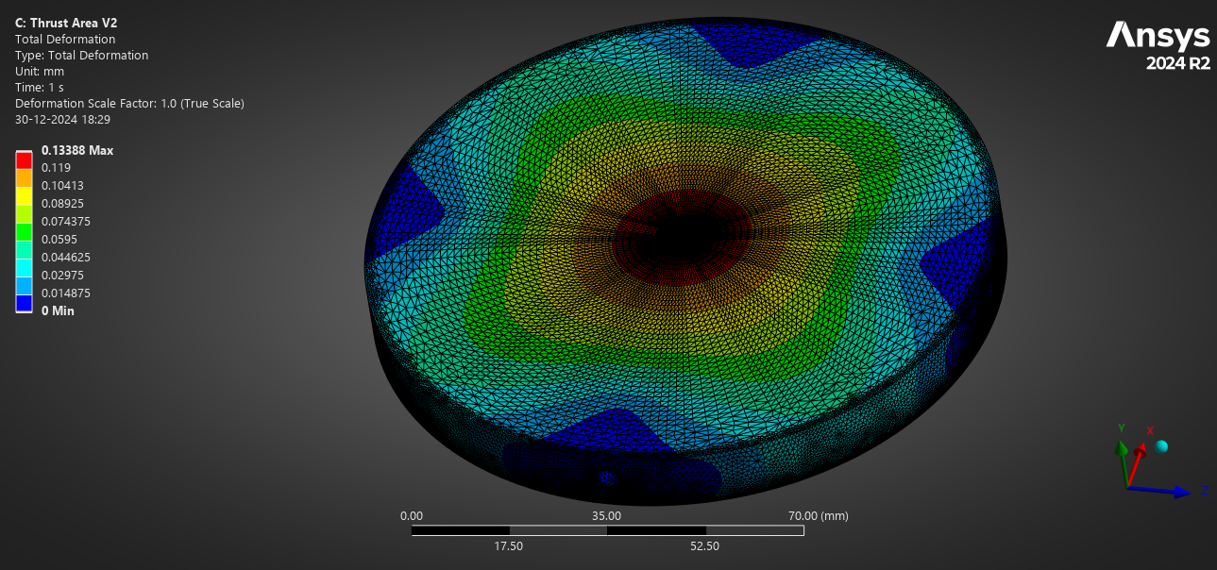
10.FEA/Rocket/Thrust Plate/Final Test/tdAngle.png
