tar7operator/Pinaka/10.FEA/Rocket/Thrust Plate/Final Test/tdside.png

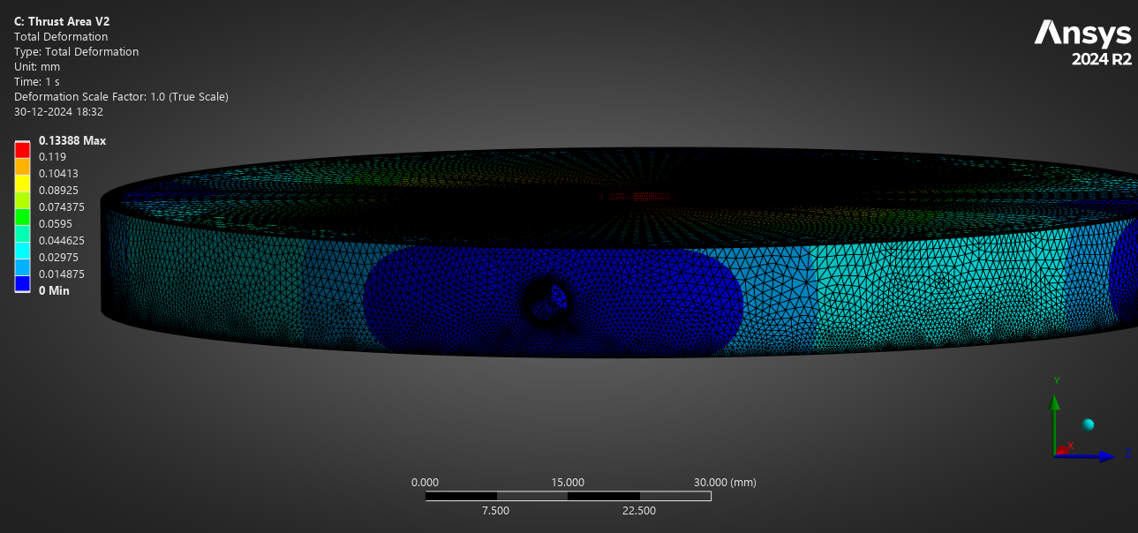
10.FEA/Rocket/Thrust Plate/Final Test/tdside.png
