tar7operator/Pinaka/10.FEA/Rocket/Thrust Plate/Final Test/tdTop.png

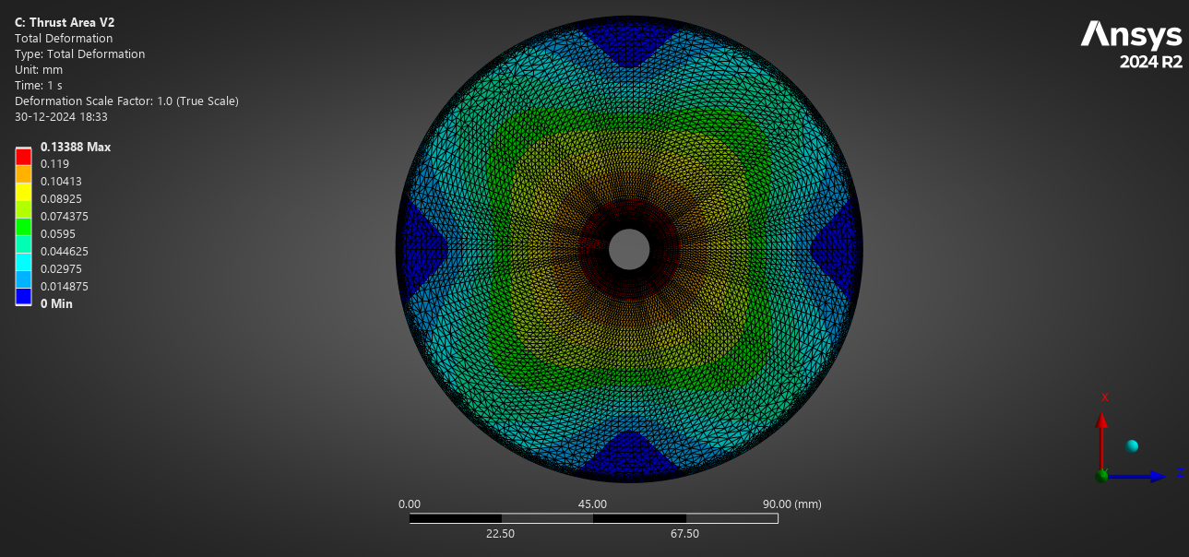
10.FEA/Rocket/Thrust Plate/Final Test/tdTop.png
