tar7operator/Pinaka/11. CFD/Parachute/CansatMain/simscale/Test 1/chart.png

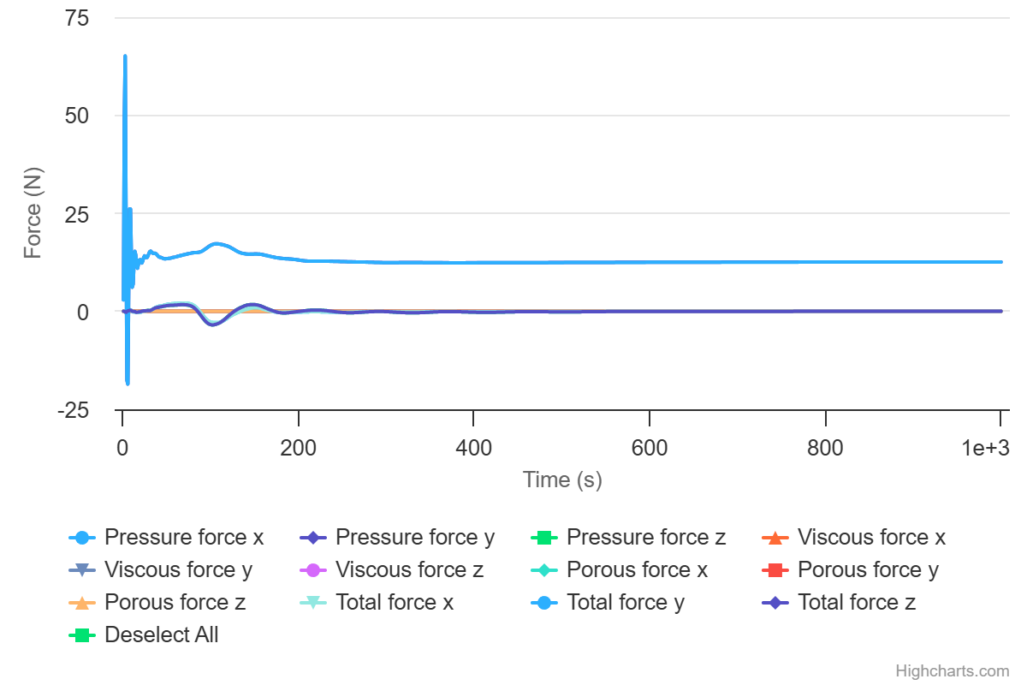
11. CFD/Parachute/CansatMain/simscale/Test 1/chart.png
