tar7operator/Pinaka/11. CFD/Parachute/CansatMain/simscale/Test 1/Screenshot 2.png

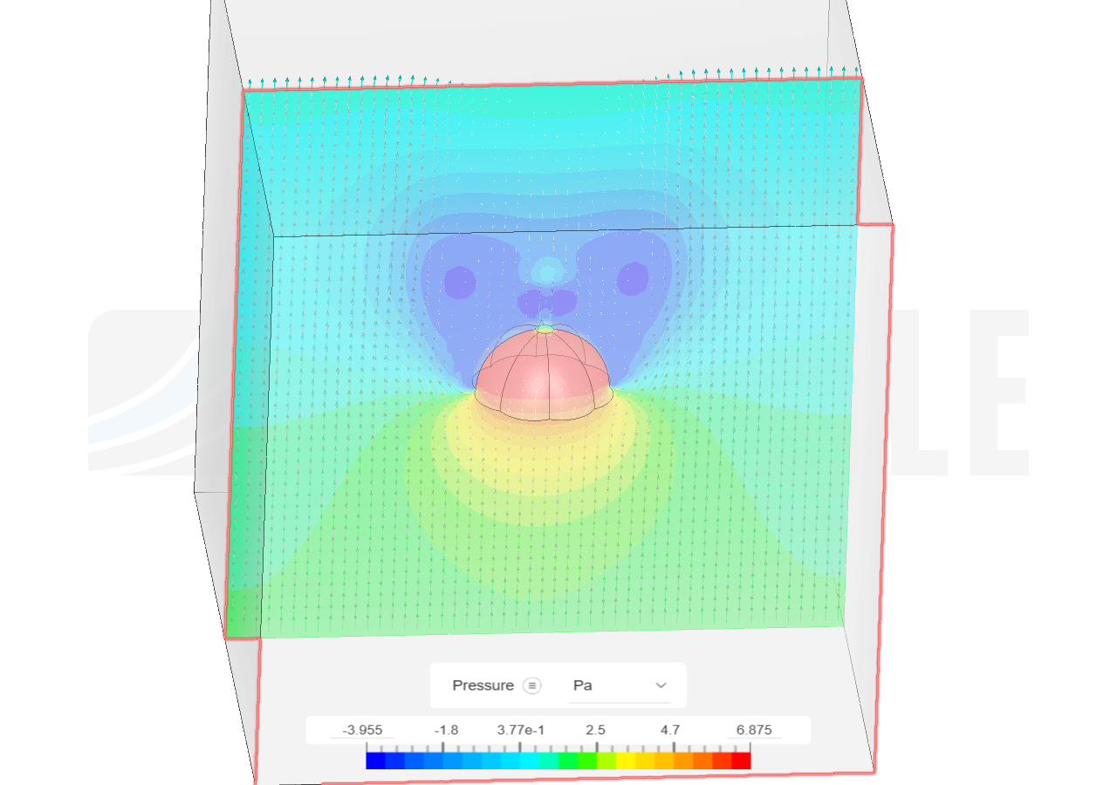
11. CFD/Parachute/CansatMain/simscale/Test 1/Screenshot 2.png
