tar7operator/Pinaka/11. CFD/Parachute/CansatMain/simscale/Test 2 - Refined/moment chart.png

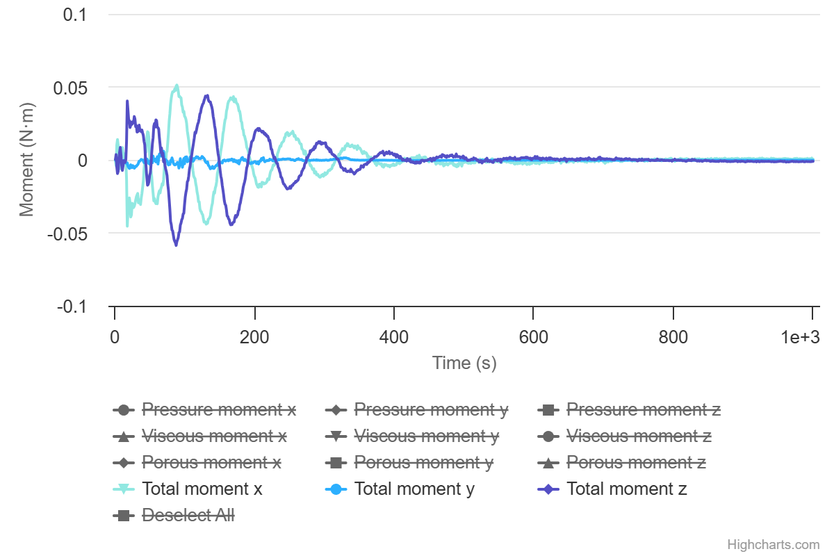
11. CFD/Parachute/CansatMain/simscale/Test 2 - Refined/moment chart.png
