tar7operator/Pinaka/11. CFD/Parachute/CansatMain/simscale/Test 3 - 2.75 ms/force chart.png

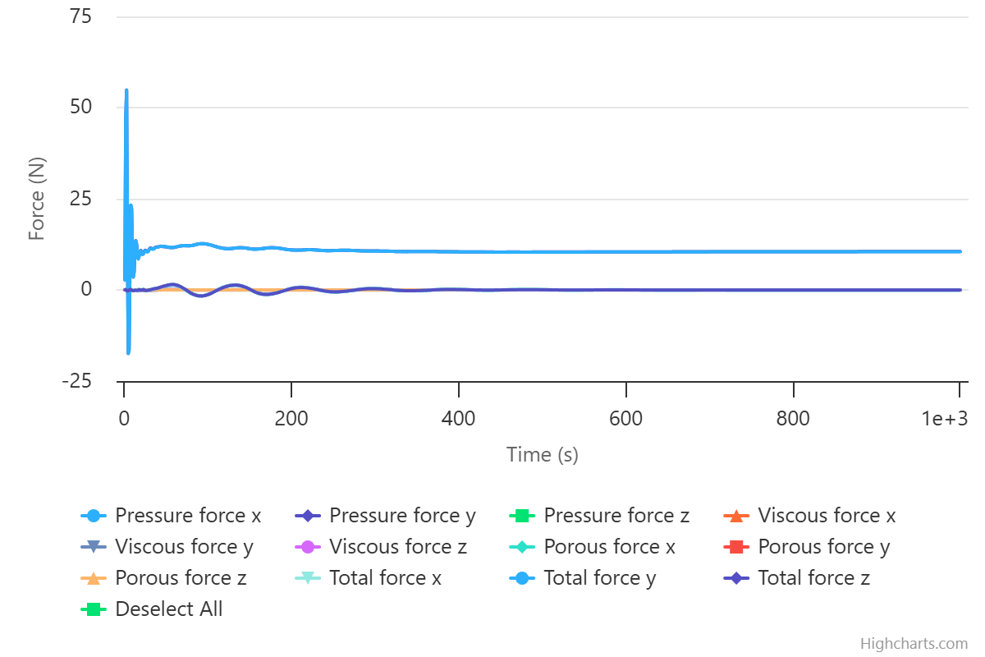
11. CFD/Parachute/CansatMain/simscale/Test 3 - 2.75 ms/force chart.png
