tar7operator/Pinaka/11. CFD/Parachute/CansatMain/simscale/Test 3 - 2.75 ms/moment plot.png

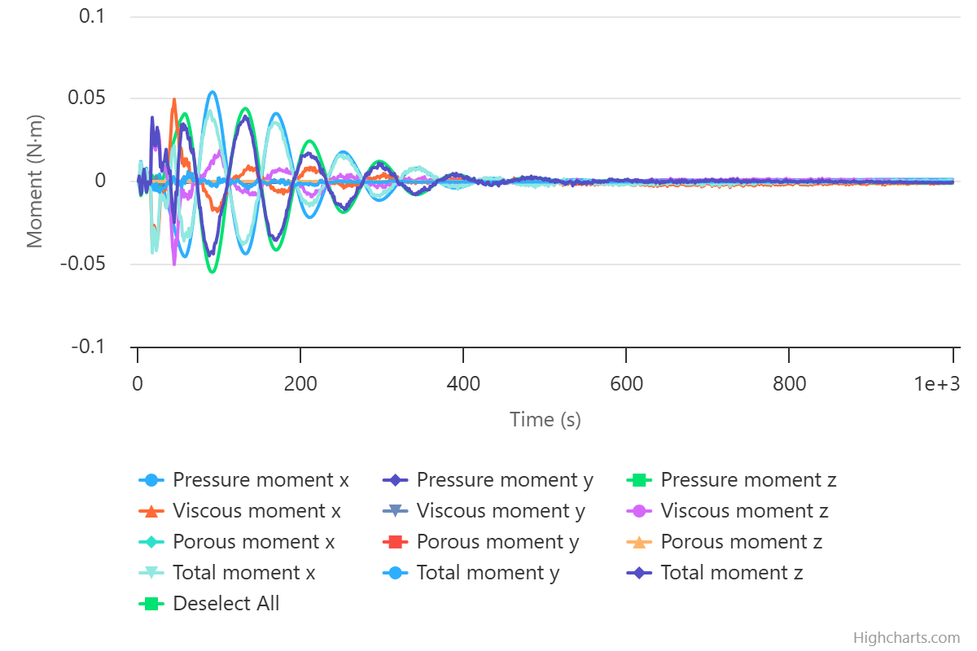
11. CFD/Parachute/CansatMain/simscale/Test 3 - 2.75 ms/moment plot.png
