tar7operator/Pinaka/11. CFD/Parachute/CansatMain/simscale/Test 3 - 2.75 ms/velocity.png

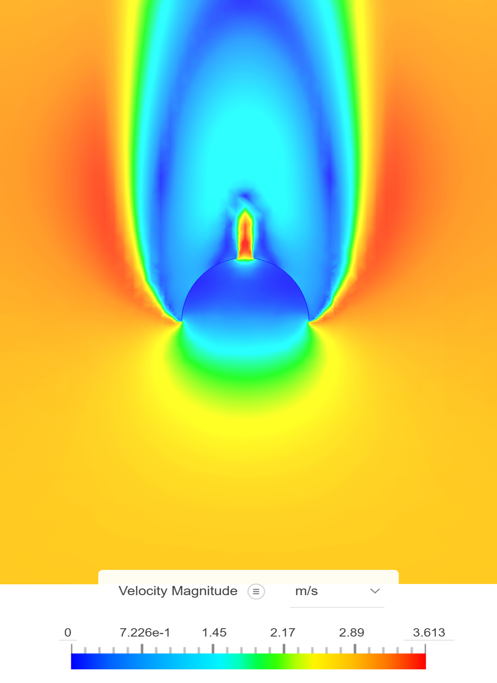
11. CFD/Parachute/CansatMain/simscale/Test 3 - 2.75 ms/velocity.png
