tar7operator/Pinaka/16. CAD V5/Drawings/Avionics Bay/Avionics Bay Assembly.pdf

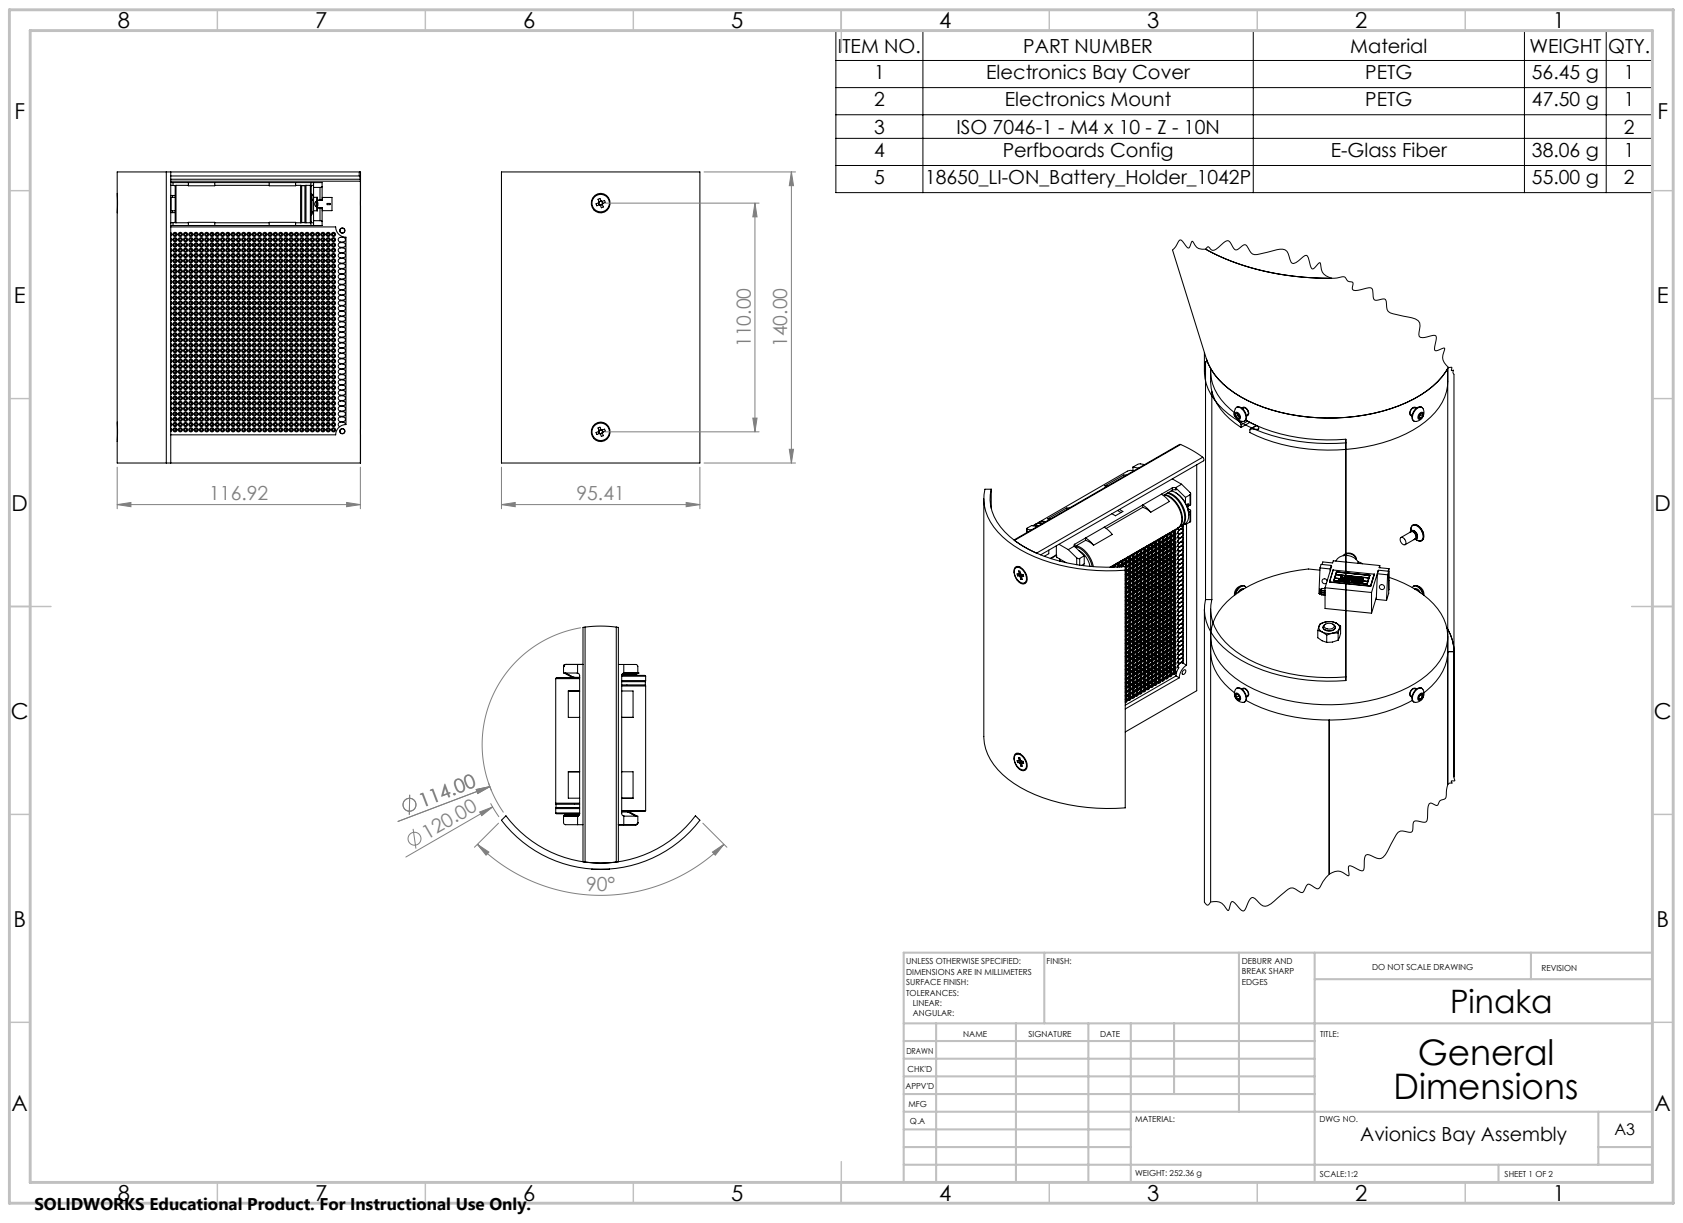
[picture p309: page 1]
ITEM NO.; PART NUMBER; Material; WEIGHT QTY.; FINISH:; DEBURR AND; BREAK SHARP; DO NOT SCALE DRAWING; REVISION; SCALE:1:2; SHEET 1 OF 2; WEIGHT: 252.36 g

1 | Electronics Bay Cover | PETG | 56.45 g | 1
2 | Electronics Mount | PETG | 47.50 g | 1
3 | ISO 7046-1 - M4 x 10 - Z - 10N | | | 2
4 | Perfboards Config | E-Glass Fiber | 38.06 g | 1
5 | 18650_LI-ON_Battery_Holder_1042P | | 55.00 g | 2

UNLESS OTHERWISE SPECIFIED:
DIMENSIONS ARE IN MILLIMETERS
SURFACE FINISH:
TOLERANCES:
LINEAR:
ANGULAR:

NAME | SIGNATURE | DATE | | | | TITLE: General Dimensions

DRAWN
CHK'D
APPV'D
MFG
Q.A | | | | MATERIAL: | DWG NO. Avionics Bay Assembly | A3

SOLIDWORKS Educational Product. For Instructional Use Only.

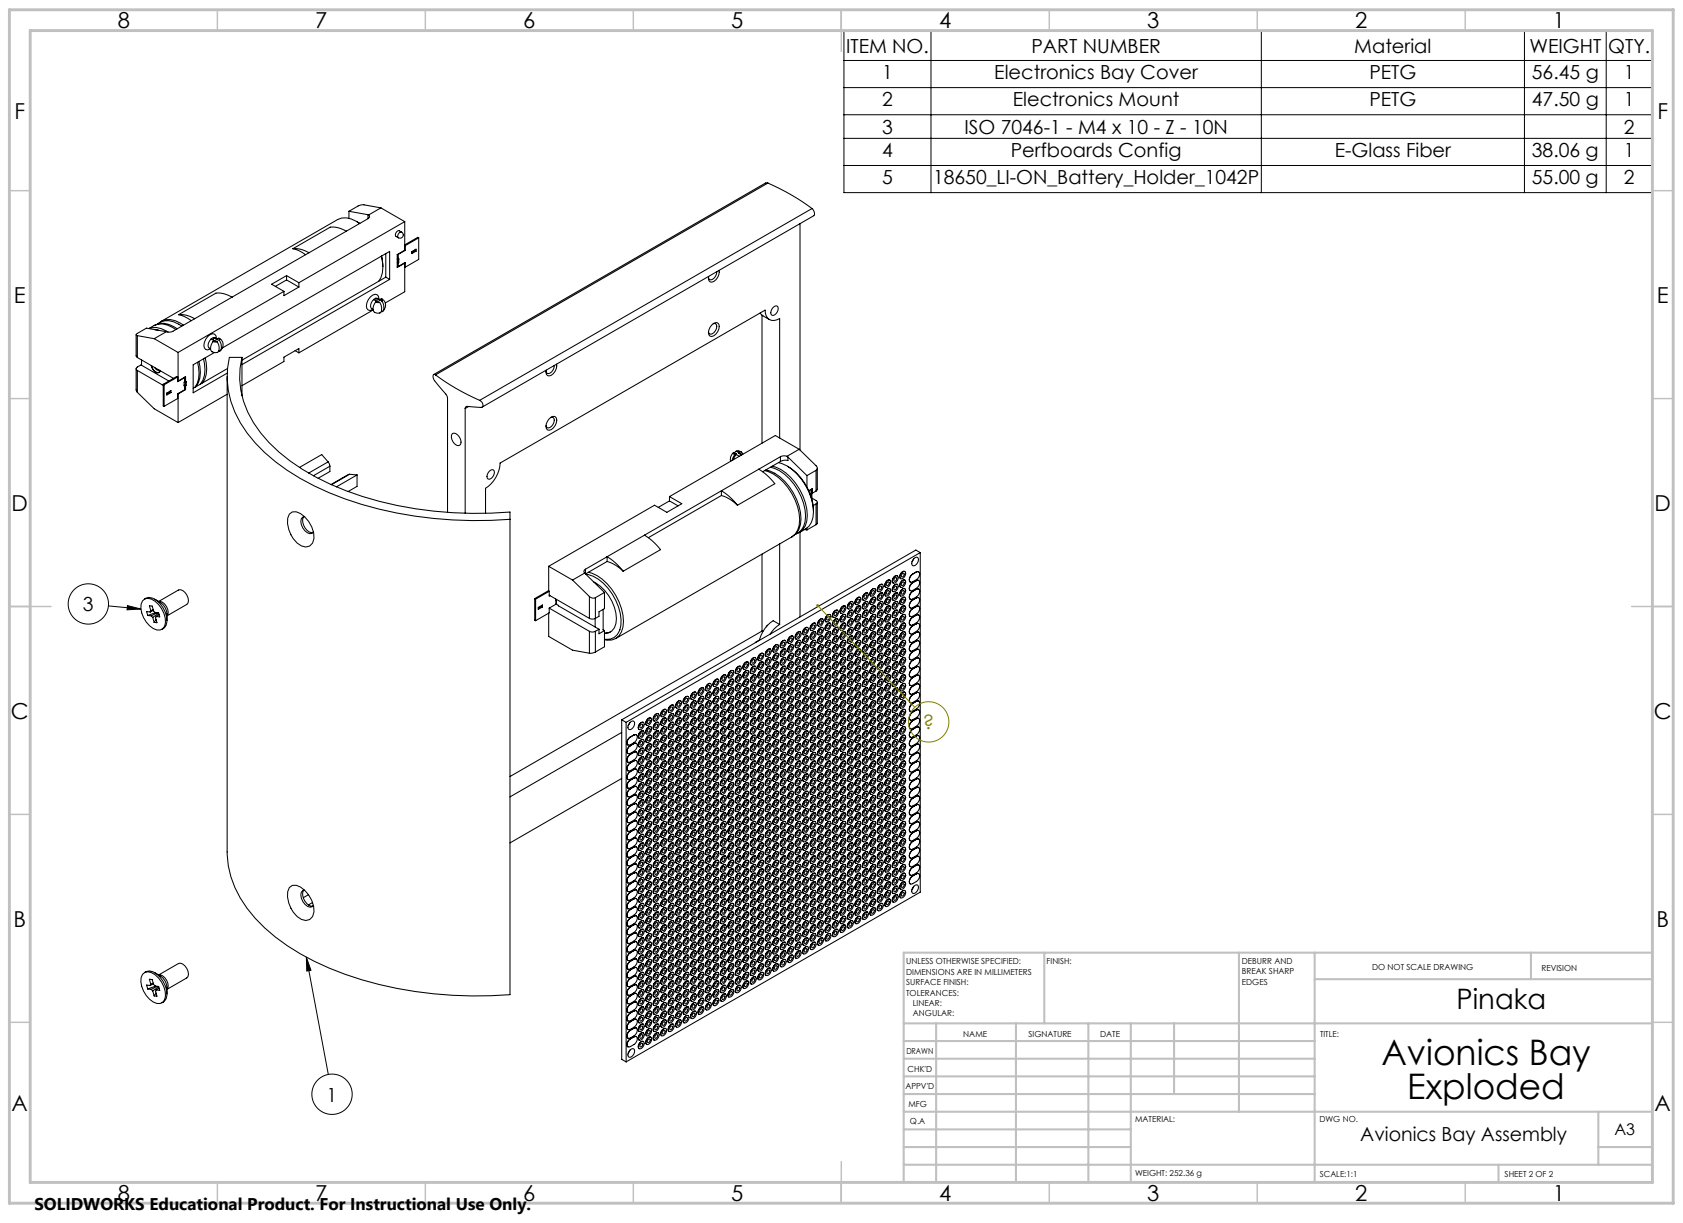
[picture p310: page 2]
FINISH:; DEBURR AND; BREAK SHARP; DO NOT SCALE DRAWING; REVISION; SCALE:1:1; SHEET 2 OF 2; WEIGHT: 252.36 g

ITEM NO. | PART NUMBER | Material | WEIGHT QTY.
1 | Electronics Bay Cover | PETG | 56.45 g | 1
2 | Electronics Mount | PETG | 47.50 g | 1
3 | ISO 7046-1 - M4 x 10 - Z - 10N | | | 2
4 | Perfboards Config | E-Glass Fiber | 38.06 g | 1
5 | 18650_LI-ON_Battery_Holder_1042P | | 55.00 g | 2

UNLESS OTHERWISE SPECIFIED:
DIMENSIONS ARE IN MILLIMETERS
SURFACE FINISH:
TOLERANCES:
LINEAR:
ANGULAR:

NAME | SIGNATURE | DATE | | | | TITLE: Avionics Bay Exploded

DRAWN
CHK'D
APPV'D
MFG
Q.A | | | | MATERIAL: | DWG NO. Avionics Bay Assembly | A3

SOLIDWORKS Educational Product. For Instructional Use Only.
