tar7operator/Pinaka/16. CAD V5/Drawings/Body Assembly/Fin.pdf

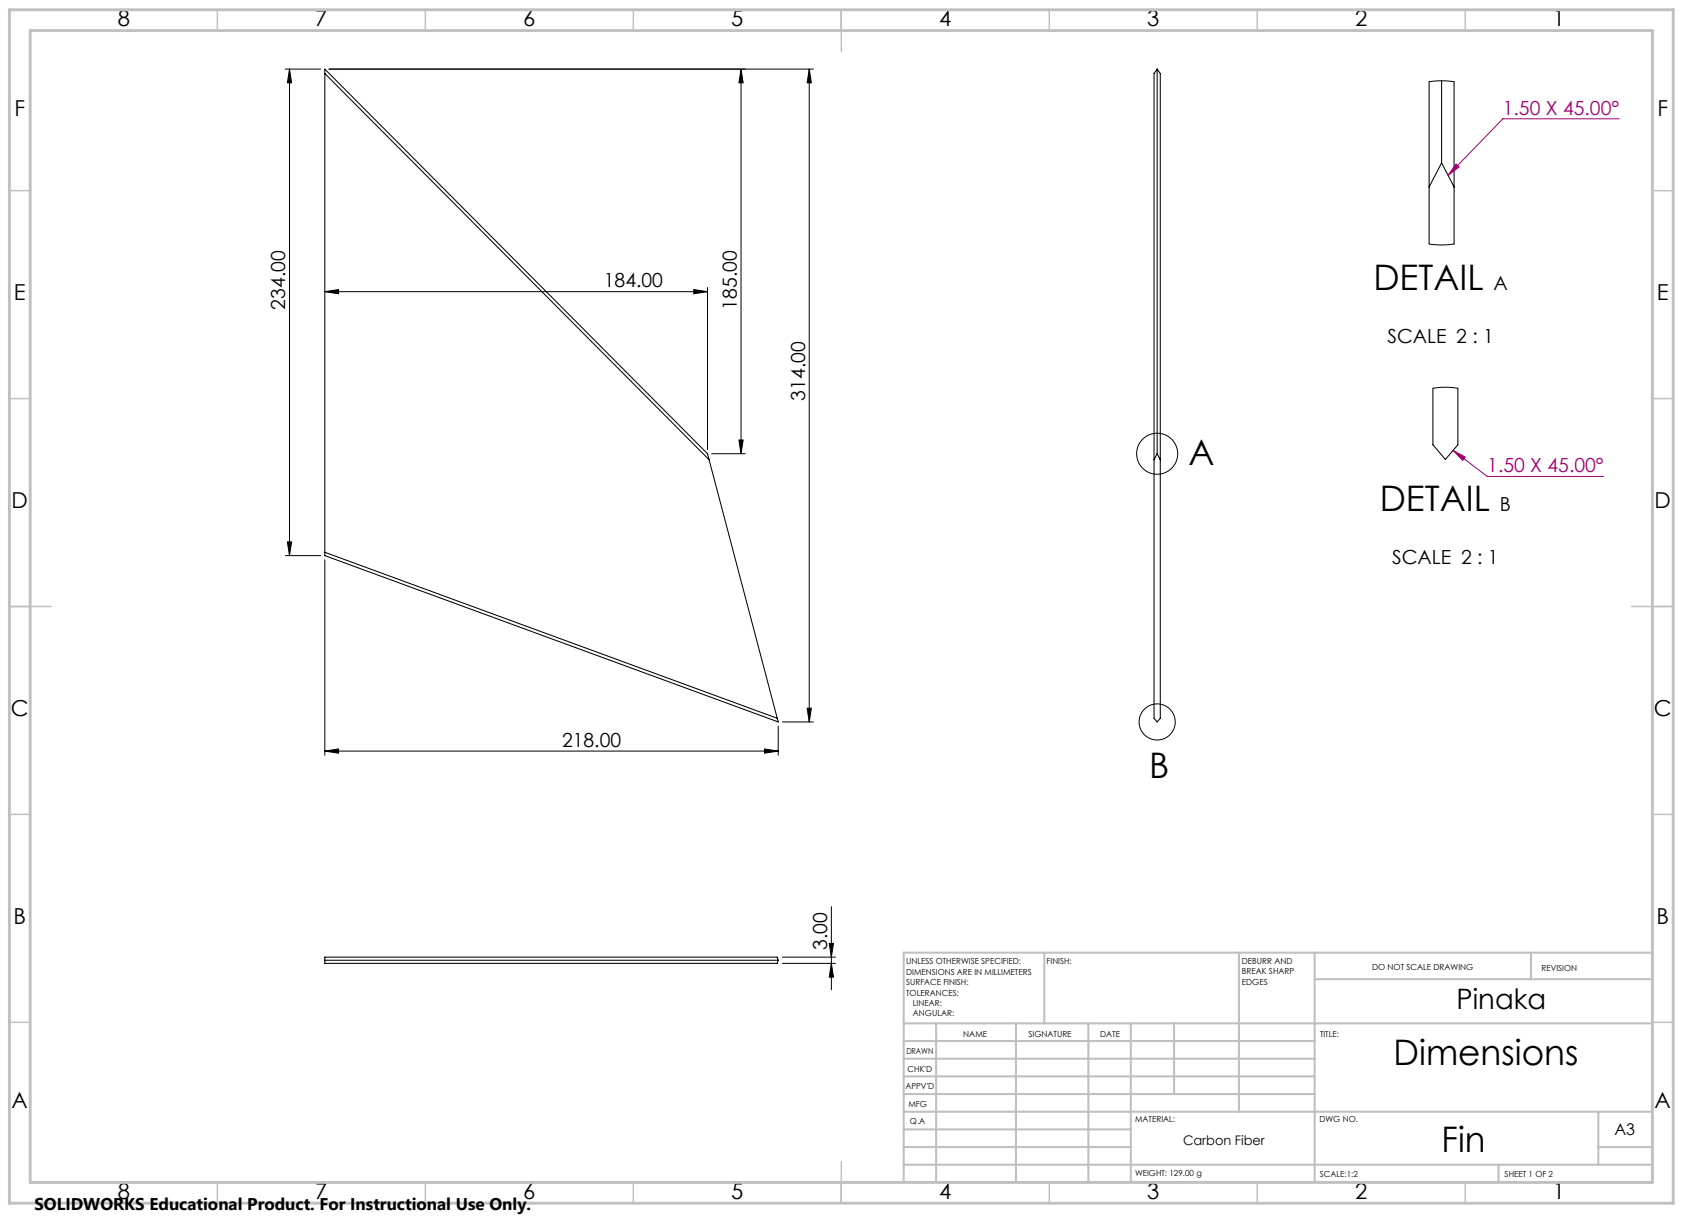
[picture p311: page 1]
DETAIL A; SCALE 2 : 1; 1.50 X 45.00° DETAIL B; FINISH:; DEBURR AND; BREAK SHARP; DO NOT SCALE DRAWING; REVISION; SCALE:1:2; SHEET 1 OF 2; WEIGHT: 129.00 g

UNLESS OTHERWISE SPECIFIED:
DIMENSIONS ARE IN MILLIMETERS
SURFACE FINISH:
TOLERANCES:
LINEAR:
ANGULAR:

NAME | SIGNATURE | DATE | | | | TITLE: Dimensions

DRAWN
CHK'D
APPV'D
MFG
Q.A | | | | MATERIAL: | DWG NO. Fin | A3 Carbon Fiber

SOLIDWORKS Educational Product. For Instructional Use Only.

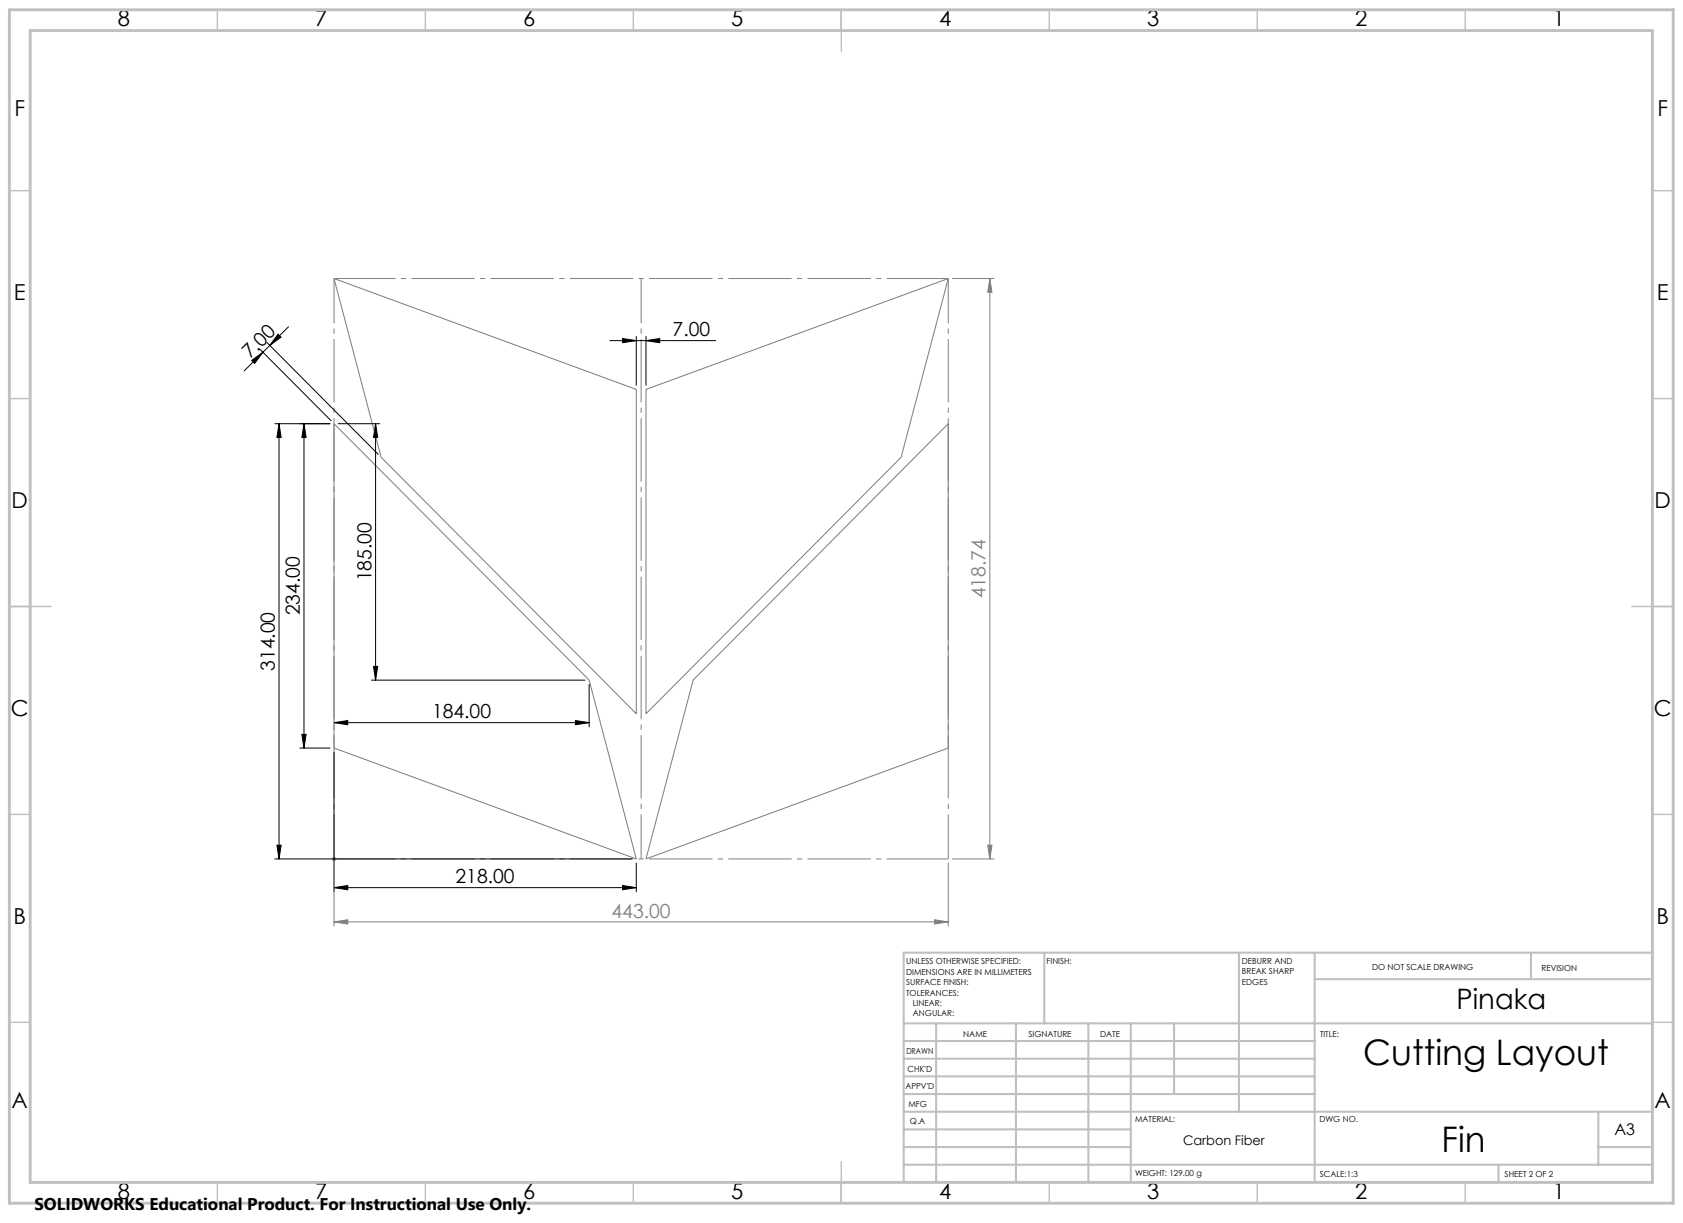
[picture p312: page 2]
FINISH:; DEBURR AND; BREAK SHARP; DO NOT SCALE DRAWING; REVISION; SCALE:1:3; SHEET 2 OF 2; WEIGHT: 129.00 g

UNLESS OTHERWISE SPECIFIED:
DIMENSIONS ARE IN MILLIMETERS
SURFACE FINISH:
TOLERANCES:
LINEAR:
ANGULAR:

NAME | SIGNATURE | DATE | | | | TITLE: Cutting Layout

DRAWN
CHK'D
APPV'D
MFG
Q.A | | | | MATERIAL: | DWG NO. Fin | A3 Carbon Fiber

SOLIDWORKS Educational Product. For Instructional Use Only.
