tar7operator/Pinaka/16. CAD V5/Drawings/Parachute Plate Assembly/Top Parachute Plate.PDF

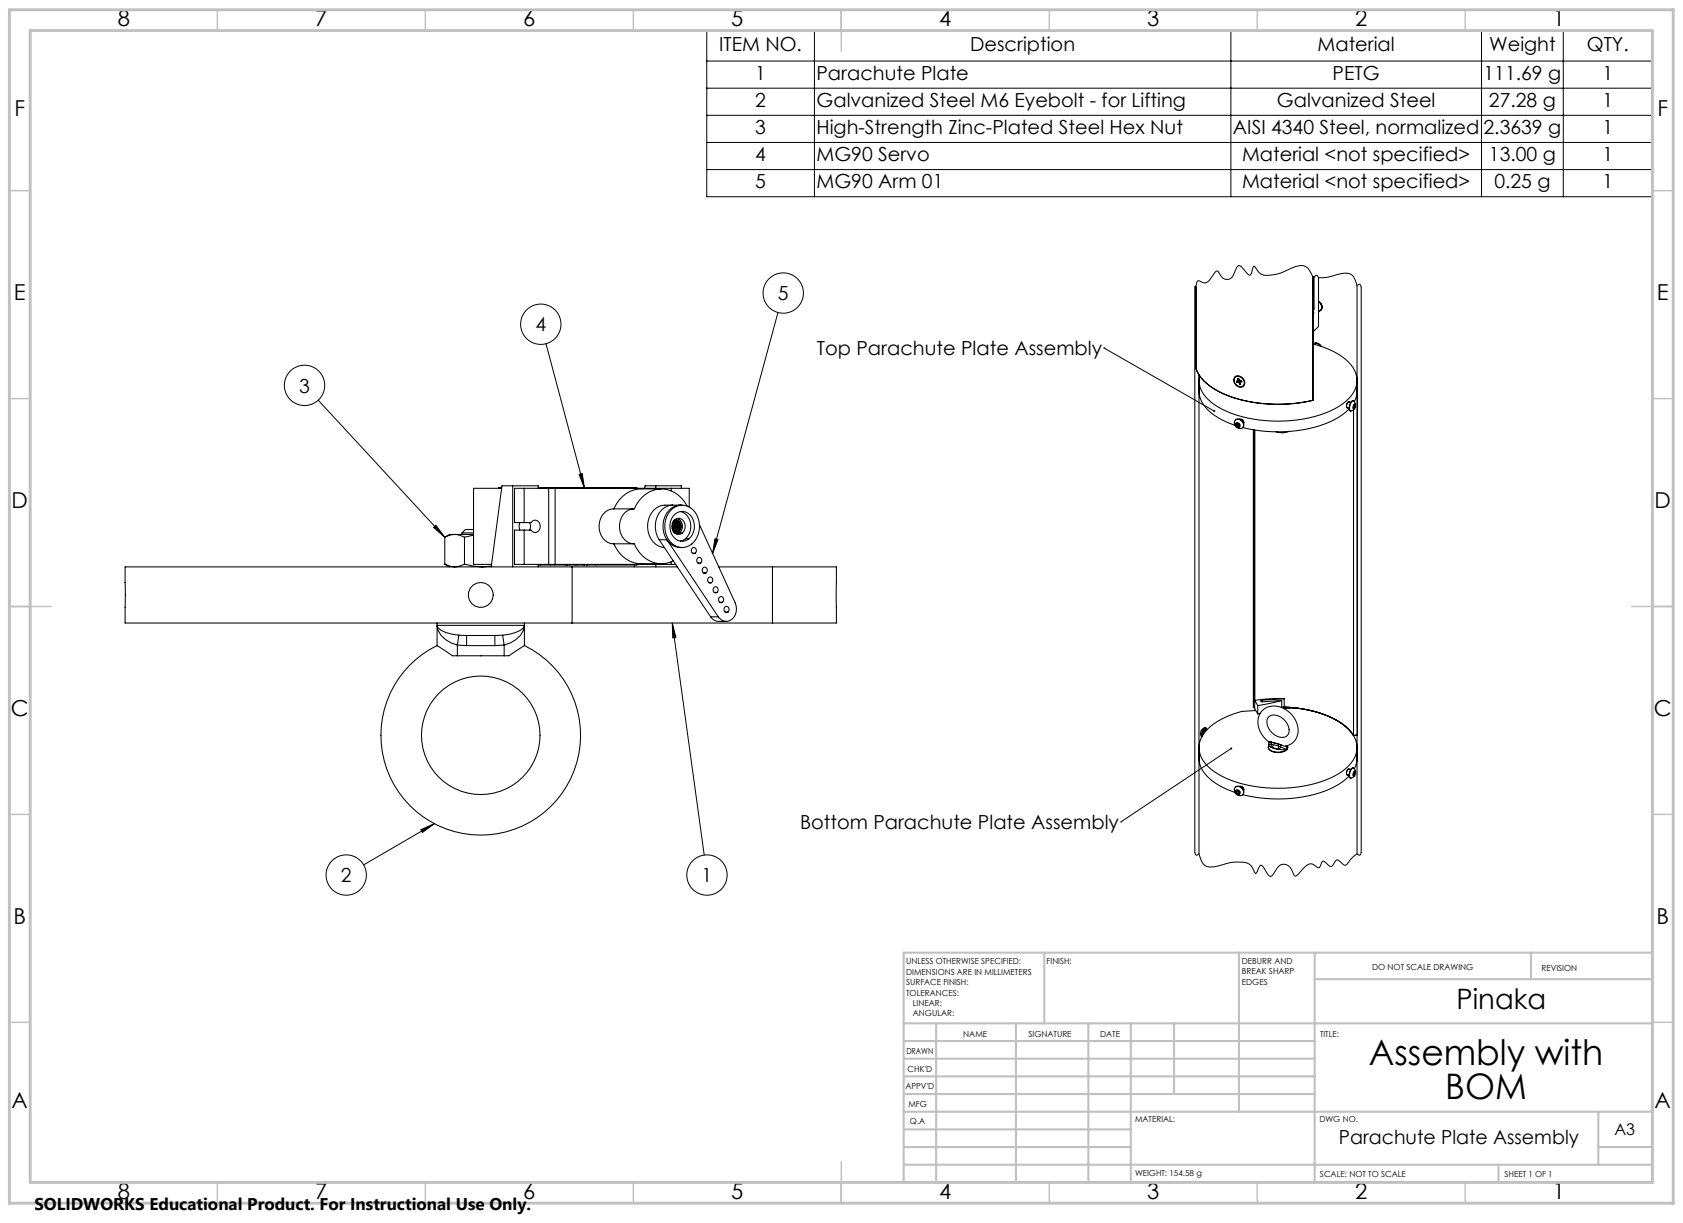
[picture p314: page 1]
ITEM NO.; Description; Material; Weight; QTY.; FINISH:; DEBURR AND; BREAK SHARP; DO NOT SCALE DRAWING; REVISION; SCALE: NOT TO SCALE; SHEET 1 OF 1; WEIGHT: 154.58 g

1 | Parachute Plate | PETG | 111.69 g | 1
2 | Galvanized Steel M6 Eyebolt - for Lifting | Galvanized Steel | 27.28 g | 1
3 | High-Strength Zinc-Plated Steel Hex Nut | AISI 4340 Steel, normalized 2.3639 g | | 1
4 | MG90 Servo | Material <not specified> | 13.00 g | 1
5 | MG90 Arm 01 | Material <not specified> | 0.25 g | 1

Top Parachute Plate Assembly

Bottom Parachute Plate Assembly

UNLESS OTHERWISE SPECIFIED:
DIMENSIONS ARE IN MILLIMETERS
SURFACE FINISH:
TOLERANCES:
LINEAR:
ANGULAR:

NAME | SIGNATURE | DATE | | | | TITLE: Assembly with

DRAWN
CHK'D
APPV'D
MFG
Q.A | | | | MATERIAL: | DWG NO. Parachute Plate Assembly | A3

SOLIDWORKS Educational Product. For Instructional Use Only.
