tar7operator/Pinaka/16. CAD V5/Drawings/Payload Assembly/Payload Assembly.pdf

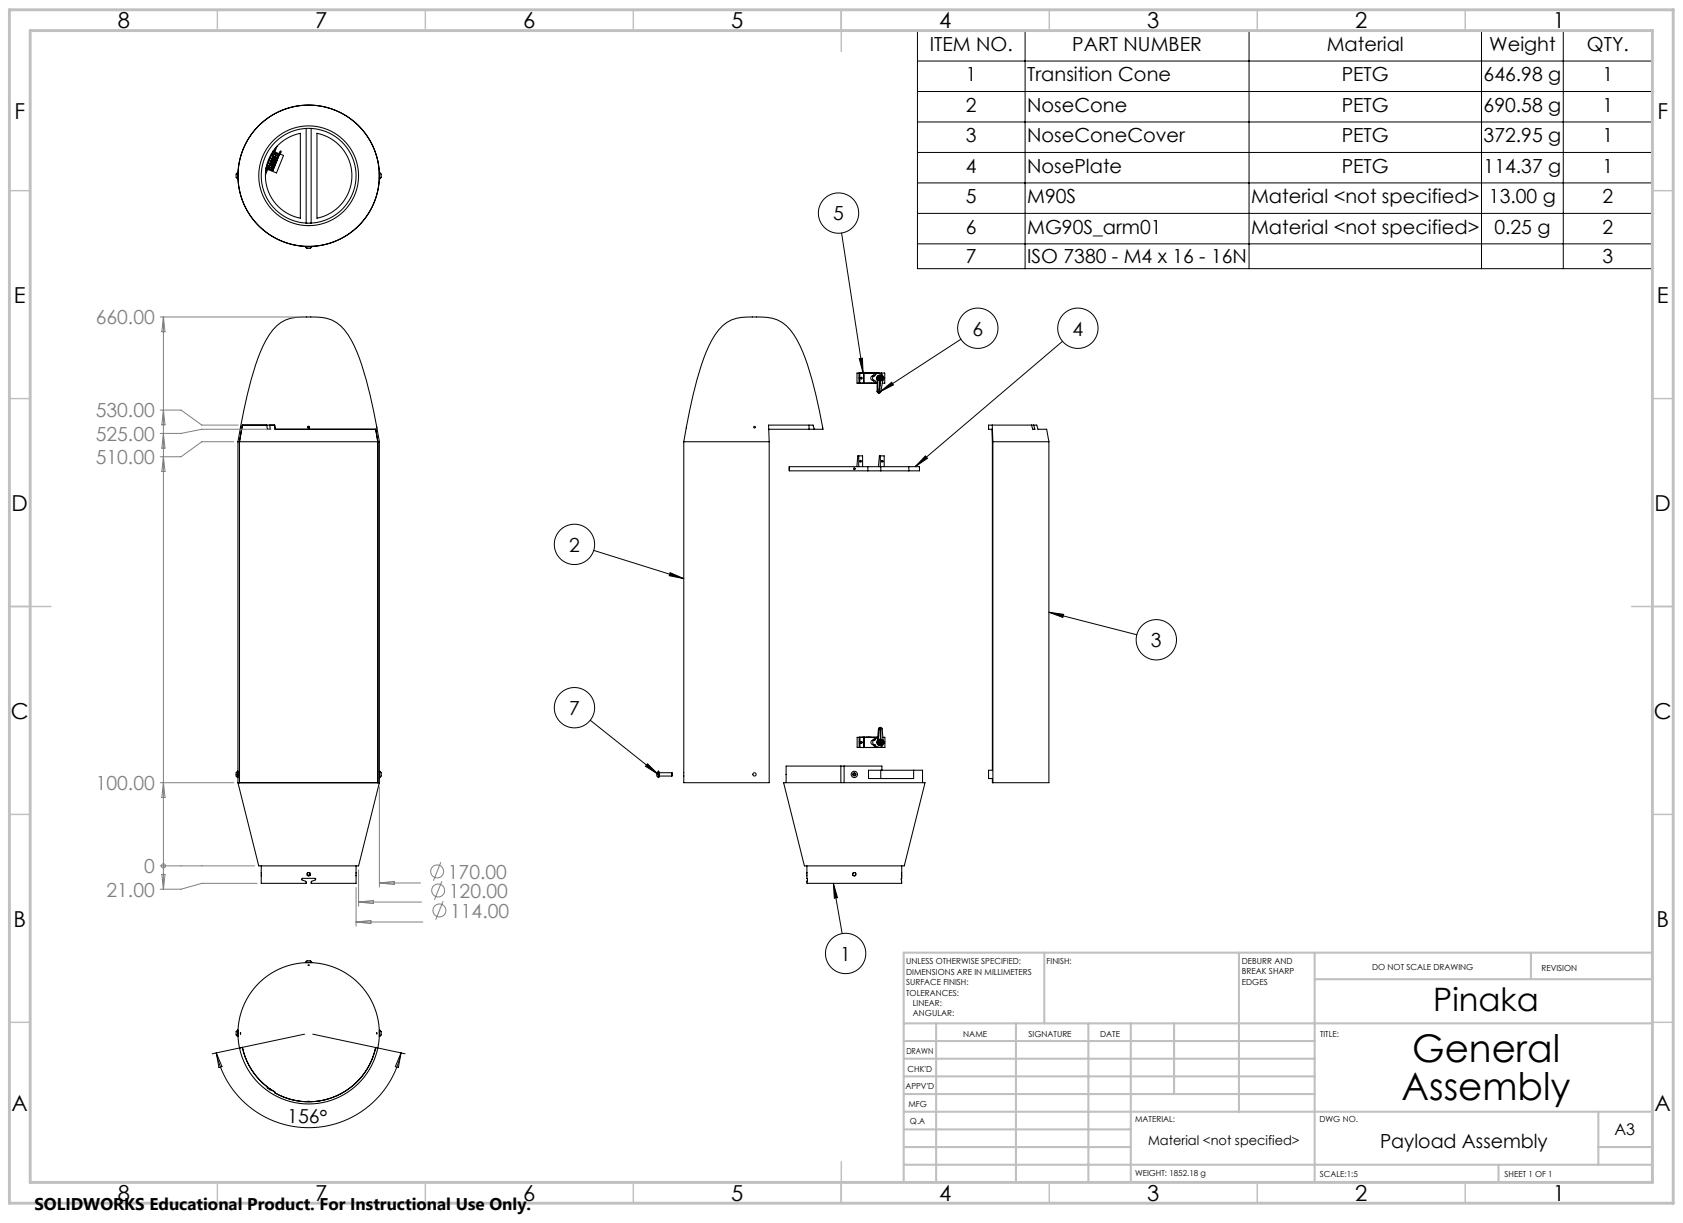
[picture p315: page 1]
FINISH:; DEBURR AND; BREAK SHARP; DO NOT SCALE DRAWING; REVISION; SCALE:1:5; SHEET 1 OF 1; WEIGHT: 1852.18 g

ITEM NO. | PART NUMBER | Material | Weight | QTY.
1 | Transition Cone | PETG | 646.98 g | 1
2 | NoseCone | PETG | 690.58 g | 1
3 | NoseConeCover | PETG | 372.95 g | 1
4 | NosePlate | PETG | 114.37 g | 1
5 | M90S | Material <not specified> | 13.00 g | 2
6 | MG90S_arm01 | Material <not specified> | 0.25 g | 2
7 | ISO 7380 - M4 x 16 - 16N | | | 3

UNLESS OTHERWISE SPECIFIED:
DIMENSIONS ARE IN MILLIMETERS
SURFACE FINISH:
TOLERANCES:
LINEAR:
ANGULAR:

NAME | SIGNATURE | DATE | | | | General TITLE: Assembly

DRAWN
CHK'D
APPV'D
MFG
Q.A | | | | MATERIAL: | DWG NO. Payload Assembly | A3 Material <not specified>

SOLIDWORKS Educational Product. For Instructional Use Only.
