tar7operator/Pinaka/16. CAD V5/Drawings/Body Assembly/Body Assembly.pdf

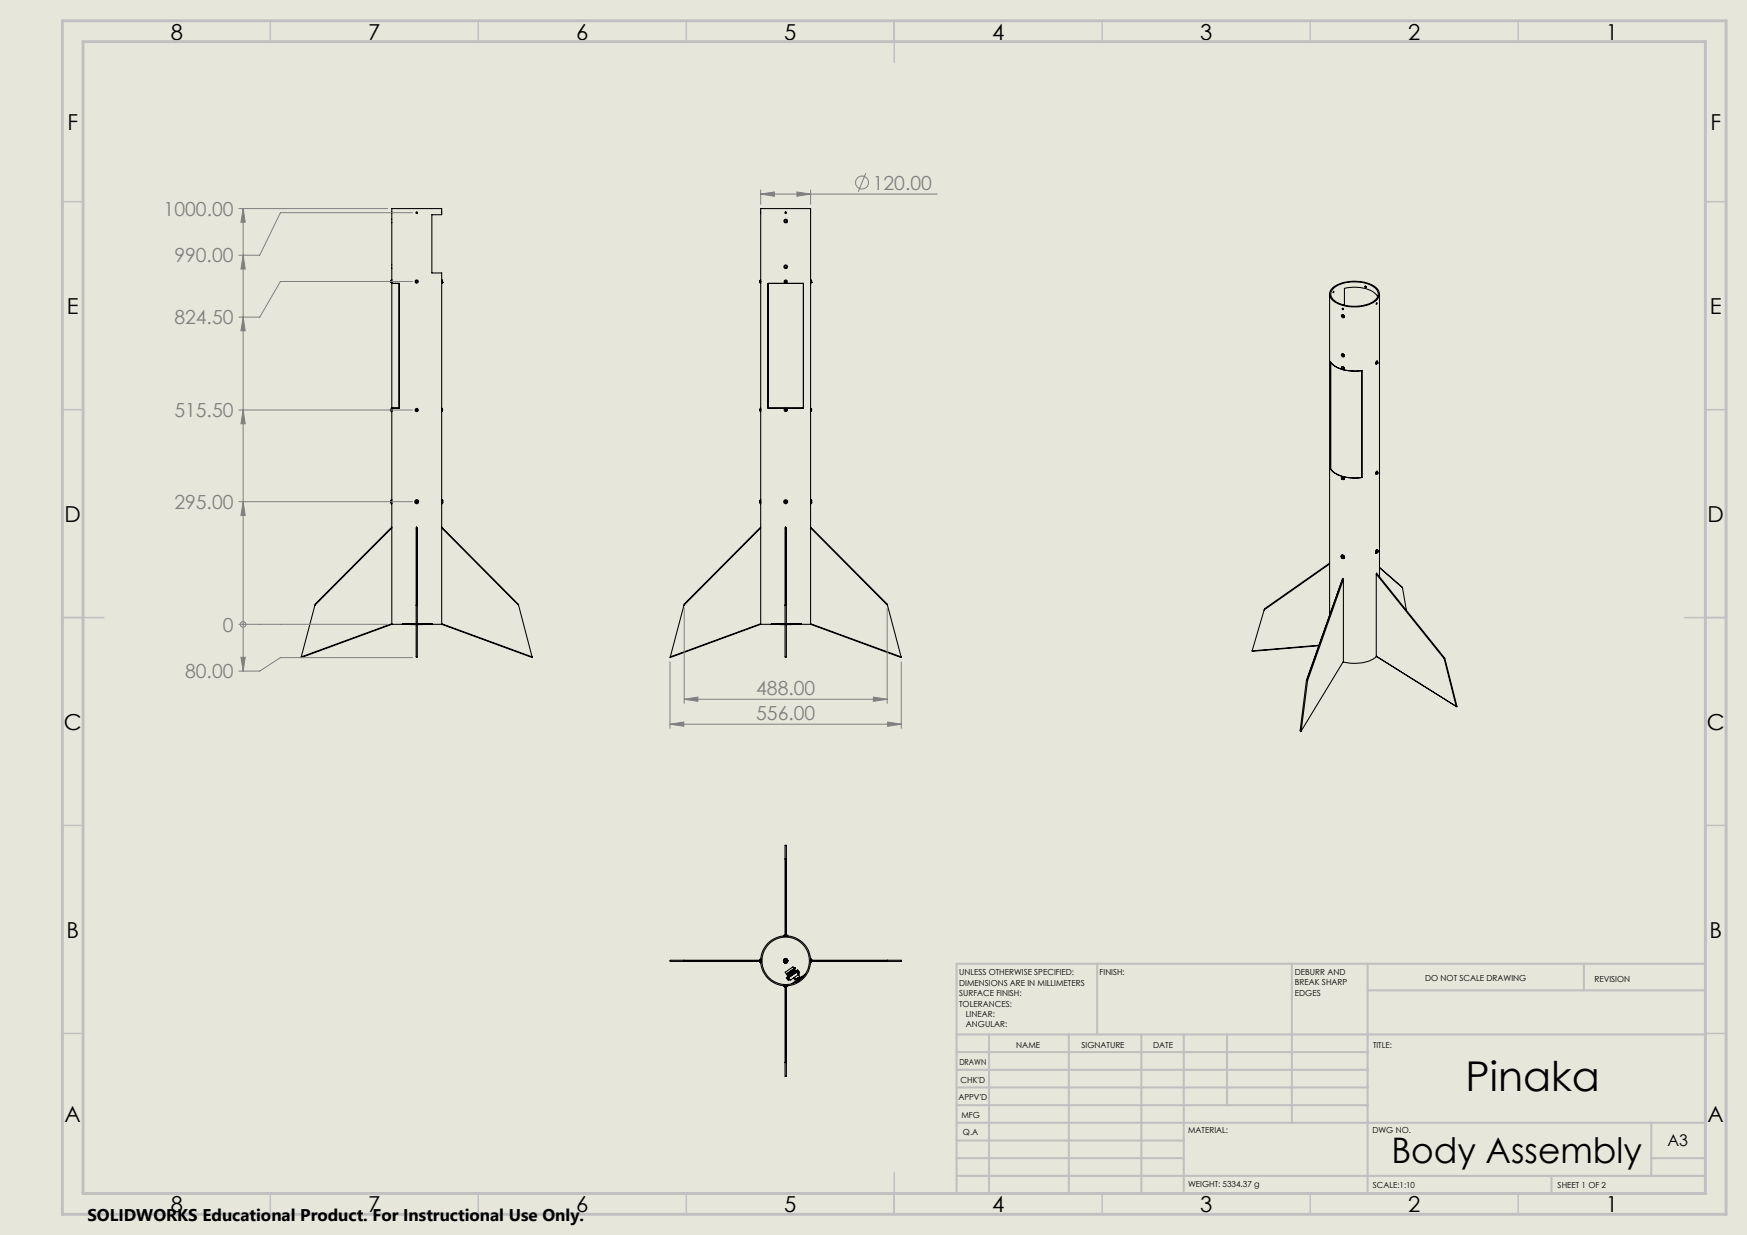
[picture p316: page 1]
FINISH:; DEBURR AND; BREAK SHARP; DO NOT SCALE DRAWING; REVISION; SCALE:1:10; SHEET 1 OF 2; WEIGHT: 5334.37 g

UNLESS OTHERWISE SPECIFIED:
DIMENSIONS ARE IN MILLIMETERS
SURFACE FINISH:
TOLERANCES:
LINEAR:
ANGULAR:

NAME | SIGNATURE | DATE | | | | TITLE: Pinaka

DRAWN
CHK'D
APPV'D
MFG
Q.A | | | | MATERIAL: | DWG NO. Body Assembly | A3

SOLIDWORKS Educational Product. For Instructional Use Only.

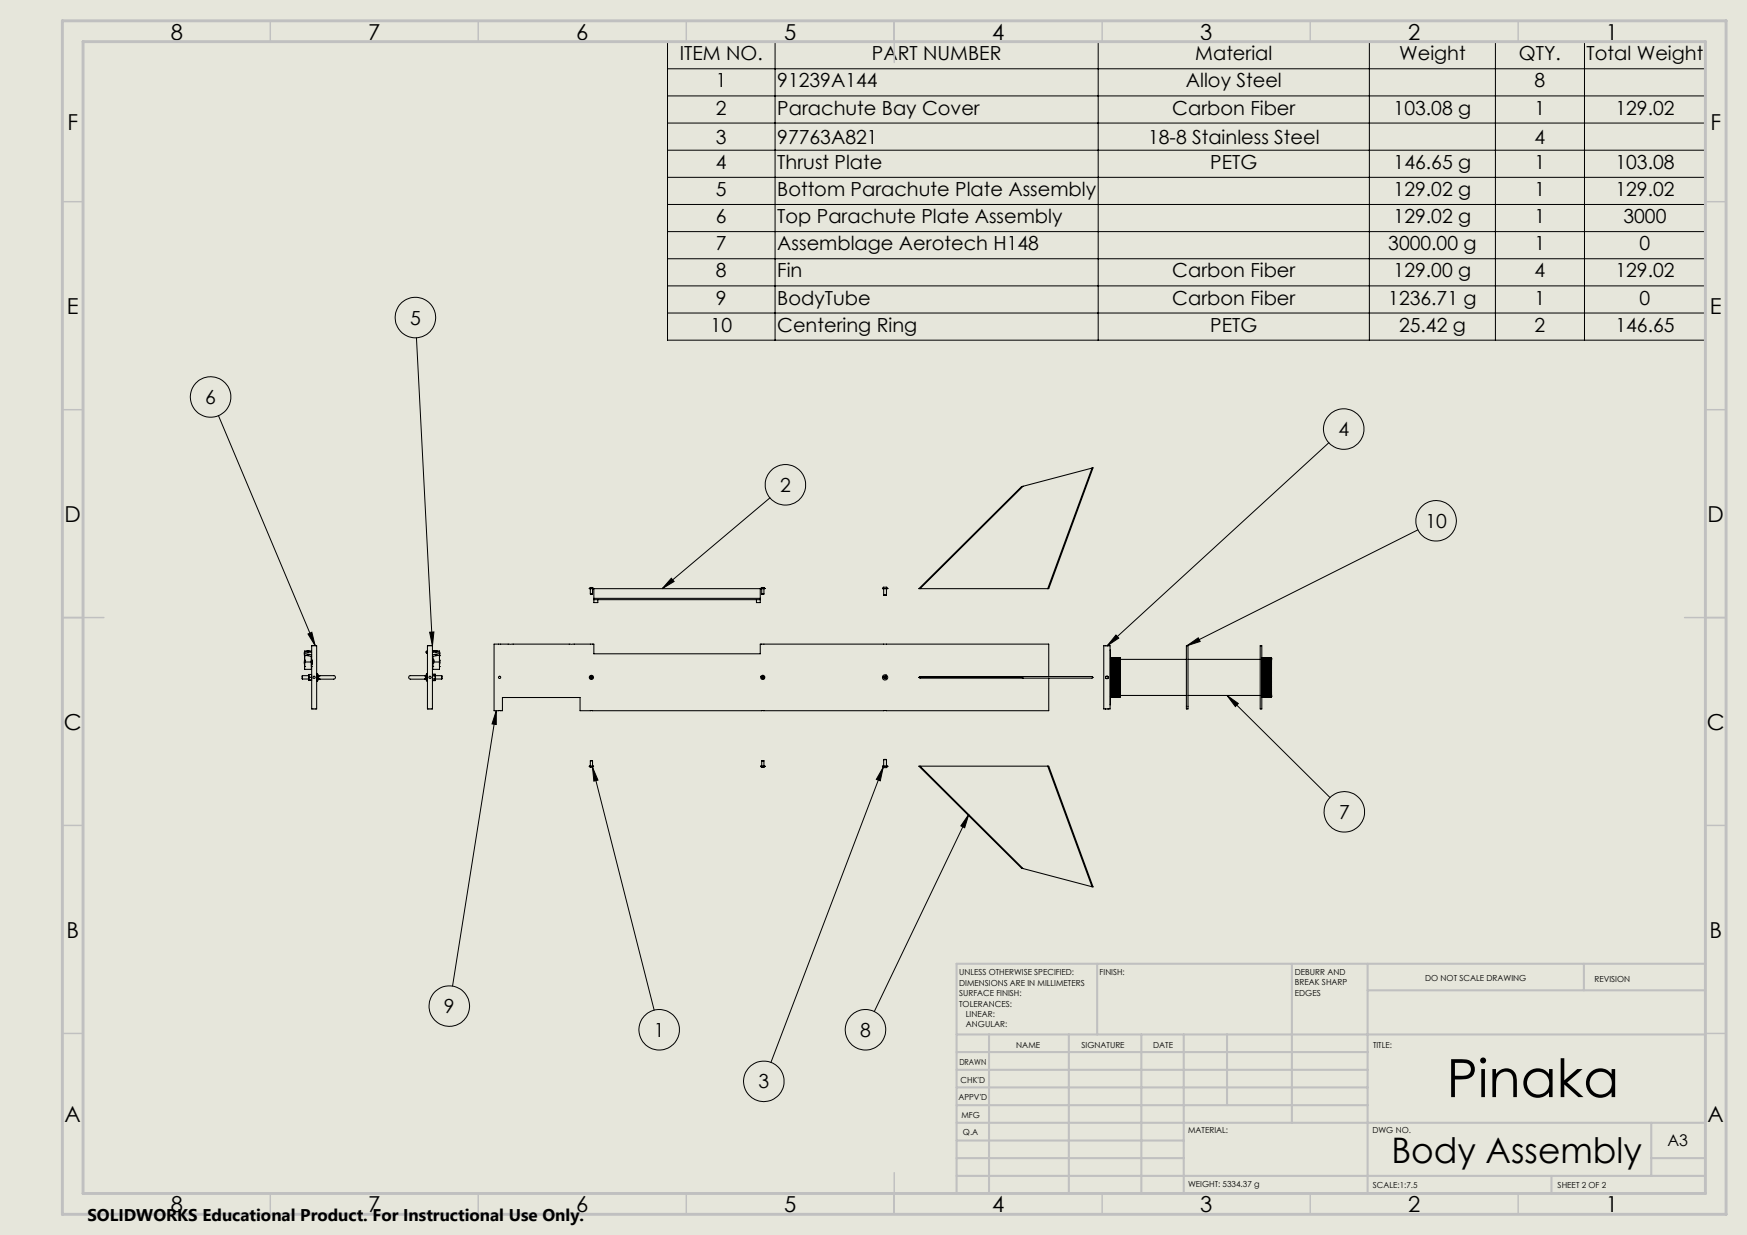
[picture p317: page 2]
FINISH:; DEBURR AND; BREAK SHARP; DO NOT SCALE DRAWING; REVISION; SCALE:1:7.5; SHEET 2 OF 2; WEIGHT: 5334.37 g

ITEM NO. | PART NUMBER | | Material | Weight | QTY. | Total Weight
1 | 91239A144 | | Alloy Steel | | 8
2 | Parachute Bay Cover | | Carbon Fiber | 103.08 g | 1 | 129.02
3 | 97763A821 | | 18-8 Stainless Steel | | 4
4 | Thrust Plate | | PETG | 146.65 g | 1 | 103.08
5 | Bottom Parachute Plate Assembly | | | 129.02 g | 1 | 129.02

E | | 6 | Top Parachute Plate Assembly | | 129.02 g | 1 | 3000 | E

7 | Assemblage Aerotech H148 | | 3000.00 g | 1 | 0
8 | Fin | Carbon Fiber | 129.00 g | 4 | 129.02
9 | BodyTube | Carbon Fiber | 1236.71 g | 1 | 0
10 | Centering Ring | PETG | 25.42 g | 2 | 146.65

UNLESS OTHERWISE SPECIFIED:
DIMENSIONS ARE IN MILLIMETERS
SURFACE FINISH:
TOLERANCES:
LINEAR:
ANGULAR:

NAME | SIGNATURE | DATE | | | | TITLE:

DRAWN
CHK'D
APPV'D
MFG
Q.A | | | | MATERIAL: | DWG NO. Body Assembly | A3

SOLIDWORKS Educational Product. For Instructional Use Only.
