tar7operator/Pinaka/16. CAD V5/Drawings/Payload Assembly/Payload Body-Surface-Flatten2.pdf

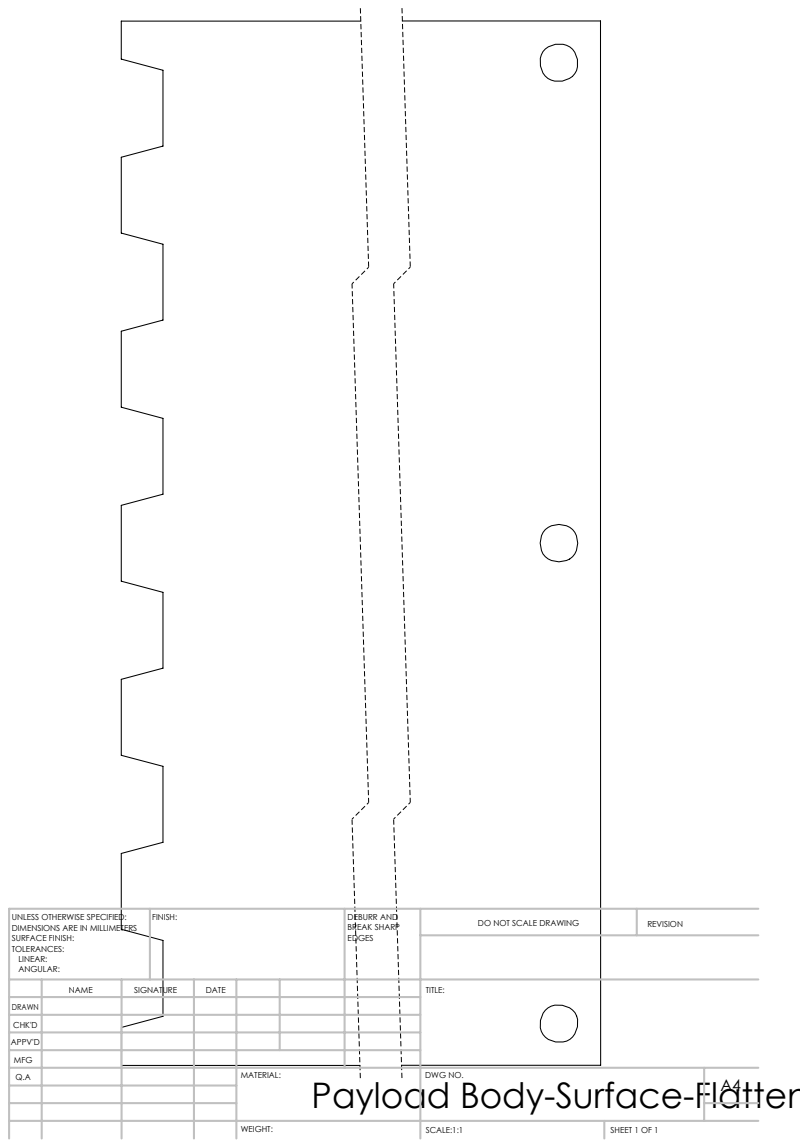
[picture p320: page 1]
FINISH:; DEBURR AND; BREAK SHARP; DO NOT SCALE DRAWING; REVISION; DWG NO.; SCALE:1:1; SHEET 1 OF 1

UNLESS OTHERWISE SPECIFIED:
DIMENSIONS ARE IN MILLIMETERS
SURFACE FINISH:
TOLERANCES:
LINEAR:
ANGULAR:

TITLE:
Payload Body-Surface-Flatten2

DRAWN
CHK'D
APPV'D
MFG Q.A
