tar7operator/Pinaka/16. CAD V5/Drawings/General Arrangement V5.pdf

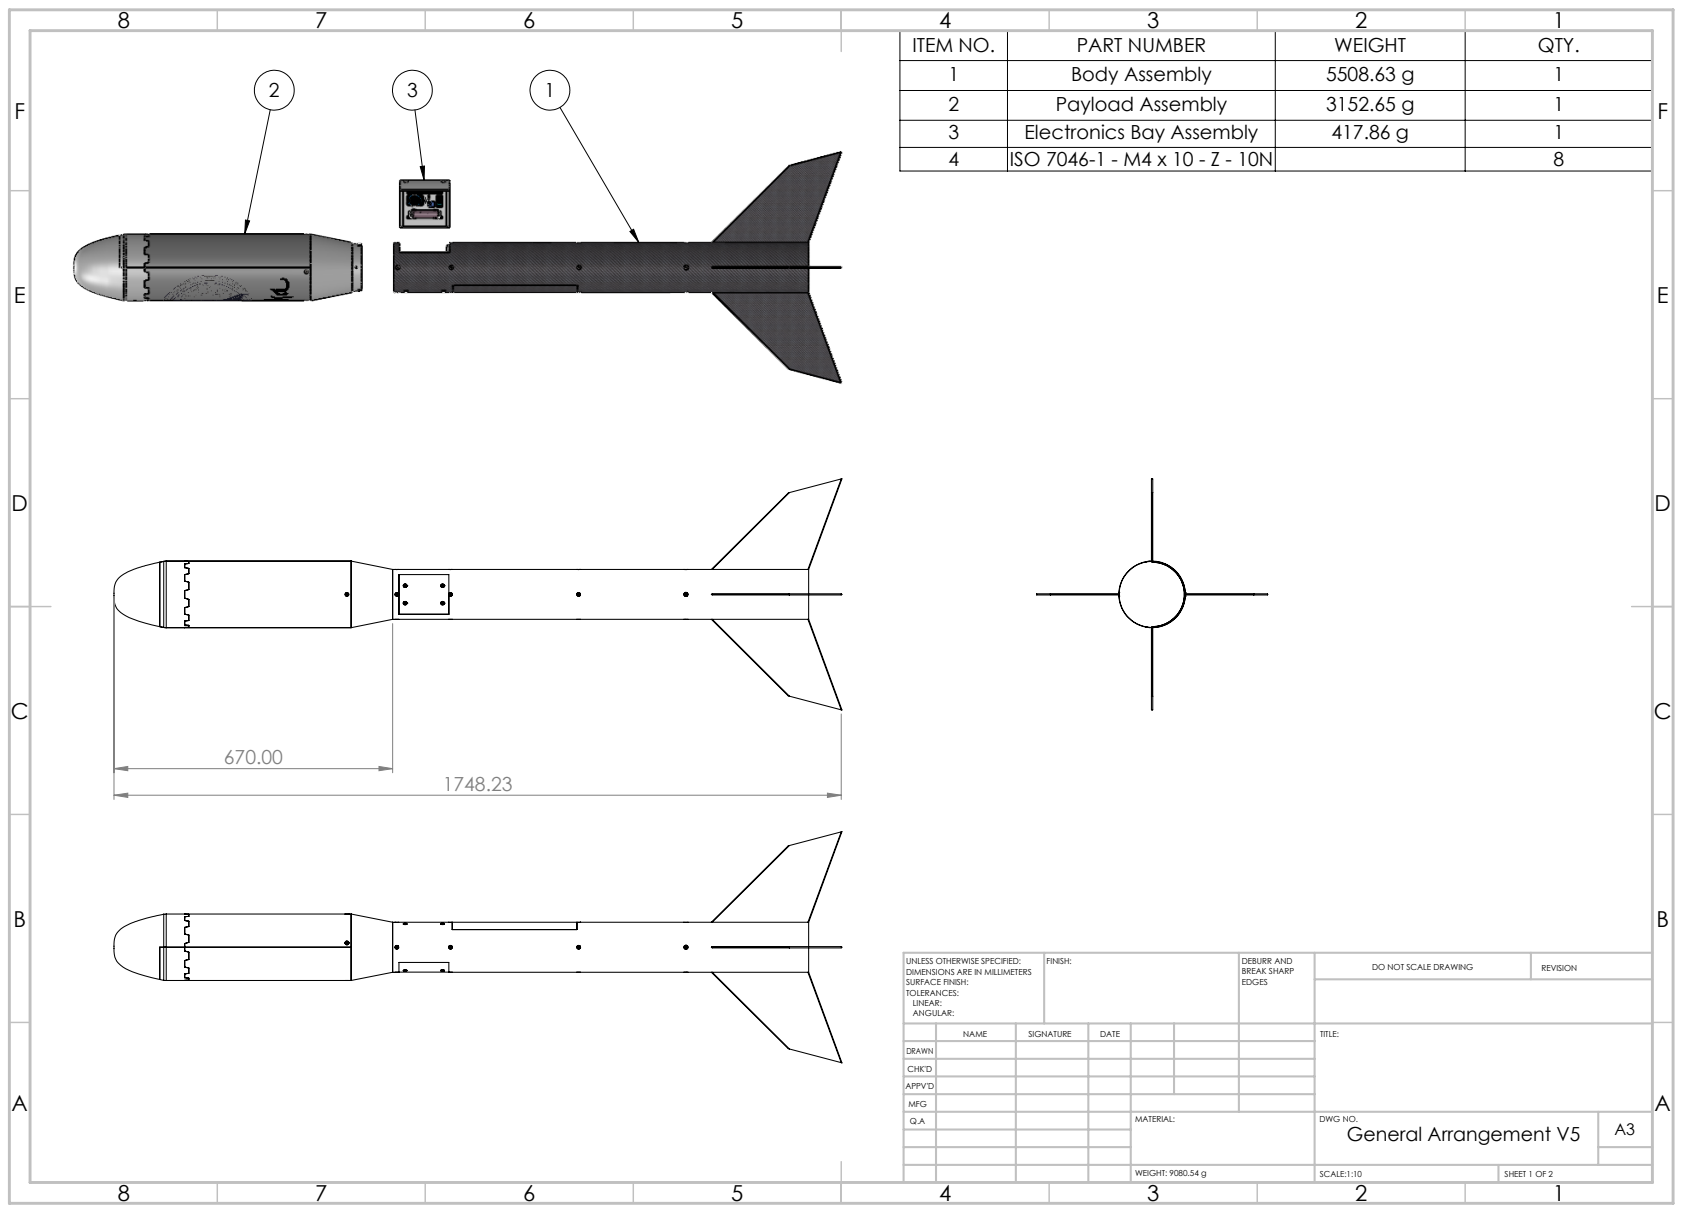
[picture p321: page 1]
FINISH:; DEBURR AND; BREAK SHARP; DO NOT SCALE DRAWING; REVISION; SCALE:1:10; SHEET 1 OF 2; WEIGHT: 9080.54 g

ITEM NO. | PART NUMBER | WEIGHT | QTY.
1 | Body Assembly | 5508.63 g | 1
2 | Payload Assembly | 3152.65 g | 1
3 | Electronics Bay Assembly | 417.86 g | 1
4 | ISO 7046-1 - M4 x 10 - Z - 10N | | 8

UNLESS OTHERWISE SPECIFIED:
DIMENSIONS ARE IN MILLIMETERS
SURFACE FINISH:
TOLERANCES:
LINEAR:
ANGULAR:

NAME | SIGNATURE | DATE | | | | TITLE:

DRAWN
CHK'D
APPV'D
MFG
Q.A | | | | MATERIAL: | DWG NO. General Arrangement V5 | A3

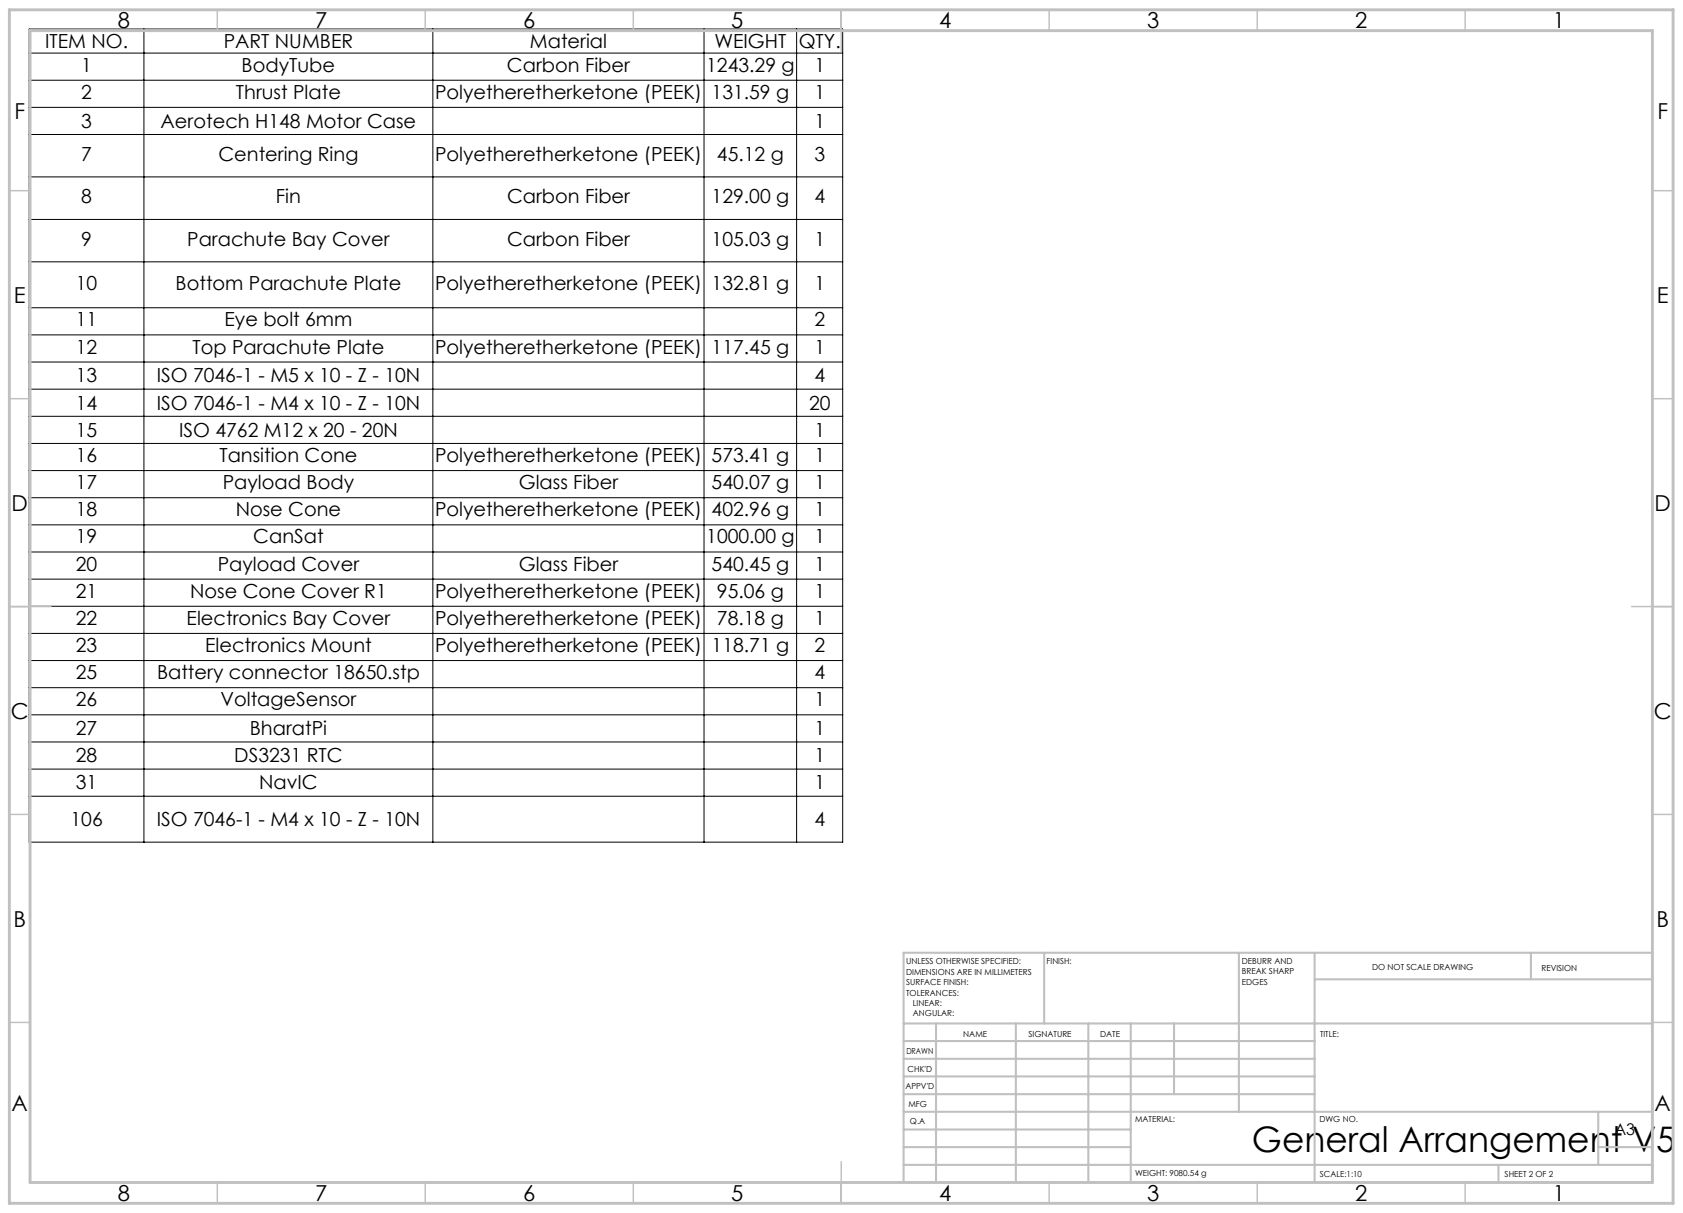
[picture p322: page 2]
ITEM NO.; PART NUMBER; Material; WEIGHT QTY.; BodyTube; Carbon Fiber; Thrust Plate; Polyetheretherketone (PEEK) 131.59 g 1; Aerotech H148 Motor Case; Centering Ring; Polyetheretherketone (PEEK) 45.12 g 3; Fin; Parachute Bay Cover; Bottom Parachute Plate; Polyetheretherketone (PEEK) 132.81 g 1; Eye bolt 6mm; Top Parachute Plate; Polyetheretherketone (PEEK) 117.45 g 1; ISO 7046-1 - M5 x 10 - Z - 10N; ISO 7046-1 - M4 x 10 - Z - 10N; ISO 4762 M12 x 20 - 20N; Tansition Cone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

UNLESS OTHERWISE SPECIFIED:
DIMENSIONS ARE IN MILLIMETERS
SURFACE FINISH:
TOLERANCES:
LINEAR:
ANGULAR:

NAME | SIGNATURE | DATE | | | | TITLE:

DRAWN
CHK'D
APPV'D
MFG
Q.A | | | | MATERIAL: General Arrangement V5 | DWG NO. | A3
