tar7operator/Pinaka/16. CAD V5/Body Assembly/body tube flatten.PDF

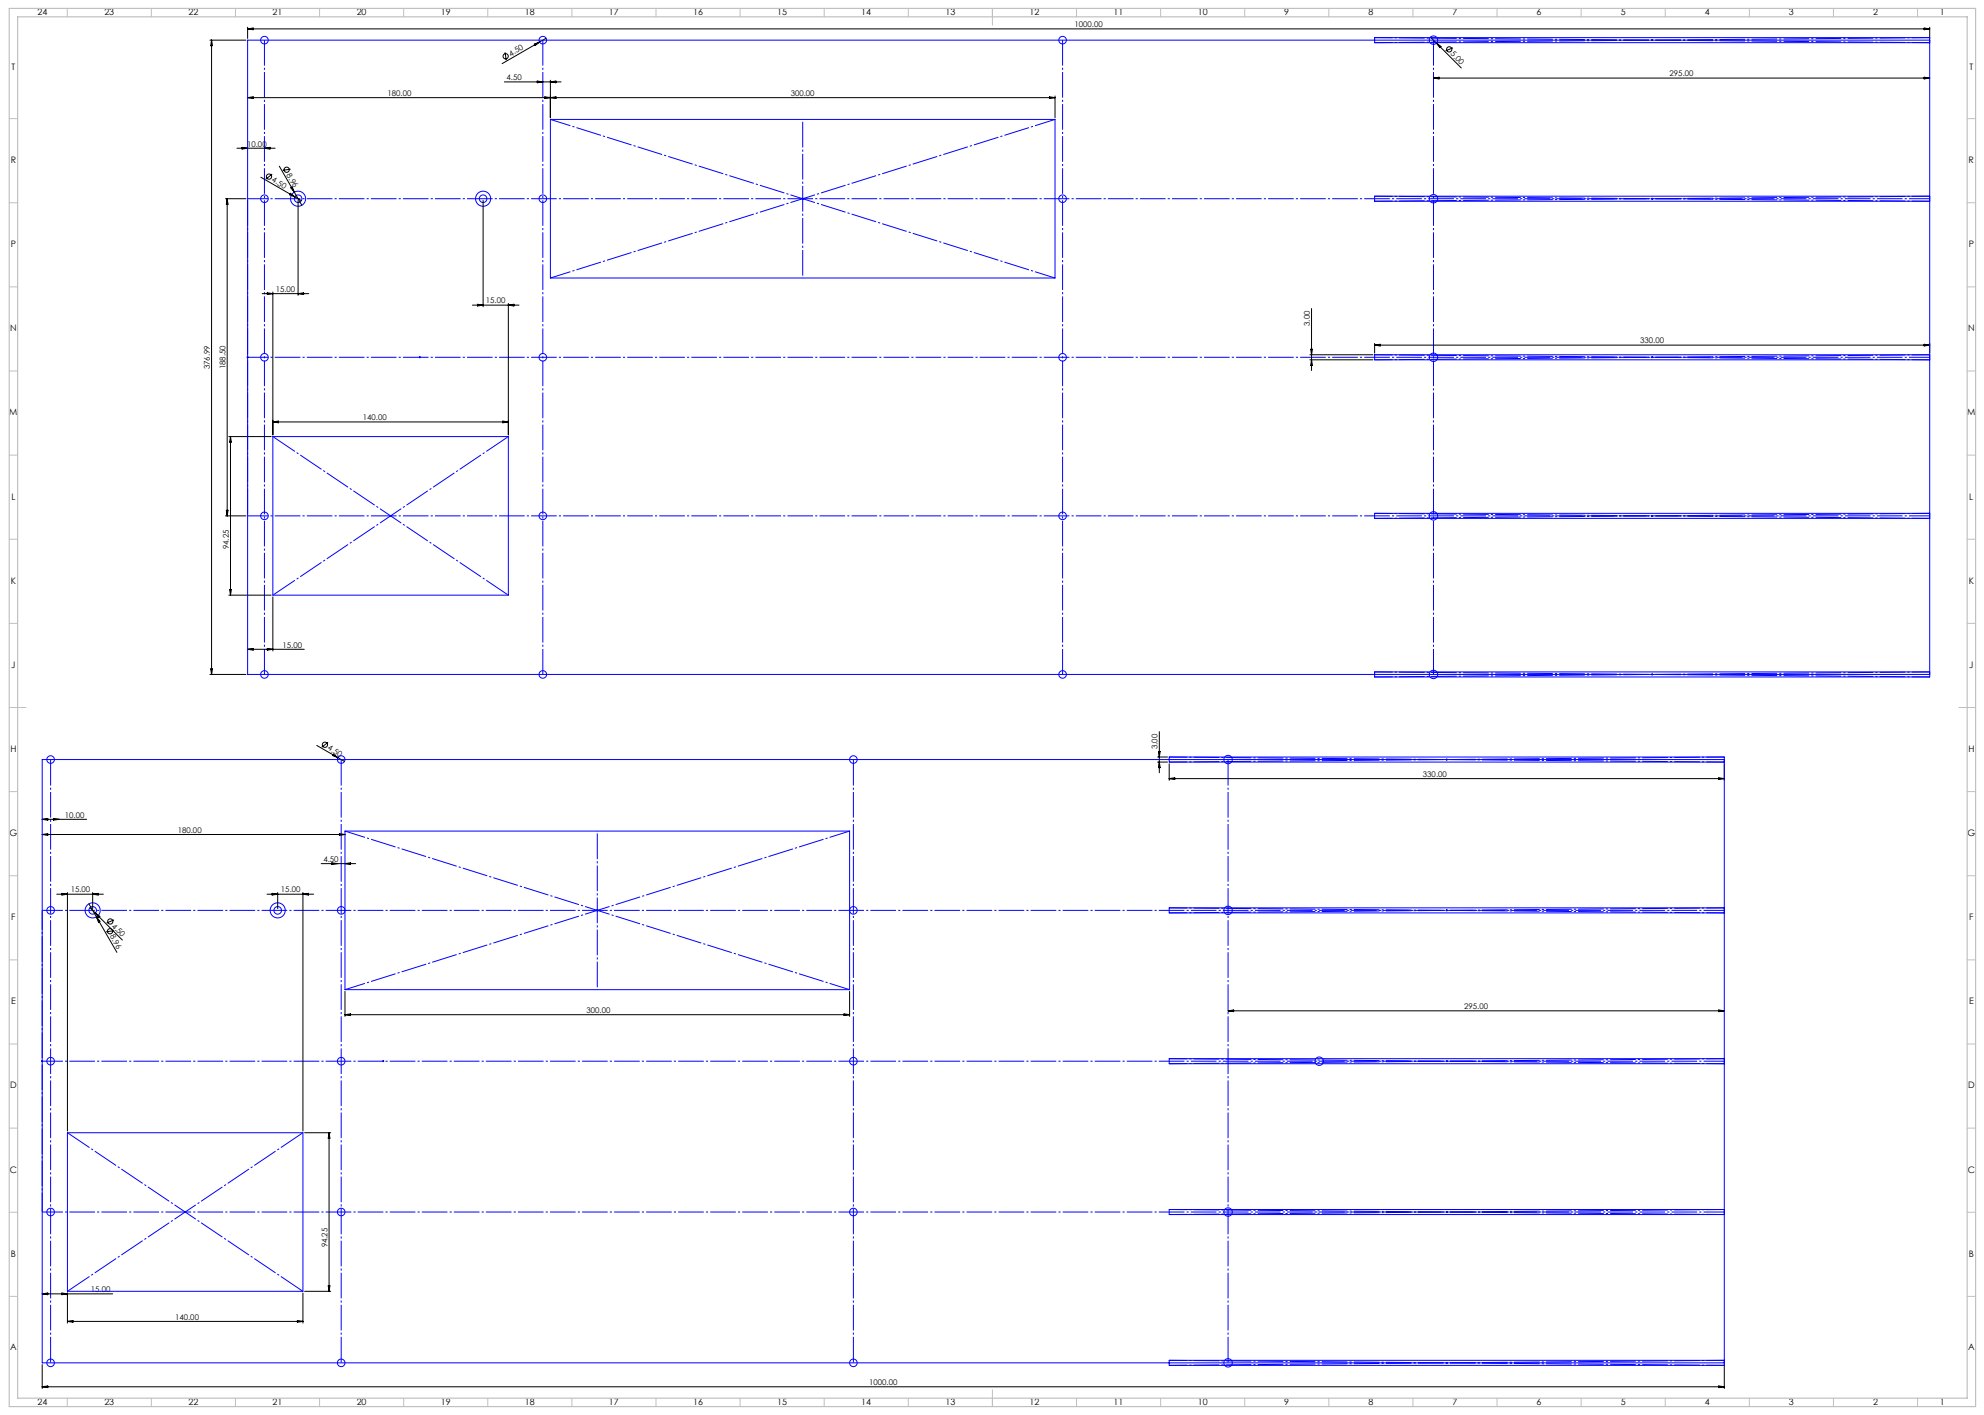
[picture p325: page 1]
