tar7operator/Pinaka/16. CAD V5/Drawings/Body Assembly/BodyTube-Surface-Flatten2.pdf

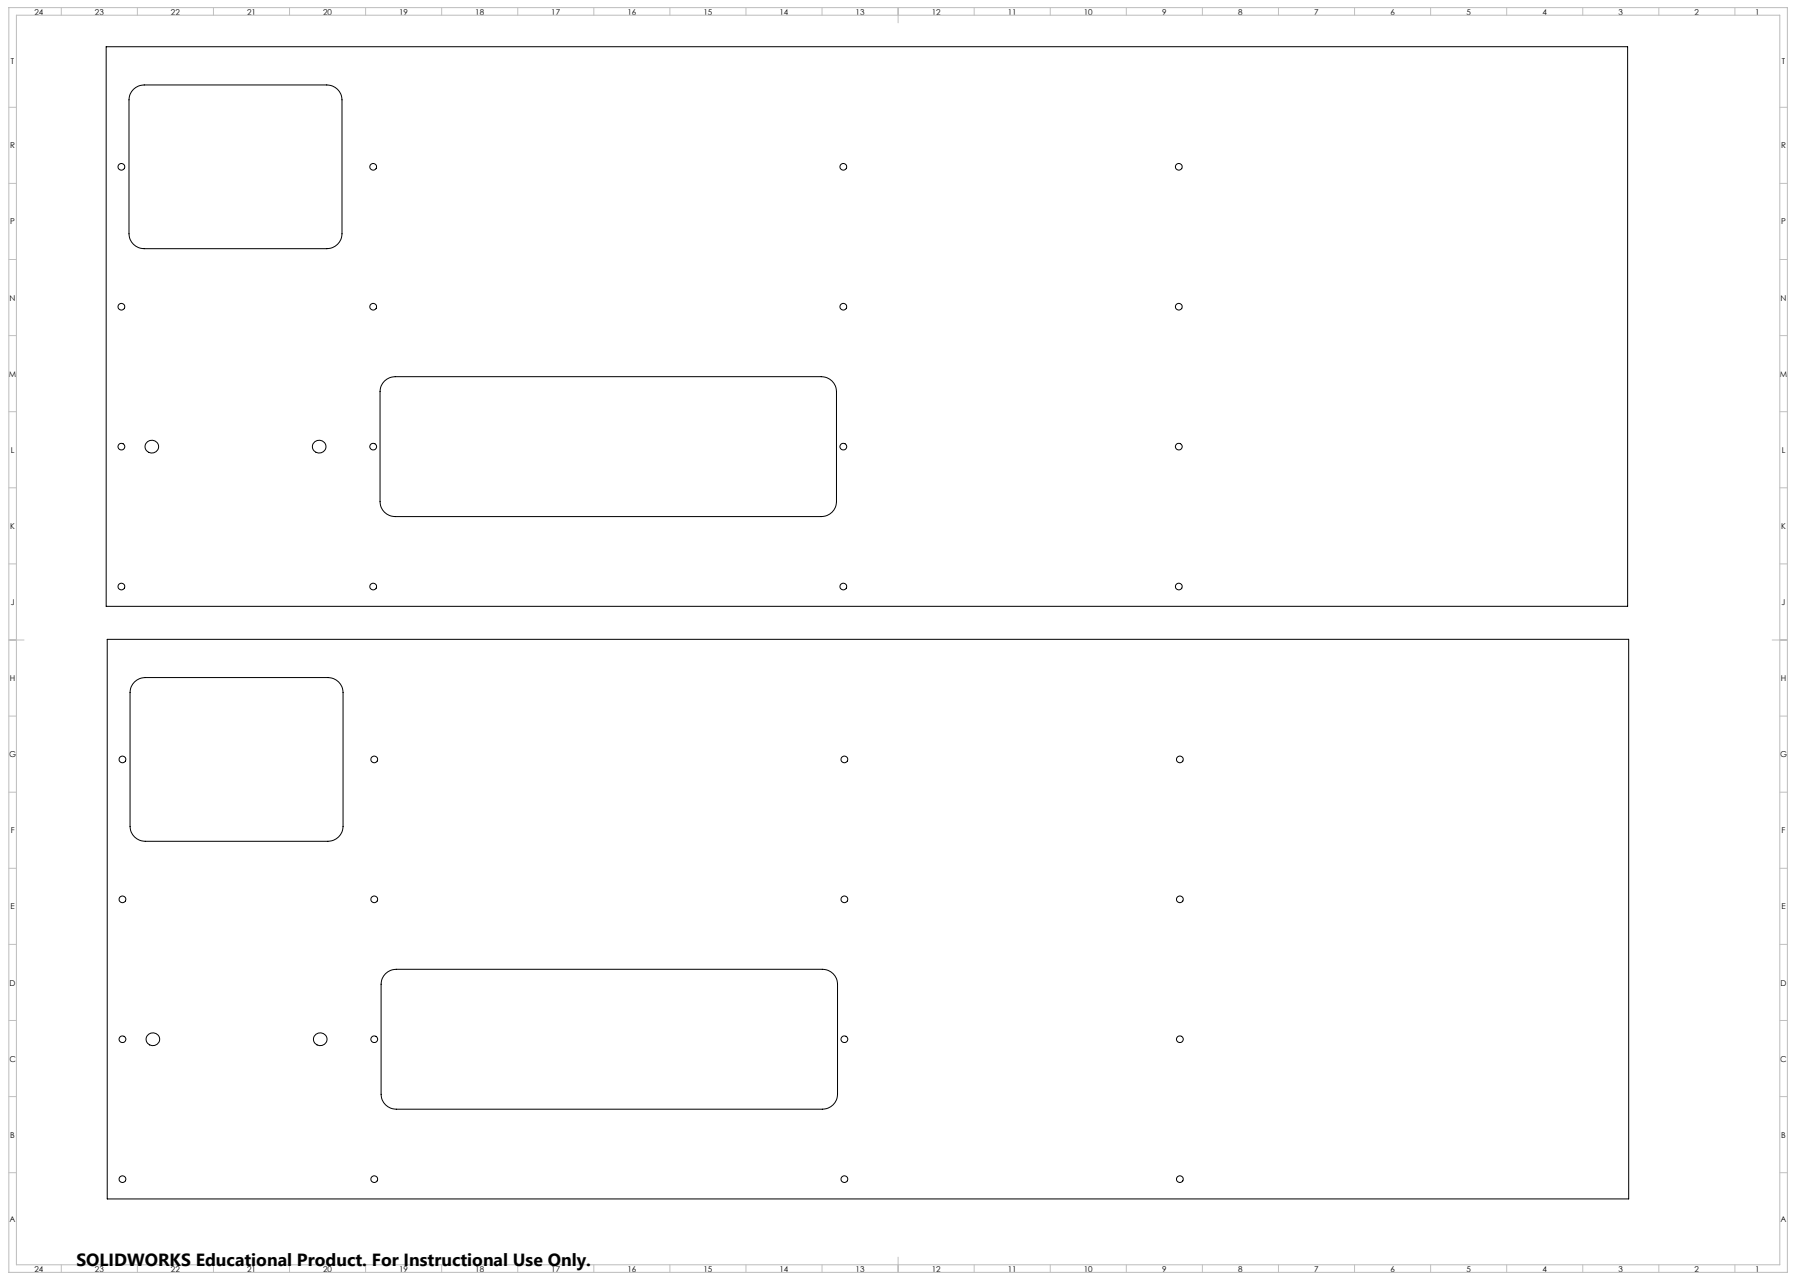
[picture p326: page 1]

SOLIDWORKS Educational Product. For Instructional Use Only.
