tar7operator/Pinaka/16. CAD V5/Drawings/Schematics/CANSAT ELECTRONICS.pdf

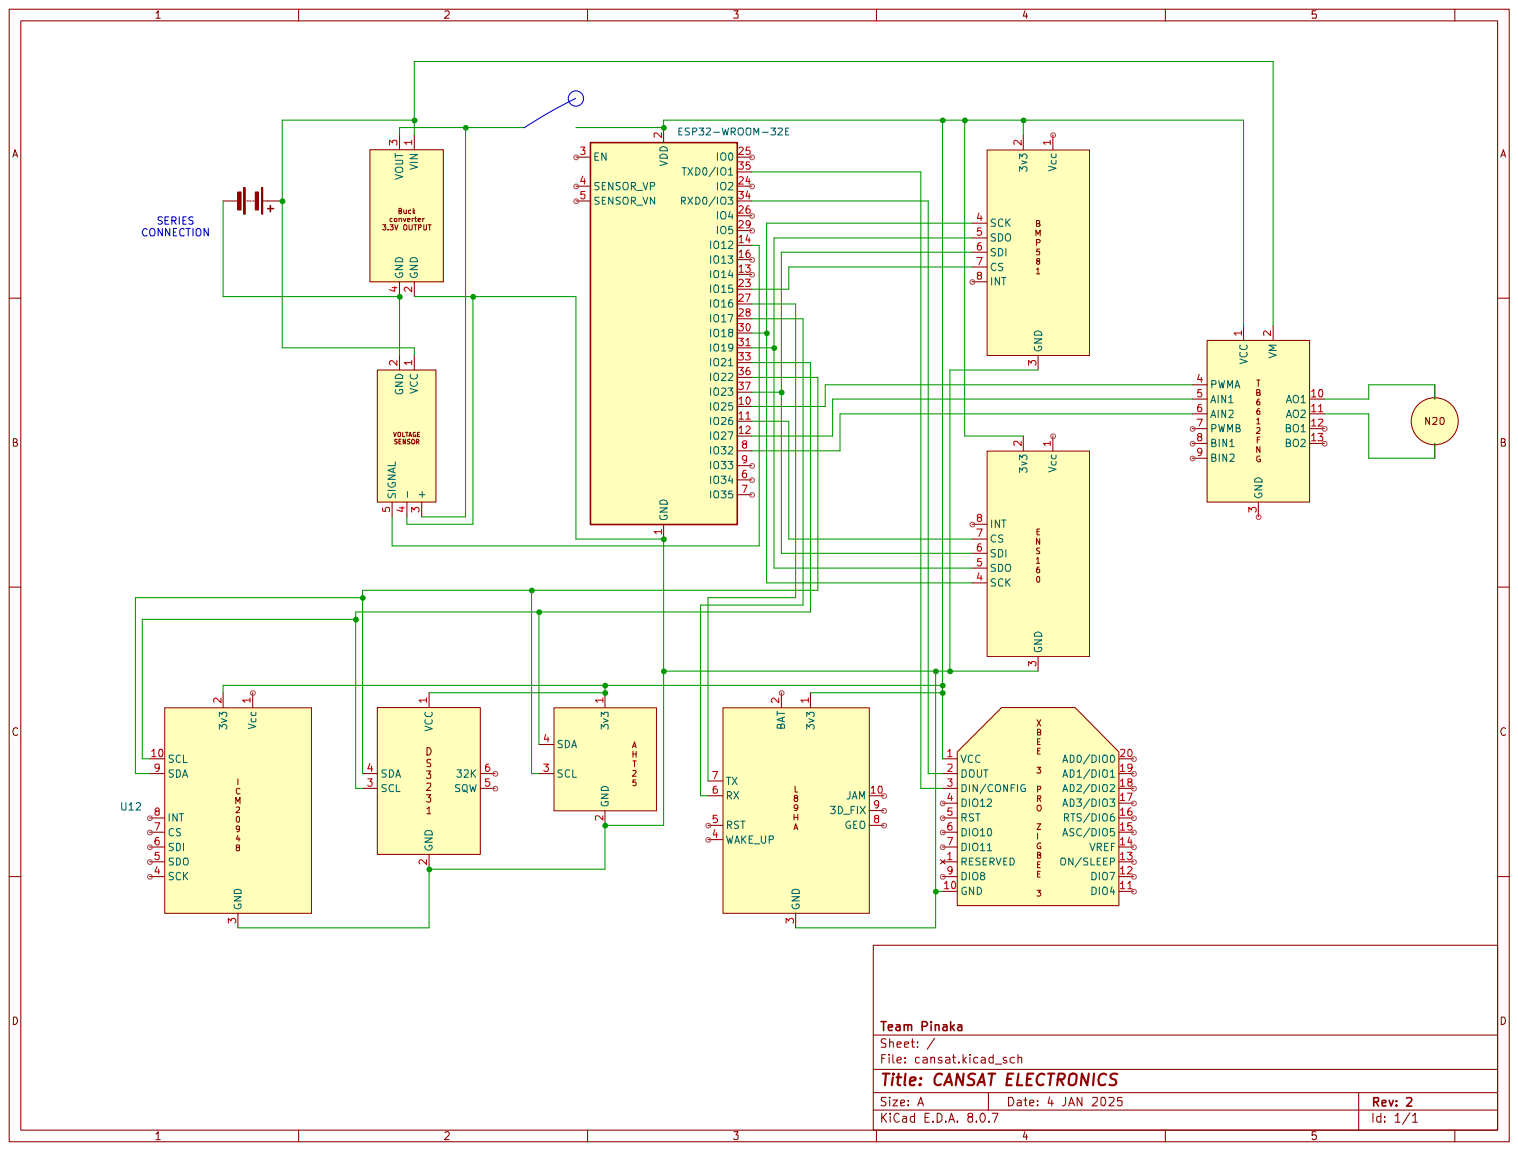
[picture p327: page 1]
