tar7operator/Pinaka/16. CAD V5/Drawings/Schematics/gstationignition.pdf

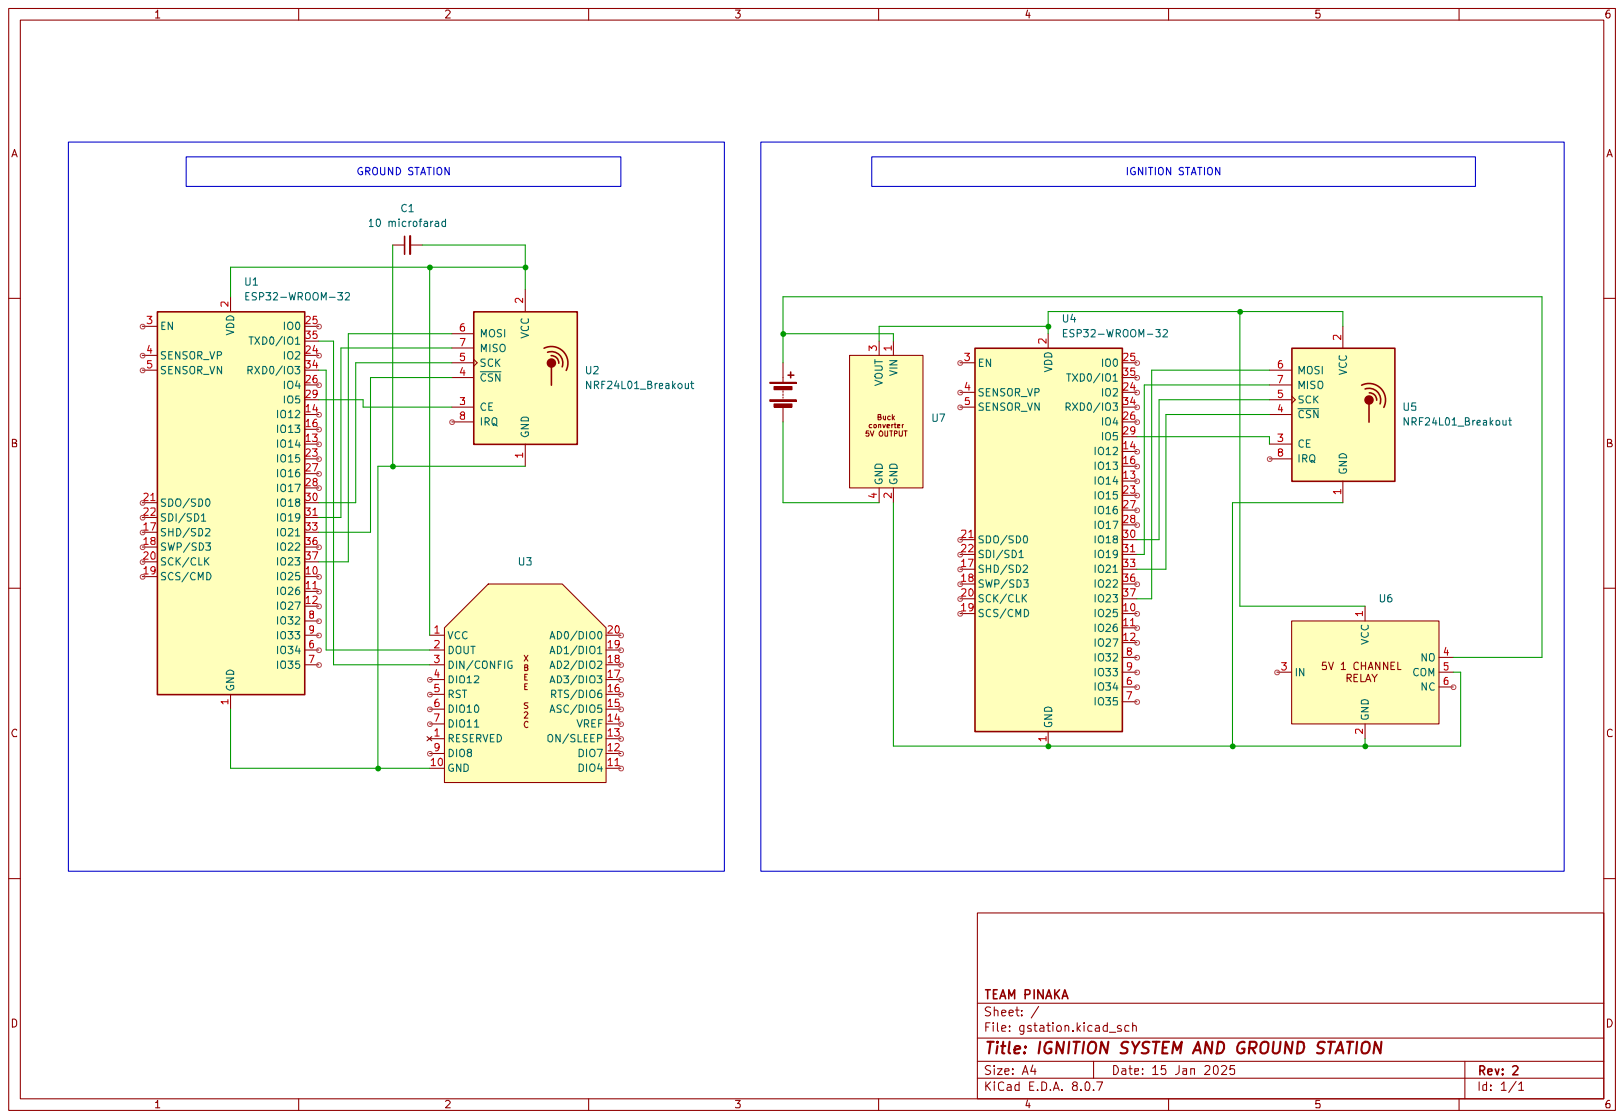
[picture p328: page 1]
