tar7operator/Pinaka/16. CAD V5/Drawings/Schematics/ROCKET ELLEC.pdf

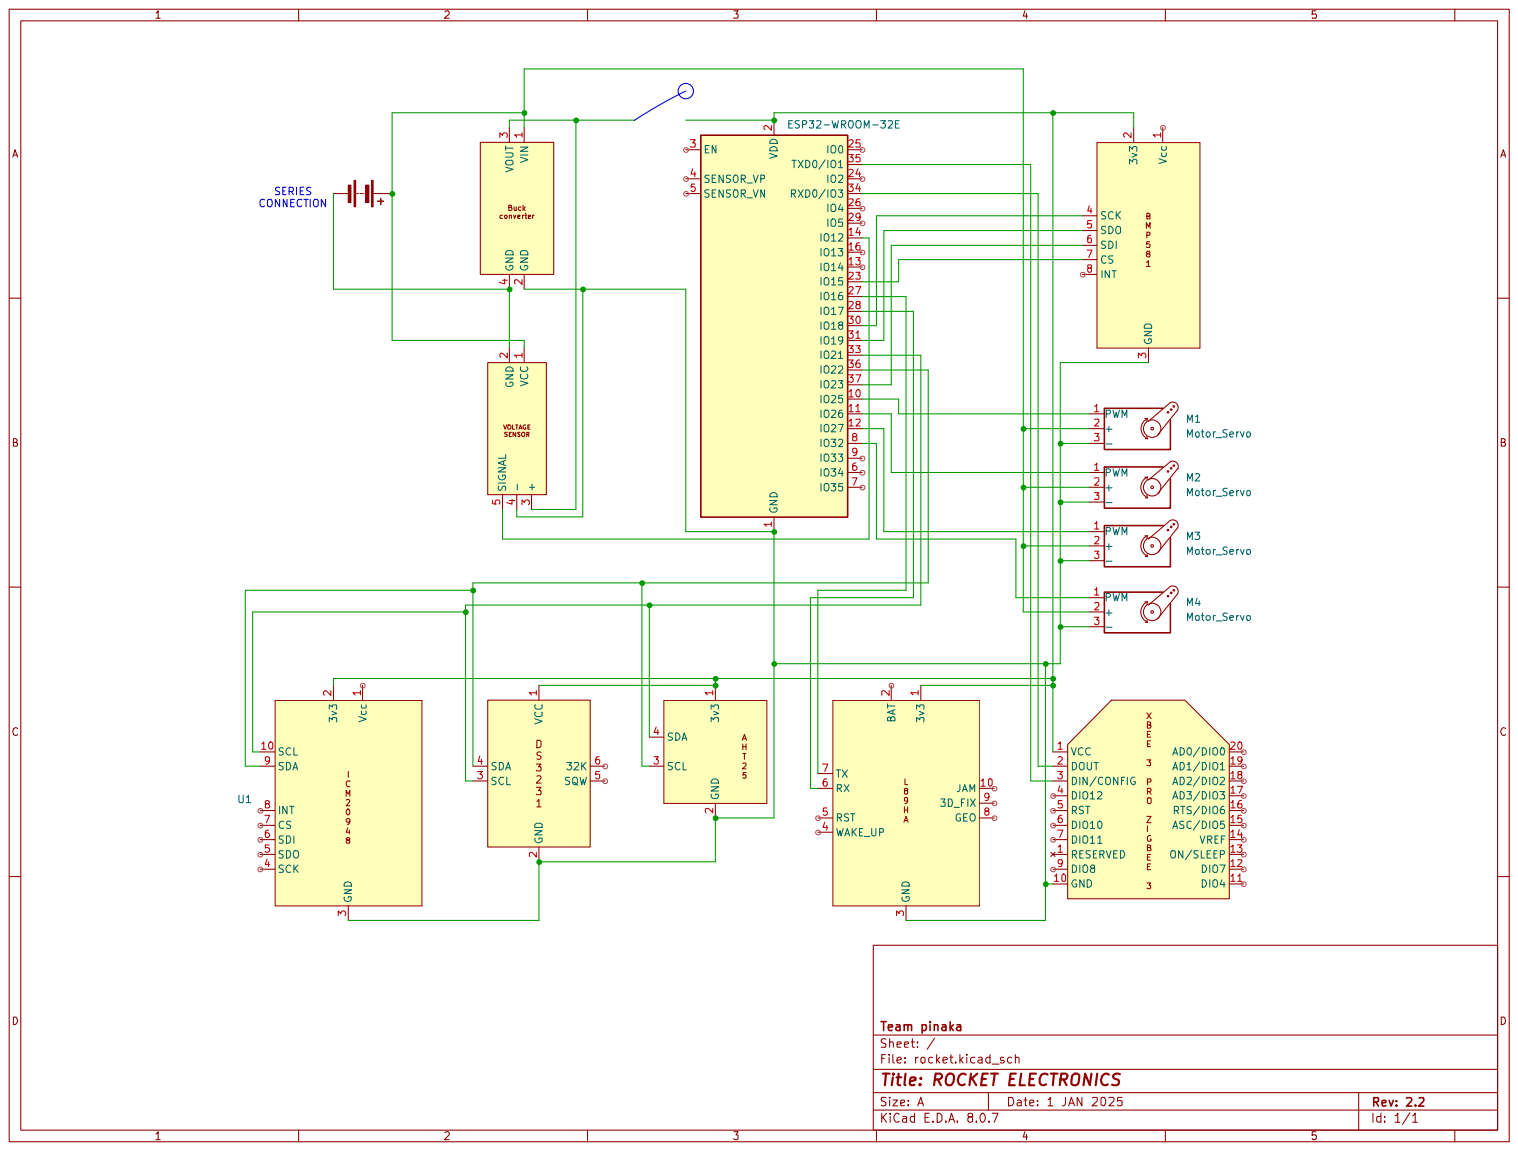
[picture p329: page 1]
