tar7operator/Pinaka/9. Records/Electronics/Evelta/Sensors/Sensors.pdf

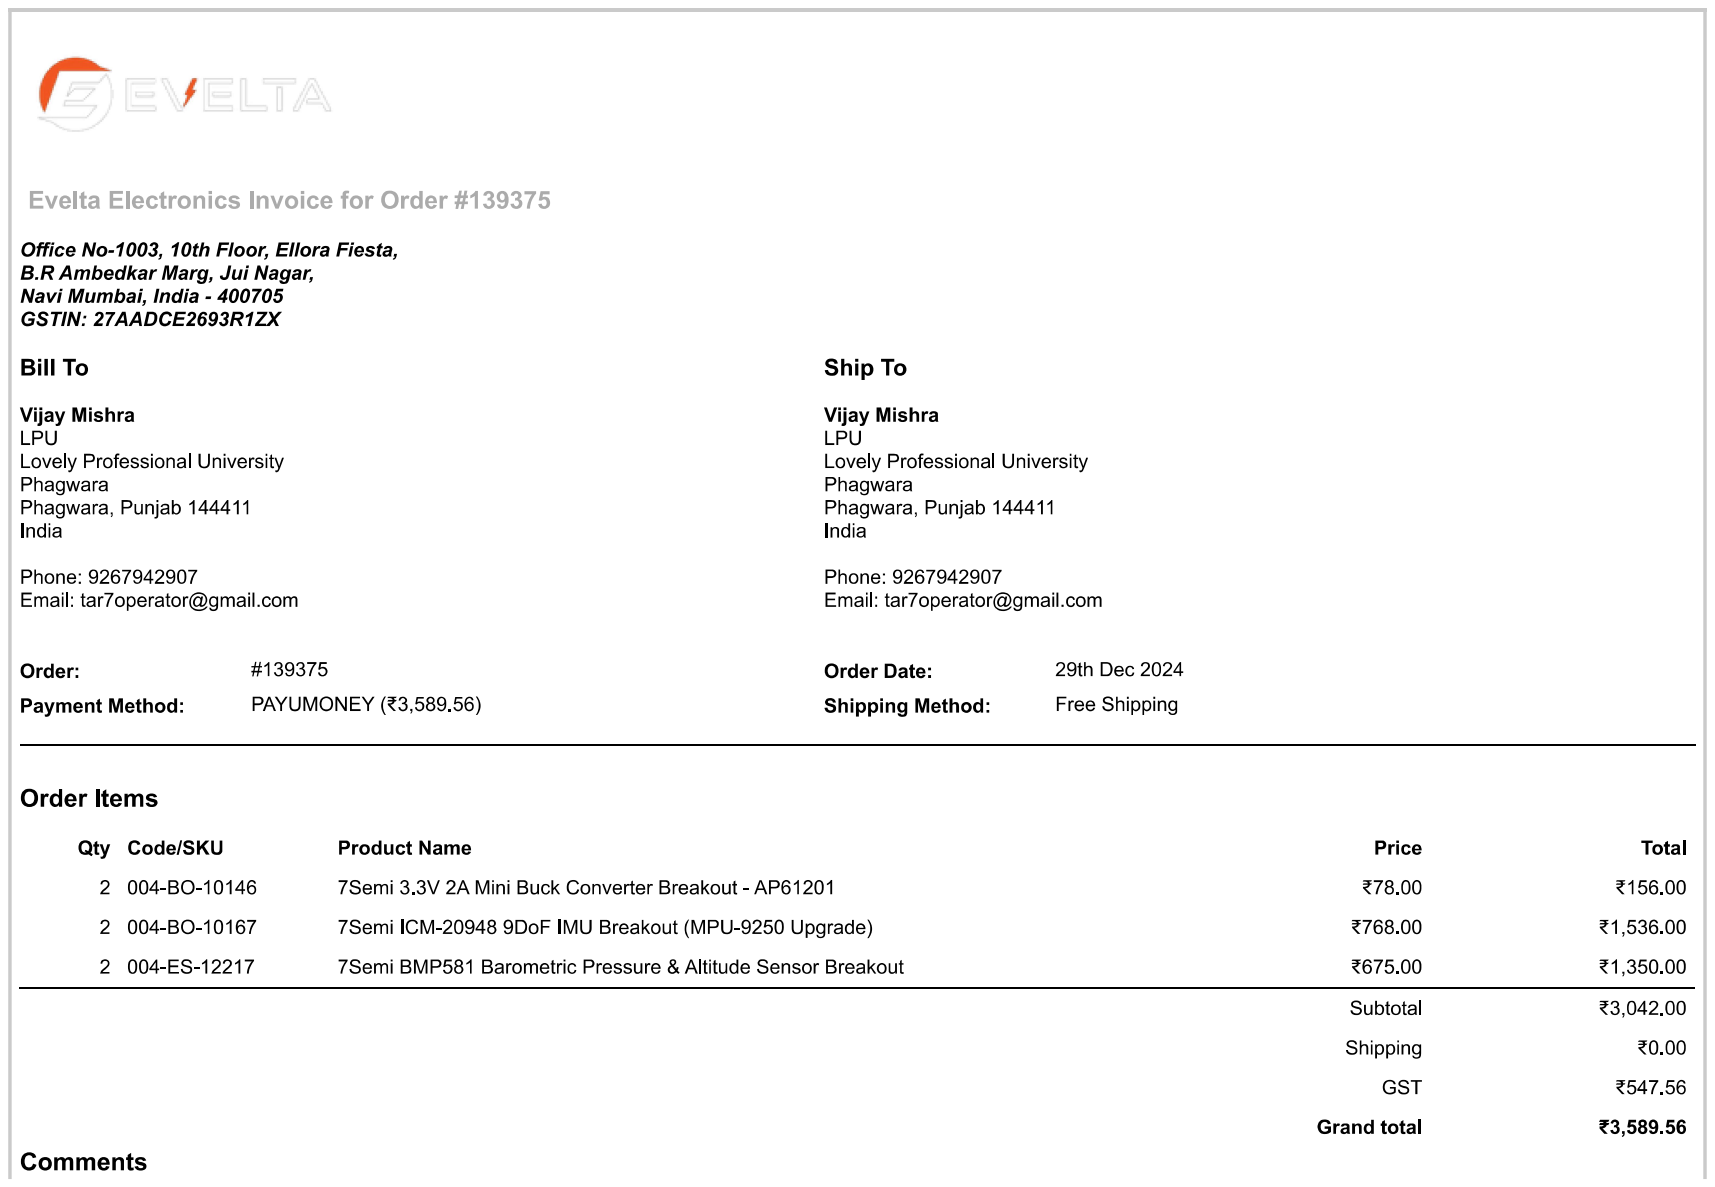
[picture p330: page 1]
