tar7operator/Pinaka/9. Records/Budget Distribution.pdf

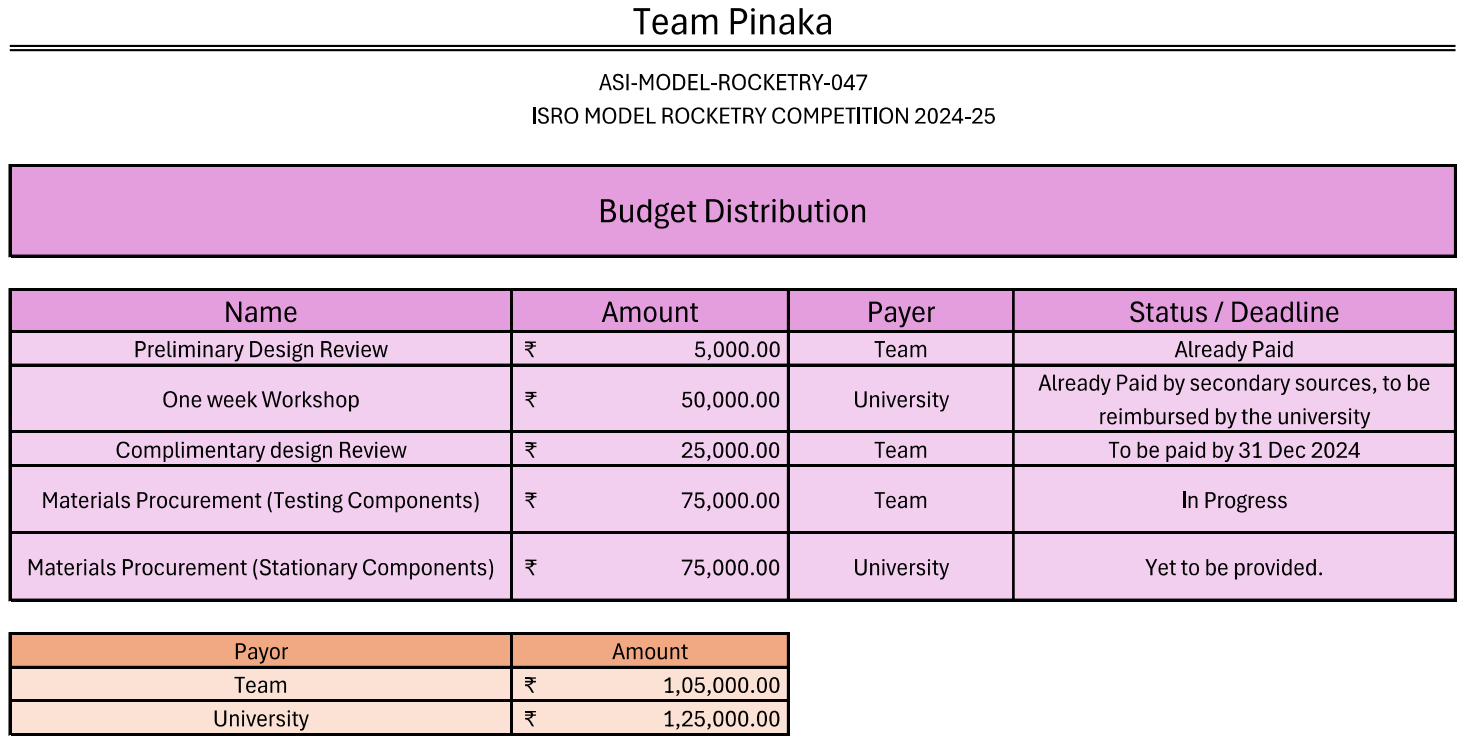
[picture p331: page 1]
