tar7operator/Pinaka/9. Records/Funding Assistance.pdf

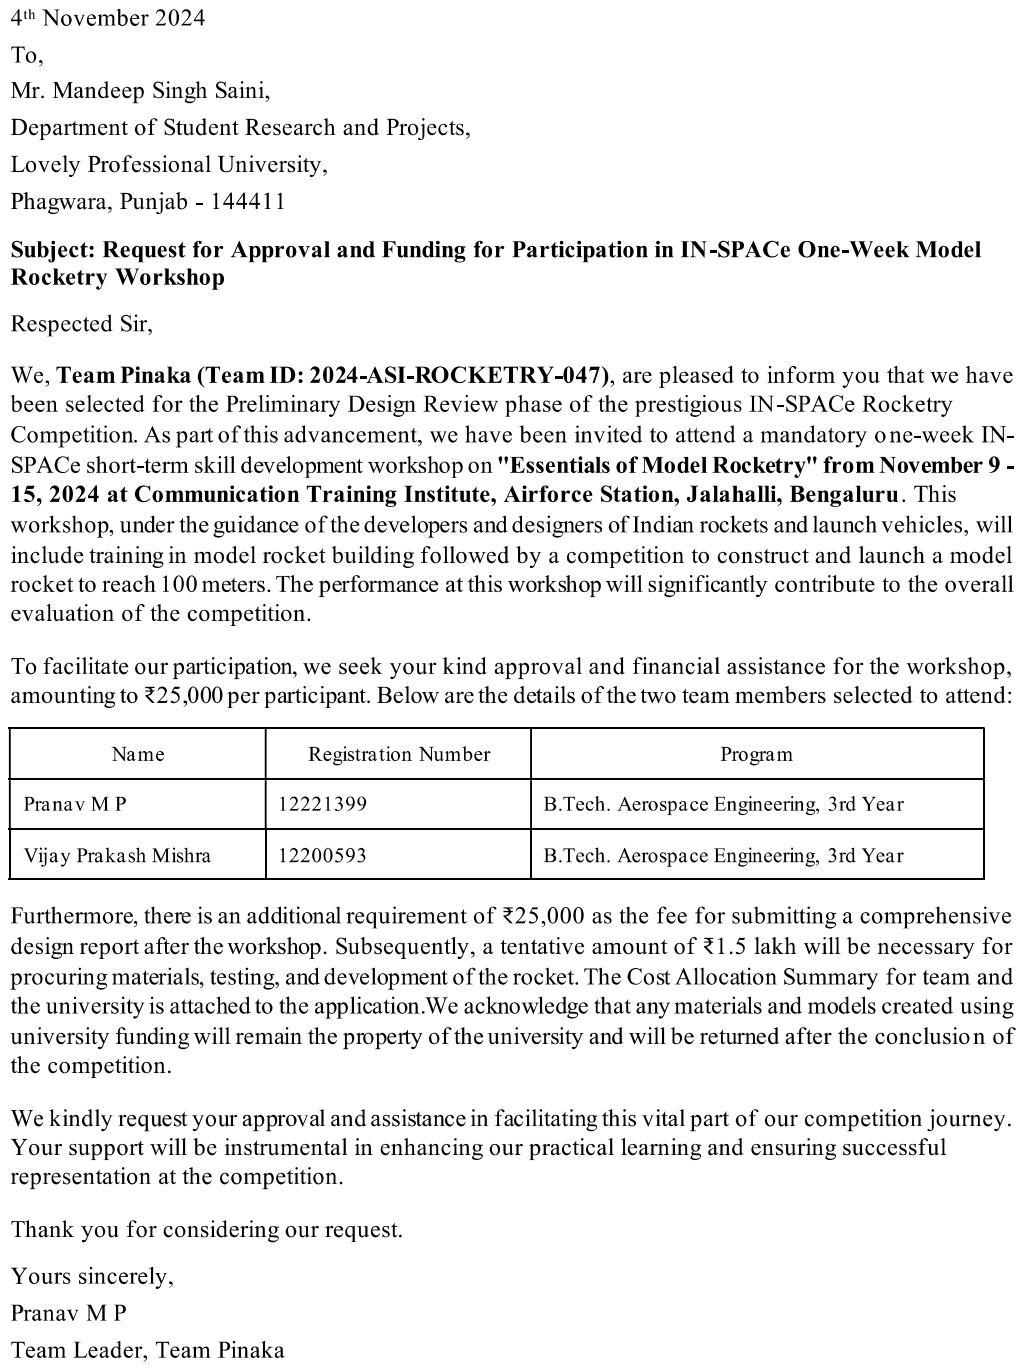
[picture p332: page 1]

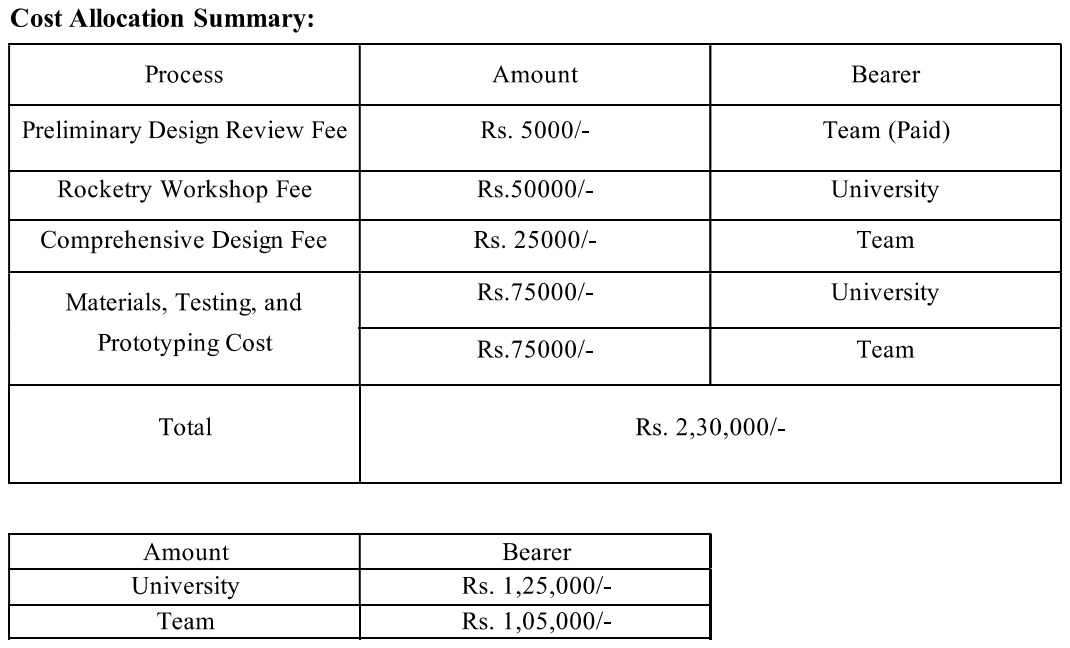
[picture p333: page 2]
