tar7operator/Pinaka/9. Records/Review Email.pdf

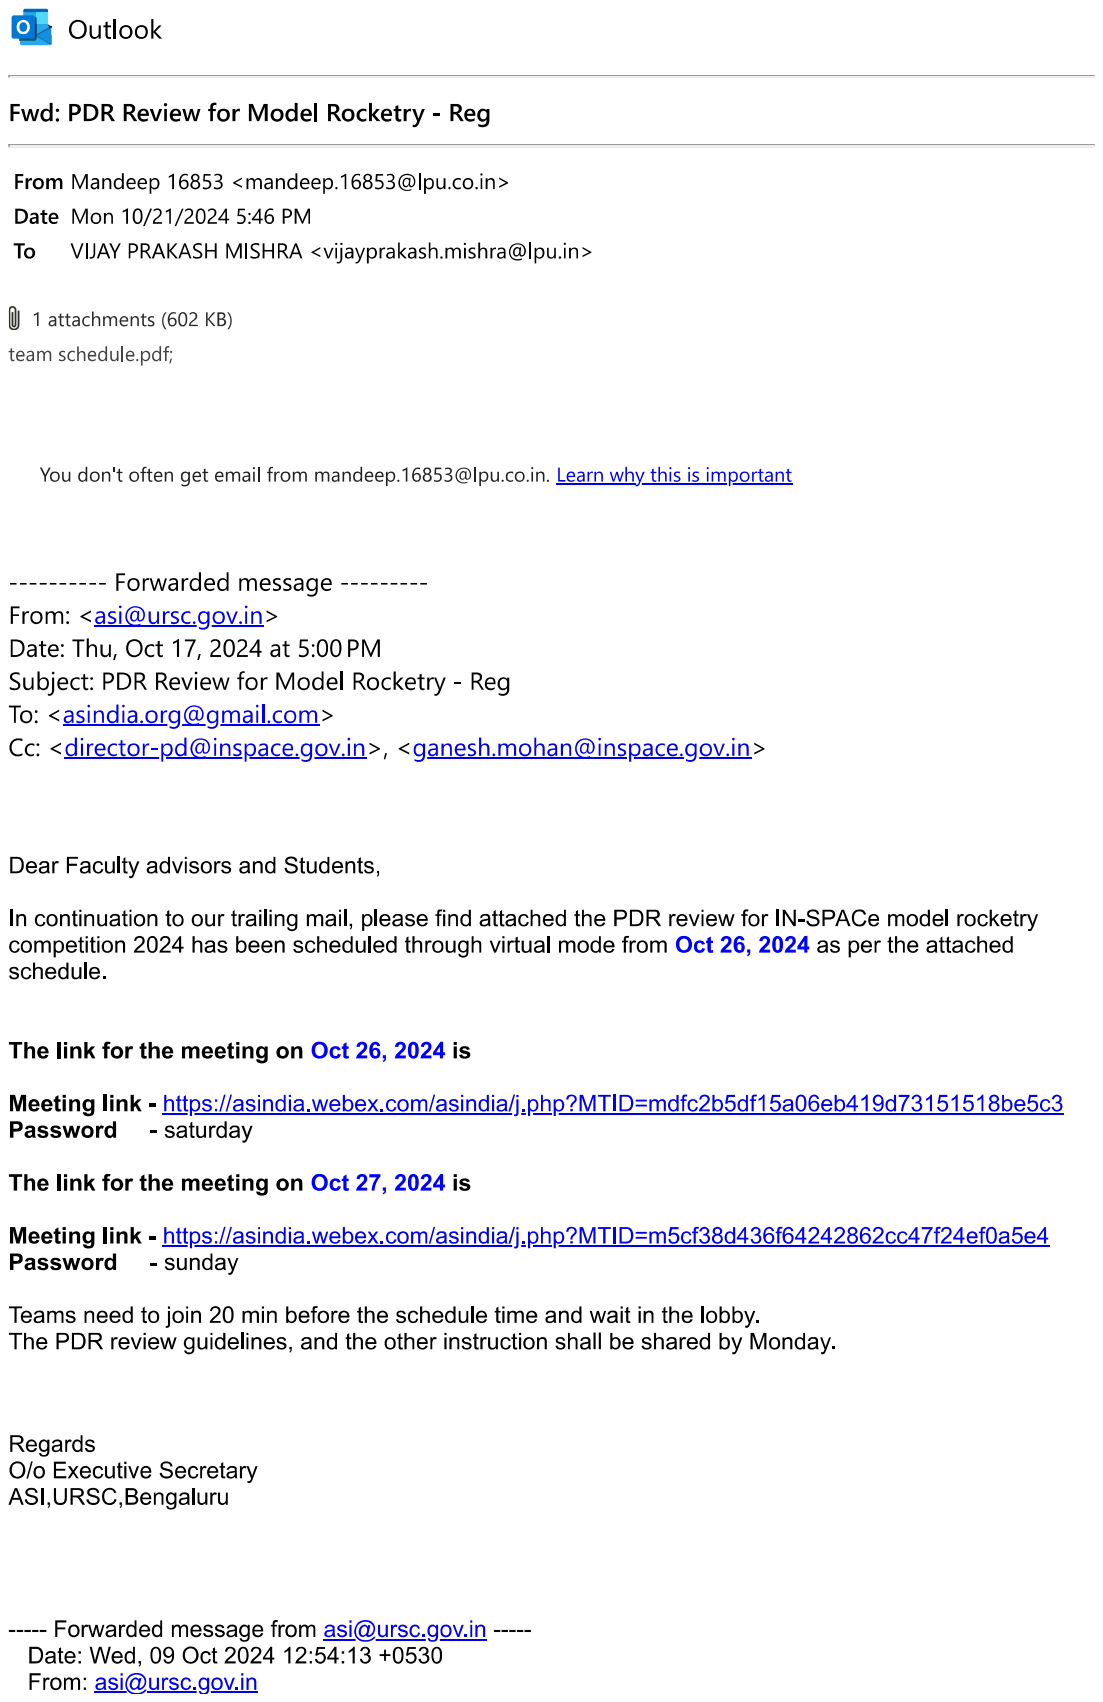
[picture p334: page 1]

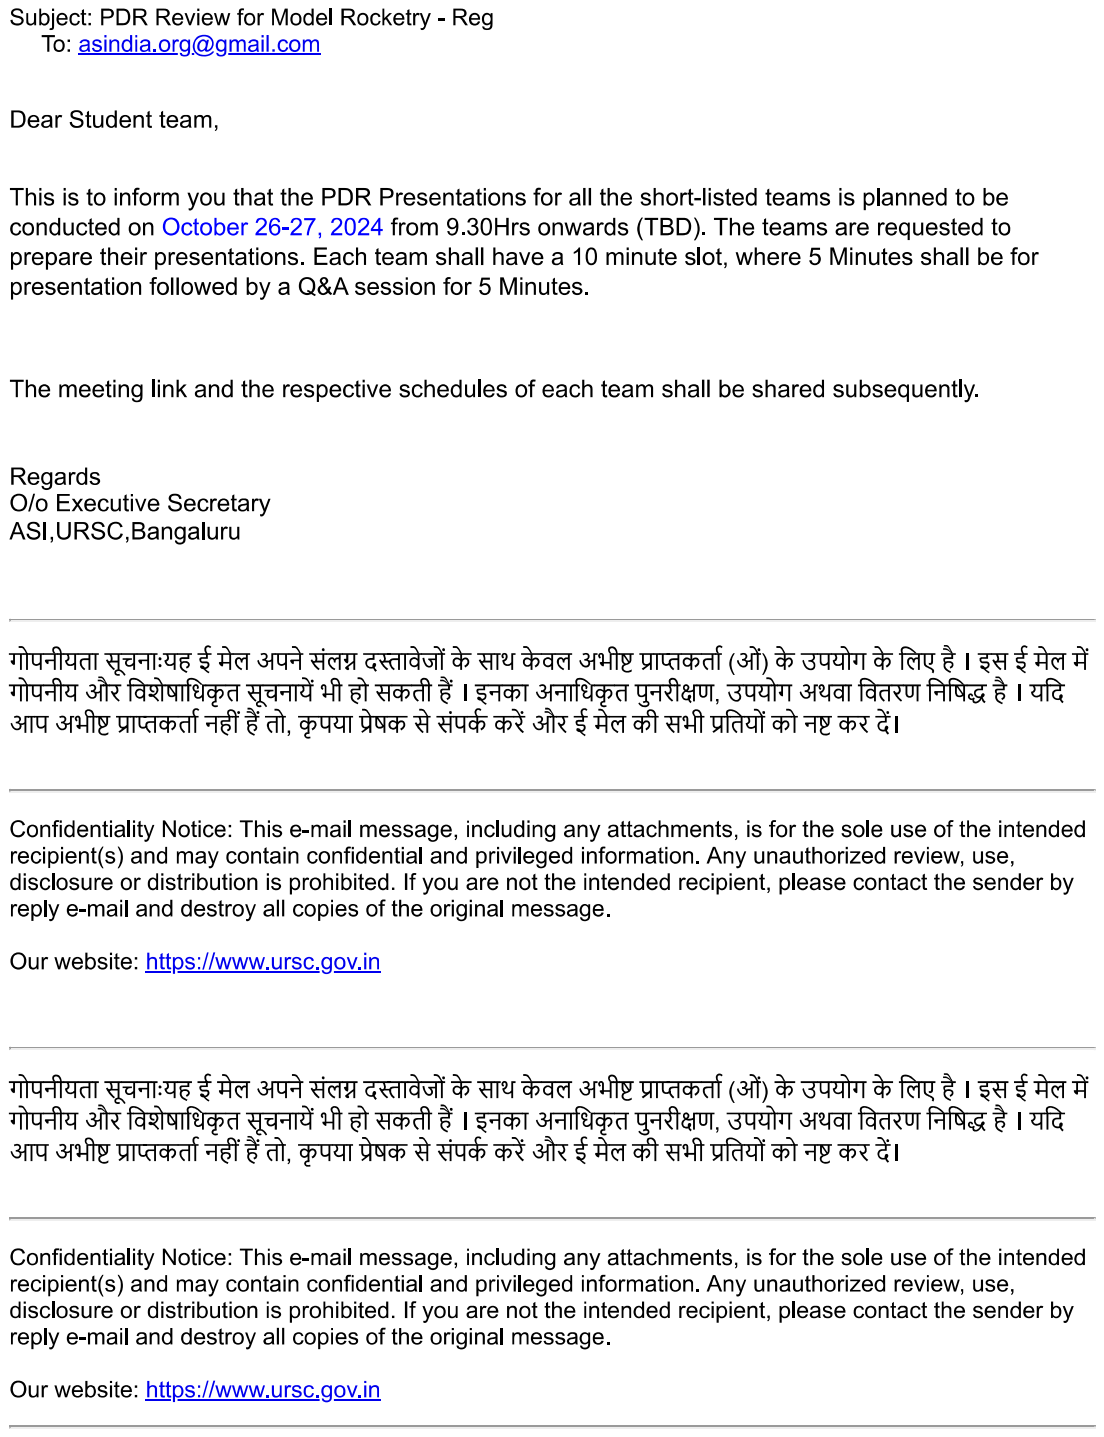
[picture p335: page 2]
