tar7operator/Pinaka/9. Records/Workshop Invitation.pdf

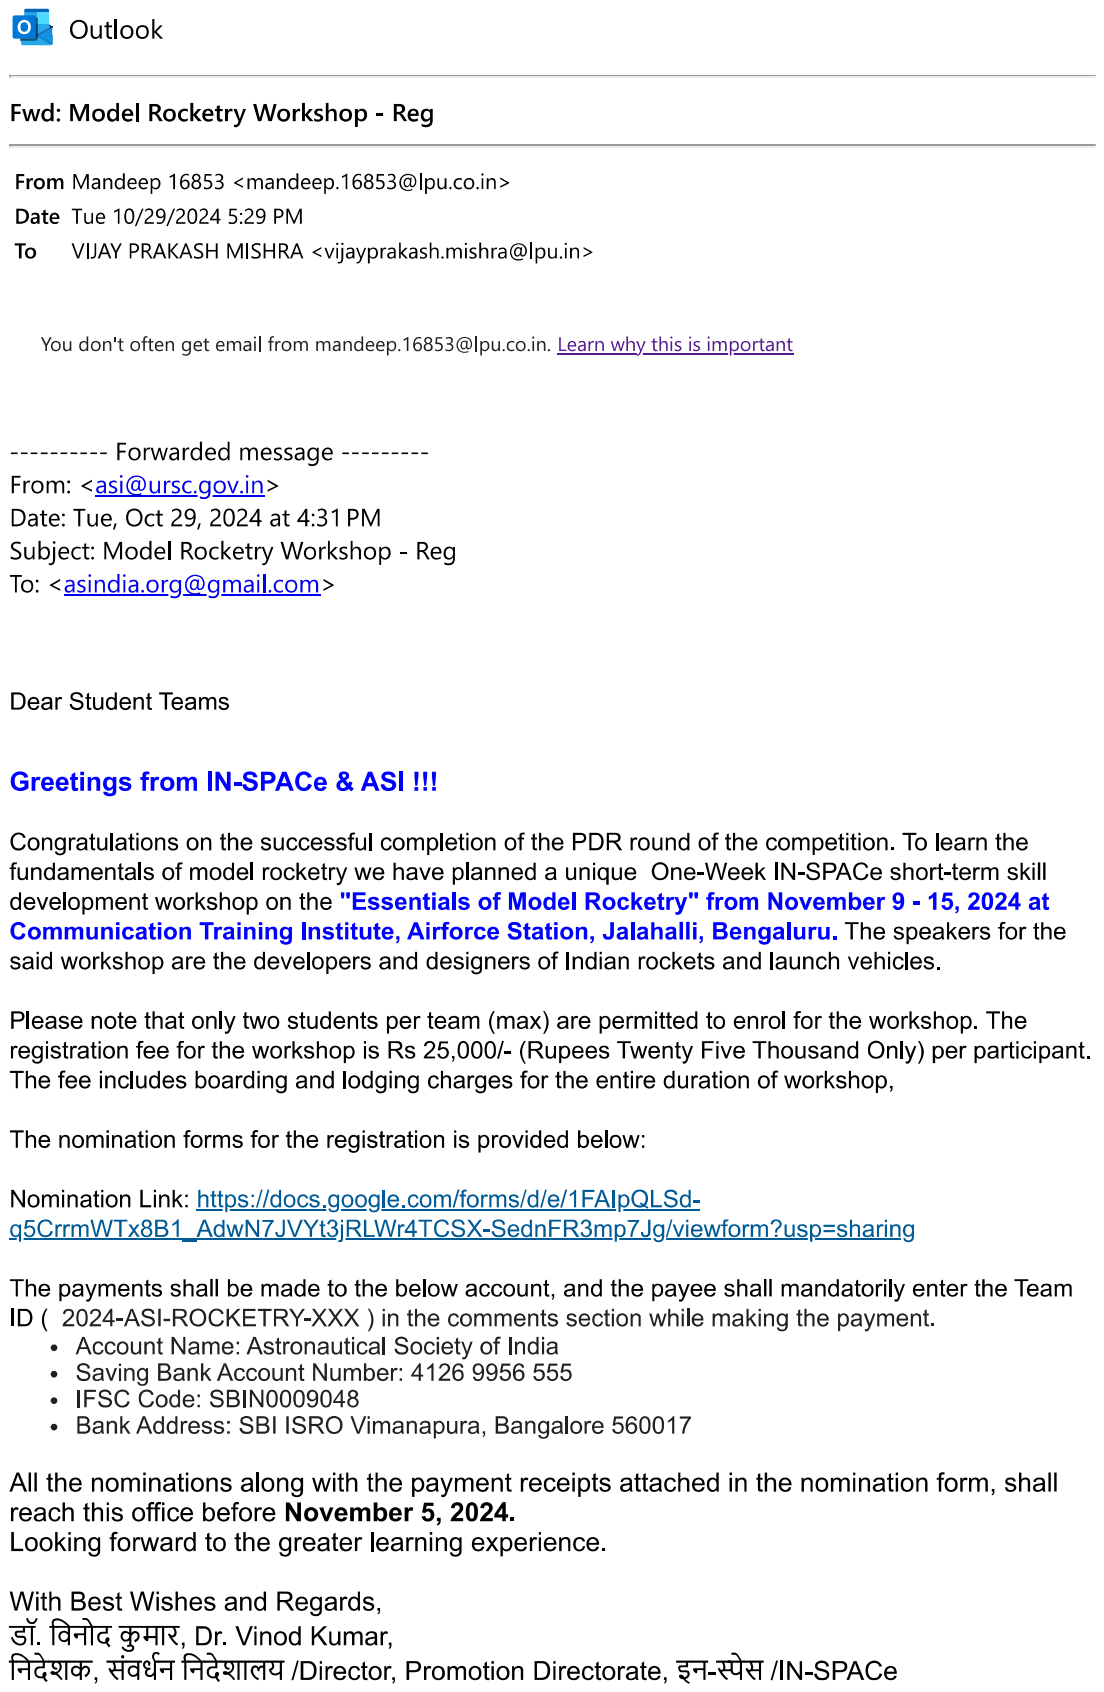
[picture p336: page 1]

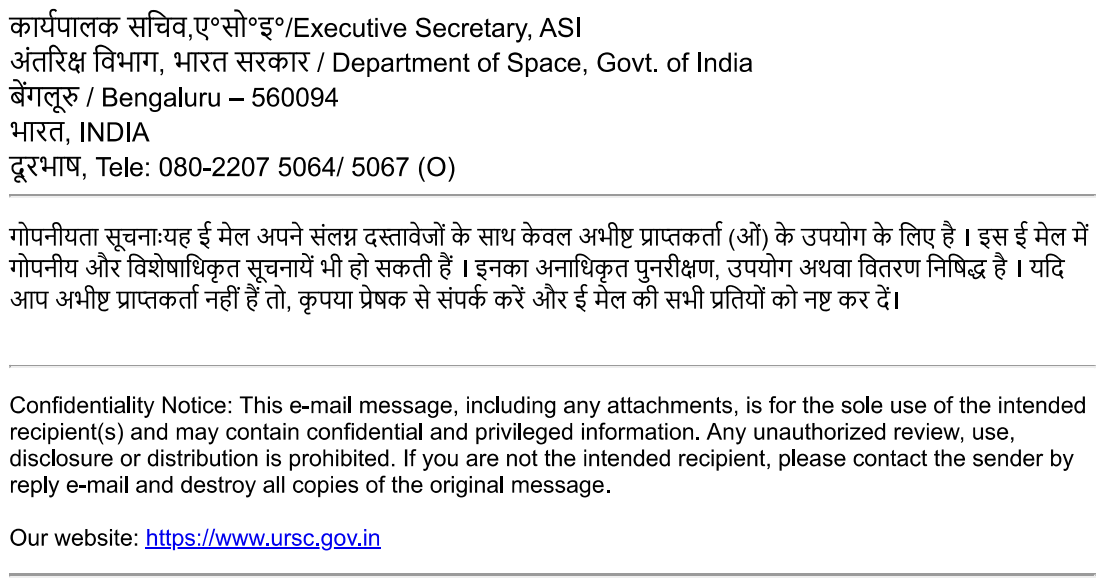
[picture p337: page 2]
