tar7operator/Pinaka/(commit log)

2024-09-27 added step file for M6 Eyebolt
    [3040T11_Steel Eyebolt -for Lifting.STEP]
2024-09-27 moved step file for M6 Eyebolt to V3
    [3040T11_Steel Eyebolt -for Lifting.STEP]
2024-09-27 Parachute file added
    [Parachute.SLDPRT]
2024-09-27 Primary Changes 2
    [CenteringPlate.SLDPRT, Fin.stp, Parachute.SLDASM, Parachute.SLDPRT, ParachuteCut.SLDPRT, PinakaV2.SLDASM, fins.igs, parachutePlate.SLDPRT]
2024-09-27 Added cansatCover Creo files
    [Flaps.SLDPRT]
2024-09-28 27th Sept Last
    [CansatCover.SLDPRT, FlapR.SLDPRT, Flaps.SLDPRT, PinakaV2.SLDASM, TransitionZone.SLDPRT]
2024-09-28 or files added
    [3040T11_Steel Eyebolt -for Lifting.STEP, Aerotech H148 Motor Case.SLDPRT, Aerotech H148 Nozzle Cap.SLDPRT, Aerotech H148 Nozzle Nut.SLDPRT, Aerotech H148 Nozzle.SLDPRT, Assemblage Aerotech H148 (2).SLDASM, Assemblage Aerotech H148.SLDASM, CansatCover.SLDPRT]
2024-09-28 Primary 5
    [CansatCover.SLDPRT, Flaps.SLDPRT, Flex.SLDPRT, PinakaV2.SLDASM, TransitionMechanism.SLDASM, TransitionZone.SLDPRT, bodyCover.SLDPRT, m3 x 12 hex button hd.STEP]
2024-09-28 Primary 6
    [CenteringPlate.SLDPRT, M6 hex nut.STEP, PinakaV2.SLDASM, m3 hex nut 2.4.STEP]
2024-09-28 Aerotech motor updated to required size 75*289 mm
    [Aerotech H148 Motor Case.SLDPRT, Aerotech H148 Nozzle Cap.SLDPRT, Aerotech H148 Nozzle Nut.SLDPRT, Aerotech H148 Nozzle.SLDPRT, Assemblage Aerotech H148 (2).SLDASM, Assemblage Aerotech H148.SLDASM]
2024-09-28 Length adjusted for motor to 289.1 mm
    [Aerotech H148 Motor Case.SLDPRT, Assemblage Aerotech H148.SLDASM]
2024-09-28 changed length of motor to 289 mm
    in previous push it didnt save, so did it again
    [Aerotech H148 Motor Case.SLDPRT, Assemblage Aerotech H148.SLDASM]
2024-09-28 Final Commit
    Rocket body is finished, servos are left and parachute mechanism is left.
    [CansatCover.SLDPRT, CenteringPlate.SLDPRT, Fin.SLDPRT, Flaps.SLDPRT, M2.5 Hex Screw v2.step, M5 Hex nut.SLDPRT, MG90S Servo Motor.ipt, MG90S Servo Motor.stp]
2024-09-28 Older versions removed
    [AvionicCover.SLDPRT, Avionics Plate - Copy.SLDPRT, Avionics Plate.SLDPRT, AvionicsCover.SLDPRT, BoltCap.SLDPRT, Bottom cover.SLDPRT, BottomBody.SLDASM, BulkHead.SLDPRT]
2024-09-29 added step file for electronics bay given by v manish
    [electronics bay.step]
2024-09-29 added electronics bay to v3 assly
    [electronics bay.SLDPRT]
2024-09-30 Final Tweaks
    mech added for locking of cansat and parachute bay
    [Flaps.SLDPRT, NosePlate.SLDPRT, ThrustPlate.SLDPRT, Top Mechanism.SLDASM, TransitionMechanism.SLDASM, TransitionZone.SLDPRT, bodyCover.SLDPRT, m5 x 12 hex button hd.STEP]
2024-09-30 Added electronics plate
    [DummyCansat.SLDPRT, electronicsBay.SLDPRT]
2024-09-30 Added Electronics bayV2 and models of most electronics
    [AHT15- Temperature and humidity sensor.SLDPRT, Antenna assy.SLDASM, Antenna base.SLDPRT, Antenna top.SLDPRT, BMP581.SLDASM, BMP581.step, Battery 18650.stp, BharatPi.SLDPRT]
2024-09-30 Added Electronics bay V2 to Pinaka V2 Assly
    [electronicsBay.SLDPRT]
2024-09-30 Final Tweaks 2
    [BottomPlate.SLDPRT, bodyCover.SLDPRT, bottomRod.SLDPRT, electronics bay v3.SLDPRT, electronics casing v2.SLDPRT, launch stand.SLDASM, railRod.stp, railnew1.SLDPRT]
2024-09-30 final tweaks 3
    [electronics bay v3.SLDPRT]
2024-09-30 Final tweaks (image capturing for PDR)
    [BottomPlate.SLDPRT, CansatCover.SLDPRT, CenteringPlate.SLDPRT, DummyCansat.SLDPRT, Fin.SLDPRT, Flaps.SLDPRT, Parachute.SLDDRW, ThrustPlate.SLDPRT]
2024-10-03 Project Phase 1 Over
    [Electronics bay V2.step, Fin.stp, FlapR.SLDPRT, Flex.SLDPRT, MotorCover.SLDPRT, PinakaFEA.STEP, electronics bay.SLDPRT, electronics bay.step]
2024-10-30 ECSS Standards added
    [Astrium-Example-Joint Design.xls]
2024-10-30 Added index of ECSS handbooks
    [1 Index.xlsx]
2024-10-30 Reorganized the file system
    [1 Index.xlsx, 50frontRod.SLDPRT, 80frontRod Bottom.SLDPRT, 80frontRod.SLDPRT, AHT15- Temperature and humidity sensor.SLDPRT, Aerotech H148 Motor Case.SLDPRT, Aerotech H148 Nozzle Cap.SLDPRT, Aerotech H148 Nozzle.SLDPRT]
2024-10-31 Amended Commit
    [CansatCover.SLDPRT, DummyCansat.SLDPRT, Fin.SLDPRT, MainString.SLDPRT, String.SLDPRT, Top Mechanism.SLDASM, TransitionMechanism.SLDASM, TransitionZone.SLDPRT]
2024-10-31 created new version
    [AHT15- Temperature and humidity sensor.SLDPRT, Antenna assy.SLDASM, Antenna base.SLDPRT, Antenna top.SLDPRT, AvionicCover.SLDPRT, BMP581.SLDASM, BMP581.step, Battery 18650.stp]
2024-11-01 Created BOM
    [BOM.xls, BOM.xlsx, Eye bolt 6mm.SLDPRT, Rod.SLDPRT]
2024-11-01 Created V4
    Optimised the assly file and some part files in V3 and saved them as V4
    [AHT15- Temperature and humidity sensor.SLDPRT, Aerotech H148 Motor Case.SLDPRT, Aerotech H148 Nozzle.SLDPRT, Antenna assy.SLDASM, Antenna base.SLDPRT, Antenna top.SLDPRT, Assemblage Aerotech H148.SLDASM, BMP581.SLDASM]
2024-11-01 some changes
    [CansatCover.SLDPRT, PinakaFEA.SLDASM, bodyCover.SLDPRT, parachuteCover.SLDPRT]
2024-11-02 Some changes in the assly V4
    [Body Tube.SLDASM, CenteringPlate.SLDPRT, DummyCansat.SLDPRT, Electronics bay.SLDPRT, Eye bolt 6mm.SLDPRT, M4 socket button head screw_iso.SLDPRT, MG90 Servo.SLDASM, Nose Cone.SLDASM]
2024-11-02 Added Pinaka Logo sticker and corrected electronics bay alignment'
    [CansatCover.SLDPRT, Electronics Tray.SLDPRT, Nose Cone.SLDASM, Transition Tube.SLDASM]
2024-11-04 Reorganized and combines the folders for standards, handbooks, and datasheets
    [1 Index.xlsx, Astrium-Example-Joint Design.xls]
2024-11-05 added LOGOs files and updated the decals on Assly V4
    [CansatCover.SLDPRT, CenteringPlate.STL, Nose Cone.SLDASM, Paylaod bay door.SLDPRT, Payload Bay bulk head.STL, Payload Bay.STL, Payload bay door.STL, Recovery Bay Door.STL]
2024-11-19 Added FEA
    [CansatCover.IGS, Nose Cone.IGS, Nose Cone.SLDASM, bodyCover.IGS]
2024-11-19 my changes
    [Copy_of_MotorDataPrepared.xlsx, MotorDataPrepared.xlsx, PinakaFEA.SLDASM, PinakaV3.IGS, Rod.SLDPRT, Top Mechanism.SLDASM, TransitionMechanism.SLDASM, TransitionZone.SLDPRT]
2024-11-28 Categorised the model
    [AHT15- Temperature and humidity sensor.SLDPRT, Aerotech H148 Motor Case.SLDPRT, Aerotech H148 Nozzle.SLDPRT, Antenna assy.SLDASM, Antenna base.SLDPRT, Antenna top.SLDPRT, Assemblage Aerotech H148.SLDASM, AvionicCover.SLDPRT]
2024-11-29 created nose cone with toothed edge
    [CansatCover.SLDPRT, ST-AHT15- Temperature and humidity sensor.SLDPRT, ST-Aerotech H148 Motor Case.SLDPRT, ST-Aerotech H148 Nozzle.SLDPRT, ST-Antenna assy.SLDASM, ST-Antenna base.SLDPRT, ST-Antenna top.SLDPRT, ST-Assemblage Aerotech H148.SLDASM]
2024-12-04 Created V5 with configurable major dimensions
    [AHT15- Temperature and humidity sensor.SLDPRT, Aerotech H148 Motor Case.SLDPRT, Aerotech H148 Nozzle.SLDPRT, Antenna assy.SLDASM, Antenna base.SLDPRT, Antenna top.SLDPRT, Assemblage Aerotech H148.SLDASM, BMP581.SLDASM]
2024-12-19 changes to v5
    changed electronics locking bolting, removed fillets from fins, added weld beads instead (just for visual representation and mass calculations of loctite hysol fillet, created tools like fillet tool, jig for fins mounting
    [Body Assembly.SLDASM, BodyTube.SLDPRT, Bottom Parachute Plate Assembly.SLDASM, Bottom Parachute Plate.SLDPRT, Centering Ring.SLDPRT, Electronics Bay Assembly.SLDASM, Electronics Bay Cover.SLDPRT, Electronics Mount.SLDPRT]
2024-12-19 reduced parachute bay length to 300 mm
    [Body Assembly.SLDASM, BodyTube.SLDPRT, Parachute Bay Cover.SLDPRT]
2024-12-19 REMOVED NON ESSENTIAL HOLES FROM TRANSITION CONE
    [Body Assembly.SLDASM, BodyTube.SLDPRT, Payload Assembly.SLDASM, Payload Body.SLDPRT, Tansition Cone.SLDPRT]
2024-12-22 created drawings of major subassemblies, changed body tube to 120mm od, increased length of transition cone
    [AHT15- Temperature and humidity sensor.SLDPRT, AHT15.SLDPRT, Assemblage Aerotech H148.SLDASM, Battery 18650 +holder.SLDASM, Body Assembly.SLDASM, BodyTube.SLDPRT, Bottom Parachute Plate Assembly.SLDASM, Bottom Parachute Plate.SLDPRT]
2024-12-22 added CFD and FEA files
    [Drogue.IGS, Drogue.SLDPRT, DrogueFlat.SLDPRT, Fin.SLDPRT, Flat Drogue.SLDDRW, Flat Drogue.SLDPRT, Forces_and_moments_1.csv, Main.IGS]
2024-12-22 Removed v4
    [AHT15- Temperature and humidity sensor.SLDPRT, Aerotech H148 Motor Case.SLDPRT, Aerotech H148 Nozzle.SLDPRT, Antenna assy.SLDASM, Antenna base.SLDPRT, Antenna top.SLDPRT, Assemblage Aerotech H148.SLDASM, BMP581.SLDASM]
2024-12-22 created igs
    [Body Assembly.SLDASM, Payload Assembly.SLDASM]
2024-12-22 added section view to GA
    [Body Assembly.SLDASM, Bottom Parachute Plate Assembly.SLDASM, Payload Assembly.SLDASM, Real Time Clock.SLDASM, Top Parachute Plate Assembly.SLDASM]
2024-12-24 added stl for tools and jigs
    [Jig - Fin mounting.STL, R-16 Fillet Tool.STL, R-18 Fillet Tool.STL]
2024-12-27 created simulation folder in v5
    [Body Assembly.SLDASM, Nose Cone Cover R1.SLDPRT, Nose Cone.SLDPRT, Payload Assembly.SLDASM, Payload Body-Surface-Flatten2.SLDDRW, Payload Body-Surface-Flatten2.SLDPRT, Payload Body.SLDPRT, Payload Cover.SLDPRT]
2024-12-27 Cansat added
    [BottomPlate.SLDPRT, CameraPlate.SLDPRT, Cansat.SLDASM, HingeFlap.SLDPRT, M2_Eyebolt.stp, MainString.SLDPRT, Mid Plate.SLDPRT, PCBPlate.SLDPRT]
2024-12-27 simulation done, solved alignment issue in payload cover
    [Body Assembly.SLDASM, BodyTube.STEP, CSK.SLDPRT, Payload Assembly.SLDASM, Payload Body.SLDPRT, Simulation.SLDASM, Simulation.STEP, Tansition Cone.SLDPRT]
2024-12-27 top hole size changed
    [Cansat.SLDASM, ParachuteCap.SLDPRT]
2024-12-28 Some trimmings
    [BottomPlate.SLDPRT, CameraPlate.SLDPRT, Cansat.SLDASM, Cansat.STEP, MechanicalPlate.SLDPRT, rod.SLDPRT]
2024-12-28 Final 28 Dec
    [Body Assembly.SLDASM, Nose Cone Cover R1.SLDPRT, Nose Cone with payload body.SLDPRT, Nose Cone.SLDPRT, Payload Assembly.SLDASM, Payload Body.SLDPRT, Payload Cover.SLDPRT, Tansition Cone.SLDPRT]
2024-12-29 Thrust Plate FEA
    [Bottom Parachute Plate Assembly.IGS, Bottom Parachute Plate Assembly.SLDASM, Bottom Parachute Plate.SLDPRT, Cansat.IGS, Cansat.SLDASM, CansatCover.IGS, Hex nut M6 H5.2.SLDPRT, M6 26mm Shank.SLDPRT]
2024-12-30 Removed FEA Files
    [Body Assembly.SLDASM, Bottom Parachute Plate Assembly V2 - M8.IGS, Bottom Parachute Plate Assembly V2.IGS, Bottom Parachute Plate Assembly.SLDASM, Bottom Parachute Plate.SLDPRT, CansatCover.IGS, Eye bolt 6mm.SLDPRT, Hex M8 H6.4.SLDPRT]
2024-12-30 resolved problems with assembly, added nose cone with body
    [Body Assembly.SLDASM, BodyTube.SLDPRT, Bottom Parachute Plate Assembly.SLDASM, Bottom Parachute Plate.SLDPRT, Payload Assembly.SLDASM, Thrust Plate.SLDPRT]
2024-12-31 Nose Cone added
    [Body Assembly.SLDASM, Bottom Parachute Plate Assembly.SLDASM, Bottom Parachute Plate.SLDPRT, Nose Cone with payload body.SLDPRT, NoseCone.SLDPRT, NoseConeAssembly.SLDASM, NosePlate.SLDPRT, Parachute Plate v3.IGS]
2024-12-31 chamfer added
    [NoseConeAssembly.SLDASM]
2024-12-31 created locking slot in nose cone files
    [NoseCone.SLDPRT, NoseConeAssembly.SLDASM, NosePlate.SLDPRT, PayloadCover.SLDPRT]
2024-12-31 only one portion added
    [NoseCone.SLDPRT, NoseConeAssembly.SLDASM, NoseConeCover.SLDPRT, NosePlate.SLDPRT, Part1.SLDPRT, Payload Assembly.SLDASM, PayloadCover.SLDPRT, Tansition Cone.SLDPRT]
2025-01-01 fixed locking lugs in cansat ejection mechanism
    [NoseCone.SLDPRT, NoseConeAssembly.SLDASM, NoseConeCover.SLDPRT, NosePlate.SLDPRT, Payload Assembly.SLDASM, Tansition Cone.SLDPRT]
2025-01-01 CHECKS DONE
    [M2 Head Hex.SLDPRT, M4 10MM.SLDPRT, Nose Cone V2.IGS, NoseCone.SLDPRT, NoseConeAssembly.SLDASM, NoseConeCover.SLDPRT, NosePlate.SLDPRT, Payload Assembly.SLDASM]
2025-01-01 removed interferences in cansat door locking lugs
    [NoseConeAssembly.SLDASM, NoseConeCover.SLDPRT, NosePlate.SLDPRT, Tansition Cone.SLDPRT]
2025-01-02 parachute bay locking lug
    [Body Assembly.SLDASM, Nose Cone Cover R1.SLDPRT, Nose Cone Cover.SLDPRT, Nose Cone with payload body.SLDPRT, Nose Cone.SLDPRT, NoseCone.SLDPRT, NoseConeAssembly.SLDASM, NoseConeAssemblyV2.IGS]
2025-01-02 Repaired all equations in all files, and created locking lugs in
    [Body Assembly.SLDASM, BodyTube.SLDPRT, Bottom Parachute Plate Assembly.SLDASM, Bottom Parachute Plate.SLDPRT, Centering Ring.SLDPRT, Electronics Bay Cover.SLDPRT, Electronics Mount.SLDPRT, Fin.SLDPRT]
2025-01-04 Added material datasheet for iso bolts and increased electronics bay pitch dist.
    [18650 Li Ion Battery.SLDPRT, 18650_LI-ON_Battery_Holder_1042P.SLDASM, 18650_LI-ON_Battery_Holder_1042P_Base.SLDPRT, 18650_LI-ON_Battery_Holder_1042P_Leaf_Spring_Contact.SLDPRT, 18650_LI-ON_Battery_Holder_1042P_Polarized_Contact.SLDPRT, Electronics Bay Cover.SLDPRT, Electronics Mount.SLDPRT]
2025-01-04 Test added
    [Body AssemblyFEA.STEP]
2025-01-05 changed the electronics bay
    [10-Pin Header - Female - 2.54mm.step, 11-Pin Header - Female - 2.54mm.step, 12-Pin Header - Female - 2.54mm.step, 13-Pin Header - Female - 2.54mm.step, 14-Pin Header - Female - 2.54mm.step, 15-Pin Header - Female - 2.54mm.step, 16-Pin Header - Female - 2.54mm.step, 17-Pin Header - Female - 2.54mm.step]
2025-01-08 FEA updates added
    [Body Assembly.SLDASM, Body Assembly.STEP, BodyTube.SLDPRT, Bottom Parachute Plate.SLDPRT, BottomPlate.SLDPRT, CameraPlate.SLDPRT, Cansat.IGS, Cansat.SLDASM]
2025-01-08 added parachute locking motors
    [BodyTube.SLDPRT, Bottom Parachute Plate Assembly.SLDASM, Bottom Parachute Plate.SLDPRT, Centering Ring.SLDPRT, Cylindre001_1.step.SLDPRT, Cylindre002_1.step.SLDPRT, Cylindre_1.step.SLDPRT, Electronics Bay Cover.SLDPRT]
2025-01-09 Added Cansat Bay
    [ArduCam.SLDPRT, Battery Holder ASSY V2.stp, BottomPlate.SLDPRT, CameraPlate.SLDPRT, Cansat.SLDASM, Electronics.DXF, Electronics.SLDPRT, ElectronicsPlate.DXF]
2025-01-09 cansat fea added
    [Bidirectional shoulder.STEP, BottomPlate.SLDPRT, CameraPlate.SLDPRT, Cansat Flap.STL, M2_Eyebolt.stp, M4 3.2 Hex nut.SLDPRT, MechanicalPlate (2).SLDPRT, MechanicalPlate.SLDPRT]
2025-01-09 cansat modifications
    [Bottom Parachute Plate Assembly.SLDASM, BottomPlate.SLDPRT, CameraPlate.SLDPRT, Hinge Pin.SLDPRT, HingeFlap.SLDPRT, HingeNut.SLDPRT, M4 10MM HEX SOCKET BUTTON HEAD.SLDPRT, M4 10MM.SLDPRT]
2025-01-10 cansat weight reduction
    [Bottom Parachute Plate Assembly.SLDASM, BottomPlate.SLDPRT, CameraPlate.SLDPRT, Mechanical Plate.SLDPRT, Parachute Bay V2.SLDPRT, Parachute Cover.SLDPRT, Parachute Plate V2.SLDPRT, Top Parachute Plate Assembly.SLDASM]
2025-01-10 cansat modification
    [Body Cover.SLDPRT, BottomPlate.SLDPRT, BottomPlate.STEP, BottomPlate.STL, CameraPlate.SLDPRT, CameraPlate.STEP, CameraPlate.STL, Cansat_Simu.SLDASM]
2025-01-10 added mass values to openrocket v3
    [Bottom Parachute Plate Assembly.SLDASM, Bottom Parachute Plate.SLDPRT]
2025-01-10 changed material from peek to petg, added model for perf board
    [BodyTube.SLDPRT, Bottom Parachute Plate.SLDPRT, Centering Ring.SLDPRT, Electronics Bay Cover.SLDPRT, Electronics Mount.SLDPRT, M4 10MM HEX SOCKET BUTTON HEAD.SLDPRT, M5 12MM HEX SOCKET BUTTON HEAD.SLDPRT, NoseCone.SLDPRT]
2025-01-11 changed appearance of the cansat and rocket, created drawings
    [18650 Battery_1.SLDPRT, 18650_LI-ON_Battery_Holder_1042P.SLDASM, 18650_LI-ON_Battery_Holder_1042P_Base.SLDPRT, Assemblage Aerotech H148.SLDASM, Battery Holder ASSY V2.SLDASM, Battery Holder.SLDPRT, Bottom Parachute Plate Assembly.SLDASM, Bottom Parachute Plate.SLDPRT]
2025-01-11 corrected payload bay cover
    [Bottom Parachute Plate Assembly.SLDASM, NoseCone.SLDPRT, NoseConeCover.SLDPRT, Payload Assembly.SLDASM, PayloadCover.SLDPRT, Top Parachute Plate Assembly.SLDASM]
2025-01-11 corrected motor issue in parachute bay
    [Bottom Parachute Plate Assembly.SLDASM, Top Parachute Plate Assembly.SLDASM]
2025-01-11 BODY ASSEMBLY DRAWING
    [Payload Body-Surface-Flatten2.SLDDRW, Top Parachute Plate Assembly.SLDASM]
2025-01-11 Corrected drawings for body tube and made drawings for electronics bay
    [18650_LI-ON_Battery_Holder_1042P.SLDASM, NoseCone.SLDPRT, NoseConeCover.SLDPRT, NosePlate.SLDPRT, Payload Assembly.SLDASM, Payload Assembly.SLDDRW]
2025-01-11 CREATED MORE DRAWINGS
    [BodyTube.SLDPRT, Bottom Parachute Plate Assembly.SLDASM, Bottom Parachute Plate.SLDPRT, Centering Ring.SLDPRT, Electronics Bay Cover.SLDPRT, Electronics Mount.SLDPRT, Fin.SLDDRW, NoseCone.SLDPRT]
2025-01-11 created more drawings and corrected open rocket weights
    [Assemblage Aerotech H148.SLDASM, BodyTube.SLDPRT, Bottom Parachute Plate Assembly.SLDASM, Hex nut M6 H5.2.SLDPRT, M6 15mm Shank.SLDPRT, M6 26mm Shank.SLDPRT, Top Parachute Plate Assembly.SLDASM, Top Parachute Plate Assembly.SLDDRW]
2025-01-12 cansat drawing
    [Bottom Parachute Plate.STL, BottomPlate.SLDPRT, Camera Plate Assembly.SLDASM, CameraPlate.SLDPRT, Parachute Bay Assembly.SLDASM, Parachute Bay Assembly.SLDDRW, Payload Assembly.SLDASM, Stud Spacer.SLDPRT]
2025-01-15 added electronics visuals
    [AHT15.SLDPRT, Bharat Pi.SLDPRT, DD0503MA Ultra Mini Buck Converter.SLDASM, PCBPlate.SLDPRT, Real Time Clock.SLDASM, Top Parachute Plate Assembly.SLDASM, VoltageSensor.SLDPRT, bmp-581.SLDASM]
2025-01-16 added gtlf
    [BodyTube.SLDPRT, Bottom Parachute Plate Assembly.SLDASM, Bottom Parachute Plate.SLDPRT, Centering Ring.SLDPRT, Electronics Bay Cover.SLDPRT, Electronics Mount.SLDPRT, Fin.SLDDRW, M6 15mm Shank.SLDPRT]
2025-01-30 final changes
    [BodyTube.SLDPRT, Bottom Parachute Plate Assembly.SLDASM, Bottom Parachute Plate.SLDPRT, BottomPlate.SLDPRT, CameraPlate.SLDPRT, Centering Ring.SLDPRT, Dummy_Transition Cone.SLDPRT, Dummy_Transition Cone.STL]
2025-02-16 lil changes
    [10cmPCB.SLDPRT, 80frontRod Bottom.SLDPRT, Fin.SLDPRT, Fin.STL, Forces_and_moments_1.csv, NoseCone - Copy.SLDPRT, NoseCone.SLDPRT, NoseConeCylinder.STL]
2025-05-03 Replaced with thrust tech motor
    [Avionics Guide.SLDPRT, Avionics Guide.STL, BodyTube-Surface-Flatten2.SLDDRW, BodyTube-Surface-Flatten2.SLDPRT, Electronics Bay Cover.STL, Electronics Mount - 1.STL, Electronics Mount 2.STL, Electronics Mount.STL]
2025-05-04 thrusttech motor applied
    [BodyTube.SLDPRT, Bottom Parachute Plate Assembly.SLDASM, Bottom Parachute Plate.SLDPRT, Casing.SLDPRT, Centering Ring.SLDPRT, Electronics Bay Cover.SLDPRT, Electronics Mount.SLDPRT, End Cap.SLDPRT]
